faragamco-eng/Multiact/hardware/netlist.md

> ⚠️ **نسخه ۱ (six-step، تک‌شنت) — جایگزین شده با [`hardware/v2`](v2/README.md).**

# نت‌لیست متنی (شماتیک) — BLDC-310

> این فایل شماتیک را به‌صورت متنی و برگه‌به‌برگه توصیف می‌کند تا در KiCad/Altium رسم شود.
> شماره‌پین‌های STM32G431CBT6 (LQFP48) از دیتابیس رسمی ST (`STM32_open_pin_data`) استخراج شده‌اند.
> شماره‌پین‌های IPM عمداً با **نام سیگنال** آمده‌اند. پین‌اوت پکیج SDIP2B-26L را از دیتاشیت همان
> پارت‌نامبری که می‌خرید بردارید (نسخه‌های مختلف SLLIMM/CIPOS پین‌اوت متفاوت دارند).

⚠️ **کل مدار (از جمله MCU) به برق شهر متصل است (Hot ground).** تنها مرز ایزوله، ایزولاتور UART (U9) است.

## قراردادها

| Net | توضیح |
|---|---|
| `AC_L`, `AC_N`, `PE` | ورودی برق شهر |
| `VBUS` | باس DC (حدود 310 V)، بعد از NTC/رله |
| `PGND` | منفی پل دیود و خازن‌های باس (زمین قدرت) |
| `ISH` | امیترهای باز IPM (NU, NV, NW) — بالای شنت |
| `GND` | زمین سیگنال؛ **فقط در یک نقطه** (پد منفی شنت، اتصال Kelvin) به `PGND` وصل می‌شود |
| `+15V`, `+3V3`, `+3V3A` | تغذیه‌ها (همه نسبت به `GND`، یعنی Hot) |
| `ISO_*` | سمت ایزوله ایزولاتور (SELV) |

---

## برگه 1 — ورودی AC، فیلتر EMI، یکسوساز، باس DC

| Ref | Part | Pins → Net | Note |
|---|---|---|---|
| J1 | ترمینال 3 پین 10 A، گام 7.5 mm | 1 `AC_L`, 2 `AC_N`, 3 `PE` | |
| F1 | فیوز 10 A T (Time-lag) 5×20 + هولدر | `AC_L` → `AC_L1` | |
| RV1 | MOV S14K275 | `AC_L1` – `AC_N` | محافظت سرج |
| CX1 | 0.47 µF X2 310 VAC | `AC_L1` – `AC_N` | |
| R1,R2 | 470 k 1206 (سری) | موازی CX1 | تخلیه X-cap (الزام ایمنی) |
| L1 | چوک CM 2×6.8 mH ≥ 8 A | 1-2: `AC_L1`→`AC_LF`, 3-4: `AC_N`→`AC_NF` | |
| CX2 | 0.47 µF X2 | `AC_LF` – `AC_NF` | |
| CY1, CY2 | 2.2 nF Y2 | `AC_LF`–`PE`, `AC_NF`–`PE` | اتصال به بدنه/هیت‌سینک ارت‌شده |
| BR1 | GBU1006 (10 A, 600 V) | ~ `AC_LF`, ~ `AC_NF`, + `DC_RAW`, − `PGND` | روی هیت‌سینک مشترک |
| NTC1 | NTC 5 Ω (مثلاً EPCOS B57364S0509M) | `DC_RAW` – `VBUS` | محدودکننده جریان هجومی؛ برای ~1000 µF در 264 VAC |
| K1 | رله 16 A/250 VAC، کویل 12 V | کنتاکت: `DC_RAW` – `VBUS` (موازی NTC1)؛ کویل: `K1_A`=`+15V` از طریق R3، `K1_B` → Q1 drain | بای‌پس NTC بعد از شارژ باس |
| R3 | 100 Ω 0.5 W | `+15V` – `K1_A` | افت 3 V برای کویل 12 V (30 mA) |
| D1 | 1N4148W | آند `K1_B`، کاتد `K1_A` | دیود هرزگرد کویل |
| Q1 | 2N7002 | G `RELAY_EN`، D `K1_B`، S `GND` | |
| R4 | 100 k | `RELAY_EN` – `GND` | رله خاموش هنگام ریست |
| C1, C2 | 470 µF 450 V 105 °C snap-in (ripple ≥ 3.6 A @100 Hz) | `VBUS` – `PGND` | |
| C3 | 1 µF 630 V فیلم (MKP) | `VBUS` – `PGND` | کنار IPM |
| C4 | 100 nF 630 V فیلم | پین P و N سمت IPM | **کوتاه‌ترین حلقه ممکن** |
| R5, R6 + LED_HV | 100 k 1 W + 100 k 1 W + LED قرمز high-efficiency (سری) | `VBUS` – R5 – R6 – LED – `PGND` | بلیدر + نشانگر «ولتاژ خطرناک» (≈1.6 mA)؛ تا زیر 60 V حدود 6 دقیقه. تا خاموش‌شدن LED برد را لمس نکنید |

## برگه 2 — منبع تغذیه کمکی (غیرایزوله)

| Ref | Part | Pins → Net | Note |
|---|---|---|---|
| RF1 | 10 Ω 1 W flame-proof (fusible) | `VBUS` – `AUX_IN` | |
| CF1, CF2 | 4.7 µF 400 V الکترولیت | `AUX_IN`–`PGND`، `AUX_F`–`PGND` | فیلتر π |
| LF1 | 1 mH 0.3 A | `AUX_IN` – `AUX_F` | |
| U2 | LNK306DN (LinkSwitch-TN، باک) | D `AUX_F`، S `SW`، BP → C5، FB ← تقسیم‌کننده | طبق دیتاشیت/DI برای 15 V، 200 mA |
| C5 | 100 nF | BP – S | |
| D2 | UF1005 (یا ES1J، فوق سریع) | آند `GND`، کاتد `SW` | دیود هرزگرد باک |
| L2 | 1 mH، ≥ 0.4 A | `SW` – `+15V` | |
| R7/R8 | 16.5 k / 2.05 k | `+15V` → FB → `SW` | V_FB = 1.65 V → ≈ 15 V (با DI مرجع PI چک شود) |
| C6 | 100 µF 25 V + 1 µF | `+15V` – `GND` | |
| D3 | SMBJ18A | `+15V` – `GND` | حفاظت اضافه‌ولتاژ |
| R9 | 3.3 k | `+15V` – `GND` | بار حداقل (پایداری LNK در بی‌باری) |
| U3 | باک 3.3 V، مثلاً TPS560430X3F (ورودی 36 V) | VIN `+15V`، SW → L3، FB/OUT `+3V3` | یا LDO با مقاومت سری؛ تلفات LDO مستقیم 0.6 W است |
| L3 | 10 µH 1 A | | |
| C7, C8 | 10 µF + 100 nF | `+3V3` – `GND` | |
| FB1 + C9 | فریت 600 Ω + 1 µF + 100 nF | `+3V3` → `+3V3A` | تغذیه آنالوگ/VREF |

> **نکته مهم:** زمین خروجی منبع کمکی (`GND`) همان زمین Hot است. MCU و IPM به یک زمین مشترک ارجاع دارند و این برای درایو مستقیم (بدون ایزولاتور گیت) ضروری است.

## برگه 3 — طبقه قدرت (IPM)

| Ref | Part | توضیح |
|---|---|---|
| U1 | STGIB15CH60TS-L (SLLIMM 2nd, 600 V / 15 A, SDIP2B-26L) یا هم‌کلاس (IKCM15L60GD، FNB41560) | اینترلاک داخلی، دیود بوت‌استرپ داخلی، Smart shutdown، UVLO |

| پین IPM (نام) | Net | قطعات جانبی |
|---|---|---|
| P | `VBUS` | C4 در فاصله < 10 mm |
| U, V, W | `MOT_U`, `MOT_V`, `MOT_W` → J4 (ترمینال موتور 3 پین + PE) | |
| NU, NV, NW | `ISH` | سه امیتر با ترک پهن به یک نقطه |
| VCC | `+15V` | C10 = 10 µF + C11 = 100 nF نزدیک پین |
| GND (سیگنال) | `GND` | |
| VBOOTU–OUTU | C12 = 4.7 µF X7R 25 V ∥ 100 nF | (همچنین برای V و W: C13, C14) |
| HINU / HINV / HINW | از `PWM_UH`/`PWM_VH`/`PWM_WH` از طریق R 100 Ω | R_pd 10 k به `GND` سمت IPM |
| LINU / LINV / LINW | از `PWM_UL`/`PWM_VL`/`PWM_WL` از طریق R 100 Ω | R_pd 10 k به `GND` (**اگر LIN در دیتاشیت active-low است: pull-up 10 k به 3V3 و `IPM_LIN_ACTIVE_LOW=1` در فریمور**) |
| SD/OD (Fault/Shutdown) | `IPM_FAULT` | R 10 k pull-up به `+3V3`، C 1 nF به `GND` (زمان smart-shutdown طبق دیتاشیت) |
| CIN | `CIN` | R 1 k از `ISH` + C 1 nF به `GND` (τ ≈ 1 µs) |
| T/NTC داخلی (اگر دارد) | DNP یا موازی با NTC هیت‌سینک | |
| OP+, OP−, OPOUT (op-amp داخلی) | OP+ → `GND`، OP− → OPOUT | استفاده نمی‌شود (PGA داخلی STM32 کافی است) |

**شنت:**

| Ref | Part | Pins → Net |
|---|---|---|
| RS1, RS2 | 68 mΩ 2 W 2512 1 % (موازی = 33 mΩ) | `ISH` – `PGND` |
| — | نقطه ستاره | پد منفی شنت = تنها اتصال `GND`↔`PGND` |
| R10 + C15 | 100 Ω + 1 nF C0G | `ISH` (Kelvin) → `ISENSE` → `GND` |
| D4 | BAT54S | `ISENSE` به `+3V3A`/`GND` (کلمپ) |

## برگه 4 — تقسیم‌کننده‌های ولتاژ (VBUS و BEMF)

چهار شاخه **کاملاً یکسان** (نسبت 133.0). هر شاخه:

| Ref | مقدار | اتصال |
|---|---|---|
| Rx_a, Rx_b, Rx_c | 330 k 1 % 1206 (سری، برای ولتاژ کاری و فاصله خزشی) | ورودی HV → `xxx_DIV` |
| Rx_d | 7.5 k 0.1 % 0805 | `xxx_DIV` → `GND` |
| Cx | 220 pF C0G | `xxx_DIV` → `GND` (τ ≈ 1.6 µs) |
| Dx | BAT54S (یک پکیج برای هر دو کانال) | کلمپ به `+3V3A`/`GND` |

| شاخه | ورودی HV | خروجی → پین MCU |
|---|---|---|
| VBUS | `VBUS` | `VBUS_DIV` → PA3 (پین 11) |
| BEMF U | `MOT_U` | `BEMF_U` → PA0 (پین 8) |
| BEMF V | `MOT_V` | `BEMF_V` → PA1 (پین 9) |
| BEMF W | `MOT_W` | `BEMF_W` → PA2 (پین 10) |

**دما و پتانسیومتر:**

| Ref | Part | اتصال |
|---|---|---|
| RT1 | NTC 10 k B3435 (پیچی، روی هیت‌سینک کنار IPM) | `NTC` – `GND` |
| R11 | 10 k 1 % | `+3V3A` – `NTC`؛ C 100 nF به `GND` → PA6 (پین 14) |
| RV2 | پتانسیومتر 10 k **با محور پلاستیکی/عایق** | `+3V3A` / `GND` / سر وسط `POT` + 100 nF → PA5 (پین 13) |

## برگه 5 — میکروکنترلر STM32G431CBT6

| پین | نام | Net | توضیح |
|---|---|---|---|
| 1 | VBAT | `+3V3` | |
| 2 | PC13 | — | آزاد |
| 3, 4 | PC14/PC15 | — | آزاد |
| 5, 6 | PF0/PF1 | — | (اختیاری کریستال 8 MHz، فریمور از HSI استفاده می‌کند) |
| 7 | NRST | `NRST` | 100 nF به GND + پین SWD |
| 8 | PA0 | `BEMF_U` | ADC1_IN1 |
| 9 | PA1 | `BEMF_V` | ADC1_IN2 |
| 10 | PA2 | `BEMF_W` | ADC1_IN3 |
| 11 | PA3 | `VBUS_DIV` | ADC1_IN4 |
| 12 | PA4 | — | آزاد (DAC1_OUT1 برای دیباگ) |
| 13 | PA5 | `POT` | ADC2_IN13 |
| 14 | PA6 | `NTC` | ADC2_IN3 |
| 15 | PA7 | `ISENSE` | OPAMP2_VINP0 و COMP2_INP (هر دو داخلی) |
| 16–18 | PB0–PB2 | — | آزاد |
| 19 | VSSA | `GND` | |
| 20 | VREF+ | `+3V3A` | 1 µF + 100 nF |
| 21 | VDDA | `+3V3A` | 1 µF + 100 nF |
| 22 | PB10 | `RELAY_EN` | GPIO |
| 23 | VSS | `GND` | |
| 24 | VDD | `+3V3` | 100 nF |
| 25 | PB11 | `BTN_START` | GPIO با pull-up داخلی؛ دکمه به GND (کلید با کلاهک عایق) |
| 26 | PB12 | `IPM_FAULT` | TIM1_BKIN (AF6)، از طریق 100 Ω |
| 27 | PB13 | `PWM_UL` | TIM1_CH1N (AF6) |
| 28 | PB14 | `PWM_VL` | TIM1_CH2N (AF6) |
| 29 | PB15 | `PWM_WL` | TIM1_CH3N (**AF4**) |
| 30 | PA8 | `PWM_UH` | TIM1_CH1 (AF6) |
| 31 | PA9 | `PWM_VH` | TIM1_CH2 (AF6) |
| 32 | PA10 | `PWM_WH` | TIM1_CH3 (AF6) |
| 33, 34 | PA11/PA12 | — | آزاد |
| 35 | VSS | `GND` | |
| 36 | VDD | `+3V3` | 100 nF |
| 37 | PA13 | `SWDIO` | |
| 38 | PA14 | `SWCLK` | |
| 39 | PA15 | — | |
| 40 | PB3 | `SWO` | اختیاری |
| 41 | PB4 | `LED_RUN` | 1 k → LED سبز → GND |
| 42 | PB5 | `LED_FAULT` | 1 k → LED قرمز → GND |
| 43 | PB6 | `UART_TX` | USART1_TX (AF7) → U9 |
| 44 | PB7 | `UART_RX` | USART1_RX (AF7) ← U9 |
| 45 | PB8-BOOT0 | `BOOT0` | 10 k به GND |
| 46 | PB9 | — | |
| 47 | VSS | `GND` | |
| 48 | VDD | `+3V3` | 4.7 µF + 100 nF |

هر شش خط گیت: سری 100 Ω نزدیک MCU، pull-down 10 k نزدیک IPM (تا در ریست/بوت IPM خاموش بماند).

## برگه 6 — رابط ایزوله و دیباگ

| Ref | Part | اتصال | توضیح |
|---|---|---|---|
| U9 | ISO7721 (یا ADuM1201) — 2 کانال، 1 رفت/1 برگشت، ایزولاسیون تقویت‌شده | سمت 1: VCC1 `+3V3`، GND1 `GND`، INA ← `UART_TX`، OUTB → `UART_RX`؛ سمت 2: VCC2 `ISO_VCC`، GND2 `ISO_GND`، OUTA → `ISO_TX`، INB ← `ISO_RX` | **فاصله خزشی زیر بدنه ≥ 8 mm** (اسلات در PCB) |
| J2 | هدر 4 پین | `ISO_VCC` (3.3–5 V از مبدل USB-UART)، `ISO_GND`، `ISO_TX`، `ISO_RX` | تنها کانکتور امن برای لمس |
| J3 | هدر SWD 2×5 (1.27) | `+3V3`، `SWDIO`، `SWCLK`، `SWO`، `NRST`، `GND` | **Hot!** فقط با ترانس ایزوله یا دیباگر ایزوله (ISOUSB211 / ST-LINK ایزوله) |

## برگه 7 — ترمز دینامیکی (اختیاری، DNP)

| Ref | Part | اتصال |
|---|---|---|
| Q2 | IGBT 600 V 10 A (مثلاً STGD10NC60KD) | C ← `BRAKE_R`، E → `PGND` |
| R_BR | مقاومت ترمز 100 Ω 100 W (بیرون برد) | `VBUS` – `BRAKE_R` |
| U10 | درایور low-side (مثلاً UCC27517) | ورودی از PB0 (آزاد) |

> فریمور فعلی ترمز ندارد؛ در عوض در کاهش سرعت اگر Vbus > 380 V شود کاهش دیوتی را متوقف می‌کند.
