faragamco-eng/Multiact/hardware/panel/out/drc_report.txt

** Drc report for out/kicad/cooler_panel.kicad_pcb **
** Created on 2026-11-06 15:32:54 **

** Found 145 DRC violations **
[silk_overlap]: Silkscreen overlap
    Rule: board setup constraints silk; Severity: warning
    @(87.0800 mm, 49.0000 mm): Line on F.Silkscreen
    @(103.7300 mm, 49.6400 mm): Reference 'R25'
[silk_overlap]: Silkscreen overlap
    Rule: board setup constraints silk; Severity: warning
    @(87.0800 mm, 49.0000 mm): Line on F.Silkscreen
    @(93.6700 mm, 49.5200 mm): Reference 'R21'
[silk_overlap]: Silkscreen overlap
    Rule: board setup constraints silk; Severity: warning
    @(87.0800 mm, 49.0000 mm): Line on F.Silkscreen
    @(88.4600 mm, 49.6500 mm): Reference 'R26'
[silk_overlap]: Silkscreen overlap
    Rule: board setup constraints silk; Severity: warning
    @(136.8600 mm, 83.2500 mm): Line on F.Silkscreen
    @(136.0000 mm, 84.8700 mm): Reference 'C18'
[silk_overlap]: Silkscreen overlap
    Rule: board setup constraints silk; Severity: warning
    @(136.0000 mm, 84.8700 mm): Reference 'C18'
    @(137.7000 mm, 84.0000 mm): Reference 'U6'
[silk_overlap]: Silkscreen overlap
    Rule: board setup constraints silk; Severity: warning
    @(135.1400 mm, 83.2500 mm): Line on F.Silkscreen
    @(136.0000 mm, 84.8700 mm): Reference 'C18'
[silk_overlap]: Silkscreen overlap
    Rule: board setup constraints silk; Severity: warning
    @(95.0900 mm, 52.0500 mm): Reference 'R22'
    @(93.4327 mm, 51.4725 mm): Line on F.Silkscreen
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
    @(66.4300 mm, 78.8100 mm): Reference 'C7'
[silk_over_copper]: Silkscreen clipped by solder mask
    Local override; Severity: warning
    @(136.0000 mm, 84.8700 mm): Reference 'C18'
[silk_over_copper]: Silkscreen clipped by solder mask
    Local override; Severity: warning
    @(40.3800 mm, 84.4000 mm): Reference 'C1'
[lib_footprint_issues]: The current configuration does not include the library 'Connector_USB'.
    Local override; Severity: warning
    @(70.0000 mm, 102.0000 mm): Footprint J2
[lib_footprint_issues]: The current configuration does not include the library 'Fiducial'.
    Local override; Severity: warning
    @(24.0000 mm, 66.0000 mm): Footprint FID1
[lib_footprint_issues]: The current configuration does not include the library 'Resistor_SMD'.
    Local override; Severity: warning
    @(113.3800 mm, 77.0200 mm): Footprint R40
[lib_footprint_issues]: The current configuration does not include the library 'Package_TO_SOT_SMD'.
    Local override; Severity: warning
    @(30.0000 mm, 84.0000 mm): Footprint Q1
[lib_footprint_issues]: The current configuration does not include the library 'Capacitor_SMD'.
    Local override; Severity: warning
    @(23.7700 mm, 46.7400 mm): Footprint C12
[lib_footprint_issues]: The current configuration does not include the library 'Package_TO_SOT_SMD'.
    Local override; Severity: warning
    @(64.0000 mm, 84.0000 mm): Footprint U3
[lib_footprint_issues]: The current configuration does not include the library 'Resistor_SMD'.
    Local override; Severity: warning
    @(26.2700 mm, 47.0300 mm): Footprint R13
[lib_footprint_issues]: The current configuration does not include the library 'Capacitor_SMD'.
    Local override; Severity: warning
    @(77.6200 mm, 77.1600 mm): Footprint C14
[lib_footprint_issues]: The current configuration does not include the library 'Capacitor_SMD'.
    Local override; Severity: warning
    @(36.7400 mm, 70.2400 mm): Footprint C4
[lib_footprint_issues]: The current configuration does not include the library 'TestPoint'.
    Local override; Severity: warning
    @(44.6400 mm, 64.8300 mm): Footprint TP5
[lib_footprint_issues]: The current configuration does not include the library 'Resistor_SMD'.
    Local override; Severity: warning
    @(56.4200 mm, 90.1700 mm): Footprint R12
[lib_footprint_issues]: The current configuration does not include the library 'Resistor_SMD'.
    Local override; Severity: warning
    @(36.2700 mm, 66.9300 mm): Footprint R8
[lib_footprint_issues]: The current configuration does not include the library 'Resistor_SMD'.
    Local override; Severity: warning
    @(103.7300 mm, 51.0700 mm): Footprint R25
[lib_footprint_issues]: The current configuration does not include the library 'TestPoint'.
    Local override; Severity: warning
    @(49.8700 mm, 93.4300 mm): Footprint TP4
[lib_footprint_issues]: The current configuration does not include the library 'Resistor_SMD'.
    Local override; Severity: warning
    @(84.3600 mm, 45.3400 mm): Footprint R20
[lib_footprint_issues]: The current configuration does not include the library 'Resistor_SMD'.
    Local override; Severity: warning
    @(44.1500 mm, 71.5000 mm): Footprint R7
[lib_footprint_issues]: The current configuration does not include the library 'Sensor_Humidity'.
    Local override; Severity: warning
    @(136.0000 mm, 84.0000 mm): Footprint U6
[lib_footprint_issues]: The current configuration does not include the library 'Resistor_SMD'.
    Local override; Severity: warning
    @(113.1100 mm, 74.3600 mm): Footprint R39
[lib_footprint_issues]: The current configuration does not include the library 'Resistor_SMD'.
    Local override; Severity: warning
    @(43.0600 mm, 76.7900 mm): Footprint R2
[lib_footprint_issues]: The current configuration does not include the library 'Resistor_SMD'.
    Local override; Severity: warning
    @(80.1800 mm, 80.5500 mm): Footprint R35
[lib_footprint_issues]: The current configuration does not include the library 'Resistor_SMD'.
    Local override; Severity: warning
    @(92.0700 mm, 79.7500 mm): Footprint R37
[lib_footprint_issues]: The current configuration does not include the library 'LED_SMD'.
    Local override; Severity: warning
    @(98.0000 mm, 57.0000 mm): Footprint LED2
[lib_footprint_issues]: The current configuration does not include the library 'Resistor_SMD'.
    Local override; Severity: warning
    @(73.8500 mm, 92.1700 mm): Footprint R16
[lib_footprint_issues]: The current configuration does not include the library 'Capacitor_SMD'.
    Local override; Severity: warning
    @(29.8300 mm, 75.6500 mm): Footprint C3
[lib_footprint_issues]: The current configuration does not include the library 'Package_TO_SOT_SMD'.
    Local override; Severity: warning
    @(38.0000 mm, 75.0000 mm): Footprint U1
[lib_footprint_issues]: The current configuration does not include the library 'Diode_SMD'.
    Local override; Severity: warning
    @(42.0000 mm, 91.0000 mm): Footprint BR1
[lib_footprint_issues]: The current configuration does not include the library 'Capacitor_SMD'.
    Local override; Severity: warning
    @(59.7700 mm, 85.5900 mm): Footprint C6
[lib_footprint_issues]: The current configuration does not include the library 'Resistor_SMD'.
    Local override; Severity: warning
    @(70.0300 mm, 89.6000 mm): Footprint R18
[lib_footprint_issues]: The current configuration does not include the library 'Resistor_SMD'.
    Local override; Severity: warning
    @(66.0000 mm, 64.2900 mm): Footprint R30
[lib_footprint_issues]: The current configuration does not include the library 'Package_TO_SOT_SMD'.
    Local override; Severity: warning
    @(70.0000 mm, 94.0000 mm): Footprint U5
[lib_footprint_issues]: The current configuration does not include the library 'Resistor_SMD'.
    Local override; Severity: warning
    @(99.4800 mm, 54.1400 mm): Footprint R24
[lib_footprint_issues]: The current configuration does not include the library 'Resistor_SMD'.
    Local override; Severity: warning
    @(95.0900 mm, 53.4800 mm): Footprint R22
[lib_footprint_issues]: The current configuration does not include the library 'Package_TO_SOT_SMD'.
    Local override; Severity: warning
    @(102.7300 mm, 60.8600 mm): Footprint Q6
[lib_footprint_issues]: The current configuration does not include the library 'Fiducial'.
    Local override; Severity: warning
    @(136.0000 mm, 58.0000 mm): Footprint FID2
[lib_footprint_issues]: The current configuration does not include the library 'Resistor_SMD'.
    Local override; Severity: warning
    @(35.2700 mm, 84.7600 mm): Footprint R11
[lib_footprint_issues]: The current configuration does not include the library 'TestPoint'.
    Local override; Severity: warning
    @(51.6500 mm, 64.9200 mm): Footprint TP8
[lib_footprint_issues]: The current configuration does not include the library 'TerminalBlock_Phoenix'.
    Local override; Severity: warning
    @(32.0000 mm, 100.0000 mm): Footprint J1
[lib_footprint_issues]: The current configuration does not include the library 'Resistor_SMD'.
    Local override; Severity: warning
    @(78.6100 mm, 54.7900 mm): Footprint R28
[lib_footprint_issues]: The current configuration does not include the library 'Diode_SMD'.
    Local override; Severity: warning
    @(43.6000 mm, 98.8400 mm): Footprint D1
[lib_footprint_issues]: The current configuration does not include the library 'Resistor_SMD'.
    Local override; Severity: warning
    @(70.0700 mm, 64.4900 mm): Footprint R31
[lib_footprint_issues]: The current configuration does not include the library 'LED_SMD'.
    Local override; Severity: warning
    @(114.0000 mm, 57.0000 mm): Footprint LED4
[lib_footprint_issues]: The current configuration does not include the library 'Resistor_SMD'.
    Local override; Severity: warning
    @(36.7400 mm, 78.4500 mm): Footprint R4
[lib_footprint_issues]: The current configuration does not include the library 'TestPoint'.
    Local override; Severity: warning
    @(44.4500 mm, 85.5000 mm): Footprint TP1
[lib_footprint_issues]: The current configuration does not include the library 'Button_Switch_THT'.
    Local override; Severity: warning
    @(111.5000 mm, 97.0000 mm): Footprint SW4
[lib_footprint_issues]: The current configuration does not include the library 'Resistor_SMD'.
    Local override; Severity: warning
    @(93.6700 mm, 50.9500 mm): Footprint R21
[lib_footprint_issues]: The current configuration does not include the library 'Button_Switch_THT'.
    Local override; Severity: warning
    @(66.4500 mm, 69.2100 mm): Footprint SW6
[lib_footprint_issues]: The current configuration does not include the library 'Capacitor_SMD'.
    Local override; Severity: warning
    @(80.3400 mm, 77.2100 mm): Footprint C15
[lib_footprint_issues]: The current configuration does not include the library 'LED_SMD'.
    Local override; Severity: warning
    @(90.0000 mm, 57.0000 mm): Footprint LED1
[lib_footprint_issues]: The current configuration does not include the library 'Resistor_SMD'.
    Local override; Severity: warning
    @(40.2900 mm, 82.5600 mm): Footprint R1
[lib_footprint_issues]: The current configuration does not include the library 'Resistor_SMD'.
    Local override; Severity: warning
    @(32.6200 mm, 79.1700 mm): Footprint R5
[lib_footprint_issues]: The current configuration does not include the library 'Diode_SMD'.
    Local override; Severity: warning
    @(61.2800 mm, 77.6100 mm): Footprint D2
[lib_footprint_issues]: The current configuration does not include the library 'Fiducial'.
    Local override; Severity: warning
    @(136.0000 mm, 92.0000 mm): Footprint FID3
[lib_footprint_issues]: The current configuration does not include the library 'Resistor_SMD'.
    Local override; Severity: warning
    @(60.0000 mm, 64.1800 mm): Footprint R14
[lib_footprint_issues]: The current configuration does not include the library 'TestPoint'.
    Local override; Severity: warning
    @(41.0600 mm, 67.9300 mm): Footprint TP6
[lib_footprint_issues]: The current configuration does not include the library 'Resistor_SMD'.
    Local override; Severity: warning
    @(99.2100 mm, 51.2800 mm): Footprint R23
[lib_footprint_issues]: The current configuration does not include the library 'Diode_SMD'.
    Local override; Severity: warning
    @(114.0600 mm, 67.8800 mm): Footprint D4
[lib_footprint_issues]: The current configuration does not include the library 'Capacitor_THT'.
    Local override; Severity: warning
    @(52.6700 mm, 76.3800 mm): Footprint C5
[lib_footprint_issues]: The current configuration does not include the library 'Button_Switch_THT'.
    Local override; Severity: warning
    @(90.5000 mm, 97.0000 mm): Footprint SW2
[lib_footprint_issues]: The current configuration does not include the library 'Fuse'.
    Local override; Severity: warning
    @(48.8500 mm, 100.4700 mm): Footprint F1
[lib_footprint_issues]: The current configuration does not include the library 'Inductor_SMD'.
    Local override; Severity: warning
    @(73.0000 mm, 84.0000 mm): Footprint L1
[lib_footprint_issues]: The current configuration does not include the library 'LED_SMD'.
    Local override; Severity: warning
    @(122.0000 mm, 57.0000 mm): Footprint LED5
[lib_footprint_issues]: The current configuration does not include the library 'MountingHole'.
    Local override; Severity: warning
    @(136.0000 mm, 102.0000 mm): Footprint H4
[lib_footprint_issues]: The current configuration does not include the library 'Button_Switch_THT'.
    Local override; Severity: warning
    @(101.0000 mm, 97.0000 mm): Footprint SW3
[lib_footprint_issues]: The current configuration does not include the library 'Resistor_SMD'.
    Local override; Severity: warning
    @(66.7500 mm, 88.6000 mm): Footprint R17
[lib_footprint_issues]: The current configuration does not include the library 'Package_TO_SOT_SMD'.
    Local override; Severity: warning
    @(52.0000 mm, 84.0000 mm): Footprint U2
[lib_footprint_issues]: The current configuration does not include the library 'Capacitor_SMD'.
    Local override; Severity: warning
    @(92.4000 mm, 76.4800 mm): Footprint C17
[lib_footprint_issues]: The current configuration does not include the library 'Capacitor_SMD'.
    Local override; Severity: warning
    @(42.9500 mm, 79.2700 mm): Footprint C2
[lib_footprint_issues]: The current configuration does not include the library 'Capacitor_SMD'.
    Local override; Severity: warning
    @(88.5500 mm, 78.7400 mm): Footprint C16
[lib_footprint_issues]: The current configuration does not include the library 'Resistor_SMD'.
    Local override; Severity: warning
    @(74.5600 mm, 95.4000 mm): Footprint R15
[lib_footprint_issues]: The current configuration does not include the library 'Capacitor_SMD'.
    Local override; Severity: warning
    @(78.7900 mm, 85.4700 mm): Footprint C8
[lib_footprint_issues]: The current configuration does not include the library 'RF_Module'.
    Local override; Severity: warning
    @(52.0000 mm, 49.0000 mm): Footprint U4
[lib_footprint_issues]: The current configuration does not include the library 'Resistor_SMD'.
    Local override; Severity: warning
    @(40.1700 mm, 71.0700 mm): Footprint R6
[lib_footprint_issues]: The current configuration does not include the library 'TestPoint'.
    Local override; Severity: warning
    @(49.8800 mm, 89.8900 mm): Footprint TP3
[lib_footprint_issues]: The current configuration does not include the library 'LED_SMD'.
    Local override; Severity: warning
    @(106.0000 mm, 57.0000 mm): Footprint LED3
[lib_footprint_issues]: The current configuration does not include the library 'Package_TO_SOT_SMD'.
    Local override; Severity: warning
    @(80.1800 mm, 50.9200 mm): Footprint Q4
[lib_footprint_issues]: The current configuration does not include the library 'Package_TO_SOT_SMD'.
    Local override; Severity: warning
    @(84.0100 mm, 40.8800 mm): Footprint Q3
[lib_footprint_issues]: The current configuration does not include the library 'Resistor_SMD'.
    Local override; Severity: warning
    @(67.4000 mm, 77.7700 mm): Footprint R33
[lib_footprint_issues]: The current configuration does not include the library 'Resistor_SMD'.
    Local override; Severity: warning
    @(25.3200 mm, 84.2600 mm): Footprint R10
[lib_footprint_issues]: The current configuration does not include the library 'Package_TO_SOT_SMD'.
    Local override; Severity: warning
    @(80.1100 mm, 45.9900 mm): Footprint Q2
[lib_footprint_issues]: The current configuration does not include the library 'Button_Switch_THT'.
    Local override; Severity: warning
    @(80.0000 mm, 97.0000 mm): Footprint SW1
[lib_footprint_issues]: The current configuration does not include the library 'Capacitor_SMD'.
    Local override; Severity: warning
    @(66.4300 mm, 80.2400 mm): Footprint C7
[lib_footprint_issues]: The current configuration does not include the library 'MountingHole'.
    Local override; Severity: warning
    @(24.0000 mm, 24.0000 mm): Footprint H1
[lib_footprint_issues]: The current configuration does not include the library 'TestPoint'.
    Local override; Severity: warning
    @(22.5400 mm, 50.7900 mm): Footprint TP9
[lib_footprint_issues]: The current configuration does not include the library 'Resistor_SMD'.
    Local override; Severity: warning
    @(74.4100 mm, 78.7500 mm): Footprint R34
[lib_footprint_issues]: The current configuration does not include the library 'Resistor_SMD'.
    Local override; Severity: warning
    @(42.7100 mm, 74.1800 mm): Footprint R3
[lib_footprint_issues]: The current configuration does not include the library 'Diode_SMD'.
    Local override; Severity: warning
    @(63.3300 mm, 92.9900 mm): Footprint D3
[lib_footprint_issues]: The current configuration does not include the library 'Capacitor_SMD'.
    Local override; Severity: warning
    @(70.6800 mm, 77.7600 mm): Footprint C13
[lib_footprint_issues]: The current configuration does not include the library 'MountingHole'.
    Local override; Severity: warning
    @(24.0000 mm, 102.0000 mm): Footprint H3
[lib_footprint_issues]: The current configuration does not include the library 'Package_TO_SOT_SMD'.
    Local override; Severity: warning
    @(91.5800 mm, 65.7500 mm): Footprint Q7
[lib_footprint_issues]: The current configuration does not include the library 'Button_Switch_THT'.
    Local override; Severity: warning
    @(122.0000 mm, 97.0000 mm): Footprint SW5
[lib_footprint_issues]: The current configuration does not include the library 'Package_TO_SOT_SMD'.
    Local override; Severity: warning
    @(85.3900 mm, 55.4600 mm): Footprint Q5
[lib_footprint_issues]: The current configuration does not include the library 'TestPoint'.
    Local override; Severity: warning
    @(63.4400 mm, 87.9500 mm): Footprint TP2
[lib_footprint_issues]: The current configuration does not include the library 'Resistor_SMD'.
    Local override; Severity: warning
    @(32.5700 mm, 74.7200 mm): Footprint R9
[lib_footprint_issues]: The current configuration does not include the library 'TestPoint'.
    Local override; Severity: warning
    @(55.5700 mm, 64.7900 mm): Footprint TP7
[lib_footprint_issues]: The current configuration does not include the library 'Capacitor_SMD'.
    Local override; Severity: warning
    @(25.2700 mm, 37.4600 mm): Footprint C11
[lib_footprint_issues]: The current configuration does not include the library 'Capacitor_SMD'.
    Local override; Severity: warning
    @(136.0000 mm, 86.3000 mm): Footprint C18
[lib_footprint_issues]: The current configuration does not include the library 'LED_SMD'.
    Local override; Severity: warning
    @(130.0000 mm, 57.0000 mm): Footprint LED6
[lib_footprint_issues]: The current configuration does not include the library 'Resistor_SMD'.
    Local override; Severity: warning
    @(78.4800 mm, 60.7000 mm): Footprint R32
[lib_footprint_issues]: The current configuration does not include the library 'Buzzer_Beeper'.
    Local override; Severity: warning
    @(128.0000 mm, 70.0000 mm): Footprint BZ1
[lib_footprint_issues]: The current configuration does not include the library 'MountingHole'.
    Local override; Severity: warning
    @(136.0000 mm, 24.0000 mm): Footprint H2
[lib_footprint_issues]: The current configuration does not include the library 'Capacitor_SMD'.
    Local override; Severity: warning
    @(25.5900 mm, 41.5300 mm): Footprint C9
[lib_footprint_issues]: The current configuration does not include the library 'Resistor_SMD'.
    Local override; Severity: warning
    @(78.2500 mm, 41.4100 mm): Footprint R29
[lib_footprint_issues]: The current configuration does not include the library 'Capacitor_SMD'.
    Local override; Severity: warning
    @(40.3800 mm, 86.0800 mm): Footprint C1
[lib_footprint_issues]: The current configuration does not include the library 'Resistor_SMD'.
    Local override; Severity: warning
    @(85.3200 mm, 79.2500 mm): Footprint R36
[lib_footprint_issues]: The current configuration does not include the library 'Capacitor_SMD'.
    Local override; Severity: warning
    @(25.8800 mm, 51.3900 mm): Footprint C10
[lib_footprint_issues]: The current configuration does not include the library 'Display_7Segment'.
    Local override; Severity: warning
    @(106.0000 mm, 47.0000 mm): Footprint DS1
[lib_footprint_issues]: The current configuration does not include the library 'Resistor_SMD'.
    Local override; Severity: warning
    @(88.4600 mm, 51.0800 mm): Footprint R26
[lib_footprint_issues]: The current configuration does not include the library 'Resistor_SMD'.
    Local override; Severity: warning
    @(73.6900 mm, 65.1200 mm): Footprint R38
[lib_footprint_issues]: The current configuration does not include the library 'Resistor_SMD'.
    Local override; Severity: warning
    @(84.4200 mm, 51.7200 mm): Footprint R27
[silk_edge_clearance]: Silkscreen clipped by board edge
    Rule: board setup constraints silk; Severity: warning
    @(20.0000 mm, 20.0000 mm): Line on Edge.Cuts
    @(24.0000 mm, 19.8000 mm): Reference 'H1'
[silk_edge_clearance]: Silkscreen clipped by board edge
    Rule: board setup constraints silk; Severity: warning
    @(20.0000 mm, 20.0000 mm): Line on Edge.Cuts
    @(136.0000 mm, 19.8000 mm): Reference 'H2'

** Found 0 unconnected pads **

** Found 0 Footprint errors **

** End of Report **
