faragamco-eng/Multiact/hardware/v2/out/drc_report.txt

** Drc report for out/kicad/bldc_cooler_v2.kicad_pcb **
** Created on 2026-11-06 14:38:11 **

** Found 419 DRC violations **
[silk_overlap]: Silkscreen overlap
    Rule: board setup constraints silk; Severity: warning
    @(159.3200 mm, 81.3000 mm): Reference 'R15'
    @(159.2000 mm, 81.2600 mm): Line on F.Silkscreen
[silk_overlap]: Silkscreen overlap
    Rule: board setup constraints silk; Severity: warning
    @(159.3200 mm, 81.3000 mm): Reference 'R15'
    @(159.2000 mm, 81.2600 mm): Line on F.Silkscreen
[silk_overlap]: Silkscreen overlap
    Rule: board setup constraints silk; Severity: warning
    @(112.0000 mm, 106.0000 mm): PCB Text 'BATTERY OPTION (DNP)' on F.Silkscreen
    @(101.4000 mm, 106.7390 mm): Line on F.Silkscreen
[silk_overlap]: Silkscreen overlap
    Rule: board setup constraints silk; Severity: warning
    @(109.0800 mm, 105.7400 mm): Reference 'J9'
    @(112.0000 mm, 106.0000 mm): PCB Text 'BATTERY OPTION (DNP)' on F.Silkscreen
[silk_overlap]: Silkscreen overlap
    Rule: board setup constraints silk; Severity: warning
    @(112.0000 mm, 106.0000 mm): PCB Text 'BATTERY OPTION (DNP)' on F.Silkscreen
    @(119.5600 mm, 105.5800 mm): Line on F.Silkscreen
[silk_overlap]: Silkscreen overlap
    Rule: board setup constraints silk; Severity: warning
    @(112.0000 mm, 106.0000 mm): PCB Text 'BATTERY OPTION (DNP)' on F.Silkscreen
    @(119.5600 mm, 105.5800 mm): Line on F.Silkscreen
[silk_overlap]: Silkscreen overlap
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
[silk_over_copper]: Silkscreen clipped by solder mask
    Local override; Severity: warning
    @(246.9800 mm, 66.3000 mm): Reference 'R99'
[silk_over_copper]: Silkscreen clipped by solder mask
    Local override; Severity: warning
    @(244.7500 mm, 122.6020 mm): Reference 'TP7'
[lib_footprint_issues]: The current configuration does not include the library 'TerminalBlock_Phoenix'.
    Local override; Severity: warning
    @(27.0000 mm, 40.0000 mm): Footprint J1
[lib_footprint_issues]: The current configuration does not include the library 'Fuse'.
    Local override; Severity: warning
    @(45.0000 mm, 28.0000 mm): Footprint F1
[lib_footprint_issues]: The current configuration does not include the library 'Varistor'.
    Local override; Severity: warning
    @(84.2500 mm, 24.4000 mm): Footprint RV1
[lib_footprint_issues]: The current configuration does not include the library 'Varistor'.
    Local override; Severity: warning
    @(84.2500 mm, 38.4000 mm): Footprint RV2
[lib_footprint_issues]: The current configuration does not include the library 'Varistor'.
    Local override; Severity: warning
    @(39.2500 mm, 38.9000 mm): Footprint RV3
[lib_footprint_issues]: The current configuration does not include the library 'Capacitor_THT'.
    Local override; Severity: warning
    @(72.7500 mm, 53.7500 mm): Footprint CX1
[lib_footprint_issues]: The current configuration does not include the library 'Resistor_SMD'.
    Local override; Severity: warning
    @(26.2800 mm, 56.6200 mm): Footprint R1
[lib_footprint_issues]: The current configuration does not include the library 'Resistor_SMD'.
    Local override; Severity: warning
    @(26.2800 mm, 61.6200 mm): Footprint R2
[lib_footprint_issues]: The current configuration does not include the library 'Capacitor_THT'.
    Local override; Severity: warning
    @(72.7500 mm, 63.7500 mm): Footprint CX2
[lib_footprint_issues]: The current configuration does not include the library 'Capacitor_THT'.
    Local override; Severity: warning
    @(55.5000 mm, 50.2500 mm): Footprint CY1
[lib_footprint_issues]: The current configuration does not include the library 'Capacitor_THT'.
    Local override; Severity: warning
    @(73.0000 mm, 81.7500 mm): Footprint CY2
[lib_footprint_issues]: The current configuration does not include the library 'Relay_THT'.
    Local override; Severity: warning
    @(34.0000 mm, 128.0000 mm): Footprint K1
[lib_footprint_issues]: The current configuration does not include the library 'Relay_THT'.
    Local override; Severity: warning
    @(74.0000 mm, 128.0000 mm): Footprint K2
[lib_footprint_issues]: The current configuration does not include the library 'Capacitor_THT'.
    Local override; Severity: warning
    @(26.0000 mm, 87.2500 mm): Footprint PTC1
[lib_footprint_issues]: The current configuration does not include the library 'Diode_THT'.
    Local override; Severity: warning
    @(25.3500 mm, 32.1000 mm): Footprint D1
[lib_footprint_issues]: The current configuration does not include the library 'Diode_THT'.
    Local override; Severity: warning
    @(36.3500 mm, 52.1000 mm): Footprint D2
[lib_footprint_issues]: The current configuration does not include the library 'Diode_THT'.
    Local override; Severity: warning
    @(39.3500 mm, 86.1000 mm): Footprint D3
[lib_footprint_issues]: The current configuration does not include the library 'Capacitor_THT'.
    Local override; Severity: warning
    @(72.7500 mm, 73.2500 mm): Footprint C1
[lib_footprint_issues]: The current configuration does not include the library 'Diode_THT'.
    Local override; Severity: warning
    @(54.8500 mm, 86.1000 mm): Footprint D29
[lib_footprint_issues]: The current configuration does not include the library 'Resistor_SMD'.
    Local override; Severity: warning
    @(26.2800 mm, 66.6200 mm): Footprint R3
[lib_footprint_issues]: The current configuration does not include the library 'Resistor_SMD'.
    Local override; Severity: warning
    @(26.2800 mm, 71.6200 mm): Footprint R4
[lib_footprint_issues]: The current configuration does not include the library 'Resistor_SMD'.
    Local override; Severity: warning
    @(26.2800 mm, 76.6200 mm): Footprint R5
[lib_footprint_issues]: The current configuration does not include the library 'Resistor_SMD'.
    Local override; Severity: warning
    @(39.9800 mm, 22.7300 mm): Footprint R6
[lib_footprint_issues]: The current configuration does not include the library 'Package_TO_SOT_SMD'.
    Local override; Severity: warning
    @(35.9200 mm, 23.7000 mm): Footprint D4
[lib_footprint_issues]: The current configuration does not include the library 'Capacitor_SMD'.
    Local override; Severity: warning
    @(39.9800 mm, 25.2300 mm): Footprint C2
[lib_footprint_issues]: The current configuration does not include the library 'Resistor_SMD'.
    Local override; Severity: warning
    @(30.9800 mm, 26.7300 mm): Footprint R11
[lib_footprint_issues]: The current configuration does not include the library 'Resistor_SMD'.
    Local override; Severity: warning
    @(87.2800 mm, 80.1200 mm): Footprint R7
[lib_footprint_issues]: The current configuration does not include the library 'Resistor_SMD'.
    Local override; Severity: warning
    @(87.2800 mm, 85.1200 mm): Footprint R8
[lib_footprint_issues]: The current configuration does not include the library 'Resistor_SMD'.
    Local override; Severity: warning
    @(71.2800 mm, 88.1200 mm): Footprint R9
[lib_footprint_issues]: The current configuration does not include the library 'Resistor_SMD'.
    Local override; Severity: warning
    @(34.9800 mm, 26.7300 mm): Footprint R10
[lib_footprint_issues]: The current configuration does not include the library 'Package_TO_SOT_SMD'.
    Local override; Severity: warning
    @(74.9200 mm, 37.2000 mm): Footprint D5
[lib_footprint_issues]: The current configuration does not include the library 'Capacitor_SMD'.
    Local override; Severity: warning
    @(38.9800 mm, 27.7300 mm): Footprint C3
[lib_footprint_issues]: The current configuration does not include the library 'Resistor_SMD'.
    Local override; Severity: warning
    @(39.9800 mm, 30.2300 mm): Footprint R12
[lib_footprint_issues]: The current configuration does not include the library 'Diode_THT'.
    Local override; Severity: warning
    @(40.0000 mm, 193.0000 mm): Footprint BR1
[lib_footprint_issues]: The current configuration does not include the library 'Capacitor_THT'.
    Local override; Severity: warning
    @(98.2500 mm, 80.5000 mm): Footprint C4
[lib_footprint_issues]: The current configuration does not include the library 'Inductor_THT'.
    Local override; Severity: warning
    @(130.0000 mm, 48.0000 mm): Footprint L2
[lib_footprint_issues]: The current configuration does not include the library 'Package_TO_SOT_THT'.
    Local override; Severity: warning
    @(112.0000 mm, 193.0000 mm): Footprint D6
[lib_footprint_issues]: The current configuration does not include the library 'Diode_THT'.
    Local override; Severity: warning
    @(127.3500 mm, 78.8500 mm): Footprint D7
[lib_footprint_issues]: The current configuration does not include the library 'Package_TO_SOT_THT'.
    Local override; Severity: warning
    @(90.0000 mm, 193.0000 mm): Footprint Q1
[lib_footprint_issues]: The current configuration does not include the library 'Resistor_SMD'.
    Local override; Severity: warning
    @(113.9800 mm, 91.7300 mm): Footprint R13
[lib_footprint_issues]: The current configuration does not include the library 'Resistor_SMD'.
    Local override; Severity: warning
    @(117.9800 mm, 91.7300 mm): Footprint R14
[lib_footprint_issues]: The current configuration does not include the library 'Diode_SMD'.
    Local override; Severity: warning
    @(139.8500 mm, 84.1500 mm): Footprint D8
[lib_footprint_issues]: The current configuration does not include the library 'Resistor_SMD'.
    Local override; Severity: warning
    @(159.3200 mm, 83.9200 mm): Footprint R15
[lib_footprint_issues]: The current configuration does not include the library 'Resistor_SMD'.
    Local override; Severity: warning
    @(128.3200 mm, 84.9200 mm): Footprint R16
[lib_footprint_issues]: The current configuration does not include the library 'Package_SO'.
    Local override; Severity: warning
    @(159.2000 mm, 78.7000 mm): Footprint U1
[lib_footprint_issues]: The current configuration does not include the library 'Resistor_SMD'.
    Local override; Severity: warning
    @(148.4800 mm, 92.2300 mm): Footprint R17
[lib_footprint_issues]: The current configuration does not include the library 'Capacitor_THT'.
    Local override; Severity: warning
    @(148.5000 mm, 80.2500 mm): Footprint C5
[lib_footprint_issues]: The current configuration does not include the library 'Capacitor_SMD'.
    Local override; Severity: warning
    @(152.4800 mm, 92.2300 mm): Footprint C6
[lib_footprint_issues]: The current configuration does not include the library 'Resistor_SMD'.
    Local override; Severity: warning
    @(146.2800 mm, 87.6200 mm): Footprint R18
[lib_footprint_issues]: The current configuration does not include the library 'Resistor_SMD'.
    Local override; Severity: warning
    @(98.2800 mm, 88.6200 mm): Footprint R19
[lib_footprint_issues]: The current configuration does not include the library 'Resistor_SMD'.
    Local override; Severity: warning
    @(105.2800 mm, 88.6200 mm): Footprint R20
[lib_footprint_issues]: The current configuration does not include the library 'Resistor_SMD'.
    Local override; Severity: warning
    @(112.2800 mm, 88.6200 mm): Footprint R21
[lib_footprint_issues]: The current configuration does not include the library 'Capacitor_SMD'.
    Local override; Severity: warning
    @(156.4800 mm, 92.2300 mm): Footprint C7
[lib_footprint_issues]: The current configuration does not include the library 'Resistor_SMD'.
    Local override; Severity: warning
    @(119.2800 mm, 88.6200 mm): Footprint R22
[lib_footprint_issues]: The current configuration does not include the library 'Resistor_SMD'.
    Local override; Severity: warning
    @(153.2800 mm, 89.1200 mm): Footprint R23
[lib_footprint_issues]: The current configuration does not include the library 'Resistor_SMD'.
    Local override; Severity: warning
    @(160.2800 mm, 89.1200 mm): Footprint R24
[lib_footprint_issues]: The current configuration does not include the library 'Resistor_SMD'.
    Local override; Severity: warning
    @(136.2800 mm, 89.6200 mm): Footprint R25
[lib_footprint_issues]: The current configuration does not include the library 'Capacitor_SMD'.
    Local override; Severity: warning
    @(160.4800 mm, 92.2300 mm): Footprint C8
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
    Local override; Severity: warning
    @(201.8000 mm, 30.1500 mm): Footprint C19
[lib_footprint_issues]: The current configuration does not include the library 'Capacitor_SMD'.
    Local override; Severity: warning
    @(175.4800 mm, 58.7300 mm): Footprint C20
[lib_footprint_issues]: The current configuration does not include the library 'Inductor_SMD'.
    Local override; Severity: warning
    @(169.5000 mm, 37.2500 mm): Footprint L3
[lib_footprint_issues]: The current configuration does not include the library 'Capacitor_SMD'.
    Local override; Severity: warning
    @(201.8000 mm, 33.1500 mm): Footprint C21
[lib_footprint_issues]: The current configuration does not include the library 'Inductor_SMD'.
    Local override; Severity: warning
    @(202.9800 mm, 58.7300 mm): Footprint FB1
[lib_footprint_issues]: The current configuration does not include the library 'Capacitor_SMD'.
    Local override; Severity: warning
    @(188.9800 mm, 60.7300 mm): Footprint C22
[lib_footprint_issues]: The current configuration does not include the library 'Diode_SMD'.
    Local override; Severity: warning
    @(239.0000 mm, 55.2500 mm): Footprint D19
[lib_footprint_issues]: The current configuration does not include the library 'Capacitor_THT'.
    Local override; Severity: warning
    @(241.5000 mm, 40.2500 mm): Footprint C23
[lib_footprint_issues]: The current configuration does not include the library 'Package_TO_SOT_SMD'.
    Local override; Severity: warning
    @(252.0500 mm, 57.7000 mm): Footprint U4
[lib_footprint_issues]: The current configuration does not include the library 'Capacitor_SMD'.
    Local override; Severity: warning
    @(254.4800 mm, 47.2300 mm): Footprint C24
[lib_footprint_issues]: The current configuration does not include the library 'Diode_SMD'.
    Local override; Severity: warning
    @(231.0000 mm, 55.7500 mm): Footprint D20
[lib_footprint_issues]: The current configuration does not include the library 'Capacitor_THT'.
    Local override; Severity: warning
    @(230.2500 mm, 41.2500 mm): Footprint C25
[lib_footprint_issues]: The current configuration does not include the library 'Package_DIP'.
    Local override; Severity: warning
    @(136.0000 mm, 166.0000 mm): Footprint U5
[lib_footprint_issues]: The current configuration does not include the library 'Package_TO_SOT_THT'.
    Local override; Severity: warning
    @(128.0000 mm, 193.0000 mm): Footprint Q9
[lib_footprint_issues]: The current configuration does not include the library 'Package_TO_SOT_THT'.
    Local override; Severity: warning
    @(145.5000 mm, 193.0000 mm): Footprint Q10
[lib_footprint_issues]: The current configuration does not include the library 'Resistor_SMD'.
    Local override; Severity: warning
    @(154.7800 mm, 173.1200 mm): Footprint R107
[lib_footprint_issues]: The current configuration does not include the library 'Resistor_SMD'.
    Local override; Severity: warning
    @(174.9800 mm, 177.7300 mm): Footprint R108
[lib_footprint_issues]: The current configuration does not include the library 'Resistor_SMD'.
    Local override; Severity: warning
    @(160.7800 mm, 171.6200 mm): Footprint R109
[lib_footprint_issues]: The current configuration does not include the library 'Resistor_SMD'.
    Local override; Severity: warning
    @(142.4800 mm, 162.7300 mm): Footprint R110
[lib_footprint_issues]: The current configuration does not include the library 'Resistor_SMD'.
    Local override; Severity: warning
    @(195.7800 mm, 173.6200 mm): Footprint R119
[lib_footprint_issues]: The current configuration does not include the library 'Diode_THT'.
    Local override; Severity: warning
    @(148.3500 mm, 161.6000 mm): Footprint D26
[lib_footprint_issues]: The current configuration does not include the library 'Capacitor_SMD'.
    Local override; Severity: warning
    @(202.3000 mm, 160.1500 mm): Footprint C28
[lib_footprint_issues]: The current configuration does not include the library 'Capacitor_SMD'.
    Local override; Severity: warning
    @(206.9800 mm, 177.7300 mm): Footprint C29
[lib_footprint_issues]: The current configuration does not include the library 'Capacitor_SMD'.
    Local override; Severity: warning
    @(143.3000 mm, 160.1500 mm): Footprint C63
[lib_footprint_issues]: The current configuration does not include the library 'Capacitor_SMD'.
    Local override; Severity: warning
    @(207.4800 mm, 162.7300 mm): Footprint C64
[lib_footprint_issues]: The current configuration does not include the library 'Package_DIP'.
    Local override; Severity: warning
    @(168.0000 mm, 166.0000 mm): Footprint U12
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
    Local override; Severity: error
    @(254.2500 mm, 37.2500 mm): Pad 1 [+3V3S] of TP8 on F.Cu
    @(253.7050 mm, 47.2300 mm): Pad 1 [+3V3S] of C24 on F.Cu
[unconnected_items]: Missing connection between items
    Local override; Severity: error
    @(244.2050 mm, 54.2300 mm): Pad 1 [+3V3S] of C53 on F.Cu
    @(234.2050 mm, 63.2300 mm): Pad 1 [+3V3S] of C55 on F.Cu
[unconnected_items]: Missing connection between items
    Local override; Severity: error
    @(27.0000 mm, 40.0000 mm): PTH pad 1 [AC_L] of J1
    @(45.0000 mm, 28.0000 mm): PTH pad 1 [AC_L] of F1
[unconnected_items]: Missing connection between items
    Local override; Severity: error
    @(65.0000 mm, 62.0000 mm): PTH pad 2 [AC_LF] of L1
    @(72.7500 mm, 63.7500 mm): PTH pad 1 [AC_LF] of CX2
[unconnected_items]: Missing connection between items
    Local override; Severity: error
    @(55.5000 mm, 50.2500 mm): PTH pad 1 [AC_LF] of CY1
    @(65.0000 mm, 62.0000 mm): PTH pad 2 [AC_LF] of L1
[unconnected_items]: Missing connection between items
    Local override; Severity: error
    @(39.3500 mm, 86.1000 mm): PTH pad 1 [AC_LF] of D3
    @(24.8175 mm, 66.6200 mm): Pad 1 [AC_LF] of R3 on F.Cu
[unconnected_items]: Missing connection between items
    Local override; Severity: error
    @(55.5000 mm, 50.2500 mm): PTH pad 1 [AC_LF] of CY1
    @(35.5100 mm, 32.1000 mm): PTH pad 2 [AC_LF] of D1
[unconnected_items]: Missing connection between items
    Local override; Severity: error
    @(24.8175 mm, 66.6200 mm): Pad 1 [AC_LF] of R3 on F.Cu
    @(55.5000 mm, 50.2500 mm): PTH pad 1 [AC_LF] of CY1
[unconnected_items]: Missing connection between items
    Local override; Severity: error
    @(54.0000 mm, 138.5000 mm): PTH pad 11 [AC_LF] of K1
    @(90.2500 mm, 128.0000 mm): PTH pad 11 [AC_LF] of K2
[unconnected_items]: Missing connection between items
    Local override; Severity: error
    @(54.0000 mm, 138.5000 mm): PTH pad 11 [AC_LF] of K1
    @(39.3500 mm, 86.1000 mm): PTH pad 1 [AC_LF] of D3
[unconnected_items]: Missing connection between items
    Local override; Severity: error
    @(84.2500 mm, 38.4000 mm): PTH pad 1 [AC_LF0] of RV2
    @(84.2500 mm, 24.4000 mm): PTH pad 1 [AC_LF0] of RV1
[unconnected_items]: Missing connection between items
    Local override; Severity: error
    @(24.8175 mm, 56.6200 mm): Pad 1 [AC_LF0] of R1 on F.Cu
    @(40.0000 mm, 62.0000 mm): PTH pad 1 [AC_LF0] of L1
[unconnected_items]: Missing connection between items
    Local override; Severity: error
    @(72.7500 mm, 53.7500 mm): PTH pad 1 [AC_LF0] of CX1
    @(84.2500 mm, 38.4000 mm): PTH pad 1 [AC_LF0] of RV2
[unconnected_items]: Missing connection between items
    Local override; Severity: error
    @(84.2500 mm, 24.4000 mm): PTH pad 1 [AC_LF0] of RV1
    @(55.1600 mm, 28.0000 mm): PTH pad 2 [AC_LF0] of F1
[unconnected_items]: Missing connection between items
    Local override; Severity: error
    @(40.0000 mm, 62.0000 mm): PTH pad 1 [AC_LF0] of L1
    @(72.7500 mm, 53.7500 mm): PTH pad 1 [AC_LF0] of CX1
[unconnected_items]: Missing connection between items
    Local override; Severity: error
    @(39.2500 mm, 38.9000 mm): PTH pad 1 [AC_N] of RV3
    @(27.0000 mm, 45.0800 mm): PTH pad 2 [AC_N] of J1
[unconnected_items]: Missing connection between items
    Local override; Severity: error
    @(27.0000 mm, 45.0800 mm): PTH pad 2 [AC_N] of J1
    @(27.7425 mm, 61.6200 mm): Pad 2 [AC_N] of R2 on F.Cu
[unconnected_items]: Missing connection between items
    Local override; Severity: error
    @(27.7425 mm, 61.6200 mm): Pad 2 [AC_N] of R2 on F.Cu
    @(40.0000 mm, 77.0000 mm): PTH pad 3 [AC_N] of L1
[unconnected_items]: Missing connection between items
    Local override; Severity: error
    @(87.7500 mm, 53.7500 mm): PTH pad 2 [AC_N] of CX1
    @(91.7500 mm, 31.1000 mm): PTH pad 2 [AC_N] of RV1
[unconnected_items]: Missing connection between items
    Local override; Severity: error
    @(87.7500 mm, 53.7500 mm): PTH pad 2 [AC_N] of CX1
    @(39.2500 mm, 38.9000 mm): PTH pad 1 [AC_N] of RV3
[unconnected_items]: Missing connection between items
    Local override; Severity: error
    @(73.0000 mm, 81.7500 mm): PTH pad 1 [AC_NF] of CY2
    @(65.0000 mm, 77.0000 mm): PTH pad 4 [AC_NF] of L1
[unconnected_items]: Missing connection between items
    Local override; Severity: error
    @(263.0000 mm, 106.9200 mm): PTH pad 2 [AC_NF] of J5
    @(263.0000 mm, 96.7600 mm): PTH pad 4 [AC_NF] of J5
[unconnected_items]: Missing connection between items
    Local override; Severity: error
    @(224.7825 mm, 106.4200 mm): Pad 2 [AC_NF] of R86 on F.Cu
    @(235.2825 mm, 106.4200 mm): Pad 2 [AC_NF] of R87 on F.Cu
[unconnected_items]: Missing connection between items
    Local override; Severity: error
    @(85.8175 mm, 80.1200 mm): Pad 1 [AC_NF] of R7 on F.Cu
    @(73.0000 mm, 81.7500 mm): PTH pad 1 [AC_NF] of CY2
[unconnected_items]: Missing connection between items
    Local override; Severity: error
    @(87.7500 mm, 63.7500 mm): PTH pad 2 [AC_NF] of CX2
    @(85.8175 mm, 80.1200 mm): Pad 1 [AC_NF] of R7 on F.Cu
[unconnected_items]: Missing connection between items
    Local override; Severity: error
    @(263.0000 mm, 106.9200 mm): PTH pad 2 [AC_NF] of J5
    @(235.2825 mm, 106.4200 mm): Pad 2 [AC_NF] of R87 on F.Cu
[unconnected_items]: Missing connection between items
    Local override; Severity: error
    @(65.0000 mm, 77.0000 mm): PTH pad 4 [AC_NF] of L1
    @(46.5100 mm, 52.1000 mm): PTH pad 2 [AC_NF] of D2
[unconnected_items]: Missing connection between items
    Local override; Severity: error
    @(50.1600 mm, 193.0000 mm): PTH pad 3 [AC_NF] of BR1
    @(73.0000 mm, 81.7500 mm): PTH pad 1 [AC_NF] of CY2
[unconnected_items]: Missing connection between items
    Local override; Severity: error
    @(85.8175 mm, 80.1200 mm): Pad 1 [AC_NF] of R7 on F.Cu
    @(224.7825 mm, 106.4200 mm): Pad 2 [AC_NF] of R86 on F.Cu
[unconnected_items]: Missing connection between items
    Local override; Severity: error
    @(201.0000 mm, 53.1500 mm): Pad 2 [AUX_HV] of D13 on F.Cu
    @(208.4000 mm, 40.0000 mm): PTH pad 1 [AUX_HV] of T1
[unconnected_items]: Missing connection between items
    Local override; Severity: error
    @(168.7500 mm, 27.2500 mm): PTH pad 1 [AUX_HV] of C14
    @(167.3500 mm, 55.1000 mm): PTH pad 1 [AUX_HV] of D15
[unconnected_items]: Missing connection between items
    Local override; Severity: error
    @(167.3500 mm, 55.1000 mm): PTH pad 1 [AUX_HV] of D15
    @(201.0000 mm, 53.1500 mm): Pad 2 [AUX_HV] of D13 on F.Cu
[unconnected_items]: Missing connection between items
    Local override; Severity: error
    @(167.3500 mm, 55.1000 mm): PTH pad 1 [AUX_HV] of D15
    @(76.9000 mm, 193.0000 mm): PTH pad 3 [AUX_HV] of Q3
[unconnected_items]: Missing connection between items
    Local override; Severity: error
    @(54.8500 mm, 86.1000 mm): PTH pad 1 [AUX_RAW] of D29
    @(72.7500 mm, 73.2500 mm): PTH pad 1 [AUX_RAW] of C1
[unconnected_items]: Missing connection between items
    Local override; Severity: error
    @(25.3500 mm, 32.1000 mm): PTH pad 1 [AUX_RAW] of D1
    @(36.3500 mm, 52.1000 mm): PTH pad 1 [AUX_RAW] of D2
[unconnected_items]: Missing connection between items
    Local override; Severity: error
    @(36.3500 mm, 52.1000 mm): PTH pad 1 [AUX_RAW] of D2
    @(54.8500 mm, 86.1000 mm): PTH pad 1 [AUX_RAW] of D29
[unconnected_items]: Missing connection between items
    Local override; Severity: error
    @(54.8500 mm, 86.1000 mm): PTH pad 1 [AUX_RAW] of D29
    @(71.4500 mm, 193.0000 mm): PTH pad 2 [AUX_RAW] of Q3
[unconnected_items]: Missing connection between items
    Local override; Severity: error
    @(72.7500 mm, 73.2500 mm): PTH pad 1 [AUX_RAW] of C1
    @(182.3175 mm, 55.1200 mm): Pad 1 [AUX_RAW] of R32 on F.Cu
[unconnected_items]: Missing connection between items
    Local override; Severity: error
    @(127.7425 mm, 90.1200 mm): Pad 2 [BLD1] of R29 on F.Cu
    @(141.8175 mm, 92.6200 mm): Pad 1 [BLD1] of R30 on F.Cu
[unconnected_items]: Missing connection between items
    Local override; Severity: error
    @(96.8175 mm, 93.6200 mm): Pad 1 [BLD2] of R31 on F.Cu
    @(144.7425 mm, 92.6200 mm): Pad 2 [BLD2] of R30 on F.Cu
[unconnected_items]: Missing connection between items
    Local override; Severity: error
    @(99.7425 mm, 93.6200 mm): Pad 2 [BLD3] of R31 on F.Cu
    @(110.1175 mm, 93.4500 mm): Pad 2 [BLD3] of LED1 on F.Cu
[unconnected_items]: Missing connection between items
    Local override; Severity: error
    @(241.9000 mm, 133.9875 mm): Pad 45 [BOOT0] of U6 on F.Cu
    @(249.6550 mm, 136.7300 mm): Pad 1 [BOOT0] of R72 on F.Cu
[unconnected_items]: Missing connection between items
    Local override; Severity: error
    @(158.5100 mm, 161.6000 mm): PTH pad 2 [BST_U] of D26
    @(197.2425 mm, 173.6200 mm): Pad 2 [BST_U] of R119 on F.Cu
[unconnected_items]: Missing connection between items
    Local override; Severity: error
    @(149.7425 mm, 174.6200 mm): Pad 2 [BST_V] of R120 on F.Cu
    @(158.5100 mm, 167.6000 mm): PTH pad 2 [BST_V] of D27
[unconnected_items]: Missing connection between items
    Local override; Severity: error
    @(156.2425 mm, 176.6200 mm): Pad 2 [BST_W] of R121 on F.Cu
    @(190.5100 mm, 170.6000 mm): PTH pad 2 [BST_W] of D28
[unconnected_items]: Missing connection between items
    Local override; Severity: error
    @(174.7050 mm, 58.7300 mm): Pad 1 [BUCK_BST] of C20 on F.Cu
    @(202.6875 mm, 22.7500 mm): Pad 6 [BUCK_BST] of U3 on F.Cu
[unconnected_items]: Missing connection between items
    Local override; Severity: error
    @(167.4250 mm, 37.2500 mm): Pad 1 [BUCK_SW] of L3 on F.Cu
    @(176.2550 mm, 58.7300 mm): Pad 2 [BUCK_SW] of C20 on F.Cu
[unconnected_items]: Missing connection between items
    Local override; Severity: error
    @(202.6875 mm, 23.7000 mm): Pad 5 [BUCK_SW] of U3 on F.Cu
    @(167.4250 mm, 37.2500 mm): Pad 1 [BUCK_SW] of L3 on F.Cu
[unconnected_items]: Missing connection between items
    Local override; Severity: error
    @(219.7500 mm, 137.2500 mm): PTH pad 1 [DRAIN_L] of C51
    @(247.2500 mm, 128.0000 mm): PTH pad 14 [DRAIN_L] of K4
[unconnected_items]: Missing connection between items
    Local override; Severity: error
    @(247.2500 mm, 128.0000 mm): PTH pad 14 [DRAIN_L] of K4
    @(263.0000 mm, 101.8400 mm): PTH pad 3 [DRAIN_L] of J5
[unconnected_items]: Missing connection between items
    Local override; Severity: error
    @(229.3575 mm, 106.4200 mm): Pad 1 [DRAIN_SN] of R87 on F.Cu
    @(234.7500 mm, 137.2500 mm): PTH pad 2 [DRAIN_SN] of C51
[unconnected_items]: Missing connection between items
    Local override; Severity: error
    @(174.1550 mm, 177.7300 mm): Pad 1 [GH_U] of R108 on F.Cu
    @(156.2425 mm, 173.1200 mm): Pad 2 [GH_U] of R107 on F.Cu
[unconnected_items]: Missing connection between items
    Local override; Severity: error
    @(156.2425 mm, 173.1200 mm): Pad 2 [GH_U] of R107 on F.Cu
    @(128.0000 mm, 193.0000 mm): PTH pad 1 [GH_U] of Q9
[unconnected_items]: Missing connection between items
    Local override; Severity: error
    @(163.2425 mm, 176.1200 mm): Pad 2 [GH_V] of R111 on F.Cu
    @(163.0000 mm, 193.0000 mm): PTH pad 1 [GH_V] of Q11
[unconnected_items]: Missing connection between items
    Local override; Severity: error
    @(211.6550 mm, 177.7300 mm): Pad 1 [GH_V] of R112 on F.Cu
    @(163.2425 mm, 176.1200 mm): Pad 2 [GH_V] of R111 on F.Cu
[unconnected_items]: Missing connection between items
    Local override; Severity: error
    @(182.7425 mm, 176.1200 mm): Pad 2 [GH_W] of R115 on F.Cu
    @(198.0000 mm, 193.0000 mm): PTH pad 1 [GH_W] of Q13
[unconnected_items]: Missing connection between items
    Local override; Severity: error
    @(198.0000 mm, 193.0000 mm): PTH pad 1 [GH_W] of Q13
    @(222.6550 mm, 177.7300 mm): Pad 1 [GH_W] of R116 on F.Cu
[unconnected_items]: Missing connection between items
    Local override; Severity: error
    @(162.2425 mm, 171.6200 mm): Pad 2 [GL_U] of R109 on F.Cu
    @(141.6550 mm, 162.7300 mm): Pad 1 [GL_U] of R110 on F.Cu
[unconnected_items]: Missing connection between items
    Local override; Severity: error
    @(145.5000 mm, 193.0000 mm): PTH pad 1 [GL_U] of Q10
    @(162.2425 mm, 171.6200 mm): Pad 2 [GL_U] of R109 on F.Cu
[unconnected_items]: Missing connection between items
    Local override; Severity: error
    @(180.5000 mm, 193.0000 mm): PTH pad 1 [GL_V] of Q12
    @(162.1550 mm, 164.2300 mm): Pad 1 [GL_V] of R114 on F.Cu
[unconnected_items]: Missing connection between items
    Local override; Severity: error
    @(162.1550 mm, 164.2300 mm): Pad 1 [GL_V] of R114 on F.Cu
    @(127.7425 mm, 174.6200 mm): Pad 2 [GL_V] of R113 on F.Cu
[unconnected_items]: Missing connection between items
    Local override; Severity: error
    @(215.5000 mm, 193.0000 mm): PTH pad 1 [GL_W] of Q14
    @(188.7425 mm, 174.6200 mm): Pad 2 [GL_W] of R117 on F.Cu
[unconnected_items]: Missing connection between items
    Local override; Severity: error
    @(188.7425 mm, 174.6200 mm): Pad 2 [GL_W] of R117 on F.Cu
    @(130.1550 mm, 171.2300 mm): Pad 1 [GL_W] of R118 on F.Cu
[unconnected_items]: Missing connection between items
    Local override; Severity: error
    @(211.3500 mm, 67.3650 mm): Pad 4 [GND] of U7 on F.Cu
    @(211.3500 mm, 66.0950 mm): Pad 3 [GND] of U7 on F.Cu
[unconnected_items]: Missing connection between items
    Local override; Severity: error
    @(239.6000 mm, 120.6900 mm): PTH pad 5 [GND] of J4
    @(239.6000 mm, 119.4200 mm): PTH pad 3 [GND] of J4
[unconnected_items]: Missing connection between items
    Local override; Severity: error
    @(211.3500 mm, 68.6350 mm): Pad 5 [GND] of U7 on F.Cu
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
[unconnected_items]: Missing connection between items
    Local override; Severity: error
    @(235.2500 mm, 41.2500 mm): PTH pad 2 [GND_S] of C25
    @(239.9875 mm, 48.6750 mm): Pad 5 [GND_S] of U8 on F.Cu
[unconnected_items]: Missing connection between items
    Local override; Severity: error
    @(254.2500 mm, 40.7500 mm): Pad 1 [GND_S] of TP9 on F.Cu
    @(245.0000 mm, 40.2500 mm): PTH pad 2 [GND_S] of C23
[unconnected_items]: Missing connection between items
    Local override; Severity: error
    @(255.2550 mm, 47.2300 mm): Pad 2 [GND_S] of C24 on F.Cu
    @(263.0000 mm, 53.8400 mm): PTH pad 3 [GND_S] of J8
[unconnected_items]: Missing connection between items
    Local override; Severity: error
    @(154.8050 mm, 179.2300 mm): Pad 2 [HIN_U] of R40 on F.Cu
    @(157.1550 mm, 179.2300 mm): Pad 1 [HIN_U] of R41 on F.Cu
[unconnected_items]: Missing connection between items
    Local override; Severity: error
    @(136.0000 mm, 166.0000 mm): PTH pad 1 [HIN_U] of U5
    @(154.8050 mm, 179.2300 mm): Pad 2 [HIN_U] of R40 on F.Cu
[unconnected_items]: Missing connection between items
    Local override; Severity: error
    @(184.3050 mm, 179.7300 mm): Pad 2 [HIN_V] of R44 on F.Cu
    @(186.6550 mm, 179.7300 mm): Pad 1 [HIN_V] of R45 on F.Cu
[unconnected_items]: Missing connection between items
    Local override; Severity: error
    @(168.0000 mm, 166.0000 mm): PTH pad 1 [HIN_V] of U12
    @(184.3050 mm, 179.7300 mm): Pad 2 [HIN_V] of R44 on F.Cu
[unconnected_items]: Missing connection between items
    Local override; Severity: error
    @(210.8050 mm, 180.7300 mm): Pad 2 [HIN_W] of R48 on F.Cu
    @(213.1550 mm, 180.7300 mm): Pad 1 [HIN_W] of R49 on F.Cu
[unconnected_items]: Missing connection between items
    Local override; Severity: error
    @(203.0000 mm, 166.0000 mm): PTH pad 1 [HIN_W] of U13
    @(210.8050 mm, 180.7300 mm): Pad 2 [HIN_W] of R48 on F.Cu
[unconnected_items]: Missing connection between items
    Local override; Severity: error
    @(143.6200 mm, 168.5400 mm): PTH pad 7 [HO_U] of U5
    @(153.3175 mm, 173.1200 mm): Pad 1 [HO_U] of R107 on F.Cu
[unconnected_items]: Missing connection between items
    Local override; Severity: error
    @(160.3175 mm, 176.1200 mm): Pad 1 [HO_V] of R111 on F.Cu
    @(175.6200 mm, 168.5400 mm): PTH pad 7 [HO_V] of U12
[unconnected_items]: Missing connection between items
    Local override; Severity: error
    @(179.8175 mm, 176.1200 mm): Pad 1 [HO_W] of R115 on F.Cu
    @(210.6200 mm, 168.5400 mm): PTH pad 7 [HO_W] of U13
[unconnected_items]: Missing connection between items
    Local override; Severity: error
    @(226.8050 mm, 180.7300 mm): Pad 2 [HS_TSW] of R52 on F.Cu
    @(229.2050 mm, 180.7300 mm): Pad 1 [HS_TSW] of C69 on F.Cu
[unconnected_items]: Missing connection between items
    Local override; Severity: error
    @(125.8000 mm, 165.3000 mm): PTH pad 1 [HS_TSW] of J10
    @(165.1550 mm, 181.2300 mm): Pad 1 [HS_TSW] of R53 on F.Cu
[unconnected_items]: Missing connection between items
    Local override; Severity: error
    @(165.1550 mm, 181.2300 mm): Pad 1 [HS_TSW] of R53 on F.Cu
    @(226.8050 mm, 180.7300 mm): Pad 2 [HS_TSW] of R52 on F.Cu
[unconnected_items]: Missing connection between items
    Local override; Severity: error
    @(190.6550 mm, 181.2300 mm): Pad 1 [ISENSE_U] of R60 on F.Cu
    @(194.7050 mm, 181.2300 mm): Pad 1 [ISENSE_U] of C37 on F.Cu
[unconnected_items]: Missing connection between items
    Local override; Severity: error
    @(170.8050 mm, 181.2300 mm): Pad 2 [ISENSE_U] of R57 on F.Cu
    @(190.6550 mm, 181.2300 mm): Pad 1 [ISENSE_U] of R60 on F.Cu
[unconnected_items]: Missing connection between items
    Local override; Severity: error
    @(238.9875 mm, 139.4000 mm): Pad 9 [ISENSE_U] of U6 on F.Cu
    @(250.2500 mm, 121.2500 mm): Pad 1 [ISENSE_U] of TP6 on F.Cu
[unconnected_items]: Missing connection between items
    Local override; Severity: error
    @(194.7050 mm, 181.2300 mm): Pad 1 [ISENSE_U] of C37 on F.Cu
    @(238.9875 mm, 139.4000 mm): Pad 9 [ISENSE_U] of U6 on F.Cu
[unconnected_items]: Missing connection between items
    Local override; Severity: error
    @(153.1550 mm, 181.7300 mm): Pad 1 [ISENSE_V] of R61 on F.Cu
    @(157.2050 mm, 181.7300 mm): Pad 1 [ISENSE_V] of C38 on F.Cu
[unconnected_items]: Missing connection between items
    Local override; Severity: error
    @(157.2050 mm, 181.7300 mm): Pad 1 [ISENSE_V] of C38 on F.Cu
    @(200.3050 mm, 181.2300 mm): Pad 2 [ISENSE_V] of R58 on F.Cu
[unconnected_items]: Missing connection between items
    Local override; Severity: error
    @(200.3050 mm, 181.2300 mm): Pad 2 [ISENSE_V] of R58 on F.Cu
    @(241.4000 mm, 142.3125 mm): Pad 15 [ISENSE_V] of U6 on F.Cu
[unconnected_items]: Missing connection between items
    Local override; Severity: error
    @(177.1550 mm, 181.7300 mm): Pad 1 [ISENSE_W] of R62 on F.Cu
    @(181.2050 mm, 182.2300 mm): Pad 1 [ISENSE_W] of C39 on F.Cu
[unconnected_items]: Missing connection between items
    Local override; Severity: error
    @(162.8050 mm, 181.7300 mm): Pad 2 [ISENSE_W] of R59 on F.Cu
    @(177.1550 mm, 181.7300 mm): Pad 1 [ISENSE_W] of R62 on F.Cu
[unconnected_items]: Missing connection between items
    Local override; Severity: error
    @(181.2050 mm, 182.2300 mm): Pad 1 [ISENSE_W] of C39 on F.Cu
    @(241.9000 mm, 142.3125 mm): Pad 16 [ISENSE_W] of U6 on F.Cu
[unconnected_items]: Missing connection between items
    Local override; Severity: error
    @(247.2425 mm, 121.1200 mm): Pad 2 [K1_A1] of R74 on F.Cu
    @(238.2000 mm, 108.6500 mm): Pad 1 [K1_A1] of D21 on F.Cu
[unconnected_items]: Missing connection between items
    Local override; Severity: error
    @(238.2000 mm, 108.6500 mm): Pad 1 [K1_A1] of D21 on F.Cu
    @(34.0000 mm, 128.0000 mm): PTH pad A1 [K1_A1] of K1
[unconnected_items]: Missing connection between items
    Local override; Severity: error
    @(241.5000 mm, 108.6500 mm): Pad 2 [K1_DRV] of D21 on F.Cu
    @(240.3575 mm, 105.2000 mm): Pad 3 [K1_DRV] of Q4 on F.Cu
[unconnected_items]: Missing connection between items
    Local override; Severity: error
    @(240.3575 mm, 105.2000 mm): Pad 3 [K1_DRV] of Q4 on F.Cu
    @(34.0000 mm, 146.0000 mm): PTH pad A2 [K1_DRV] of K1
[unconnected_items]: Missing connection between items
    Local override; Severity: error
    @(218.6550 mm, 142.7300 mm): Pad 1 [K1_G] of R76 on F.Cu
    @(251.3050 mm, 141.7300 mm): Pad 2 [K1_G] of R75 on F.Cu
[unconnected_items]: Missing connection between items
    Local override; Severity: error
    @(251.3050 mm, 141.7300 mm): Pad 2 [K1_G] of R75 on F.Cu
    @(238.4825 mm, 104.2500 mm): Pad 1 [K1_G] of Q4 on F.Cu
[unconnected_items]: Missing connection between items
    Local override; Severity: error
    @(243.9000 mm, 133.9875 mm): Pad 41 [K1_ON] of U6 on F.Cu
    @(249.6550 mm, 141.7300 mm): Pad 1 [K1_ON] of R75 on F.Cu
[unconnected_items]: Missing connection between items
    Local override; Severity: error
    @(224.3050 mm, 142.7300 mm): Pad 2 [K2_A1] of R77 on F.Cu
    @(243.7000 mm, 108.6500 mm): Pad 1 [K2_A1] of D22 on F.Cu
[unconnected_items]: Missing connection between items
    Local override; Severity: error
    @(74.0000 mm, 128.0000 mm): PTH pad A1 [K2_A1] of K2
    @(224.3050 mm, 142.7300 mm): Pad 2 [K2_A1] of R77 on F.Cu
[unconnected_items]: Missing connection between items
    Local override; Severity: error
    @(247.0000 mm, 108.6500 mm): Pad 2 [K2_DRV] of D22 on F.Cu
    @(244.8575 mm, 105.2000 mm): Pad 3 [K2_DRV] of Q5 on F.Cu
[unconnected_items]: Missing connection between items
    Local override; Severity: error
    @(244.8575 mm, 105.2000 mm): Pad 3 [K2_DRV] of Q5 on F.Cu
    @(70.2500 mm, 128.0000 mm): PTH pad A2 [K2_DRV] of K2
[unconnected_items]: Missing connection between items
    Local override; Severity: error
    @(228.3050 mm, 142.7300 mm): Pad 2 [K2_G] of R78 on F.Cu
    @(230.6550 mm, 142.7300 mm): Pad 1 [K2_G] of R79 on F.Cu
[unconnected_items]: Missing connection between items
    Local override; Severity: error
    @(230.6550 mm, 142.7300 mm): Pad 1 [K2_G] of R79 on F.Cu
    @(242.9825 mm, 104.2500 mm): Pad 1 [K2_G] of Q5 on F.Cu
[unconnected_items]: Missing connection between items
    Local override; Severity: error
    @(226.6550 mm, 142.7300 mm): Pad 1 [K2_ON] of R78 on F.Cu
    @(243.4000 mm, 133.9875 mm): Pad 42 [K2_ON] of U6 on F.Cu
[unconnected_items]: Missing connection between items
    Local override; Severity: error
    @(244.2000 mm, 118.1500 mm): Pad 1 [K3_A1] of D23 on F.Cu
    @(226.0000 mm, 112.0000 mm): PTH pad A1 [K3_A1] of K3
[unconnected_items]: Missing connection between items
    Local override; Severity: error
    @(236.3050 mm, 142.7300 mm): Pad 2 [K3_A1] of R80 on F.Cu
    @(244.2000 mm, 118.1500 mm): Pad 1 [K3_A1] of D23 on F.Cu
[unconnected_items]: Missing connection between items
    Local override; Severity: error
    @(247.5000 mm, 118.1500 mm): Pad 2 [K3_DRV] of D23 on F.Cu
    @(249.3575 mm, 105.2000 mm): Pad 3 [K3_DRV] of Q6 on F.Cu
[unconnected_items]: Missing connection between items
    Local override; Severity: error
    @(222.2500 mm, 112.0000 mm): PTH pad A2 [K3_DRV] of K3
    @(247.5000 mm, 118.1500 mm): Pad 2 [K3_DRV] of D23 on F.Cu
[unconnected_items]: Missing connection between items
    Local override; Severity: error
    @(238.6550 mm, 144.7300 mm): Pad 1 [K3_G] of R82 on F.Cu
    @(251.3050 mm, 144.2300 mm): Pad 2 [K3_G] of R81 on F.Cu
[unconnected_items]: Missing connection between items
    Local override; Severity: error
    @(251.3050 mm, 144.2300 mm): Pad 2 [K3_G] of R81 on F.Cu
    @(247.4825 mm, 104.2500 mm): Pad 1 [K3_G] of Q6 on F.Cu
[unconnected_items]: Missing connection between items
    Local override; Severity: error
    @(244.9000 mm, 142.3125 mm): Pad 22 [K3_ON] of U6 on F.Cu
    @(249.6550 mm, 144.2300 mm): Pad 1 [K3_ON] of R81 on F.Cu
[unconnected_items]: Missing connection between items
    Local override; Severity: error
    @(226.0000 mm, 128.0000 mm): PTH pad A1 [K4_A1] of K4
    @(244.3050 mm, 144.7300 mm): Pad 2 [K4_A1] of R83 on F.Cu
[unconnected_items]: Missing connection between items
    Local override; Severity: error
    @(249.7000 mm, 118.1500 mm): Pad 1 [K4_A1] of D24 on F.Cu
    @(226.0000 mm, 128.0000 mm): PTH pad A1 [K4_A1] of K4
[unconnected_items]: Missing connection between items
    Local override; Severity: error
    @(253.0000 mm, 118.1500 mm): Pad 2 [K4_DRV] of D24 on F.Cu
    @(252.8575 mm, 109.2000 mm): Pad 3 [K4_DRV] of Q7 on F.Cu
[unconnected_items]: Missing connection between items
    Local override; Severity: error
    @(222.2500 mm, 128.0000 mm): PTH pad A2 [K4_DRV] of K4
    @(253.0000 mm, 118.1500 mm): Pad 2 [K4_DRV] of D24 on F.Cu
[unconnected_items]: Missing connection between items
    Local override; Severity: error
    @(220.3050 mm, 145.2300 mm): Pad 2 [K4_G] of R84 on F.Cu
    @(222.6550 mm, 145.2300 mm): Pad 1 [K4_G] of R85 on F.Cu
[unconnected_items]: Missing connection between items
    Local override; Severity: error
    @(222.6550 mm, 145.2300 mm): Pad 1 [K4_G] of R85 on F.Cu
    @(250.9825 mm, 108.2500 mm): Pad 1 [K4_G] of Q7 on F.Cu
[unconnected_items]: Missing connection between items
    Local override; Severity: error
    @(218.6550 mm, 145.2300 mm): Pad 1 [K4_ON] of R84 on F.Cu
    @(247.3125 mm, 140.9000 mm): Pad 25 [K4_ON] of U6 on F.Cu
[unconnected_items]: Missing connection between items
    Local override; Severity: error
    @(251.3050 mm, 139.2300 mm): Pad 2 [LED2_A] of R73 on F.Cu
    @(252.6175 mm, 115.4500 mm): Pad 2 [LED2_A] of LED2 on F.Cu
[unconnected_items]: Missing connection between items
    Local override; Severity: error
    @(228.1175 mm, 62.4500 mm): Pad 2 [LED3_A] of LED3 on F.Cu
    @(231.8050 mm, 64.7300 mm): Pad 2 [LED3_A] of R88 on F.Cu
[unconnected_items]: Missing connection between items
    Local override; Severity: error
    @(230.1550 mm, 64.7300 mm): Pad 1 [LED_S] of R88 on F.Cu
    @(239.9875 mm, 49.9750 mm): Pad 7 [LED_S] of U8 on F.Cu
[unconnected_items]: Missing connection between items
    Local override; Severity: error
    @(247.3125 mm, 136.4000 mm): Pad 34 [LED_STAT] of U6 on F.Cu
    @(249.6550 mm, 139.2300 mm): Pad 1 [LED_STAT] of R73 on F.Cu
[unconnected_items]: Missing connection between items
    Local override; Severity: error
    @(162.8050 mm, 179.2300 mm): Pad 2 [LIN_U] of R42 on F.Cu
    @(178.6550 mm, 179.2300 mm): Pad 1 [LIN_U] of R43 on F.Cu
[unconnected_items]: Missing connection between items
    Local override; Severity: error
    @(136.0000 mm, 168.5400 mm): PTH pad 2 [LIN_U] of U5
    @(162.8050 mm, 179.2300 mm): Pad 2 [LIN_U] of R42 on F.Cu
[unconnected_items]: Missing connection between items
    Local override; Severity: error
    @(168.0000 mm, 168.5400 mm): PTH pad 2 [LIN_V] of U12
    @(174.8050 mm, 180.7300 mm): Pad 2 [LIN_V] of R46 on F.Cu
[unconnected_items]: Missing connection between items
    Local override; Severity: error
    @(174.8050 mm, 180.7300 mm): Pad 2 [LIN_V] of R46 on F.Cu
    @(205.1550 mm, 180.7300 mm): Pad 1 [LIN_V] of R47 on F.Cu
[unconnected_items]: Missing connection between items
    Local override; Severity: error
    @(218.8050 mm, 180.7300 mm): Pad 2 [LIN_W] of R50 on F.Cu
    @(221.1550 mm, 180.7300 mm): Pad 1 [LIN_W] of R51 on F.Cu
[unconnected_items]: Missing connection between items
    Local override; Severity: error
    @(203.0000 mm, 168.5400 mm): PTH pad 2 [LIN_W] of U13
    @(218.8050 mm, 180.7300 mm): Pad 2 [LIN_W] of R50 on F.Cu
[unconnected_items]: Missing connection between items
    Local override; Severity: error
    @(136.0000 mm, 173.6200 mm): PTH pad 4 [LO_U] of U5
    @(159.3175 mm, 171.6200 mm): Pad 1 [LO_U] of R109 on F.Cu
[unconnected_items]: Missing connection between items
    Local override; Severity: error
    @(124.8175 mm, 174.6200 mm): Pad 1 [LO_V] of R113 on F.Cu
    @(168.0000 mm, 173.6200 mm): PTH pad 4 [LO_V] of U12
[unconnected_items]: Missing connection between items
    Local override; Severity: error
    @(185.8175 mm, 174.6200 mm): Pad 1 [LO_W] of R117 on F.Cu
    @(203.0000 mm, 173.6200 mm): PTH pad 4 [LO_W] of U13
[unconnected_items]: Missing connection between items
    Local override; Severity: error
    @(242.2500 mm, 128.0000 mm): PTH pad 11 [L_LOAD] of K4
    @(242.2500 mm, 112.0000 mm): PTH pad 11 [L_LOAD] of K3
[unconnected_items]: Missing connection between items
    Local override; Severity: error
    @(242.2500 mm, 112.0000 mm): PTH pad 11 [L_LOAD] of K3
    @(234.1600 mm, 96.0000 mm): PTH pad 2 [L_LOAD] of F2
[unconnected_items]: Missing connection between items
    Local override; Severity: error
    @(45.0800 mm, 193.0000 mm): PTH pad 2 [L_SW] of BR1
    @(57.5000 mm, 146.0000 mm): PTH pad 14 [L_SW] of K1
[unconnected_items]: Missing connection between items
    Local override; Severity: error
    @(57.5000 mm, 146.0000 mm): PTH pad 14 [L_SW] of K1
    @(33.5000 mm, 87.2500 mm): PTH pad 2 [L_SW] of PTC1
[unconnected_items]: Missing connection between items
    Local override; Severity: error
    @(57.5000 mm, 146.0000 mm): PTH pad 14 [L_SW] of K1
    @(224.0000 mm, 96.0000 mm): PTH pad 1 [L_SW] of F2
[unconnected_items]: Missing connection between items
    Local override; Severity: error
    @(166.8050 mm, 181.2300 mm): Pad 2 [MCU_BKIN] of R53 on F.Cu
    @(247.3125 mm, 140.4000 mm): Pad 26 [MCU_BKIN] of U6 on F.Cu
[unconnected_items]: Missing connection between items
    Local override; Severity: error
    @(238.9875 mm, 138.4000 mm): Pad 7 [NRST] of U6 on F.Cu
    @(249.7050 mm, 134.2300 mm): Pad 1 [NRST] of C49 on F.Cu
[unconnected_items]: Missing connection between items
    Local override; Severity: error
    @(249.7050 mm, 134.2300 mm): Pad 1 [NRST] of C49 on F.Cu
    @(240.8700 mm, 123.2300 mm): PTH pad 10 [NRST] of J4
[unconnected_items]: Missing connection between items
    Local override; Severity: error
    @(250.3000 mm, 45.4200 mm): PTH pad 4 [NRST_S] of J6
    @(239.9875 mm, 49.3250 mm): Pad 6 [NRST_S] of U8 on F.Cu
[unconnected_items]: Missing connection between items
    Local override; Severity: error
    @(239.9875 mm, 49.3250 mm): Pad 6 [NRST_S] of U8 on F.Cu
    @(250.2050 mm, 64.2300 mm): Pad 1 [NRST_S] of C56 on F.Cu
[unconnected_items]: Missing connection between items
    Local override; Severity: error
    @(208.3050 mm, 183.2300 mm): Pad 2 [NTC_HS] of R71 on F.Cu
    @(210.7050 mm, 183.2300 mm): Pad 1 [NTC_HS] of C42 on F.Cu
[unconnected_items]: Missing connection between items
    Local override; Severity: error
    @(210.7050 mm, 183.2300 mm): Pad 1 [NTC_HS] of C42 on F.Cu
    @(240.9000 mm, 142.3125 mm): Pad 14 [NTC_HS] of U6 on F.Cu
[unconnected_items]: Missing connection between items
    Local override; Severity: error
    @(130.3000 mm, 165.3000 mm): PTH pad 1 [NTC_HS] of J3
    @(208.3050 mm, 183.2300 mm): Pad 2 [NTC_HS] of R71 on F.Cu
[unconnected_items]: Missing connection between items
    Local override; Severity: error
    @(138.9000 mm, 193.0000 mm): PTH pad 3 [OUTU] of Q9
    @(150.9500 mm, 193.0000 mm): PTH pad 2 [OUTU] of Q10
[unconnected_items]: Missing connection between items
    Local override; Severity: error
    @(203.7750 mm, 160.1500 mm): Pad 2 [OUTU] of C28 on F.Cu
    @(207.7550 mm, 177.7300 mm): Pad 2 [OUTU] of C29 on F.Cu
[unconnected_items]: Missing connection between items
    Local override; Severity: error
    @(143.6200 mm, 171.0800 mm): PTH pad 6 [OUTU] of U5
    @(138.9000 mm, 193.0000 mm): PTH pad 3 [OUTU] of Q9
[unconnected_items]: Missing connection between items
    Local override; Severity: error
    @(175.8050 mm, 177.7300 mm): Pad 2 [OUTU] of R108 on F.Cu
    @(150.9500 mm, 193.0000 mm): PTH pad 2 [OUTU] of Q10
[unconnected_items]: Missing connection between items
    Local override; Severity: error
    @(207.7550 mm, 177.7300 mm): Pad 2 [OUTU] of C29 on F.Cu
    @(238.0000 mm, 180.0000 mm): PTH pad 1 [OUTU] of J2
[unconnected_items]: Missing connection between items
    Local override; Severity: error
    @(207.7550 mm, 177.7300 mm): Pad 2 [OUTU] of C29 on F.Cu
    @(175.8050 mm, 177.7300 mm): Pad 2 [OUTU] of R108 on F.Cu
[unconnected_items]: Missing connection between items
    Local override; Severity: error
    @(218.7550 mm, 177.7300 mm): Pad 2 [OUTV] of C31 on F.Cu
    @(213.3050 mm, 177.7300 mm): Pad 2 [OUTV] of R112 on F.Cu
[unconnected_items]: Missing connection between items
    Local override; Severity: error
    @(175.6200 mm, 171.0800 mm): PTH pad 6 [OUTV] of U12
    @(174.7750 mm, 161.1500 mm): Pad 2 [OUTV] of C30 on F.Cu
[unconnected_items]: Missing connection between items
    Local override; Severity: error
    @(173.9000 mm, 193.0000 mm): PTH pad 3 [OUTV] of Q11
    @(185.9500 mm, 193.0000 mm): PTH pad 2 [OUTV] of Q12
[unconnected_items]: Missing connection between items
    Local override; Severity: error
    @(173.9000 mm, 193.0000 mm): PTH pad 3 [OUTV] of Q11
    @(175.6200 mm, 171.0800 mm): PTH pad 6 [OUTV] of U12
[unconnected_items]: Missing connection between items
    Local override; Severity: error
    @(243.0800 mm, 180.0000 mm): PTH pad 2 [OUTV] of J2
    @(218.7550 mm, 177.7300 mm): Pad 2 [OUTV] of C31 on F.Cu
[unconnected_items]: Missing connection between items
    Local override; Severity: error
    @(185.9500 mm, 193.0000 mm): PTH pad 2 [OUTV] of Q12
    @(213.3050 mm, 177.7300 mm): Pad 2 [OUTV] of R112 on F.Cu
[unconnected_items]: Missing connection between items
    Local override; Severity: error
    @(229.7550 mm, 177.7300 mm): Pad 2 [OUTW] of C33 on F.Cu
    @(224.3050 mm, 177.7300 mm): Pad 2 [OUTW] of R116 on F.Cu
[unconnected_items]: Missing connection between items
    Local override; Severity: error
    @(208.9000 mm, 193.0000 mm): PTH pad 3 [OUTW] of Q13
    @(220.9500 mm, 193.0000 mm): PTH pad 2 [OUTW] of Q14
[unconnected_items]: Missing connection between items
    Local override; Severity: error
    @(210.6200 mm, 171.0800 mm): PTH pad 6 [OUTW] of U13
    @(198.2750 mm, 170.1500 mm): Pad 2 [OUTW] of C32 on F.Cu
[unconnected_items]: Missing connection between items
    Local override; Severity: error
    @(224.3050 mm, 177.7300 mm): Pad 2 [OUTW] of R116 on F.Cu
    @(210.6200 mm, 171.0800 mm): PTH pad 6 [OUTW] of U13
[unconnected_items]: Missing connection between items
    Local override; Severity: error
    @(224.3050 mm, 177.7300 mm): Pad 2 [OUTW] of R116 on F.Cu
    @(220.9500 mm, 193.0000 mm): PTH pad 2 [OUTW] of Q14
[unconnected_items]: Missing connection between items
    Local override; Severity: error
    @(229.7550 mm, 177.7300 mm): Pad 2 [OUTW] of C33 on F.Cu
    @(248.1600 mm, 180.0000 mm): PTH pad 3 [OUTW] of J2
[unconnected_items]: Missing connection between items
    Local override; Severity: error
    @(177.5100 mm, 55.1000 mm): PTH pad 2 [P6K_A] of D15
    @(182.8500 mm, 49.6000 mm): PTH pad 1 [P6K_A] of D14
[unconnected_items]: Missing connection between items
    Local override; Severity: error
    @(240.8175 mm, 62.1200 mm): Pad 1 [PANEL_N] of R95 on F.Cu
    @(250.1550 mm, 66.7300 mm): Pad 1 [PANEL_N] of R96 on F.Cu
[unconnected_items]: Missing connection between items
    Local override; Severity: error
    @(250.1550 mm, 66.7300 mm): Pad 1 [PANEL_N] of R96 on F.Cu
    @(253.3000 mm, 52.7500 mm): Pad 2 [PANEL_N] of D25 on F.Cu
[unconnected_items]: Missing connection between items
    Local override; Severity: error
    @(263.0000 mm, 34.9200 mm): PTH pad 2 [PANEL_N] of J7
    @(253.3000 mm, 52.7500 mm): Pad 2 [PANEL_N] of D25 on F.Cu
[unconnected_items]: Missing connection between items
    Local override; Severity: error
    @(248.5875 mm, 57.9500 mm): Pad 2 [PANEL_P] of F3 on F.Cu
    @(249.0000 mm, 52.7500 mm): Pad 1 [PANEL_P] of D25 on F.Cu
[unconnected_items]: Missing connection between items
    Local override; Severity: error
    @(263.0000 mm, 40.0000 mm): PTH pad 1 [PANEL_P] of J7
    @(254.2500 mm, 44.2500 mm): Pad 1 [PANEL_P] of TP10 on F.Cu
[unconnected_items]: Missing connection between items
    Local override; Severity: error
    @(249.0000 mm, 52.7500 mm): Pad 1 [PANEL_P] of D25 on F.Cu
    @(254.2500 mm, 44.2500 mm): Pad 1 [PANEL_P] of TP10 on F.Cu
[unconnected_items]: Missing connection between items
    Local override; Severity: error
    @(238.1550 mm, 67.2300 mm): Pad 1 [PANEL_P] of R97 on F.Cu
    @(248.5875 mm, 57.9500 mm): Pad 2 [PANEL_P] of F3 on F.Cu
[unconnected_items]: Missing connection between items
    Local override; Severity: error
    @(239.8050 mm, 64.7300 mm): Pad 2 [PB_ADJ] of R90 on F.Cu
    @(242.1550 mm, 64.7300 mm): Pad 1 [PB_ADJ] of R91 on F.Cu
[unconnected_items]: Missing connection between items
    Local override; Severity: error
    @(239.8050 mm, 64.7300 mm): Pad 2 [PB_ADJ] of R90 on F.Cu
    @(223.6550 mm, 65.2300 mm): Pad 1 [PB_ADJ] of R92 on F.Cu
[unconnected_items]: Missing connection between items
    Local override; Severity: error
    @(242.1550 mm, 64.7300 mm): Pad 1 [PB_ADJ] of R91 on F.Cu
    @(248.0000 mm, 26.0000 mm): PTH pad 1 [PB_ADJ] of U10
[unconnected_items]: Missing connection between items
    Local override; Severity: error
    @(253.0800 mm, 26.0000 mm): PTH pad 3 [PB_CC] of U10
    @(232.0000 mm, 26.0000 mm): PTH pad 1 [PB_CC] of U9
[unconnected_items]: Missing connection between items
    Local override; Severity: error
    @(253.7425 mm, 61.6200 mm): Pad 2 [PB_CC] of R89 on F.Cu
    @(253.0800 mm, 26.0000 mm): PTH pad 3 [PB_CC] of U10
[unconnected_items]: Missing connection between items
    Local override; Severity: error
    @(234.5400 mm, 26.0000 mm): PTH pad 2 [PB_CCO] of U9
    @(250.8175 mm, 61.6200 mm): Pad 1 [PB_CCO] of R89 on F.Cu
[unconnected_items]: Missing connection between items
    Local override; Severity: error
    @(251.8050 mm, 66.7300 mm): Pad 2 [PB_ISNS] of R96 on F.Cu
    @(245.7125 mm, 51.2750 mm): Pad 12 [PB_ISNS] of U8 on F.Cu
[unconnected_items]: Missing connection between items
    Local override; Severity: error
    @(245.7125 mm, 51.2750 mm): Pad 12 [PB_ISNS] of U8 on F.Cu
    @(227.7050 mm, 67.2300 mm): Pad 1 [PB_ISNS] of C59 on F.Cu
[unconnected_items]: Missing connection between items
    Local override; Severity: error
    @(238.1550 mm, 64.7300 mm): Pad 1 [PB_REG] of R90 on F.Cu
    @(244.3125 mm, 57.9500 mm): Pad 1 [PB_REG] of F3 on F.Cu
[unconnected_items]: Missing connection between items
    Local override; Severity: error
    @(220.8250 mm, 60.1500 mm): Pad 1 [PB_REG] of C58 on F.Cu
    @(238.1550 mm, 64.7300 mm): Pad 1 [PB_REG] of R90 on F.Cu
[unconnected_items]: Missing connection between items
    Local override; Severity: error
    @(244.3125 mm, 57.9500 mm): Pad 1 [PB_REG] of F3 on F.Cu
    @(250.5400 mm, 26.0000 mm): PTH pad 2 [PB_REG] of U10
[unconnected_items]: Missing connection between items
    Local override; Severity: error
    @(245.7125 mm, 51.9250 mm): Pad 11 [PB_TX] of U8 on F.Cu
    @(246.1550 mm, 65.2300 mm): Pad 1 [PB_TX] of R93 on F.Cu
[unconnected_items]: Missing connection between items
    Local override; Severity: error
    @(225.3050 mm, 65.2300 mm): Pad 2 [PB_TXD] of R92 on F.Cu
    @(238.3575 mm, 59.7000 mm): Pad 3 [PB_TXD] of Q8 on F.Cu
[unconnected_items]: Missing connection between items
    Local override; Severity: error
    @(236.4825 mm, 58.7500 mm): Pad 1 [PB_TXG] of Q8 on F.Cu
    @(234.1550 mm, 65.7300 mm): Pad 1 [PB_TXG] of R94 on F.Cu
[unconnected_items]: Missing connection between items
    Local override; Severity: error
    @(247.8050 mm, 65.2300 mm): Pad 2 [PB_TXG] of R93 on F.Cu
    @(236.4825 mm, 58.7500 mm): Pad 1 [PB_TXG] of Q8 on F.Cu
[unconnected_items]: Missing connection between items
    Local override; Severity: error
    @(239.8050 mm, 67.2300 mm): Pad 2 [PB_VSNS] of R97 on F.Cu
    @(242.1550 mm, 67.2300 mm): Pad 1 [PB_VSNS] of R98 on F.Cu
[unconnected_items]: Missing connection between items
    Local override; Severity: error
    @(242.1550 mm, 67.2300 mm): Pad 1 [PB_VSNS] of R98 on F.Cu
    @(245.7125 mm, 50.6250 mm): Pad 13 [PB_VSNS] of U8 on F.Cu
[unconnected_items]: Missing connection between items
    Local override; Severity: error
    @(70.2400 mm, 40.7500 mm): PTH pad 3 [PE] of GDT1
    @(63.0000 mm, 50.2500 mm): PTH pad 2 [PE] of CY1
[unconnected_items]: Missing connection between items
    Local override; Severity: error
    @(27.0000 mm, 50.1600 mm): PTH pad 3 [PE] of J1
    @(63.0000 mm, 50.2500 mm): PTH pad 2 [PE] of CY1
[unconnected_items]: Missing connection between items
    Local override; Severity: error
    @(63.0000 mm, 50.2500 mm): PTH pad 2 [PE] of CY1
    @(80.5000 mm, 81.7500 mm): PTH pad 2 [PE] of CY2
[unconnected_items]: Missing connection between items
    Local override; Severity: error
    @(80.5000 mm, 81.7500 mm): PTH pad 2 [PE] of CY2
    @(253.2400 mm, 180.0000 mm): PTH pad 4 [PE] of J2
[unconnected_items]: Missing connection between items
    Local override; Severity: error
    @(165.3050 mm, 92.2300 mm): Pad 2 [PFC_CS] of R26 on F.Cu
    @(156.7250 mm, 80.6050 mm): Pad 4 [PFC_CS] of U1 on F.Cu
[unconnected_items]: Missing connection between items
    Local override; Severity: error
    @(156.7250 mm, 80.6050 mm): Pad 4 [PFC_CS] of U1 on F.Cu
    @(130.7050 mm, 92.7300 mm): Pad 1 [PFC_CS] of C9 on F.Cu
[unconnected_items]: Missing connection between items
    Local override; Severity: error
    @(161.6750 mm, 78.0650 mm): Pad 7 [PFC_DRV] of U1 on F.Cu
    @(113.1550 mm, 91.7300 mm): Pad 1 [PFC_DRV] of R13 on F.Cu
[unconnected_items]: Missing connection between items
    Local override; Severity: error
    @(252.2500 mm, 104.7500 mm): Pad 1 [PFC_DRV] of TP5 on F.Cu
    @(161.6750 mm, 78.0650 mm): Pad 7 [PFC_DRV] of U1 on F.Cu
[unconnected_items]: Missing connection between items
    Local override; Severity: error
    @(155.7050 mm, 92.2300 mm): Pad 1 [PFC_FB] of C7 on F.Cu
    @(156.7250 mm, 76.7950 mm): Pad 1 [PFC_FB] of U1 on F.Cu
[unconnected_items]: Missing connection between items
    Local override; Severity: error
    @(135.8575 mm, 84.7000 mm): Pad 3 [PFC_FB] of Q2 on F.Cu
    @(155.7050 mm, 92.2300 mm): Pad 1 [PFC_FB] of C7 on F.Cu
[unconnected_items]: Missing connection between items
    Local override; Severity: error
    @(135.8575 mm, 84.7000 mm): Pad 3 [PFC_FB] of Q2 on F.Cu
    @(113.7425 mm, 88.6200 mm): Pad 2 [PFC_FB] of R21 on F.Cu
[unconnected_items]: Missing connection between items
    Local override; Severity: error
    @(96.8175 mm, 88.6200 mm): Pad 1 [PFC_FBD1] of R19 on F.Cu
    @(147.7425 mm, 87.6200 mm): Pad 2 [PFC_FBD1] of R18 on F.Cu
[unconnected_items]: Missing connection between items
    Local override; Severity: error
    @(99.7425 mm, 88.6200 mm): Pad 2 [PFC_FBD2] of R19 on F.Cu
    @(103.8175 mm, 88.6200 mm): Pad 1 [PFC_FBD2] of R20 on F.Cu
[unconnected_items]: Missing connection between items
    Local override; Severity: error
    @(106.7425 mm, 88.6200 mm): Pad 2 [PFC_FBD3] of R20 on F.Cu
    @(110.8175 mm, 88.6200 mm): Pad 1 [PFC_FBD3] of R21 on F.Cu
[unconnected_items]: Missing connection between items
    Local override; Severity: error
    @(114.8050 mm, 91.7300 mm): Pad 2 [PFC_G] of R13 on F.Cu
    @(117.1550 mm, 91.7300 mm): Pad 1 [PFC_G] of R14 on F.Cu
[unconnected_items]: Missing connection between items
    Local override; Severity: error
    @(117.1550 mm, 91.7300 mm): Pad 1 [PFC_G] of R14 on F.Cu
    @(138.2000 mm, 84.1500 mm): Pad 1 [PFC_G] of D8 on F.Cu
[unconnected_items]: Missing connection between items
    Local override; Severity: error
    @(114.8050 mm, 91.7300 mm): Pad 2 [PFC_G] of R13 on F.Cu
    @(90.0000 mm, 193.0000 mm): PTH pad 1 [PFC_G] of Q1
[unconnected_items]: Missing connection between items
    Local override; Severity: error
    @(159.7050 mm, 92.2300 mm): Pad 1 [PFC_IN] of C8 on F.Cu
    @(156.7250 mm, 79.3350 mm): Pad 3 [PFC_IN] of U1 on F.Cu
[unconnected_items]: Missing connection between items
    Local override; Severity: error
    @(156.7250 mm, 79.3350 mm): Pad 3 [PFC_IN] of U1 on F.Cu
    @(137.7425 mm, 89.6200 mm): Pad 2 [PFC_IN] of R25 on F.Cu
[unconnected_items]: Missing connection between items
    Local override; Severity: error
    @(120.7425 mm, 88.6200 mm): Pad 2 [PFC_IND1] of R22 on F.Cu
    @(151.8175 mm, 89.1200 mm): Pad 1 [PFC_IND1] of R23 on F.Cu
[unconnected_items]: Missing connection between items
    Local override; Severity: error
    @(154.7425 mm, 89.1200 mm): Pad 2 [PFC_IND2] of R23 on F.Cu
    @(158.8175 mm, 89.1200 mm): Pad 1 [PFC_IND2] of R24 on F.Cu
[unconnected_items]: Missing connection between items
    Local override; Severity: error
    @(134.8175 mm, 89.6200 mm): Pad 1 [PFC_IND3] of R25 on F.Cu
    @(161.7425 mm, 89.1200 mm): Pad 2 [PFC_IND3] of R24 on F.Cu
[unconnected_items]: Missing connection between items
    Local override; Severity: error
    @(133.9825 mm, 83.7500 mm): Pad 1 [PFC_OFF] of Q2 on F.Cu
    @(125.1550 mm, 93.2300 mm): Pad 1 [PFC_OFF] of R28 on F.Cu
[unconnected_items]: Missing connection between items
    Local override; Severity: error
    @(247.3125 mm, 136.9000 mm): Pad 33 [PFC_OFF] of U6 on F.Cu
    @(133.9825 mm, 83.7500 mm): Pad 1 [PFC_OFF] of Q2 on F.Cu
[unconnected_items]: Missing connection between items
    Local override; Severity: error
    @(120.7500 mm, 80.5000 mm): PTH pad 2 [PFC_RTN] of C4
    @(125.3575 mm, 84.9200 mm): Pad 1 [PFC_RTN] of R16 on F.Cu
[unconnected_items]: Missing connection between items
    Local override; Severity: error
    @(163.6550 mm, 92.2300 mm): Pad 1 [PFC_RTN] of R26 on F.Cu
    @(156.3575 mm, 83.9200 mm): Pad 1 [PFC_RTN] of R15 on F.Cu
[unconnected_items]: Missing connection between items
    Local override; Severity: error
    @(125.3575 mm, 84.9200 mm): Pad 1 [PFC_RTN] of R16 on F.Cu
    @(156.3575 mm, 83.9200 mm): Pad 1 [PFC_RTN] of R15 on F.Cu
[unconnected_items]: Missing connection between items
    Local override; Severity: error
    @(125.3575 mm, 84.9200 mm): Pad 1 [PFC_RTN] of R16 on F.Cu
    @(55.2400 mm, 193.0000 mm): PTH pad 4 [PFC_RTN] of BR1
[unconnected_items]: Missing connection between items
    Local override; Severity: error
    @(149.3050 mm, 92.2300 mm): Pad 2 [PFC_VCC] of R17 on F.Cu
    @(151.7050 mm, 92.2300 mm): Pad 1 [PFC_VCC] of C6 on F.Cu
[unconnected_items]: Missing connection between items
    Local override; Severity: error
    @(148.5000 mm, 80.2500 mm): PTH pad 1 [PFC_VCC] of C5
    @(149.3050 mm, 92.2300 mm): Pad 2 [PFC_VCC] of R17 on F.Cu
[unconnected_items]: Missing connection between items
    Local override; Severity: error
    @(161.6750 mm, 76.7950 mm): Pad 8 [PFC_VCC] of U1 on F.Cu
    @(148.5000 mm, 80.2500 mm): PTH pad 1 [PFC_VCC] of C5
[unconnected_items]: Missing connection between items
    Local override; Severity: error
    @(102.7500 mm, 91.9800 mm): Pad 1 [PFC_VCTRL] of C11 on F.Cu
    @(156.7250 mm, 78.0650 mm): Pad 2 [PFC_VCTRL] of U1 on F.Cu
[unconnected_items]: Missing connection between items
    Local override; Severity: error
    @(121.2050 mm, 93.2300 mm): Pad 1 [PFC_VM] of C10 on F.Cu
    @(134.6550 mm, 92.7300 mm): Pad 1 [PFC_VM] of R27 on F.Cu
[unconnected_items]: Missing connection between items
    Local override; Severity: error
    @(134.6550 mm, 92.7300 mm): Pad 1 [PFC_VM] of R27 on F.Cu
    @(161.6750 mm, 80.6050 mm): Pad 5 [PFC_VM] of U1 on F.Cu
[unconnected_items]: Missing connection between items
    Local override; Severity: error
    @(208.2550 mm, 162.7300 mm): Pad 2 [PGND] of C64 on F.Cu
    @(210.2500 mm, 162.2500 mm): Pad 1 [PGND] of NT1 on F.Cu
[unconnected_items]: Missing connection between items
    Local override; Severity: error
    @(210.2500 mm, 162.2500 mm): Pad 1 [PGND] of NT1 on F.Cu
    @(209.7750 mm, 160.1500 mm): Pad 2 [PGND] of C65 on F.Cu
[unconnected_items]: Missing connection between items
    Local override; Severity: error
    @(131.2825 mm, 84.9200 mm): Pad 2 [PGND] of R16 on F.Cu
    @(133.9825 mm, 85.6500 mm): Pad 2 [PGND] of Q2 on F.Cu
[unconnected_items]: Missing connection between items
    Local override; Severity: error
    @(108.2425 mm, 93.4500 mm): Pad 1 [PGND] of LED1 on F.Cu
    @(104.6500 mm, 91.9800 mm): Pad 2 [PGND] of C11 on F.Cu
[unconnected_items]: Missing connection between items
    Local override; Severity: error
    @(161.2550 mm, 92.2300 mm): Pad 2 [PGND] of C8 on F.Cu
    @(157.2550 mm, 92.2300 mm): Pad 2 [PGND] of C7 on F.Cu
[unconnected_items]: Missing connection between items
    Local override; Severity: error
    @(153.2550 mm, 92.2300 mm): Pad 2 [PGND] of C6 on F.Cu
    @(157.2550 mm, 92.2300 mm): Pad 2 [PGND] of C7 on F.Cu
[unconnected_items]: Missing connection between items
    Local override; Severity: error
    @(168.2550 mm, 58.7300 mm): Pad 2 [PGND] of C18 on F.Cu
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
    @(185.2425 mm, 60.1200 mm): Pad 2 [PRE_G] of R35 on F.Cu
[unconnected_items]: Missing connection between items
    Local override; Severity: error
    @(185.2425 mm, 60.1200 mm): Pad 2 [PRE_G] of R35 on F.Cu
    @(66.0000 mm, 193.0000 mm): PTH pad 1 [PRE_G] of Q3
[unconnected_items]: Missing connection between items
    Local override; Severity: error
    @(26.0000 mm, 87.2500 mm): PTH pad 1 [PRE_L] of PTC1
    @(95.2500 mm, 128.0000 mm): PTH pad 14 [PRE_L] of K2
[unconnected_items]: Missing connection between items
    Local override; Severity: error
    @(263.0000 mm, 112.0000 mm): PTH pad 1 [PUMP_L] of J5
    @(247.2500 mm, 112.0000 mm): PTH pad 14 [PUMP_L] of K3
[unconnected_items]: Missing connection between items
    Local override; Severity: error
    @(247.2500 mm, 112.0000 mm): PTH pad 14 [PUMP_L] of K3
    @(219.7500 mm, 121.2500 mm): PTH pad 1 [PUMP_L] of C50
[unconnected_items]: Missing connection between items
    Local override; Severity: error
    @(218.8575 mm, 106.4200 mm): Pad 1 [PUMP_SN] of R86 on F.Cu
    @(234.7500 mm, 121.2500 mm): PTH pad 2 [PUMP_SN] of C50
[unconnected_items]: Missing connection between items
    Local override; Severity: error
    @(153.1550 mm, 179.2300 mm): Pad 1 [PWM_UH] of R40 on F.Cu
    @(247.3125 mm, 138.4000 mm): Pad 30 [PWM_UH] of U6 on F.Cu
[unconnected_items]: Missing connection between items
    Local override; Severity: error
    @(161.1550 mm, 179.2300 mm): Pad 1 [PWM_UL] of R42 on F.Cu
    @(247.3125 mm, 139.9000 mm): Pad 27 [PWM_UL] of U6 on F.Cu
[unconnected_items]: Missing connection between items
    Local override; Severity: error
    @(182.6550 mm, 179.7300 mm): Pad 1 [PWM_VH] of R44 on F.Cu
    @(247.3125 mm, 137.9000 mm): Pad 31 [PWM_VH] of U6 on F.Cu
[unconnected_items]: Missing connection between items
    Local override; Severity: error
    @(173.1550 mm, 180.7300 mm): Pad 1 [PWM_VL] of R46 on F.Cu
    @(247.3125 mm, 139.4000 mm): Pad 28 [PWM_VL] of U6 on F.Cu
[unconnected_items]: Missing connection between items
    Local override; Severity: error
    @(209.1550 mm, 180.7300 mm): Pad 1 [PWM_WH] of R48 on F.Cu
    @(247.3125 mm, 137.4000 mm): Pad 32 [PWM_WH] of U6 on F.Cu
[unconnected_items]: Missing connection between items
    Local override; Severity: error
    @(217.1550 mm, 180.7300 mm): Pad 1 [PWM_WL] of R50 on F.Cu
    @(247.3125 mm, 138.9000 mm): Pad 29 [PWM_WL] of U6 on F.Cu
[unconnected_items]: Missing connection between items
    Local override; Severity: error
    @(98.2500 mm, 80.5000 mm): PTH pad 1 [RECT_P] of C4
    @(117.8175 mm, 88.6200 mm): Pad 1 [RECT_P] of R22 on F.Cu
[unconnected_items]: Missing connection between items
    Local override; Severity: error
    @(142.5900 mm, 78.8500 mm): PTH pad 2 [RECT_P] of D7
    @(117.8175 mm, 88.6200 mm): Pad 1 [RECT_P] of R22 on F.Cu
[unconnected_items]: Missing connection between items
    Local override; Severity: error
    @(142.5900 mm, 78.8500 mm): PTH pad 2 [RECT_P] of D7
    @(130.0000 mm, 48.0000 mm): PTH pad 1 [RECT_P] of L2
[unconnected_items]: Missing connection between items
    Local override; Severity: error
    @(98.2500 mm, 80.5000 mm): PTH pad 1 [RECT_P] of C4
    @(40.0000 mm, 193.0000 mm): PTH pad 1 [RECT_P] of BR1
[unconnected_items]: Missing connection between items
    Local override; Severity: error
    @(246.1550 mm, 67.7300 mm): Pad 1 [RS485_A] of R99 on F.Cu
    @(263.0000 mm, 64.0000 mm): PTH pad 1 [RS485_A] of J8
[unconnected_items]: Missing connection between items
    Local override; Severity: error
    @(233.6750 mm, 50.8350 mm): Pad 6 [RS485_A] of U11 on F.Cu
    @(246.1550 mm, 67.7300 mm): Pad 1 [RS485_A] of R99 on F.Cu
[unconnected_items]: Missing connection between items
    Local override; Severity: error
    @(247.8000 mm, 62.2500 mm): Pad 2 [RS485_B] of JP1 on F.Cu
    @(263.0000 mm, 58.9200 mm): PTH pad 2 [RS485_B] of J8
[unconnected_items]: Missing connection between items
    Local override; Severity: error
    @(233.6750 mm, 49.5650 mm): Pad 7 [RS485_B] of U11 on F.Cu
    @(247.8000 mm, 62.2500 mm): Pad 2 [RS485_B] of JP1 on F.Cu
[unconnected_items]: Missing connection between items
    Local override; Severity: error
    @(228.7250 mm, 49.5650 mm): Pad 2 [RS485_DE] of U11 on F.Cu
    @(228.7250 mm, 50.8350 mm): Pad 3 [RS485_DE] of U11 on F.Cu
[unconnected_items]: Missing connection between items
    Local override; Severity: error
    @(228.7250 mm, 50.8350 mm): Pad 3 [RS485_DE] of U11 on F.Cu
    @(239.9875 mm, 50.6250 mm): Pad 8 [RS485_DE] of U8 on F.Cu
[unconnected_items]: Missing connection between items
    Local override; Severity: error
    @(228.7250 mm, 52.1050 mm): Pad 4 [RS485_DI] of U11 on F.Cu
    @(239.9875 mm, 51.2750 mm): Pad 9 [RS485_DI] of U8 on F.Cu
[unconnected_items]: Missing connection between items
    Local override; Severity: error
    @(228.7250 mm, 48.2950 mm): Pad 1 [RS485_RO] of U11 on F.Cu
    @(239.9875 mm, 51.9250 mm): Pad 10 [RS485_RO] of U8 on F.Cu
[unconnected_items]: Missing connection between items
    Local override; Severity: error
    @(246.5000 mm, 62.2500 mm): Pad 1 [RS485_T] of JP1 on F.Cu
    @(247.8050 mm, 67.7300 mm): Pad 2 [RS485_T] of R99 on F.Cu
[unconnected_items]: Missing connection between items
    Local override; Severity: error
    @(156.4000 mm, 193.0000 mm): PTH pad 3 [SH_U] of Q10
    @(169.1550 mm, 181.2300 mm): Pad 1 [SH_U] of R57 on F.Cu
[unconnected_items]: Missing connection between items
    Local override; Severity: error
    @(143.3050 mm, 162.7300 mm): Pad 2 [SH_U] of R110 on F.Cu
    @(124.8575 mm, 160.9200 mm): Pad 1 [SH_U] of R54 on F.Cu
[unconnected_items]: Missing connection between items
    Local override; Severity: error
    @(169.1550 mm, 181.2300 mm): Pad 1 [SH_U] of R57 on F.Cu
    @(143.3050 mm, 162.7300 mm): Pad 2 [SH_U] of R110 on F.Cu
[unconnected_items]: Missing connection between items
    Local override; Severity: error
    @(191.4000 mm, 193.0000 mm): PTH pad 3 [SH_V] of Q12
    @(198.6550 mm, 181.2300 mm): Pad 1 [SH_V] of R58 on F.Cu
[unconnected_items]: Missing connection between items
    Local override; Severity: error
    @(163.8050 mm, 164.2300 mm): Pad 2 [SH_V] of R114 on F.Cu
    @(133.3575 mm, 160.9200 mm): Pad 1 [SH_V] of R55 on F.Cu
[unconnected_items]: Missing connection between items
    Local override; Severity: error
    @(198.6550 mm, 181.2300 mm): Pad 1 [SH_V] of R58 on F.Cu
    @(163.8050 mm, 164.2300 mm): Pad 2 [SH_V] of R114 on F.Cu
[unconnected_items]: Missing connection between items
    Local override; Severity: error
    @(161.1550 mm, 181.7300 mm): Pad 1 [SH_W] of R59 on F.Cu
    @(162.3575 mm, 160.9200 mm): Pad 1 [SH_W] of R56 on F.Cu
[unconnected_items]: Missing connection between items
    Local override; Severity: error
    @(131.8050 mm, 171.2300 mm): Pad 2 [SH_W] of R118 on F.Cu
    @(161.1550 mm, 181.7300 mm): Pad 1 [SH_W] of R59 on F.Cu
[unconnected_items]: Missing connection between items
    Local override; Severity: error
    @(161.1550 mm, 181.7300 mm): Pad 1 [SH_W] of R59 on F.Cu
    @(226.4000 mm, 193.0000 mm): PTH pad 3 [SH_W] of Q14
[unconnected_items]: Missing connection between items
    Local override; Severity: error
    @(55.0000 mm, 40.7500 mm): PTH pad 1 [SURGE_PE] of GDT1
    @(46.7500 mm, 45.6000 mm): PTH pad 2 [SURGE_PE] of RV3
[unconnected_items]: Missing connection between items
    Local override; Severity: error
    @(91.7500 mm, 45.1000 mm): PTH pad 2 [SURGE_PE] of RV2
    @(55.0000 mm, 40.7500 mm): PTH pad 1 [SURGE_PE] of GDT1
[unconnected_items]: Missing connection between items
    Local override; Severity: error
    @(240.8700 mm, 119.4200 mm): PTH pad 4 [SWCLK] of J4
    @(245.4000 mm, 133.9875 mm): Pad 38 [SWCLK] of U6 on F.Cu
[unconnected_items]: Missing connection between items
    Local override; Severity: error
    @(245.7125 mm, 46.7250 mm): Pad 19 [SWCLK_S] of U8 on F.Cu
    @(250.3000 mm, 42.8800 mm): PTH pad 3 [SWCLK_S] of J6
[unconnected_items]: Missing connection between items
    Local override; Severity: error
    @(240.8700 mm, 118.1500 mm): PTH pad 2 [SWDIO] of J4
    @(245.9000 mm, 133.9875 mm): Pad 37 [SWDIO] of U6 on F.Cu
[unconnected_items]: Missing connection between items
    Local override; Severity: error
    @(245.7125 mm, 47.3750 mm): Pad 18 [SWDIO_S] of U8 on F.Cu
    @(250.3000 mm, 40.3400 mm): PTH pad 2 [SWDIO_S] of J6
[unconnected_items]: Missing connection between items
    Local override; Severity: error
    @(240.8700 mm, 120.6900 mm): PTH pad 6 [SWO] of J4
    @(244.4000 mm, 133.9875 mm): Pad 40 [SWO] of U6 on F.Cu
[unconnected_items]: Missing connection between items
    Local override; Severity: error
    @(95.4500 mm, 193.0000 mm): PTH pad 2 [SW_PFC] of Q1
    @(117.0800 mm, 193.0000 mm): PTH pad 2 [SW_PFC] of D6
[unconnected_items]: Missing connection between items
    Local override; Severity: error
    @(117.0800 mm, 193.0000 mm): PTH pad 2 [SW_PFC] of D6
    @(130.0000 mm, 69.8000 mm): PTH pad 2 [SW_PFC] of L2
[unconnected_items]: Missing connection between items
    Local override; Severity: error
    @(219.2500 mm, 89.2500 mm): Pad 1 [TP_DAC] of TP1 on F.Cu
    @(238.9875 mm, 140.9000 mm): Pad 12 [TP_DAC] of U6 on F.Cu
[unconnected_items]: Missing connection between items
    Local override; Severity: error
    @(201.5000 mm, 48.2500 mm): Pad 2 [T_H15] of D16 on F.Cu
    @(208.4000 mm, 51.4300 mm): PTH pad 4 [T_H15] of T1
[unconnected_items]: Missing connection between items
    Local override; Severity: error
    @(223.6400 mm, 47.6200 mm): PTH pad 8 [T_S31] of T1
    @(233.0000 mm, 55.7500 mm): Pad 2 [T_S31] of D20 on F.Cu
[unconnected_items]: Missing connection between items
    Local override; Severity: error
    @(223.6400 mm, 51.4300 mm): PTH pad 7 [T_S5] of T1
    @(241.0000 mm, 55.2500 mm): Pad 2 [T_S5] of D19 on F.Cu
[unconnected_items]: Missing connection between items
    Local override; Severity: error
    @(211.3500 mm, 69.9050 mm): Pad 6 [UART_H_RX] of U7 on F.Cu
    @(242.4000 mm, 133.9875 mm): Pad 44 [UART_H_RX] of U6 on F.Cu
[unconnected_items]: Missing connection between items
    Local override; Severity: error
    @(242.9000 mm, 133.9875 mm): Pad 43 [UART_H_TX] of U6 on F.Cu
    @(244.7500 mm, 124.2500 mm): Pad 1 [UART_H_TX] of TP7 on F.Cu
[unconnected_items]: Missing connection between items
    Local override; Severity: error
    @(244.7500 mm, 124.2500 mm): Pad 1 [UART_H_TX] of TP7 on F.Cu
    @(211.3500 mm, 64.8250 mm): Pad 2 [UART_H_TX] of U7 on F.Cu
[unconnected_items]: Missing connection between items
    Local override; Severity: error
    @(220.6500 mm, 64.8250 mm): Pad 15 [UART_S_RX] of U7 on F.Cu
    @(239.9875 mm, 46.0750 mm): Pad 1 [UART_S_RX] of U8 on F.Cu
[unconnected_items]: Missing connection between items
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
[unconnected_items]: Missing connection between items
    Local override; Severity: error
    @(160.0000 mm, 140.0000 mm): PTH pad 1 [VBUS] of C13
    @(180.7500 mm, 163.2500 mm): PTH pad 1 [VBUS] of C40

** Found 0 Footprint errors **

** End of Report **
