faragamco-eng/Multiact/hardware/v2/out/calc_v2.md

# v2 design numbers (generated by calc_v2.py)

### PFC boost (NCP1653, 67 kHz CCM)

| quantity | value | note |
|---|---|---|
| input current rms at 180 VAC, 1.3 kW | 7.6 A | fuse 10 A T, relay 10 A, bridge 10 A |
| peak inductor current (line peak) | 10.8 A | + ripple/2 |
| duty at line peak (180 VAC) | 0.35 |  |
| inductance for 25 % ripple | 491 uH | -> 470 uH, Isat >= 13 A |
| stored energy 1/2 L I^2 | 34 mJ | toroid ~ 46 mm OD |
| PFC shunt 25 mOhm loss | 1.44 W | 2 x 50 mOhm 3 W 2512 in parallel |
| MOSFET rms current | 5.1 A | 95 mOhm @ 100 C (x1.8): 4.4 W conduction |
| bus capacitance | 940 uF / 450 V | 2 x 470 uF 450 V 105 C snap-in in parallel (new) |
| bus 100 Hz ripple at 1.2 kW | 10.4 V p-p |  |
| hold-up 390 -> 300 V at 600 W | 49 ms | rides through 2 mains cycles |
| capacitor ripple current (PFC 100 Hz + inverter) | ~3 A rms total | 2 x >= 2.5 A rating -> margin |
| pre-charge energy in the PTC | 65 J | PTC must be rated >= 80 J |
| bleeder 3 x 100k | 0.51 W | 390 V -> 60 V in 9 min |

### Auxiliary flyback (VIPer26LN, 60 kHz, EF20)

| quantity | value | note |
|---|---|---|
| loads | 6.2 W | 15 V 150 mA (3 x IRS2186, relays, buck 3.3 V) + SELV 5 V 60 mA + SELV 31 V 120 mA |
| design power | 8 W |  |
| input range (after 1500 V pre-regulator) | 200 ... 395 V | 440 VAC neutral loss -> clamped |
| primary inductance | 5.3 mH | DCM, Dmax 0.4 at 200 V |
| peak primary current | 0.25 A | VIPer26 limit ~0.7 A |
| turns P / 15 V hot / 31 V SELV / 5.5 V SELV | 154 / 27 / 55 / 10 | Bmax 0.28 T, Ae 31 mm^2, AL ~225 nH |
| drain stress at 395 V in | 685 V max | with P6KE200 clamp -> < 800 V rating |
| insulation | reinforced | triple-insulated wire on SELV windings, 6.4 mm creepage on bobbin |
| pre-regulator Q3 loss at 440 VAC | 5.5 W | approx (average); on main heatsink |

### Inverter switch losses per device set (1.2 kW, 3.6 A rms, 16 kHz, 390 V, Tj 100 C)

| quantity | value | note |
|---|---|---|
| IRF840 (500 V, 0.85 ohm, trr 460 ns) | 145.1 W | cond 62.8 + sw 3.6 + recovery 78.6 W; NOT suitable: 500 V = 1.28 x margin, recovery losses |
| STW24N60DM2 (600 V, 0.19 ohm, fast diode) | 23.0 W | cond 14.0 + sw 2.4 + recovery 6.6 W; chosen |
| STGW20H60DF IGBT + co-pack diode | 16.1 W | cond 7.8 + sw 3.6 + recovery 4.7 W; alternative (Vce 1.6 V) |

### Phase current sensing (3 x 25 mOhm, offset 0.3 V, OPAMP PGA x4)

| quantity | value | note |
|---|---|---|
| ADC volts per amp | 0.091 V/A |  |
| zero-current ADC level | 1.20 V (1489 counts) |  |
| range | -13.2 ... 23.1 A | negative side covers freewheeling |
| resolution | 8.9 mA/count | simulator used 8 mA |
| shunt loss at 3.6 A rms phase | 0.16 W | low-side conducts ~half the time |

### Panel bus (SELV)

| quantity | value | note |
|---|---|---|
| mark / space voltage | 23.6 V / 15.9 V | LM317: 240 R, 4.3 k, 8.2 k switched |
| short-circuit current | 152 mA | LM317 as current source; PTC 0.1 A hold |
| return sense | 4700 mV/A | 80 mA -> 376 mV, 20 mA signal -> 94 mV (116 counts) |

### Relay coils (12 V coils from +15 V)

| quantity | value | note |
|---|---|---|
| Finder 40.11 12 V (~0.5 W, ~290 ohm) | 68 ohm series | verify coil resistance of the ordered part |
| Finder 34.51 12 V (~0.17 W, ~850 ohm) | 220 ohm series | verify |
