faragamco-eng/Multiact/hardware/v2/out/check_report.txt

parts 289, nets 199
ERRORS 0
WARNINGS 3
  W T1: project-local symbol Custom:FLYBACK_EF20 (lib/)
  W T1: footprint pads without net: ['10', '9']
  W U4: footprint pads without net: ['4']
