faragamco-eng/Multiact/docs/09_panel_and_app.md

# ۹ — پنل، اپ موبایل، سرور سازنده و پروتکل‌های ارتباطی

کد: `firmware/panel/core/` (مستقل از سخت‌افزار، تست‌شده) · `firmware/panel/esp32/` (اسکلت ESP-IDF، **کامپایل‌نشده**)
تست: `make -C firmware/panel test` ⇐ هسته پنل در برابر **همان کد Modbus و به‌روزرسانی درایو** اجرا می‌شود.

## ۹.۱ صفحه پنل: تاچ یا نمایشگر و کلید؟

هسته نرم‌افزار پنل به نوع صفحه وابسته نیست: یک «مدل نمایش» (`ui_view_t`) می‌دهد و کلید/لمس می‌گیرد.
پس تصمیم را می‌شود بعداً گرفت یا هر دو مدل را ساخت.

| معیار | نمایشگر ۷-سگمنت ۲ رقمی + ۶ LED + ۵ کلید | تاچ رنگی 3.5 اینچ (LVGL) |
|---|---|---|
| پردازنده | ESP32-S3-WROOM-1 (همان پردازنده نسخه تاچ) | ESP32-S3 + PSRAM |
| قیمت قطعات تقریبی | کم | حدود ۳ تا ۴ برابر |
| رطوبت و گرد و غبار آشپزخانه/راهرو | مقاوم (کلید ممبرین آب‌بند) | لمس با دست خیس خطا می‌دهد؛ شیشه باید آب‌بند شود |
| مصرف از باس پنل | پایین | نور پس‌زمینه ~0.3 W؛ باید کم‌نور/خاموش شود |
| کار با گوشی | کامل (همه تنظیمات پیشرفته در اپ) | کامل + روی خود پنل |
| پیچیدگی نرم‌افزار | کم | زیاد (LVGL، فونت فارسی، راست‌به‌چپ) |

**پیشنهاد من:** نسخه پایه با **نمایشگر ۴ رقمی + کلید** شروع شود (سخت‌افزار آن طراحی شد: [`hardware/panel/`](../hardware/panel/)).
هر دو نسخه ESP32-S3 دارند، پس فریمور و ابزار ساخت یکی است. برنامه هفتگی، گزارش، گارانتی و تنظیمات
پیشرفته در **اپ موبایل** است، پس پنل لازم نیست همه‌چیز را نشان دهد. نسخه تاچ (ESP32-S3) بعداً با همان
هسته اضافه می‌شود.

### کلیدها و نمایش (نسخه پایه)

| کلید | کوتاه | طولانی (3 s) |
|---|---|---|
| POWER | روشن/خاموش | حالت جفت‌شدن بلوتوث (اتصال گوشی) |
| ▲ / ▼ | دور 1 تا 10 | — |
| MODE | خنک‌کننده ⇐ فقط فن ⇐ فقط پمپ | تأیید و پاک کردن آلارم قفل‌شده |
| TIMER | تایمر خاموشی +1 ساعت (تا 8 ساعت، بعد لغو) | — |

| نمایش | معنی |
|---|---|
| `1`..`10` | دور |
| `P2` | پیش‌خیس کردن پوشال، 2 دقیقه مانده (فن هنوز خاموش) |
| `d4` | خشک کردن پوشال بعد از خاموشی، 4 دقیقه مانده |
| `PU` | فقط پمپ |
| `E4` چشمک‌زن | آلارم (جدول سند ۰۸) |
| `--` چشمک‌زن | ارتباط با درایو قطع است |
| `UP` | در حال به‌روزرسانی فریمور درایو |

LEDها: روشن، پمپ، فن، تایمر، آلارم، وای‌فای.

## ۹.۲ منطق کولر در پنل (تست‌شده)

* **پیش‌خیس:** در حالت خنک‌کننده، اول پمپ 2 دقیقه (قابل تنظیم) و بعد فن. اگر پوشال در 20 دقیقه گذشته
  خیس شده، فن بلافاصله روشن می‌شود.
* **خشک کردن:** خاموشی از حالت خنک‌کننده ⇒ پمپ فوراً قطع، فن با دور 3 به مدت 5 دقیقه، سپس خاموش
  (جلوگیری از بو و کپک پوشال).
* **تایمر خاموشی** و **برنامه هفتگی** (۸ ردیف: روزهای هفته، ساعت روشن/خاموش، حالت، دور).
* **همگام‌سازی:** پنل بعد از روشن شدن، اول وضعیت درایو را می‌خواند و همان را ادامه می‌دهد (اگر درایو بعد
  از برگشت برق خودش روشن شده باشد، پنل آن را خاموش نمی‌کند).
* **خواندن دوره‌ای:** وضعیت هر 1 s (13 رجیستر)، شمارنده‌ها هر 10 s، دفترچه رویداد فقط وقتی تغییر کرده.
  فرمان فقط وقتی با رجیسترهای درایو فرق دارد نوشته می‌شود.

## ۹.۳ لایه‌های ارتباط

```
 گوشی ──BLE (راه‌اندازی وای‌فای، کنترل نزدیک)──┐
 گوشی ──Wi-Fi محلی: WebSocket ws://<پنل>/ws ───┤  JSON یکسان
 گوشی ──اینترنت── سرور MQTT/TLS ───────────────┤
                                               پنل (ESP32)
 پنل ──HTTPS── سرور سازنده: فریمور، گارانتی، گزارش
 پنل ──باس دوسیمه (Modbus RTU، 2400 bps)── PHY ──ISO7762── درایو
```

| مسیر | کاربرد | امنیت |
|---|---|---|
| BLE | اولین راه‌اندازی (نام و رمز وای‌فای)، کنترل وقتی روتر نیست | ESP-IDF provisioning با Security 1 (کلید از **کد ۶ رقمی روی برچسب پنل**) |
| WebSocket محلی | کنترل سریع در خانه بدون اینترنت؛ کشف با mDNS (`_cooler._tcp`) | هر پیام `"token"` دارد؛ توکن 128 بیتی هنگام جفت شدن BLE به گوشی داده می‌شود |
| MQTT روی TLS | کنترل از راه دور، اعلان آلارم | TLS با گواهی سرور؛ برای تولید انبوه **گواهی کلاینت جداگانه برای هر دستگاه** پیشنهاد می‌شود |
| HTTPS به سرور سازنده | فریمور، گارانتی | TLS؛ تصاویر فریمور با Ed25519 امضا شده‌اند |

موضوع‌های MQTT: `cooler/<serial>/cmd` (اپ ⇐ پنل)، `/reply`، `/state` (هر 10 s)، `/event`.

## ۹.۴ پیام‌های JSON (همه مسیرها)

| فرمان | مثال | پاسخ |
|---|---|---|
| وضعیت | `{"cmd":"get"}` | `{"type":"state","online":1,"power":1,"mode":"cool","seq":"run","speed":7,"rpm":315,"power_w":420,"vin":228.4,...}` |
| کنترل | `{"cmd":"set","power":1,"mode":"cool","speed":7}` | `{"ok":1}` (بازه‌ها بررسی می‌شوند) |
| تایمر | `{"cmd":"timer","min":90}` | `{"ok":1}` |
| برنامه هفتگی | `{"cmd":"schedule","i":0,"en":1,"days":127,"on":450,"off":840,"mode":"cool","speed":6}` | `{"ok":1}` (دقیقه از نیمه‌شب؛ بیت 0 = شنبه) |
| آلارم | `{"cmd":"clear_alarm"}` | `{"ok":1}` |
| شناسایی موتور | `{"cmd":"identify"}` | فقط در حالت خاموش |
| دفترچه رویداد | `{"cmd":"log"}` | `{"type":"log","events":[{"code":4,"detail":128,"run_min":600,"vin":228,...}]}` |
| گارانتی | `{"cmd":"warranty","note":"..."}` | گزارش کامل (۹.۶) و ارسال به سرور |
| به‌روزرسانی پنل | `{"cmd":"ota_panel","url":"https://..."}` | — |
| به‌روزرسانی درایو | `{"cmd":"ota_drive","url":"https://..."}` | پیشرفت در `update_pct` |

رویدادها (بدون درخواست): `alarm`، `alarm_cleared`، `drive_offline`، `drive_online`، `timer_off`،
`schedule_on/off`، `log_updated`، `pairing`.

## ۹.۵ به‌روزرسانی نرم‌افزار

* **پنل:** دو پارتیشن OTA با بازگشت خودکار (اگر نسخه جدید بالا نیاید، نسخه قبلی برمی‌گردد).
* **درایو:** پنل تصویر و امضا را دانلود می‌کند ⇐ امضای Ed25519 را با کلید عمومی سازنده بررسی می‌کند ⇐ فن را
  متوقف می‌کند ⇐ تصویر را از باس دوسیمه می‌فرستد (سند ۰۸، بخش ۸.۶) ⇐ نسخه جدید را تأیید می‌کند.
  تست: 30 KB در **2.7 دقیقه**، با ریست درایو و کپی بوت‌لودر.
* **PHY:** با SWD در کارخانه (پل ساده است و به‌ندرت تغییر می‌کند).

پیشنهاد API سرور: `GET /api/v1/firmware/{product}/{hw_rev}/latest` ⇐ `{"version":"2.1","url":...,"sig_url":...,"size":...}`.

## ۹.۶ درخواست گارانتی و گزارش

پنل (یا اپ) این گزارش را می‌سازد و با `POST /api/v1/warranty` به سرور سازنده می‌فرستد. همه‌چیز از خود
درایو خوانده می‌شود، پس کاربر لازم نیست چیزی وارد کند جز توضیح:

```json
{"type":"warranty","drive_serial":4242,"panel_serial":"P-000123","hw_rev":"2.0","drive_fw":"2.0",
 "panel_fw":"1.0.0","run_h":812,"energy_kwh":402.6,"starts":1530,"outages":44,"alarms_seen":16,
 "motor":{"id":0,"r_mohm":1620,"l_10uh":1505,"psi":1570},"note":"فن بعد از ۱۰ دقیقه می‌ایستد",
 "log":[{"code":4,"detail":128,"run_min":600,"vin":228,"vbus":390,"i":3.10,"t":32}, ...]}
```

با این اطلاعات سرویس‌کار قبل از رفتن به محل می‌داند ساعت کار، دفعات قطع برق، آلارم‌ها با ولتاژ و جریان
لحظه وقوع، و مشخصات موتور چیست. گزارش وضعیت هر 10 s روی MQTT است؛ سرور می‌تواند انرژی روزانه و
ساعت کار را برای نمودار در اپ جمع کند.

## ۹.۷ سخت‌افزار پنل (طراحی‌شده)

شماتیک، **برد مسیرکشی‌شده (0 خطای DRC) با فایل‌های Gerber آماده ساخت** و محاسبات: [`hardware/panel/README.md`](../hardware/panel/README.md). خلاصه:
ورودی بی‌تفاوت به پلاریته، **جریان ورودی ثابت 52 mA** (LM317) که خازن 1000 µF را شارژ می‌کند تا پیک‌های
وای‌فای جریان باس را تغییر ندهند، گیرنده با مقایسه‌گر روی ولتاژ باس (آستانه 18.4 V)، فرستنده با سینک
جریان 20 mA، ESP32-S3-WROOM-1، نمایشگر ۴ رقمی و ۶ LED در ۵ فاز مالتی‌پلکس، ۵ کلید، بازر، USB-C برای
برنامه‌ریزی، جای سنسور SHT40.

متن نمایشگر ۴ رقمی (`firmware/panel/core/seg7.c`، تست‌شده):

| نمایش | معنی |
|---|---|
| `CO 7` / `FA10` / `PU` | خنک‌کننده دور 7 / فقط فن دور 10 / فقط پمپ |
| `Pr 2` / `dr 4` | پیش‌خیس 2 دقیقه / خشک کردن 4 دقیقه |
| `E- 4` | آلارم E4 (چشمک‌زن) |
| `----` | ارتباط با درایو قطع |
| `UP45` | به‌روزرسانی درایو، 45 % |
| نقطه رقم دوم | تایمر خاموشی فعال |

## ۹.۸ وضعیت تست‌ها

| بخش | نتیجه |
|---|---|
| هسته پنل (`make -C firmware/panel test`) | **40/40**: نمایشگر ۴ رقمی، همگام‌سازی، پیش‌خیس، خشک کردن، کلیدها، تایمر، حالت‌ها، آلارم، قطع ارتباط، JSON، برنامه هفتگی، دفترچه، گارانتی، به‌روزرسانی درایو |
| فریمور درایو v2 | **573/573** |
| PHY | **11/11** (240 تراکنش در شرایط سخت) |
| ESP32 | **کامپایل نشده**؛ ابزار ESP-IDF در این محیط نبود. آدرس‌های سرور، کلید عمومی، کد جفت‌شدن و پین‌ها placeholder هستند |
