faragamco-eng/Multiact/docs/05_panel_bus_modbus.md

# ۵ — پروتکل باس پنل (Modbus RTU) و نقشه رجیسترها

کد مرجع: `firmware/comm/modbus_slave.[ch]` (slave مستقل از سخت‌افزار) و `firmware/comm/cooler_regs.[ch]`
(نقشه رجیستر + کنترل بازه + تایم‌اوت ارتباط). تست: `make -C firmware test-comm`.
همین هدر `cooler_regs.h` در فریمور پنل (ESP32، با `esp-modbus` به‌عنوان master) استفاده می‌شود.

## ۵.۱ تنظیمات ارتباط

| پارامتر | مقدار |
|---|---|
| لایه فیزیکی | باس دوسیمه ایزوله (بخش ۴.۹): درایو ⇒ پنل با ولتاژ 24/16 V، پنل ⇒ درایو با جریان +20 mA |
| سرعت | 2400 bps، 8N1 (روی کانکتور تست کارخانه 9600 یا 19200) |
| آدرس درایو | 1 (آدرس 0 = broadcast، فقط نوشتن، بدون پاسخ) |
| پایان فریم | سکوت ≥ 3.5 کاراکتر (≈ 16 ms در 2400 bps) |
| توابع | 0x03، 0x04، 0x06، 0x10 |
| چرخه پیشنهادی پنل | هر 500 ms: خواندن IR 2 تا 12؛ نوشتن فقط هنگام تغییر |
| تایم‌اوت | اگر درایو در `HR_COMM_TIMEOUT_S` (پیش‌فرض 60 s) فریم معتبر نگیرد ⇒ فن و پمپ خاموش، آلارم E8 |

## ۵.۲ رجیسترهای Holding (خواندن/نوشتن)

| آدرس | نام | بازه | پیش‌فرض | توضیح |
|---|---|---|---|---|
| 0 | RUN | 0/1 | 0 | روشن/خاموش فن |
| 1 | SPEED_PERMILLE | 0–1000 | 500 | سرعت بر حسب 0.1 % از حداکثر. پنل ۱۰ پله را به 100…1000 نگاشت می‌کند |
| 2 | PUMP | 0/1 | 0 | رله پمپ آب |
| 3 | AUX | 0/1 | 0 | خروجی کمکی (سوئینگ، شیر تخلیه) |
| 4 | ACCEL_S | 1–120 | 20 | زمان رسیدن از 0 به 100 % |
| 5 | IDENTIFY | نوشتن 1 | — | اجرای شناسایی موتور (فقط در حالت توقف) |
| 6 | CLEAR_ALARM | نوشتن 1 | — | پاک کردن آلارم قفل‌شده |
| 7 | COMM_TIMEOUT_S | 10–600 | 60 | زمان قطع ارتباط پنل |
| 8 | POLE_PAIRS | 0–30 | 0 | 0 = از کتابخانه موتور |
| 9 | MAX_RPM | 0–3000 | 0 | 0 = خودکار |
| 10 | I_LIMIT_DA | 10–120 | 60 | حد جریان فاز (0.1 A) |
| 11 | RESTORE_ON_PWR | 0/1 | 1 | ادامه حالت قبلی بعد از برگشت برق |
| 12 | BATT_SPEED_MAX | 0–1000 | 800 | سقف دور در حالت باتری (پروتکل v2) |
| 13 | BATT_PUMP | 0/1 | 1 | پمپ روی باتری |
| 14 | BATT_RESERVE | 5–80 % | 15 | حد ذخیره باتری |
| 15 | BATT_CHARGE_W | 0–600 | 250 | توان شارژ از برق شهر |

نوشتن مقدار خارج از بازه ⇒ exception 03 و رجیستر تغییر نمی‌کند.

## ۵.۳ رجیسترهای Input (فقط خواندنی)

| آدرس | نام | واحد |
|---|---|---|
| 0 | PROTO_VER | — |
| 1 | FW_VER | major<<8 \| minor |
| 2 | STATE | 0 Standby، 1 Identify، 2 Starting، 3 Running، 4 Stopping، 5 Retry-wait، 6 Alarm |
| 3 | ALARM | کد فعال (0 = هیچ، 1 تا 9 = E1 تا E9، جدول ۴.۶) |
| 4 | ALARM_LATCHED | بیت n = آلارم En از آخرین پاک‌سازی |
| 5 | SPEED_RPM | rpm مکانیکی (0 اگر تعداد قطب نامعلوم) |
| 6 | FREQ_DHZ | 0.1 Hz الکتریکی |
| 7 | VIN_DV | 0.1 V |
| 8 | VBUS_V | V |
| 9 | PIN_W | W (توان ورودی از شبکه) |
| 10 | IMOT_CA | 0.01 A rms |
| 11 | T_DRIVE_C | °C + 40 |
| 12 | T_MOTOR_C | °C + 40 (تخمین از R و I²t) |
| 13–14 | ENERGY_WH | 32 بیت، Wh |
| 15 | RUN_HOURS | ساعت |
| 16 | MOTOR_ID | اندیس کتابخانه، 0xFFFF = ناشناخته |
| 17 | R_MOHM | mΩ |
| 18 | L_UH_DIV10 | 10 µH |
| 19 | FLUX_UVS | 0.1 mV·s |
| 20 | PUMP_STATE | 0/1 |
| 21 | COMM_ERRORS | شمارنده خطای CRC |
| 22 | POWER_SOURCE | 0 برق شهر، 1 باتری، 2 خورشید (v2) |
| 23 | BATT_SOC | % |
| 24 | BATT_DV | 0.1 V |
| 25 | BATT_W | W + 32768 (بیشتر از 32768 = دشارژ) |
| 26 | BATT_MIN_LEFT | دقیقه، با بار فعلی |
| 27 | SOLAR_W | W |
| 28 | MODULE_STATUS | بیت 0 وجود، 1 آماده‌به‌کار، 2 شارژ، 3 خطا |

## ۵.۴ نمونه فریم‌ها

```
پنل: روشن کردن فن در 75 % و پمپ (تابع 0x10، از آدرس 0، سه رجیستر)
  01 10 00 00 00 03 06 00 01 02 EE 00 01 [CRC lo] [CRC hi]
درایو:
  01 10 00 00 00 03 [CRC lo] [CRC hi]

پنل: خواندن وضعیت (IR 2 تا 12، 11 رجیستر)
  01 04 00 02 00 0B [CRC lo] [CRC hi]
```

## ۵.۵ اتصال بنچ تست

نرم‌افزار بنچ تست کولر شما یا هر Modbus master (Modbus Poll، Python `pymodbus`) با یک مبدل USB-RS485 یا
USB-UART ایزوله به کانکتور تست کارخانه وصل می‌شود. می‌تواند `PIN_W`، `SPEED_RPM`، `IMOT_CA` و آلارم‌ها را در
هر پله سرعت ثبت کند و منحنی توان-دبی-دور را خودکار بسازد.

## ۵.۶ پروتکل v3 (برد v2)

`COOLER_PROTO_VER = 3`. رجیسترهای v2 بدون تغییر هستند؛ اضافه‌ها (جزئیات در `comm/cooler_regs.h` و سند ۰۸):

| آدرس | نام | توضیح |
|---|---|---|
| IR 29 | ALARM_DETAIL | زیرکد آلارم (`AD_*`)؛ بیت 0x80 = قفل‌شده |
| IR 30 | VCAP_LOW_V | ولتاژ خازن پایینی (فقط باس سری؛ در برد v2.0 = 0) |
| IR 31 | MAINS_DHZ | فرکانس برق، 0.1 Hz |
| IR 32، 33 | STARTS، OUTAGES | تعداد استارت و قطع برق |
| IR 34، 35 | SERIAL | شماره سریال 32 بیتی |
| IR 36 | HW_REV | 0x0200 |
| IR 37، 38 | LOG_COUNT، LOG_SEQ | دفترچه رویداد |
| IR 39 | POWER_STATE | انتظار برق / پیش‌شارژ / باس / PFC / اضافه‌ولتاژ / قطع برق |
| IR 0x0100 + 8k | LOG[k] | کد، جزئیات، دقیقه کار (32 بیت)، Vin، Vbus، جریان، دما |
| HR 0x0200–0x023F | FWU | پنجره به‌روزرسانی فریمور |
| IR 0x0200–0x0203 | FWU status | حالت، بایت دریافت‌شده، خطا |

**توجه:** پنل حالا IR 0 تا 12 را هر ثانیه می‌خواند (13 رجیستر) تا نسخه فریمور را هم بعد از به‌روزرسانی ببیند.
