faragamco-eng/Multiact/docs/08_firmware_v2.md

# ۸ — فریمور نسخه ۲: برد درایو (STM32G431) و PHY باس پنل (STM32C011)

کد: `firmware/v2/` · تست: `make -C firmware/v2 test` · ساخت ARM: `make -C firmware/v2` (نیاز به `make -C firmware cmsis` یک بار)

## ۸.۱ ساختار

| لایه | فایل | وظیفه | تست روی PC |
|---|---|---|---|
| کنترل موتور | `firmware/foc/foc.c` | FOC بدون سنسور، شناسایی خودکار، استارت در حال چرخش، حفاظت‌ها (سند ۰۶) | `make -C firmware test-foc` |
| برنامه درایو | `v2/app/drive.c` | ترتیب روشن شدن، رله‌ها، PFC، آلارم‌ها، کاهش توان، شمارنده‌ها، شناسایی، ذخیره | ۵۷۳ بررسی |
| برق شهر | `v2/app/mains.c` | rms و فرکانس هر سیکل، اضافه‌ولتاژ سریع، قطع برق | ✓ |
| حافظه | `v2/app/params.c` | ذخیره پارامترها در دو صفحه فلش، مقاوم در برابر قطع برق حین نوشتن | ✓ |
| کتابخانه موتور | `v2/app/motorlib.c` | تطبیق اثر انگشت (R، L، ψ) با موتورهای شناخته‌شده | ✓ |
| به‌روزرسانی | `v2/app/fwu.c` + `v2/boot/` | دریافت فریمور از Modbus، بوت‌لودر دوبانکی | ✓ |
| سخت‌افزار | `v2/bsp/bsp_v2.c` | ثبات‌های STM32G431 (بدون HAL) | کامپایل ARM |
| PHY پنل | `v2/phy/` | UART نرم‌افزاری روی مدولاسیون جریان/ولتاژ باس، پل فریم | ۲۴۰ تراکنش |

حجم: برنامه درایو **29.8 KB** از 54 KB، بوت‌لودر **1.5 KB** از 16 KB، PHY **6.4 KB** از 32 KB.

## ۸.۲ نقشه فلش STM32G431CB (128 KB)

| آدرس | اندازه | محتوا |
|---|---|---|
| 0x08000000 | 16 KB | بوت‌لودر |
| 0x08004000 | 54 KB | برنامه (در آفست 0x200: بلوک اطلاعات تصویر: magic، شناسه سخت‌افزار، نسخه، اندازه، CRC-32) |
| 0x08011800 | 54 KB | ناحیه دریافت فریمور جدید |
| 0x0801F000 | 4 KB | پارامترها (دو صفحه، رکوردهای 352 بایتی، 5 رکورد در صفحه) |

> **فلش تک‌بانک است** (CPU هنگام نوشتن متوقف می‌شود)، پس پارامترها **فقط وقتی موتور ایستاده** نوشته
> می‌شوند (توقف، قطع برق، تغییر تنظیمات بعد از توقف). شمارنده‌ها هنگام کار در RAM جمع می‌شوند.

## ۸.۳ روشن شدن و مسیر قدرت

| حالت (`IR_POWER_STATE`) | رله‌ها | شرط خروج |
|---|---|---|
| 0 انتظار برق | همه باز | ولتاژ 160 تا 265 V به مدت 2 s |
| 1 پیش‌شارژ | K2 (+PTC) | ولتاژ باس > 85 % پیک و ثابت ⇒ K1 بسته، K2 بعد از 100 ms باز. بیش از 5 s ⇒ E9 (PTC/خازن)، 60 s صبر |
| 2 باس یکسوشده | K1 | موتور درخواست شد ⇒ PFC روشن. **PFC در حالت آماده‌به‌کار خاموش است** (مصرف کم) |
| 3 باس PFC | K1 + PFC | 30 s بعد از توقف موتور ⇒ PFC خاموش. اگر 1.5 s بعد از روشن شدن باس < 360 V ⇒ E9 |
| 4 اضافه‌ولتاژ | همه باز | E1؛ برگشت وقتی Vin < 265 V به مدت 5 s |
| 5 قطع برق | همه باز | شمارش و ذخیره؛ برگشت خودکار و ادامه کار اگر `RESTORE_ON_PWR` |

**اضافه‌ولتاژ (قطع نول، 440 VAC):** پیک لحظه‌ای بالای 410 V در 3 نمونه پشت سر هم (0.2 ms) ⇒ رله‌ها در همان
تیک 1 ms رها می‌شوند. در شبیه‌سازی: **رله K1 سه میلی‌ثانیه بعد از شروع 440 V فرمان قطع گرفت** (زمان باز شدن
مکانیکی رله حدود 5 تا 10 ms دیگر است).

**تغذیه کمکی بعد از قطع برق:** دیود D29 (UF4007) از باس DC به ورودی پیش‌رگولاتور اضافه شد. خازن‌های
940 µF باس، کنترلر را بعد از قطع برق **چند ثانیه** روشن نگه می‌دارند (ذخیره وضعیت، خاموش کردن
مرتب) و در حالت ماژول باتری (آپشن) کنترلر از باس تغذیه می‌شود.

## ۸.۴ آلارم‌ها (پروتکل v3)

| کد | تشخیص | واکنش | جزئیات (`IR_ALARM_DETAIL`) |
|---|---|---|---|
| E1 | Vin > 280 V یا پیک > 410 V | رله‌ها باز؛ خودکار برمی‌گردد | — |
| E2 | Vin < 130 V | توقف؛ بین 150 و 130 V کاهش توان | — |
| E3 | جریان زیاد نرم‌افزاری یا مقایسه‌گر (COMP→BKIN2) | **3 تلاش با فاصله 10 s**، سپس قفل | 1 نرم‌افزار، 2 مقایسه‌گر |
| E4 | قفل شدن روتور | **تلاش بعد از 10، 30، 60 s**، سپس قفل | — |
| E5 | دمای سیم‌پیچ (مدل I²t، τ = 15 min) | کاهش دور از 130 °C، توقف 150 °C، برگشت 110 °C | — |
| E6 | NTC هیت‌سینک یا ترموسوئیچ 90 °C | کاهش دور از 85 °C، توقف 100 °C، برگشت 80 °C | 3 ترموسوئیچ |
| E7 | قطع فاز / خرابی استارت / شناسایی | قطع فاز و شناسایی: قفل فوری؛ استارت: مثل E4 | 9، 10، 11 |
| E8 | پنل بیشتر از `COMM_TIMEOUT_S` ساکت | فن و پمپ خاموش؛ با برگشت ارتباط خودکار پاک می‌شود | — |
| E9 | اضافه/کم‌ولتاژ باس، پیش‌شارژ، PFC (و عدم تعادل خازن‌ها اگر باس سری باشد) | 3 تلاش؛ عدم تعادل: **قفل و رله‌ها باز** تا تأیید کاربر | 4، 5، 6، 7، 8 |
| E10، E11 | باتری (آپشن) | — | — |

بیت 0x80 در جزئیات یعنی تلاش‌ها تمام شده و آلارم قفل است (پاک کردن: `HR_CLEAR_ALARM` یا کلید پنل).
هر آلارم با ولتاژ ورودی، ولتاژ باس، جریان و دما در **دفترچه رویداد ۱۶تایی** ثبت و ذخیره می‌شود
(`IR 0x0100 + 8k`).

**خازن‌های باس:** برد v2.0 دو خازن نو 470 µF/450 V موازی دارد، پس بررسی تعادل خاموش است (`cap_tol = 0`).
برای نسخه‌ای با سه خازن سری، `cap_tol = 0.12` و سنجش نقطه میانی روی PA5 آن را فعال می‌کند (تست‌شده):
انحراف بیشتر از 12 % از VBUS/3 به مدت 2 s ⇒ E9 جزئیات 7.

## ۸.۵ شناسایی و کتابخانه موتور

بعد از شناسایی (R، Ld، Lq، ψ، اینرسی)، `motorlib.c` نزدیک‌ترین موتور را با فاصله لگاریتمی (وزن ψ بیشتر،
چون R با دما تغییر می‌کند) پیدا می‌کند. اگر پیدا شد: تعداد جفت قطب ⇒ نمایش rpm، جریان نامی ⇒ حد جریان،
دور نامی ⇒ سرعت 100 %. اگر نه: پروفایل محافظه‌کارانه (BEMF در 100 % برابر 75 % ولتاژ قابل دسترس، تلفات مسی
≤ 60 W). **مقادیر کتابخانه فعلاً از موتورهای شبیه‌ساز است** و باید با اعداد واقعی که درایو روی میز
گزارش می‌کند (`IR_R_MOHM`، `IR_L_UH_DIV10`، `IR_FLUX_UVS`) جایگزین شوند.

## ۸.۶ به‌روزرسانی فریمور درایو از طریق پنل

```
پنل: HR 0x201..0x204 = اندازه و CRC-32 کل تصویر
     HR 0x200 = 1 (BEGIN)          ⇐ درایو اگر موتور می‌چرخد رد می‌کند
     IR 0x200 را بخوان تا 2 (RECEIVING)   (پاک کردن ناحیه، صفحه به صفحه)
     تکرار: FC16 به HR 0x20E: {offset_lo, offset_hi, 48 رجیستر = 96 بایت}
     HR 0x200 = 2 (COMMIT)         ⇐ درایو CRC و بلوک اطلاعات را بررسی، سپس ریست
بوت‌لودر: تصویر جدید معتبر و متفاوت ⇒ کپی ⇒ اجرا
پنل: IR 1 (FW_VER) را بخوان تا نسخه جدید دیده شود
```

* تکرار یک بسته با همان offset بی‌خطر است (بسته تکراری نادیده گرفته می‌شود).
* قطع برق در هر مرحله: یا برنامه قدیم سالم است، یا بوت‌لودر در ریست بعدی کپی را تکرار می‌کند (تست شده).
* هر دو خراب ⇒ بوت‌لودر خروجی‌ها را خاموش نگه می‌دارد و LED سریع چشمک می‌زند (برنامه‌ریزی با SWD).
* **اصالت:** امضای Ed25519 سازنده در **پنل** بررسی می‌شود (قبل از ارسال)؛ درایو فقط صحت (CRC) و شناسه
  سخت‌افزار را کنترل می‌کند. اضافه کردن بررسی امضا به بوت‌لودر درایو هم ممکن است (حدود 8 KB کد).
* زمان: تصویر 30 KB در 2400 bps حدود **2.7 دقیقه** (تست پنل).
* ساخت تصویر: `make -C firmware/v2 pack` ⇒ `build/drive_v2_update.bin` (اندازه و CRC پر می‌شود).

## ۸.۷ PHY باس پنل (STM32C011)

* **دریافت از پنل:** جریان برگشتی هر 52 µs (8 برابر نرخ بیت) نمونه‌برداری می‌شود. جریان پایه پنل (که با
  نور صفحه و وای‌فای تغییر می‌کند) دائماً دنبال می‌شود و آستانه = پایه + 10 mA. اگر «space» بیشتر از 12 بیت
  طول بکشد (در UART غیرممکن است) یعنی جریان پایه پله خورده ⇒ پایه دوباره گرفته می‌شود.
* **ارسال به پنل:** Q8 ولتاژ باس را بین 24 و 16 V سوئیچ می‌کند؛ دریافت حین ارسال و تا 2 کاراکتر بعد
  غیرفعال است (شارژ خازن ورودی پنل جریان کاذب می‌سازد).
* **پل:** فقط فریم با CRC درست به درایو (115200 bps از ISO7762) می‌رود؛ پاسخ درایو به پنل برمی‌گردد.
  آدرس 247 را خود PHY جواب می‌دهد (نسخه، ولتاژ باس، جریان پایه، شمارنده خطا).
* **نتیجه تست:** با نویز 3 mA rms، خطای کلاک پنل ±2.5 %، نوسان ±8 mA جریان پایه و پله 40→70 mA:
  **240 از 240 تراکنش درست**.

## ۸.۸ موارد تأییدنشده (حین راه‌اندازی برد)

* کدگذاری‌های علامت‌خورده با `VERIFY` در `bsp_v2.c` و `phy_main.c` (کانال‌های داخلی OPAMP به ADC، منبع
  تریگر TRGO2، شماره AF در STM32C0) از حافظه و RM0440/RM0490 نوشته شده‌اند؛ روی برد واقعی چک شوند.
* آستانه مقایسه‌گر اتصال کوتاه (VREFINT ⇒ حدود 40 A در شنت) با جریان پیک MOSFET سازگار است ولی
  باید با تست اتصال کوتاه کنترل‌شده (منبع محدود) تأیید شود.
* زمان مرده 1 µs برای STW24N60DM2 با گیت 10 Ω محافظه‌کارانه است؛ با اسیلوسکوپ کاهش داده شود.
