faragamco-eng/Multiact/docs/img/sch_v2_aux_supply.png

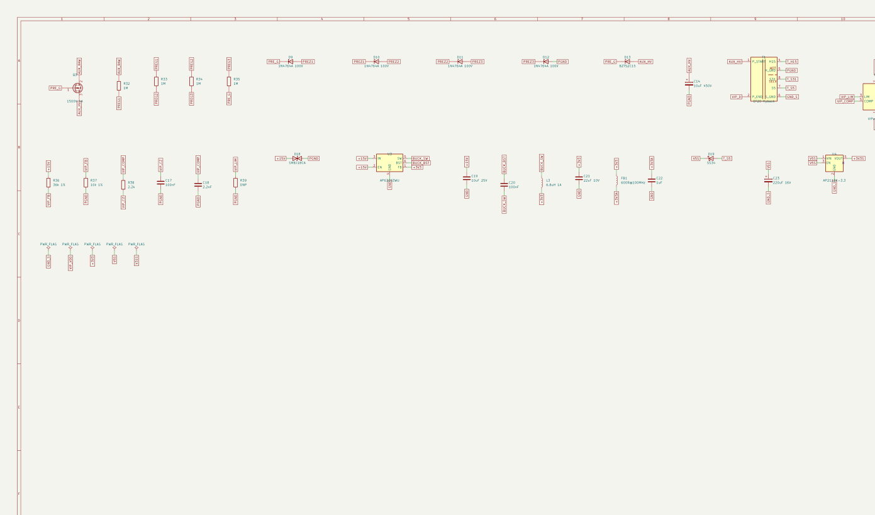
docs/img/sch_v2_aux_supply.png
