faragamco-eng/Multiact/hardware/panel/out/bom.csv

Qty | References | Value | MPN / description | Footprint | Populate
1 | J1 | BUS 2-WIRE |  | TerminalBlock_Phoenix:TerminalBlock_Phoenix_MKDS-1,5-2-5.08_1x02_P5.08mm_Horizontal | yes
1 | F1 | 0.1A hold | Bourns MF-MSMF010 | Fuse:Fuse_1812_4532Metric | yes
1 | D1 | SMBJ33CA | SMBJ33CA (bidirectional) | Diode_SMD:D_SMB | yes
1 | BR1 | ABS10 | Diotec ABS10 (1000 V 0.8 A) | Diode_SMD:Diode_Bridge_Diotec_ABS | yes
1 | C1 | 100nF 50V |  | Capacitor_SMD:C_0805_2012Metric | yes
1 | R1 | 68k 1% |  | Resistor_SMD:R_0603_1608Metric | yes
2 | R2 R5 | 10k 1% |  | Resistor_SMD:R_0603_1608Metric | yes
1 | C2 | 1nF |  | Capacitor_SMD:C_0603_1608Metric | yes
1 | R3 | 470k |  | Resistor_SMD:R_0603_1608Metric | yes
1 | R4 | 4.02k 1% |  | Resistor_SMD:R_0603_1608Metric | yes
5 | C3 C4 C7 C11 C18 | 100nF |  | Capacitor_SMD:C_0603_1608Metric | yes
1 | U1 | LMV331 | TI LMV331IDBVR (open drain) | Package_TO_SOT_SMD:SOT-23-5 | yes
9 | R6 R9 R13 R14 R33 R34 R35 R36 R37 | 10k |  | Resistor_SMD:R_0603_1608Metric | yes
2 | R7 R8 | 1k |  | Resistor_SMD:R_0603_1608Metric | yes
1 | Q1 | BCX56 | BCX56-16 (SOT-89, 1 W) | Package_TO_SOT_SMD:SOT-89-3 | yes
1 | R10 | 120R 1% |  | Resistor_SMD:R_0603_1608Metric | yes
1 | R11 | 470R 1W |  | Resistor_SMD:R_2512_6332Metric | yes
1 | U2 | LM317 CC | LM317DCY | Package_TO_SOT_SMD:SOT-223-3_TabPin2 | yes
1 | R12 | 24R 1% |  | Resistor_SMD:R_1206_3216Metric | yes
1 | D2 | 10V 3W | 1SMB5925BT3 (10 V 3 W) | Diode_SMD:D_SMB | yes
1 | C5 | 1000uF 16V | low-ESR 105 C | Capacitor_THT:CP_Radial_D10.0mm_P5.00mm | yes
1 | C6 | 10uF 25V |  | Capacitor_SMD:C_1206_3216Metric | yes
1 | U3 | AP63203WU | Diodes AP63203WU (fixed 3.3 V) | Package_TO_SOT_SMD:TSOT-23-6 | yes
1 | L1 | 6.8uH 1A | Bourns SRN6045TA-6R8M | Inductor_SMD:L_Bourns_SRN6045TA | yes
2 | C8 C9 | 22uF 10V |  | Capacitor_SMD:C_1206_3216Metric | yes
1 | D3 | SS14 | SS14 | Diode_SMD:D_SMA | yes
1 | U4 | ESP32-S3-WROOM-1-N8 | Espressif ESP32-S3-WROOM-1-N8 (NOT an R8 variant: IO35-37 are used) | RF_Module:ESP32-S3-WROOM-1 | yes
1 | C10 | 10uF |  | Capacitor_SMD:C_0805_2012Metric | yes
1 | C12 | 1uF |  | Capacitor_SMD:C_0603_1608Metric | yes
1 | SW6 | BOOT |  | Button_Switch_THT:SW_PUSH_6mm | yes
1 | J2 | USB-C | GCT USB4105-GF-A | Connector_USB:USB_C_Receptacle_GCT_USB4105-xx-A_16P_TopMnt_Horizontal | yes
2 | R15 R16 | 5.1k |  | Resistor_SMD:R_0603_1608Metric | yes
1 | U5 | USBLC6-2SC6 | ST USBLC6-2SC6 | Package_TO_SOT_SMD:SOT-23-6 | yes
2 | R17 R18 | 22R |  | Resistor_SMD:R_0603_1608Metric | yes
8 | R20 R21 R22 R23 R24 R25 R26 R27 | 150R |  | Resistor_SMD:R_0603_1608Metric | yes
1 | DS1 | CC56-12SURKWA | Kingbright CC56-12SURKWA (0.56 in, super-bright red, common cathode) | Display_7Segment:CA56-12EWA | yes
6 | Q2 Q3 Q4 Q5 Q6 Q7 | 2N7002 | 2N7002 | Package_TO_SOT_SMD:SOT-23 | yes
6 | R28 R29 R30 R31 R32 R38 | 100k |  | Resistor_SMD:R_0603_1608Metric | yes
1 | LED1 | POWER | green | LED_SMD:LED_0805_2012Metric | yes
1 | LED2 | PUMP | green | LED_SMD:LED_0805_2012Metric | yes
1 | LED3 | FAN | green | LED_SMD:LED_0805_2012Metric | yes
1 | LED4 | TIMER | green | LED_SMD:LED_0805_2012Metric | yes
1 | LED5 | ALARM | red | LED_SMD:LED_0805_2012Metric | yes
1 | LED6 | WIFI | blue | LED_SMD:LED_0805_2012Metric | yes
1 | SW1 | POWER |  | Button_Switch_THT:SW_PUSH_6mm | yes
5 | C13 C14 C15 C16 C17 | 10nF |  | Capacitor_SMD:C_0603_1608Metric | yes
1 | SW2 | UP |  | Button_Switch_THT:SW_PUSH_6mm | yes
1 | SW3 | DOWN |  | Button_Switch_THT:SW_PUSH_6mm | yes
1 | SW4 | MODE |  | Button_Switch_THT:SW_PUSH_6mm | yes
1 | SW5 | TIMER |  | Button_Switch_THT:SW_PUSH_6mm | yes
1 | BZ1 | 3V magnetic | magnetic buzzer 3 V, 2.7 kHz (e.g. CUI CMT-1203) | Buzzer_Beeper:Buzzer_12x9.5RM7.6 | yes
1 | D4 | 1N4148W | 1N4148W | Diode_SMD:D_SOD-123 | yes
1 | U6 | SHT40 | Sensirion SHT40-AD1B | Sensor_Humidity:Sensirion_DFN-4_1.5x1.5mm_P0.8mm_SHT4x_NoCentralPad | OPTION/DNP
2 | R39 R40 | 4.7k |  | Resistor_SMD:R_0603_1608Metric | yes
4 | H1 H2 H3 H4 | M3 |  | MountingHole:MountingHole_3.2mm_M3 | yes
3 | FID1 FID2 FID3 | FID |  | Fiducial:Fiducial_1mm_Mask2mm | yes
1 | TP1 | BUSR |  | TestPoint:TestPoint_Pad_D1.5mm | yes
1 | TP2 | VSTORE |  | TestPoint:TestPoint_Pad_D1.5mm | yes
1 | TP3 | +3V3 |  | TestPoint:TestPoint_Pad_D1.5mm | yes
1 | TP4 | GND |  | TestPoint:TestPoint_Pad_D1.5mm | yes
1 | TP5 | BUS_TX |  | TestPoint:TestPoint_Pad_D1.5mm | yes
1 | TP6 | BUS_RX |  | TestPoint:TestPoint_Pad_D1.5mm | yes
1 | TP7 | U0_TX |  | TestPoint:TestPoint_Pad_D1.5mm | yes
1 | TP8 | U0_RX |  | TestPoint:TestPoint_Pad_D1.5mm | yes
1 | TP9 | EN |  | TestPoint:TestPoint_Pad_D1.5mm | yes
