faragamco-eng/Multiact/hardware/v2/out/bom.csv

Qty | References | Value | MPN / description | Footprint | Populate
1 | J1 | AC IN L/N/PE | Phoenix MKDS 1,5/3-5,08 | TerminalBlock_Phoenix:TerminalBlock_Phoenix_MKDS-1,5-3-5.08_1x03_P5.08mm_Horizontal | yes
1 | F1 | 10A T 250VAC | 5x20 ceramic 10 A time-lag | Fuse:Fuseholder_Cylinder-5x20mm_Bulgin_FX0457_Horizontal_Closed | yes
1 | RV1 | S14K385 | EPCOS S14K385 | Varistor:RV_Disc_D15.5mm_W11mm_P7.5mm | yes
2 | RV2 RV3 | S14K385 |  | Varistor:RV_Disc_D15.5mm_W11mm_P7.5mm | yes
1 | GDT1 | GDT 600V | axial 2-electrode GDT 600 V (e.g. Bourns 2026-60 / EPCOS EC600X) | Custom:GDT_Axial_P15.24mm | yes
1 | CX1 | 470nF X2 | X2 310VAC | Capacitor_THT:C_Rect_L18.0mm_W7.0mm_P15.00mm_FKS3_FKP3 | yes
2 | R1 R2 | 470k |  | Resistor_SMD:R_1206_3216Metric | yes
1 | L1 | 2x4.7mH 10A | toroidal CM choke 2 x 4.7 mH, >= 10 A (e.g. Schaffner RN series); verify pin map | Custom:CMC_Toroid_4P_25x15mm | yes
1 | CX2 | 470nF X2 |  | Capacitor_THT:C_Rect_L18.0mm_W7.0mm_P15.00mm_FKS3_FKP3 | yes
2 | CY1 CY2 | 2.2nF Y2 | Y2 300VAC | Capacitor_THT:C_Disc_D11.0mm_W5.0mm_P7.50mm | yes
1 | K1 | Finder 40.11.9.012 | Finder 40.11.9.012.0000 (10 A, 12 V coil) | Relay_THT:Relay_SPDT_Finder_40.11 | yes
3 | K2 K3 K4 | Finder 34.51.7.012 | Finder 34.51.7.012.0010 | Relay_THT:Relay_SPDT_Finder_34.51_Vertical | yes
1 | PTC1 | PTC 120R inrush | inrush PTC rated >= 80 J at 265 VAC (940 uF @ 373 V = 65 J), e.g. TDK/EPCOS J1xx series - verify | Capacitor_THT:C_Disc_D11.0mm_W5.0mm_P7.50mm | yes
3 | D1 D2 D3 | 1N4007 | 1N4007 | Diode_THT:D_DO-41_SOD81_P10.16mm_Horizontal | yes
4 | C1 C35 C40 C36 | 100nF 630V |  | Capacitor_THT:C_Rect_L18.0mm_W6.0mm_P15.00mm_FKS3_FKP3 | yes
1 | D29 | UF4007 | UF4007 (1000 V) | Diode_THT:D_DO-41_SOD81_P10.16mm_Horizontal | yes
14 | R3 R4 R5 R7 R8 R9 R22 R23 R24 R25 R32 R33 R34 R35 | 1M |  | Resistor_SMD:R_1206_3216Metric | yes
5 | R6 R10 R60 R61 R62 | 10k 0.1% |  | Resistor_SMD:R_0603_1608Metric | yes
2 | D4 D5 | BAT54S | BAT54S | Package_TO_SOT_SMD:SOT-23 | yes
5 | C2 C3 C7 C8 C41 | 1nF |  | Capacitor_SMD:C_0603_1608Metric | yes
7 | R11 R12 R53 R70 R73 R88 R96 | 1k |  | Resistor_SMD:R_0603_1608Metric | yes
1 | BR1 | GBU1010 | GBU1010 (10 A 1000 V) on heatsink | Diode_THT:Diode_Bridge_Vishay_GBU | yes
2 | C4 C34 | 1uF 630V |  | Capacitor_THT:C_Rect_L26.5mm_W8.5mm_P22.50mm_MKS4 | yes
1 | L2 | 470uH 13A | toroid ~46 mm OD (e.g. Kool Mu 0077083A7 or High Flux 58083), 470 uH at 11 A, Isat >= 13 A | Inductor_THT:L_Toroid_Vertical_L46.0mm_W19.1mm_P21.80mm_Bourns_5700 | yes
1 | D6 | SiC 650V 8A | Wolfspeed C3D08065A / Infineon IDH08G65C6 | Package_TO_SOT_THT:TO-220-2_Vertical | yes
1 | D7 | P600M | P600M / 1N5408 inrush bypass | Diode_THT:D_DO-201AD_P15.24mm_Horizontal | yes
1 | Q1 | 650V 95mOhm SJ | Infineon IPW65R095C7 / ST STW40N60M6 (heatsink, insulated) | Package_TO_SOT_THT:TO-247-3_Vertical | yes
2 | R13 R17 | 10R |  | Resistor_SMD:R_0603_1608Metric | yes
15 | R14 R108 R110 R112 R114 R116 R118 R41 R43 R45 R47 R49 R51 R52 R72 | 10k |  | Resistor_SMD:R_0603_1608Metric | yes
1 | D8 | BZT52C18 | BZT52C18 | Diode_SMD:D_SOD-123 | yes
2 | R15 R16 | 50m 3W |  | Resistor_SMD:R_2512_6332Metric | yes
1 | U1 | NCP1653 | onsemi NCP1653ADR2G (67 kHz) | Package_SO:SOIC-8_3.9x4.9mm_P1.27mm | yes
1 | C5 | 22uF 25V |  | Capacitor_THT:CP_Radial_D8.0mm_P3.50mm | yes
20 | C6 C17 C20 C29 C64 C31 C66 C33 C68 C27 C42 C43 C44 C45 C48 C49 C52 C53 C54 C56 | 100nF |  | Capacitor_SMD:C_0603_1608Metric | yes
4 | R18 R19 R20 R21 | 470k 1% |  | Resistor_SMD:R_1206_3216Metric | yes
1 | R26 | 4.7k |  | Resistor_SMD:R_0603_1608Metric | yes
1 | C9 | 100pF |  | Capacitor_SMD:C_0603_1608Metric | yes
1 | R27 | 22k |  | Resistor_SMD:R_0603_1608Metric | yes
1 | C10 | 220pF |  | Capacitor_SMD:C_0603_1608Metric | yes
1 | C11 | 1uF |  | Capacitor_SMD:C_0805_2012Metric | yes
6 | Q2 Q4 Q5 Q6 Q7 Q8 | 2N7002 | 2N7002 | Package_TO_SOT_SMD:SOT-23 | yes
6 | R28 R76 R79 R82 R85 R94 | 100k |  | Resistor_SMD:R_0603_1608Metric | yes
2 | C12 C13 | 470uF 450V | 470 uF 450 V 105 C >= 5000 h snap-in D35 (e.g. Nichicon LGN/LGU, TDK B43544, Rubycon USR) | Capacitor_THT:CP_Radial_D35.0mm_P10.00mm_SnapIn | yes
3 | R29 R30 R31 | 100k |  | Resistor_SMD:R_1206_3216Metric | yes
1 | LED1 | red HV | high-efficiency red, 'HIGH VOLTAGE' | LED_SMD:LED_0805_2012Metric | yes
1 | Q3 | 1500V 4A | ST STW4N150 (on main heatsink, insulated) | Package_TO_SOT_THT:TO-247-3_Vertical | yes
4 | D9 D10 D11 D12 | 1N4764A 100V | 1N4764A | Diode_THT:D_DO-41_SOD81_P10.16mm_Horizontal | yes
1 | D13 | BZT52C15 | BZT52C15 | Diode_SMD:D_SOD-123 | yes
1 | C14 | 10uF 450V |  | Capacitor_THT:CP_Radial_D10.0mm_P5.00mm | yes
1 | T1 | EF20 flyback | custom, see calc/transformer spec | Transformer_THT:Transformer_Myrra_EF20_7408x | yes
1 | U2 | VIPer26LN | ST VIPer26LN (60 kHz) | Package_DIP:DIP-8-N6_W7.62mm | yes
1 | D14 | UF4007 | UF4007 | Diode_THT:D_DO-41_SOD81_P10.16mm_Horizontal | yes
1 | D15 | P6KE200CA | P6KE200CA (bidirectional, 200 V clamp) | Diode_THT:D_DO-41_SOD81_P10.16mm_Horizontal | yes
2 | D16 D20 | ES1D | ES1D | Diode_SMD:D_SMA | yes
1 | C15 | 220uF 35V |  | Capacitor_THT:CP_Radial_D8.0mm_P3.50mm | yes
5 | D17 D21 D22 D23 D24 | 1N4148W | 1N4148W | Diode_SMD:D_SOD-123 | yes
1 | C16 | 10uF 35V |  | Capacitor_THT:CP_Radial_D8.0mm_P3.50mm | yes
1 | R36 | 36k 1% |  | Resistor_SMD:R_0603_1608Metric | yes
3 | R37 R71 R98 | 10k 1% |  | Resistor_SMD:R_0603_1608Metric | yes
1 | R38 | 2.2k |  | Resistor_SMD:R_0603_1608Metric | yes
1 | C18 | 2.2nF |  | Capacitor_SMD:C_0603_1608Metric | yes
1 | R39 | DNP |  | Resistor_SMD:R_0603_1608Metric | yes
1 | D18 | SMBJ18CA | SMBJ18CA | Diode_SMD:D_SMB | yes
1 | U3 | AP63203WU | Diodes AP63203WU (fixed 3.3 V) | Package_TO_SOT_SMD:TSOT-23-6 | yes
5 | C19 C63 C65 C67 C26 | 10uF 25V |  | Capacitor_SMD:C_1206_3216Metric | yes
1 | L3 | 6.8uH 1A | Bourns SRN6045TA-6R8M | Inductor_SMD:L_Bourns_SRN6045TA | yes
1 | C21 | 22uF 10V |  | Capacitor_SMD:C_1206_3216Metric | yes
1 | FB1 | 600R@100MHz | ferrite bead | Inductor_SMD:L_0603_1608Metric | yes
4 | C22 C24 C47 C55 | 1uF |  | Capacitor_SMD:C_0603_1608Metric | yes
1 | D19 | SS34 | SS34 | Diode_SMD:D_SMA | yes
1 | C23 | 220uF 16V |  | Capacitor_THT:CP_Radial_D8.0mm_P3.50mm | yes
1 | U4 | AP2112K-3.3 | Diodes AP2112K-3.3TRG1 | Package_TO_SOT_SMD:SOT-23-5 | yes
1 | C25 | 470uF 50V |  | Capacitor_THT:CP_Radial_D10.0mm_P5.00mm | yes
3 | U5 U12 U13 | IRS2186PBF | Infineon IRS2186PBF (DIP-8 in socket) | Package_DIP:DIP-8_W7.62mm_Socket | yes
6 | Q9 Q10 Q11 Q12 Q13 Q14 | 600V 18A | ST STW24N60DM2 (fast body diode) / alt. STGW20H60DF IGBT | Package_TO_SOT_THT:TO-247-3_Vertical | yes
9 | R107 R109 R119 R111 R113 R120 R115 R117 R121 | 10R |  | Resistor_SMD:R_1206_3216Metric | yes
3 | D26 D27 D28 | UF4007 | UF4007 (1000 V, 75 ns) | Diode_THT:D_DO-41_SOD81_P10.16mm_Horizontal | yes
3 | C28 C30 C32 | 4.7uF 25V X7R |  | Capacitor_SMD:C_1206_3216Metric | yes
11 | R40 R42 R44 R46 R48 R50 R75 R78 R81 R84 R93 | 100R |  | Resistor_SMD:R_0603_1608Metric | yes
2 | C69 C59 | 10nF |  | Capacitor_SMD:C_0603_1608Metric | yes
1 | J10 | TSW 90C NC | KSD301 90 C normally closed, on heatsink | Connector_PinHeader_2.54mm:PinHeader_1x02_P2.54mm_Vertical | yes
3 | R54 R55 R56 | 25m 2W |  | Resistor_SMD:R_2512_6332Metric | yes
3 | R57 R58 R59 | 1k 0.1% |  | Resistor_SMD:R_0603_1608Metric | yes
3 | C37 C38 C39 | 470pF C0G |  | Capacitor_SMD:C_0603_1608Metric | yes
1 | NT1 | STAR |  | NetTie:NetTie-2_SMD_Pad0.5mm | yes
1 | J2 | MOTOR U/V/W/PE |  | TerminalBlock_Phoenix:TerminalBlock_Phoenix_MKDS-1,5-4-5.08_1x04_P5.08mm_Horizontal | yes
3 | R66 R67 R68 | 330k 1% |  | Resistor_SMD:R_1206_3216Metric | yes
1 | R69 | 6.65k 0.1% |  | Resistor_SMD:R_0603_1608Metric | yes
1 | J3 | NTC 10k B3435 | screw-lug NTC 10k B3435 on heatsink | Connector_PinHeader_2.54mm:PinHeader_1x02_P2.54mm_Vertical | yes
1 | U6 | STM32G431CBT6 | ST STM32G431CBT6 | Package_QFP:LQFP-48_7x7mm_P0.5mm | yes
1 | C46 | 4.7uF |  | Capacitor_SMD:C_0805_2012Metric | yes
1 | LED2 | green |  | LED_SMD:LED_0805_2012Metric | yes
1 | TP1 | DAC |  | TestPoint:TestPoint_Pad_D1.5mm | yes
1 | J4 | SWD (HOT!) |  | Connector_PinHeader_1.27mm:PinHeader_2x05_P1.27mm_Vertical | yes
1 | R74 | 68R 0.5W |  | Resistor_SMD:R_1206_3216Metric | yes
3 | R77 R80 R83 | 220R |  | Resistor_SMD:R_0603_1608Metric | yes
1 | F2 | 2A T | 5x20 2 A time-lag | Fuse:Fuseholder_Cylinder-5x20mm_Bulgin_FX0457_Horizontal_Closed | yes
1 | J5 | PUMP L/N DRAIN L/N |  | TerminalBlock_Phoenix:TerminalBlock_Phoenix_MKDS-1,5-4-5.08_1x04_P5.08mm_Horizontal | yes
2 | C50 C51 | 47nF X2 |  | Capacitor_THT:C_Rect_L18.0mm_W6.0mm_P15.00mm_FKS3_FKP3 | OPTION/DNP
2 | R86 R87 | 100R 1W |  | Resistor_SMD:R_2512_6332Metric | yes
1 | U7 | ISO7762DW | TI ISO7762DWR (reinforced 5 kVrms, SOIC-16 wide) | Package_SO:SOIC-16W_7.5x10.3mm_P1.27mm | yes
1 | U8 | STM32C011F6P6 | ST STM32C011F6P6 | Package_SO:TSSOP-20_4.4x6.5mm_P0.65mm | yes
1 | LED3 | yellow |  | LED_SMD:LED_0805_2012Metric | yes
1 | J6 | SWD SELV |  | Connector_PinHeader_2.54mm:PinHeader_1x05_P2.54mm_Vertical | yes
1 | U9 | LM317 CC | LM317T (small heatsink) | Package_TO_SOT_THT:TO-220-3_Vertical | yes
1 | R89 | 8.2R 0.5W |  | Resistor_SMD:R_1206_3216Metric | yes
1 | U10 | LM317 REG | LM317T | Package_TO_SOT_THT:TO-220-3_Vertical | yes
1 | R90 | 240R 1% |  | Resistor_SMD:R_0603_1608Metric | yes
1 | R91 | 4.3k 1% |  | Resistor_SMD:R_0603_1608Metric | yes
1 | R92 | 8.2k 1% |  | Resistor_SMD:R_0603_1608Metric | yes
1 | C57 | 1uF 50V |  | Capacitor_SMD:C_1206_3216Metric | yes
1 | C58 | 10uF 35V |  | Capacitor_SMD:C_1206_3216Metric | yes
1 | F3 | 0.1A hold | Bourns MF-MSMF010 | Fuse:Fuse_1812_4532Metric | yes
1 | D25 | SMBJ33CA | SMBJ33CA | Diode_SMD:D_SMB | yes
1 | R95 | 4.7R 1% |  | Resistor_SMD:R_1206_3216Metric | yes
1 | R97 | 100k 1% |  | Resistor_SMD:R_0603_1608Metric | yes
1 | J7 | PANEL 2-WIRE |  | TerminalBlock_Phoenix:TerminalBlock_Phoenix_MKDS-1,5-2-5.08_1x02_P5.08mm_Horizontal | yes
1 | U11 | SP3485EN | MaxLinear SP3485EN (3.3 V half duplex) | Package_SO:SOIC-8_3.9x4.9mm_P1.27mm | OPTION/DNP
1 | C60 | 100nF |  | Capacitor_SMD:C_0603_1608Metric | OPTION/DNP
1 | R99 | 120R |  | Resistor_SMD:R_0603_1608Metric | OPTION/DNP
1 | JP1 | TERM |  | Jumper:SolderJumper-2_P1.3mm_Open_Pad1.0x1.5mm | OPTION/DNP
1 | J8 | BATT MODULE RS-485 |  | TerminalBlock_Phoenix:TerminalBlock_Phoenix_MKDS-1,5-3-5.08_1x03_P5.08mm_Horizontal | OPTION/DNP
1 | F4 | 5A 500VDC | 5x20 ceramic, DC rated >= 500 V (e.g. Littelfuse 505 series) | Fuse:Fuseholder_Cylinder-5x20mm_Bulgin_FX0457_Horizontal_Closed | OPTION/DNP
1 | J9 | BATT MODULE DC BUS |  | TerminalBlock_Phoenix:TerminalBlock_Phoenix_MKDS-1,5-3-5.08_1x03_P5.08mm_Horizontal | OPTION/DNP
4 | H1 H2 H3 H4 | M3 |  | MountingHole:MountingHole_3.2mm_M3 | yes
3 | FID1 FID2 FID3 | FID |  | Fiducial:Fiducial_1mm_Mask2mm | yes
1 | TP2 | +15V |  | TestPoint:TestPoint_Pad_D1.5mm | yes
1 | TP3 | +3V3 |  | TestPoint:TestPoint_Pad_D1.5mm | yes
1 | TP4 | GND |  | TestPoint:TestPoint_Pad_D1.5mm | yes
1 | TP5 | PFC_DRV |  | TestPoint:TestPoint_Pad_D1.5mm | yes
1 | TP6 | ISENSE_U |  | TestPoint:TestPoint_Pad_D1.5mm | yes
1 | TP7 | UART_H_TX |  | TestPoint:TestPoint_Pad_D1.5mm | yes
1 | TP8 | +3V3S |  | TestPoint:TestPoint_Pad_D1.5mm | yes
1 | TP9 | GND_S |  | TestPoint:TestPoint_Pad_D1.5mm | yes
1 | TP10 | PANEL_P |  | TestPoint:TestPoint_Pad_D1.5mm | yes
