faragamco-eng/Multiact/docs/03_bringup_and_safety.md

# ۳ — راه‌اندازی مرحله‌ای (Bring-up) و ایمنی

## ⚠️ هشدار ایمنی — قبل از هر کاری

* **تمام برد، از جمله MCU، دکمه، پتانسیومتر و کانکتور SWD، به برق شهر متصل است.** تنها نقطه امن برای لمس
  کانکتور J2 (سمت ایزوله ISO7721) است.
* هرگز اسیلوسکوپ زمین‌دار را مستقیم به برد وصل نکنید (کلیپ زمین پراب = اتصال کوتاه فاز به ارت). از
  **پراب دیفرانسیل HV** یا ترانس ایزوله برای کل برد استفاده کنید — نه برای اسیلوسکوپ.
* دیباگر SWD فقط از طریق ایزولاتور USB (مثلاً ISOUSB211) یا با ترانس ایزوله.
* خازن‌های باس 66 J ذخیره دارند و بلیدر تا ~6 دقیقه برای تخلیه زیر 60 V لازم دارد؛ تا خاموش‌شدن LED_HV دست نزنید
  و قبل از کار با ولت‌متر چک کنید.
* مراحل اولیه را با **منبع DC محدود-جریان** (Variac + ترانس ایزوله یا منبع 0–400 V با محدودیت 0.5 A) انجام دهید.

## مرحله ۱ — برد بدون ولتاژ بالا (منبع 15 V خارجی)

1. IPM و پل را **مونتاژ نکنید** (یا P را باز بگذارید). +15 V را از منبع آزمایشگاهی به `+15V` بدهید.
2. ولتاژ 3.3 V و جریان کل (< 60 mA) را چک کنید.
3. فریمور را با SWD بریزید (`make cmsis && make && make flash`). در ترمینال UART (J2، 115200) پیام
   `BLDC-310 sensorless six-step` و سپس تله‌متری باید بیاید (فریمور تا Vbus ≥ 230 V منتظر می‌ماند و رله را نمی‌بندد).
4. **اسیلوسکوپ روی شش خروجی PWM** (پین‌های IPM، هنوز بدون IPM یا با IPM بدون باس):
   * برای تست بدون باس، در `main.c` موقتاً `precharge_bus()` را دور بزنید و در `app_config.h` مقادیر `VBUS_START_MIN_V` و `VBUS_UV_V` را 0 کنید (و `vbus_v` را در `ss_init` مثلاً 310 مقداردهی کنید تا محاسبه دیوتی تقسیم بر صفر نشود). چون جریانی وجود ندارد، کنترل‌گر جریان استارت دیوتی را تا `START_DUTY_MAX` بالا می‌برد — برای دیدن پالس‌ها کافی است. **این تغییرات را بعداً برگردانید.**
   * `run` بفرستید ⇒ ترتیب: PRECHARGE (هر سه low-side روشن 10 ms) ⇒ ALIGN ⇒ RAMP.
   * بررسی کنید: هرگز HIN و LIN یک فاز هم‌زمان فعال نیستند؛ dead-time ≈ 1 µs؛ فاز شناور هر دو خاموش.
   * پلاریته را با دیتاشیت IPM مطابقت دهید (`IPM_HIN_ACTIVE_LOW`/`IPM_LIN_ACTIVE_LOW`).
5. **مسیر Break:** پین FO (PB12) را با 1 k به GND بکشید ⇒ همه خروجی‌ها فوراً غیرفعال، وضعیت `FAULT`، `f=00000040`.
6. **ADC:** با منبع ولتاژ کوچک (≤ 3 V) روی خروجی تقسیم‌کننده‌ها و شنت، مقادیر را با `?` بخوانید.
7. **COMP2/cycle-by-cycle:** ولتاژ 0.4 V به `ISENSE` بدهید ⇒ پالس‌های PWM باید زودتر قطع شوند.

## مرحله ۲ — طبقه قدرت با ولتاژ پایین (منبع DC 30–60 V محدود به 1 A)

1. IPM و موتور را وصل کنید. باس را از منبع DC آزمایشگاهی (نه برق شهر) به `VBUS`/`PGND` بدهید.
2. موقتاً در `app_config.h`: `VBUS_START_MIN_V 25`، `VBUS_UV_V 20`. (برای IPM، VCC همچنان 15 V است.)
3. `run` و `spd 600`. در تله‌متری: `st=ALIGN → RAMP → RUN`، `zc` بالا رود و `fc` (کموتاسیون اجباری) نزدیک صفر.
4. با پراب دیفرانسیل ولتاژ یک فاز و جریان (پراب جریان) را ببینید: شکل باید شبیه `docs/img/sim_waveforms.png` باشد.
5. ترمینال‌های موتور را جابه‌جا نکنید؛ برای عکس‌کردن جهت از `dir 1` استفاده کنید.

## مرحله ۳ — ولتاژ کامل با Variac

1. پارامترهای مرحله ۲ را برگردانید. Variac را از 0 بالا ببرید؛ در ~165 VAC (≈ 230 V باس) رله باید ببندد
   (`bus ready`).
2. بدون بار، سپس با بار، سرعت را مرحله‌ای بالا ببرید. دمای IPM را با `T=` و دماسنج IR پایش کنید.
3. تست‌های حفاظتی: قفل‌کردن محور (باید Stall یا محدودیت جریان بدهد، نه انفجار)، قطع ناگهانی برق در دور بالا،
   کاهش سریع سرعت (پایش `vb=`؛ نباید از 405 V عبور کند — در غیر این صورت `SPEED_SLEW_RPM_S` را کم کنید یا ترمز اضافه کنید).

## چک‌لیست چیدمان PCB

- [ ] حلقه C4–P–IPM–N–شنت کمتر از 2 cm²
- [ ] زمین ستاره در پد منفی شنت؛ ترک Kelvin جدا برای `ISENSE` و `CIN`
- [ ] خزش ≥ 8 mm و اسلات زیر ISO7721؛ هیچ مسی از سمت Hot زیر سمت ایزوله نرود
- [ ] فاصله ≥ 3 mm بین نت‌های `VBUS`، `MOT_x`، `PGND`؛ ≥ 2.5 mm بین HV و منطق
- [ ] تقسیم‌کننده‌های HV در یک خط مستقیم؛ سه مقاومت سری؛ conformal coating
- [ ] خازن‌های بوت‌استرپ و دکاپلینگ VCC چسبیده به پین‌های IPM
- [ ] هیت‌سینک به PE؛ NTC روی هیت‌سینک کنار IPM
- [ ] Y-cap ها به همان نقطه PE هیت‌سینک
- [ ] مقاومت‌های pull روی شش ورودی IPM به سمت سطح غیرفعال

## عیب‌یابی سریع

| علامت | علت محتمل | اقدام |
|---|---|---|
| `start refused` | Vbus < 230 V یا خطای ثبت‌شده | `clr`، چک Vbus |
| در RAMP می‌ماند و تلاش مجدد | BEMF ضعیف/Ke اشتباه، جریان رمپ نامناسب | بخش ۲.۷؛ `RAMP_I_A`، `RAMP_ACC_HZ_S` |
| `f=00000010` (Stall) در سرعت بالا | دیماگ طولانی (L بزرگ، بار سنگین) | `COMM_ADV_DEG_PER_A` ↑، `I_LIMIT_RUN_A` ↓ |
| `f=00000040` (HW trip) | جریان > 15 A یا FO از UVLO/دمای IPM | جریان استارت، Vcc=15 V، بوت‌استرپ |
| `f=00000002` (OV) در کاهش سرعت | انرژی بازگشتی | `SPEED_SLEW_RPM_S` ↓ یا مقاومت ترمز |
| `fc` مدام بالا می‌رود | تقسیم‌کننده‌ها ناهم‌نسبت، نویز | نسبت 133 در هر چهار شاخه، خازن C0G |
