faragamco-eng/Multiact/hardware/calc/results.md

# Calculation results (generated by bldc_calc.py)

### 1. Power flow and DC bus

| quantity | value | note |
|---|---|---|
| motor input power | 852 W | shaft 750 W / eta 0.88 |
| drive input power | 879 W |  |
| Vbus nominal / min / max (no load) | 325 / 276 / 373 V | 230 VAC -15 %/+15 % |
| AC input current (worst, 195 VAC) | 7.5 A rms | PF 0.6 without PFC -> fuse 10 A T, CM choke >= 8 A |
| DC-link average current | 2.62 A |  |

### 2. Bulk capacitor

| quantity | value | note |
|---|---|---|
| C bulk | 940 uF | 2 x 470 uF / 450 V, 105 C, snap-in |
| 100 Hz ripple (p-p) at rated power | 28 V | valley ~297 V |
| capacitor ripple current (100 Hz part) | 7.0 A rms | 3.5 A per cap -> each cap rated >= 3.6 A @100 Hz/105 C (or 3 x 330 uF) |
| stored energy at 264 VAC | 66 J | inrush NTC must be rated for this C at 264 VAC |
| inrush peak with 5 ohm NTC (cold) | 75 A | bridge IFSM (GBU1006: 220 A) OK; relay bypasses NTC after charge |
| bleeder 2 x 100 k (series) time to < 60 V | 344 s | 0.70 W total |

### 3. Phase current (six-step, 120 deg conduction)

| quantity | value | note |
|---|---|---|
| duty at rated speed | 0.59 | BEMF + IR drop |
| flat-top phase current | 4.44 A | I = P / (Vbus * d) |
| phase current rms | 3.62 A | I * sqrt(2/3) |
| bus BEMF line peak at rated speed | 180 V |  |

### 4. IPM losses and heatsink

| quantity | value | note |
|---|---|---|
| conduction loss (whole module) | 9.3 W | PWM-leg IGBT d, its low diode 1-d, low-leg IGBT 100 % |
| switching + recovery loss | 3.6 W | one leg switches at a time |
| total IPM loss | 12.9 W |  |
| bridge rectifier loss | 5.0 W | mount on the same heatsink |
| hottest IGBT loss | 4.5 W | low-leg IGBT conducts the full 120 deg |
| max case temperature for Tj = 125 C | 111 C |  |
| required heatsink Rth(s-a) | <= 3.2 K/W | choose <= 2.0 K/W for stall/overload margin |

### 5. Bootstrap supply (high side)

| quantity | value | note |
|---|---|---|
| min refresh window per period | 2.50 us | D_MAX = 0.96 |
| charge drawn per period | 69 nC |  |
| equilibrium droop through R_boot | 1.39 V | R_boot = 50 ohm |
| Vbs at max duty | 12.9 V | OK |
| C_boot (<= 0.5 V droop per period, x10 margin) | >= 1.4 uF | use 4.7 uF X7R 25 V + 100 nF; low-ON legs are refreshed by pre-charge |

### 6. Current sensing / protection

| quantity | value | note |
|---|---|---|
| shunt | 33 mOhm | 2 x 68 mOhm 2512 1 % in parallel |
| shunt loss at rated (rms bus ~ phase rms) | 0.43 W |  |
| IPM CIN hard trip current | 15.2 A | Vref(CIN) 0.5 V [DS] |
| COMP2 cycle-by-cycle limit | 10.0 A | DAC3 = 410 counts |
| ADC full scale (PGA x4) | 25.0 A | 6.1 mA / count |

### 7. Voltage / BEMF dividers

| quantity | value | note |
|---|---|---|
| divider ratio | 133.0 | 3 x 330 k (1206, 200 V each) + 7.5 k |
| ADC volts at 400 V | 3.01 V |  |
| bus volts per ADC count | 107 mV |  |
| voltage across each 330 k at 400 V | 133 V | 1206 working voltage 200 V; keep creepage |
| divider dissipation at 400 V | 160 mW |  |
| BEMF filter tau | 1.64 us | Rth 7.44 k, C 220 pF |
| BEMF at 300 rpm (min closed loop), phase | 9.0 V | 84 counts |

### 8. Auxiliary 15 V supply

| quantity | value | note |
|---|---|---|
| IPM VCC + gate drive | 8 mA |  |
| MCU 3.3 V via buck (40 mA @3.3 V, eta 0.8) | 11 mA |  |
| relay coil (12 V, 30 mA) | 30 mA |  |
| LEDs | 6 mA |  |
| isolator (field side) | 3 mA |  |
| total | 58 mA | LNK306DN buck (360 mA max) -> margin x5 |
| input power of aux supply | 1.2 W | eta ~75 % |
