faragamco-eng/Multiact/hardware/panel/out/cooler_panel_schematic.pdf

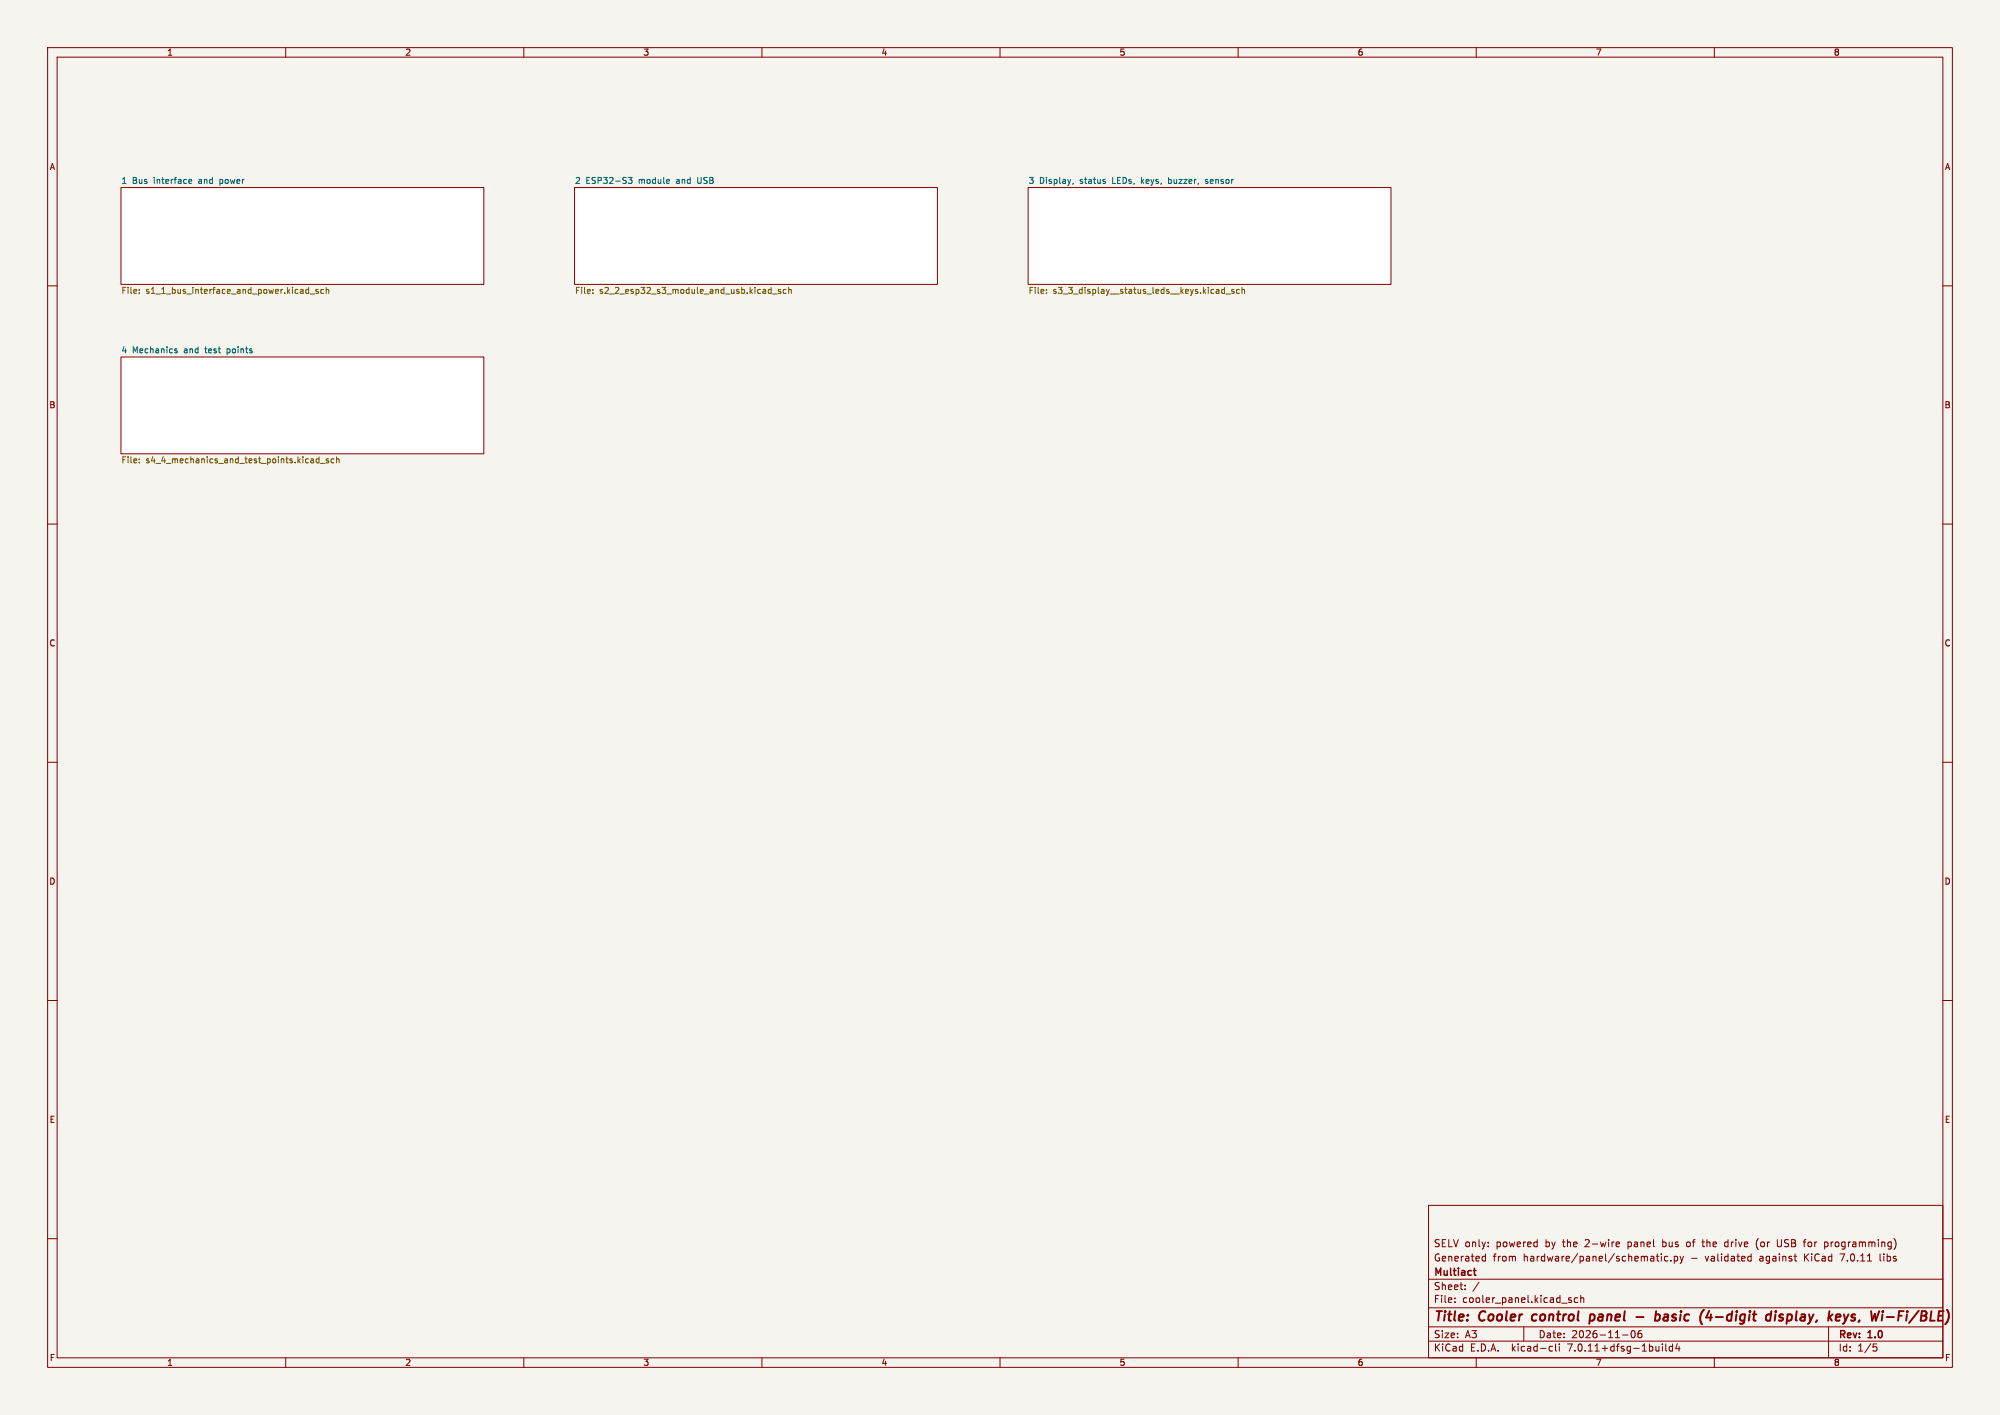
[picture p9: page 1]

3 Display, status LEDs, keys, buzzer, sensor File: s3_3_display__status_leds__keys.kicad_sch

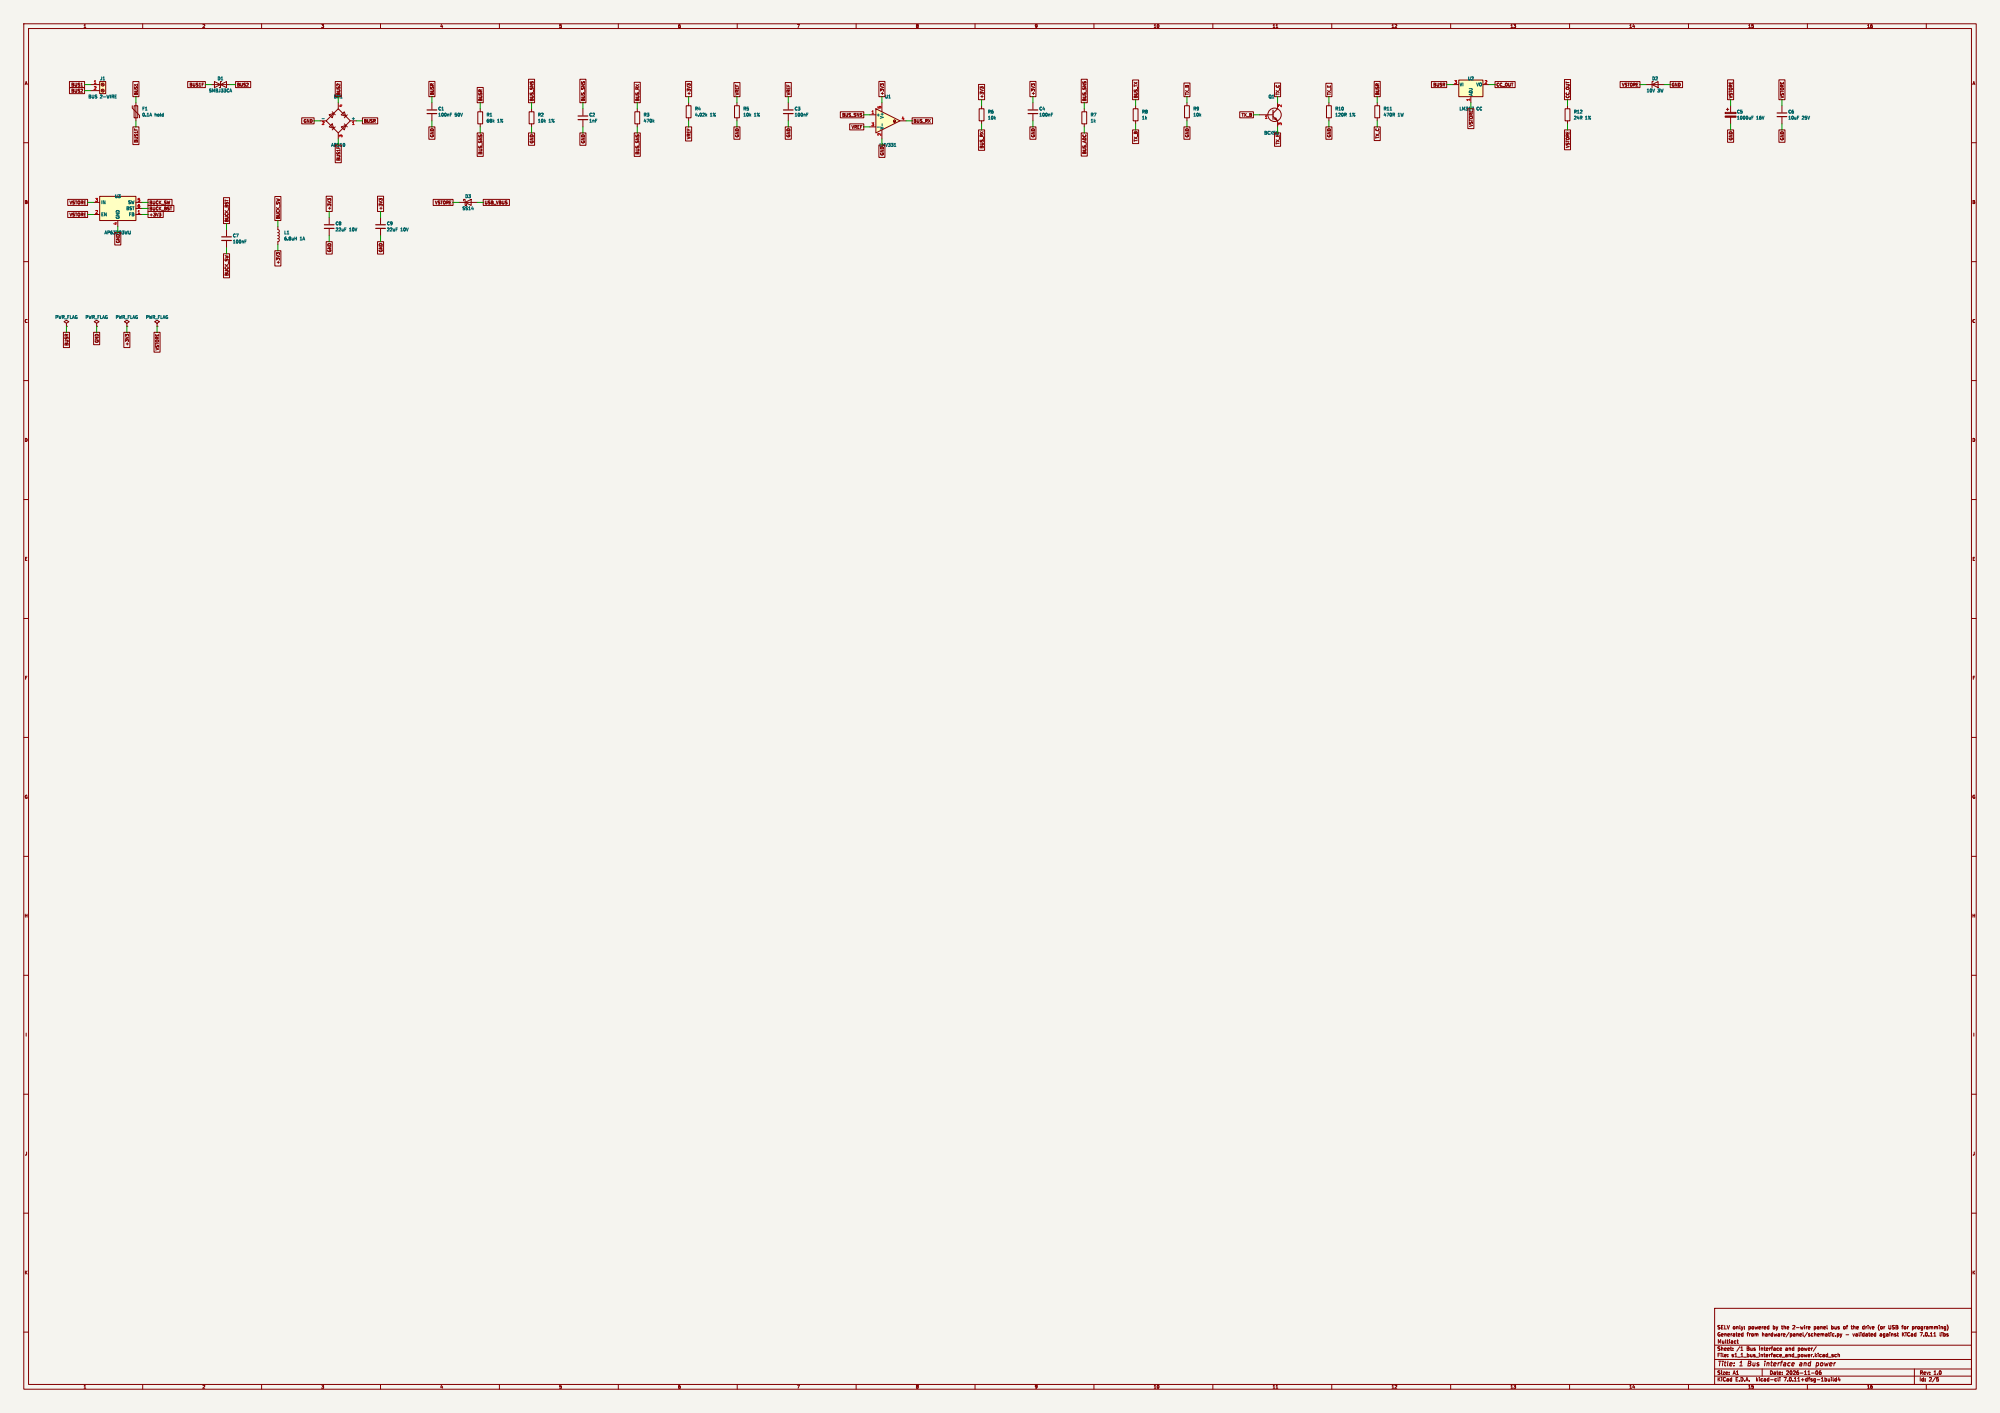
[picture p10: page 2]

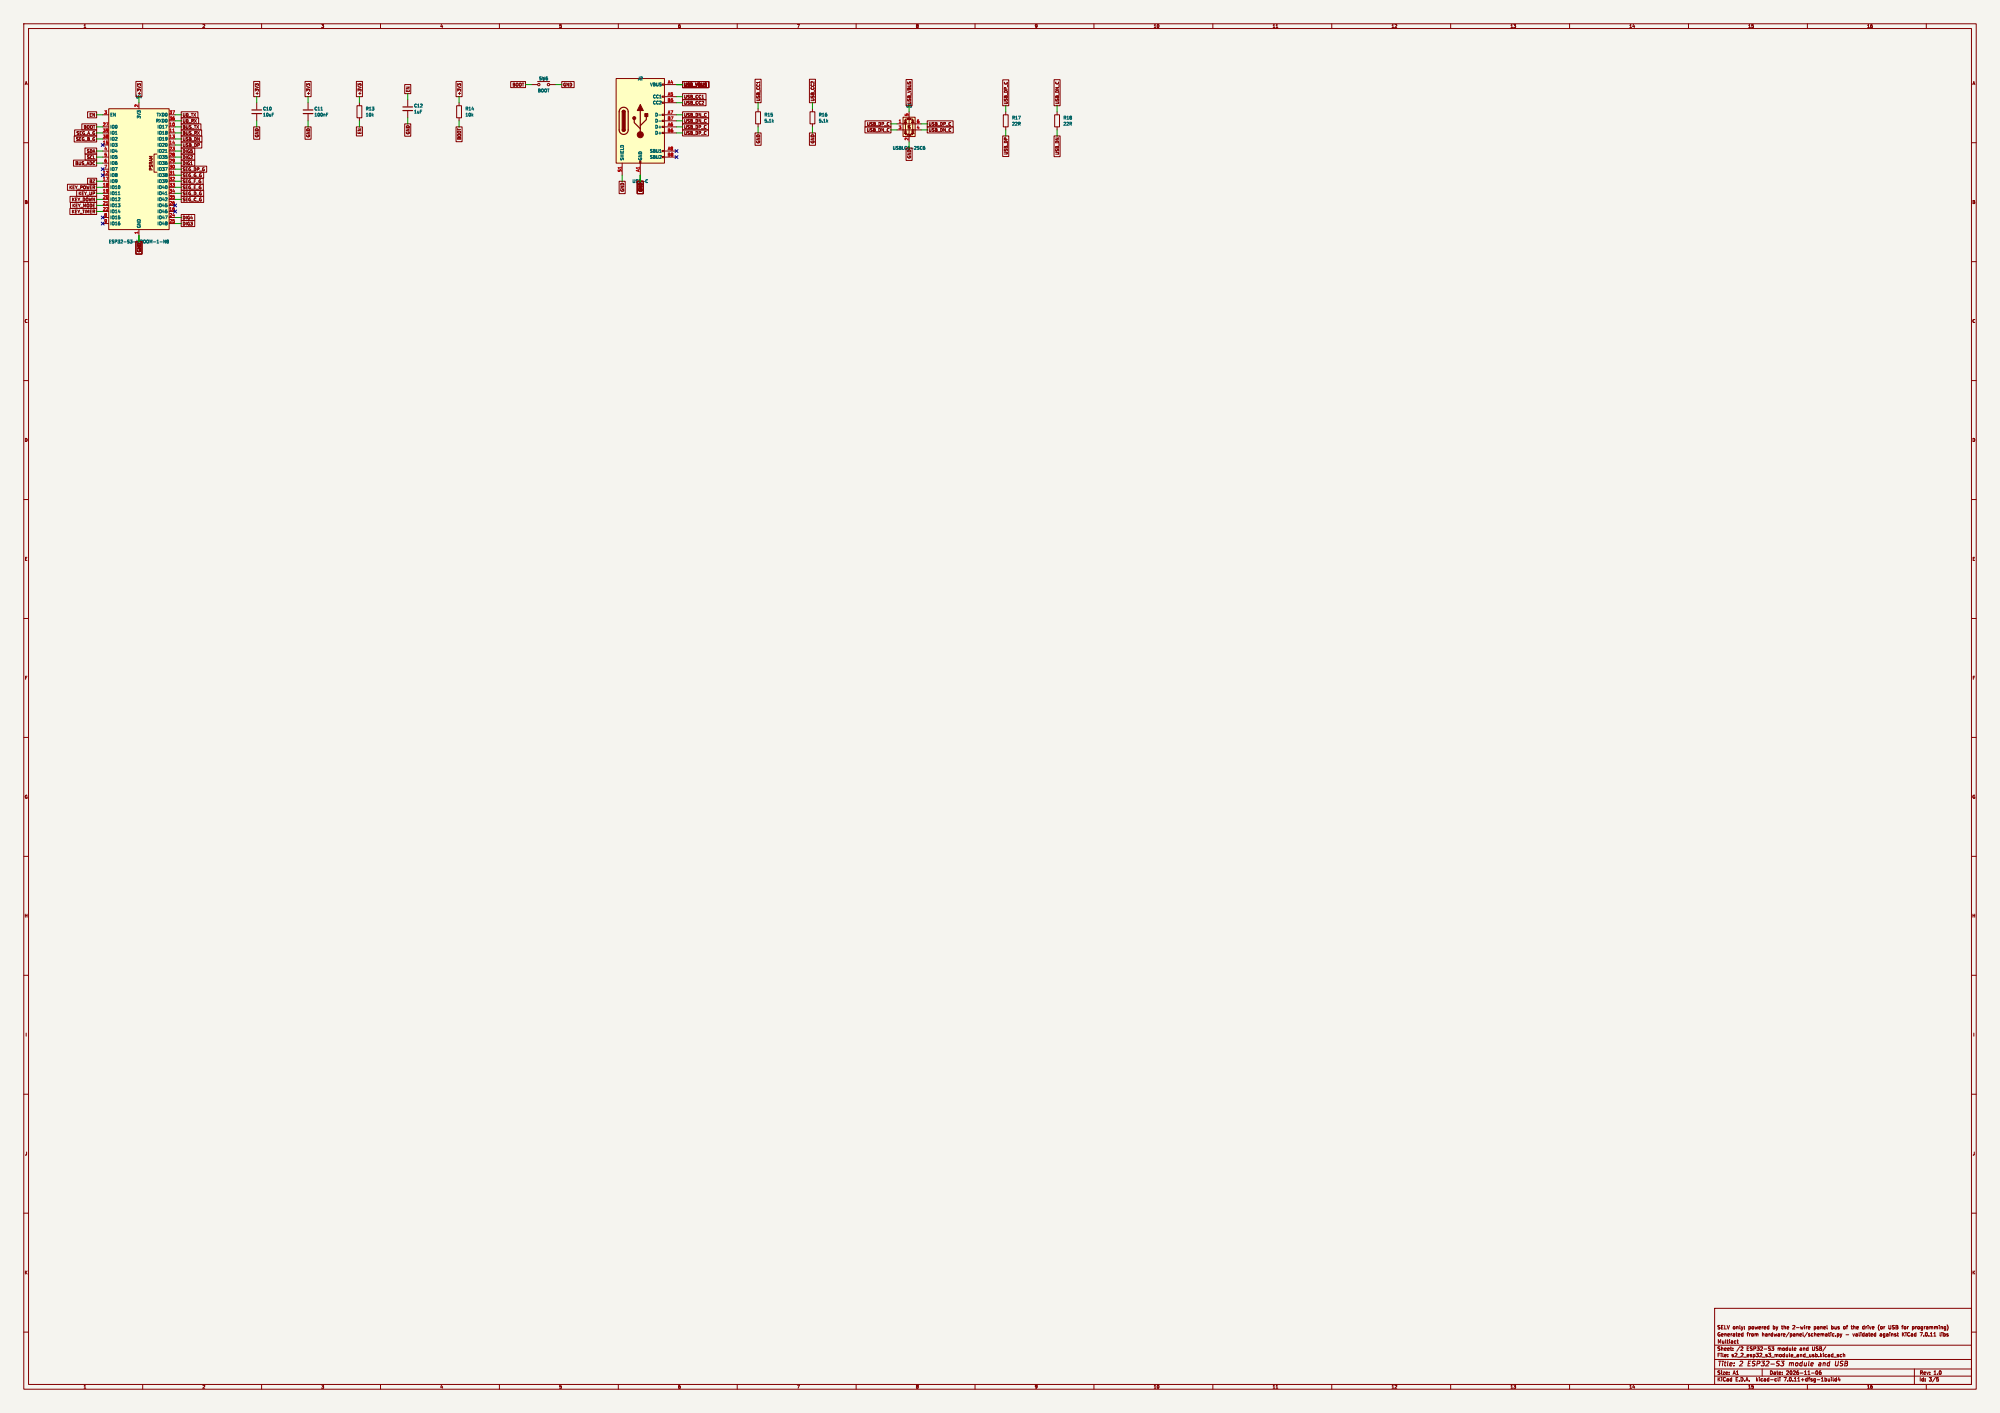
[picture p11: page 3]

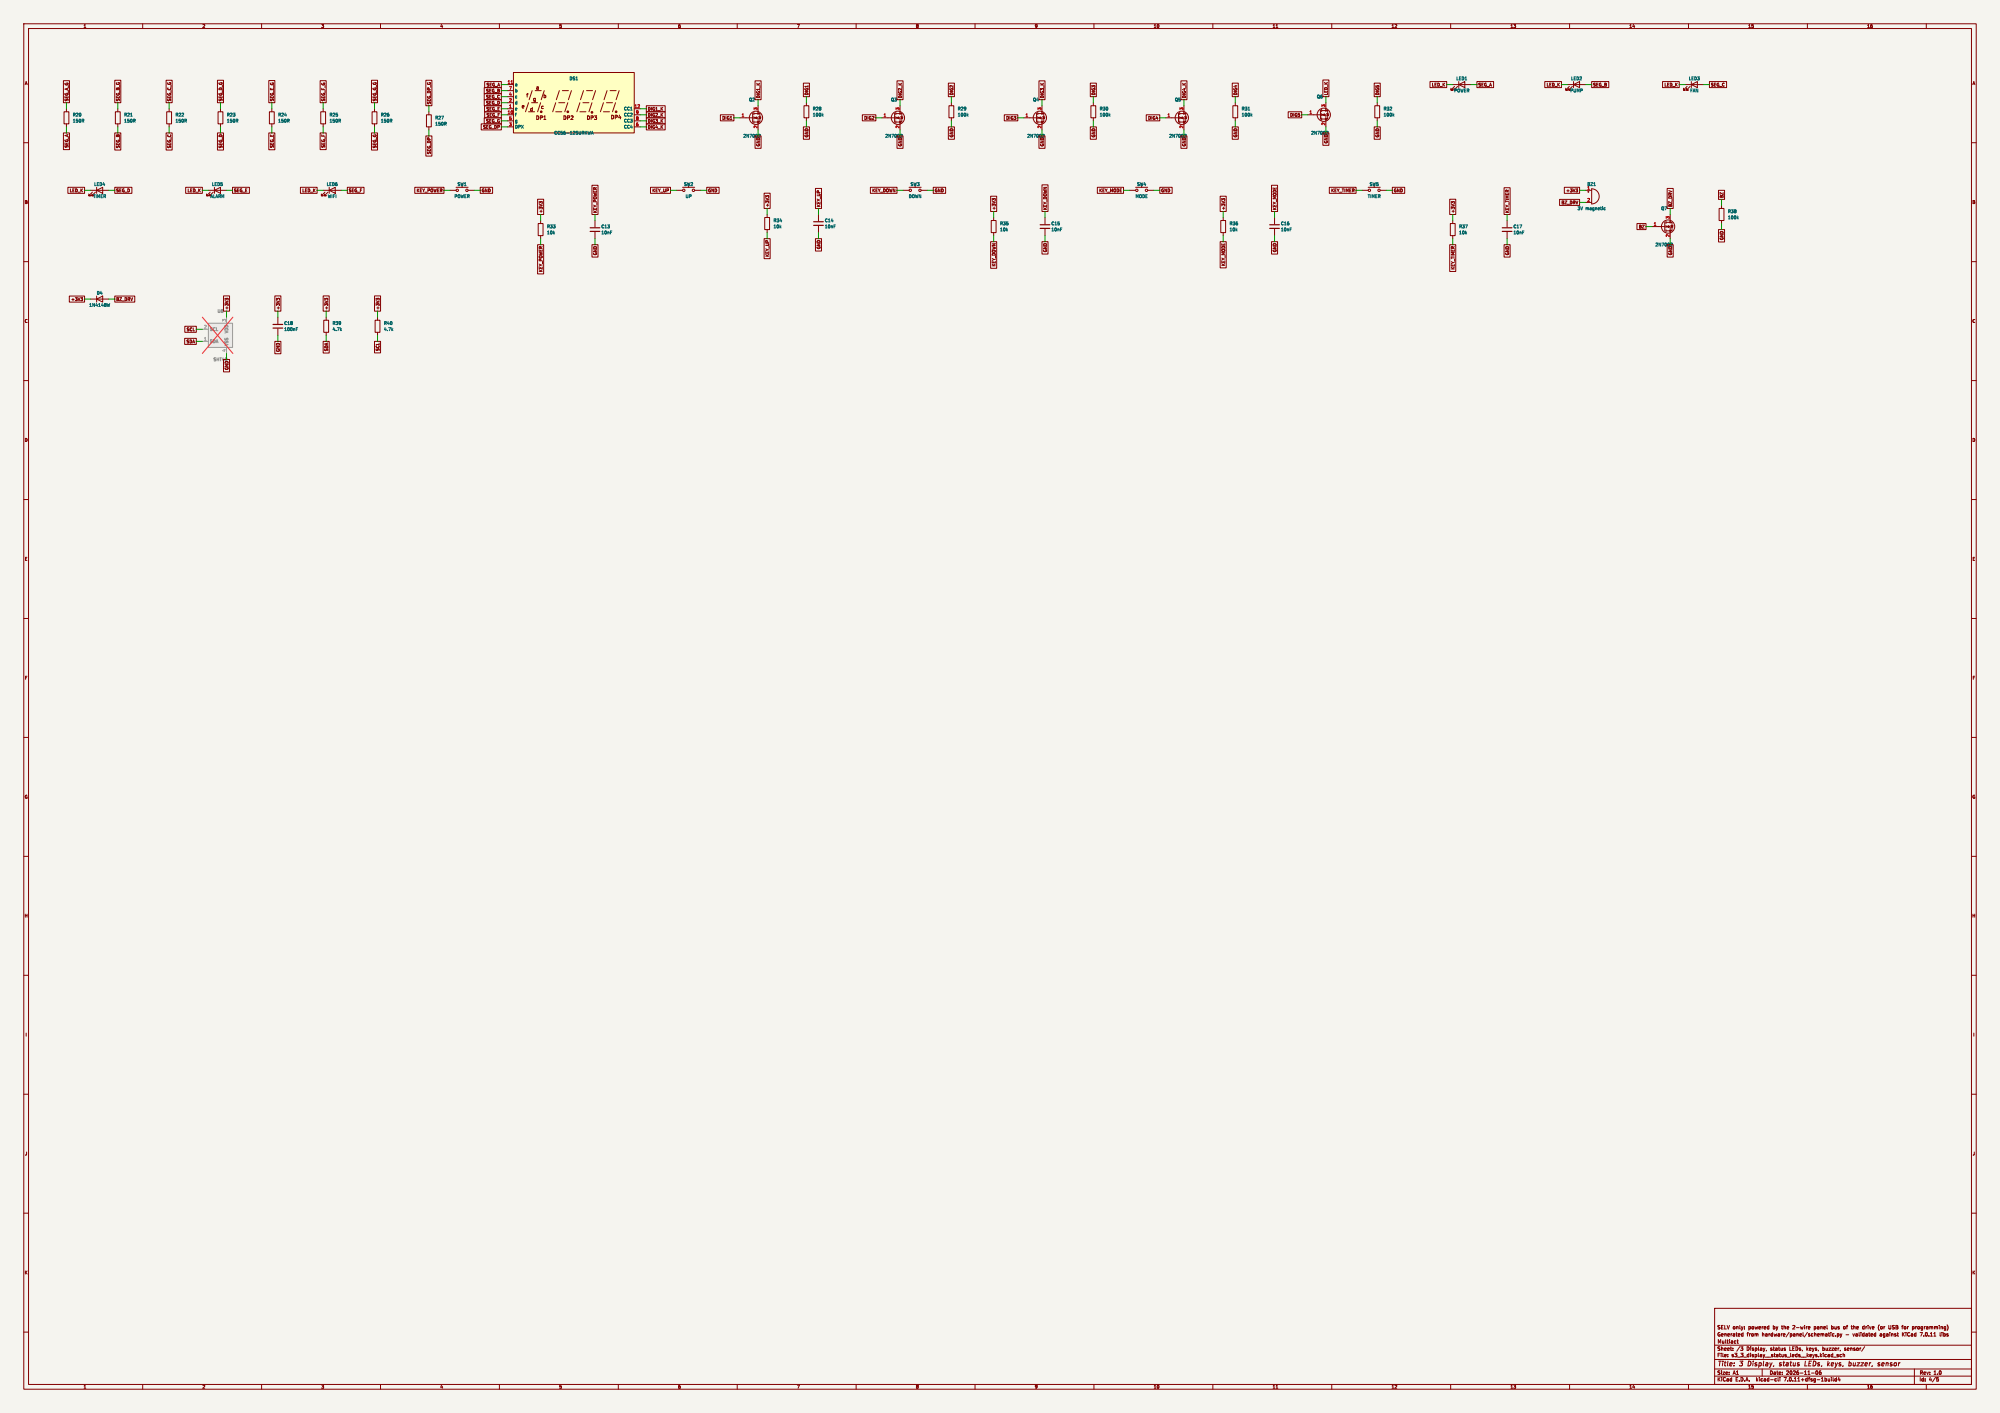
[picture p12: page 4]

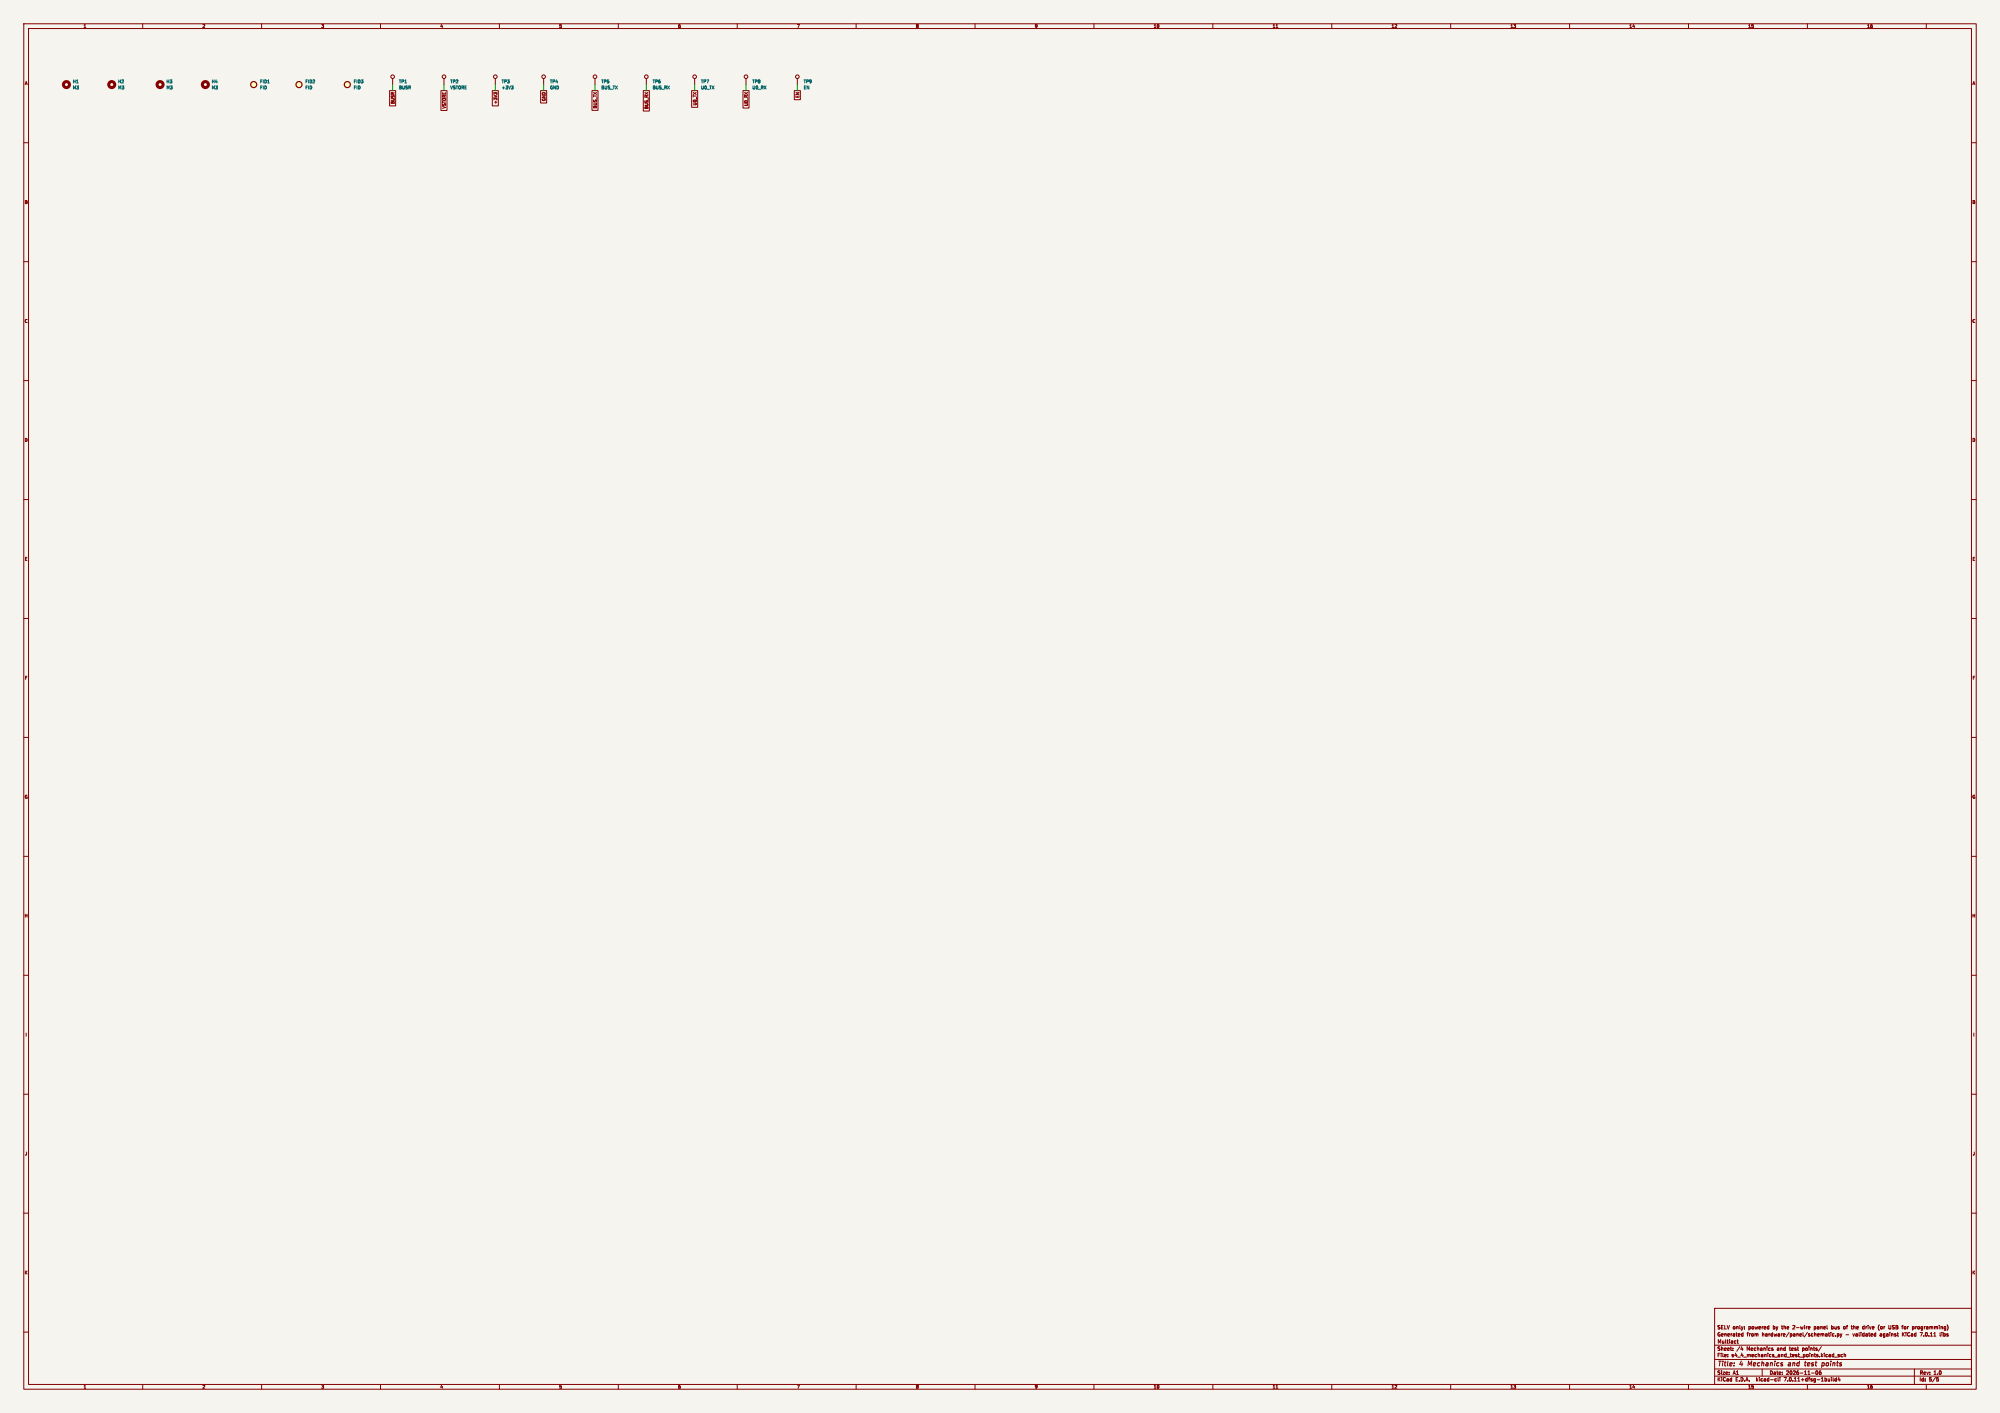
[picture p13: page 5]

Id: 5/5 Title: 4 Mechanics and test points
