faragamco-eng/Multiact/hardware/v2/out/bldc_cooler_v2_schematic.pdf

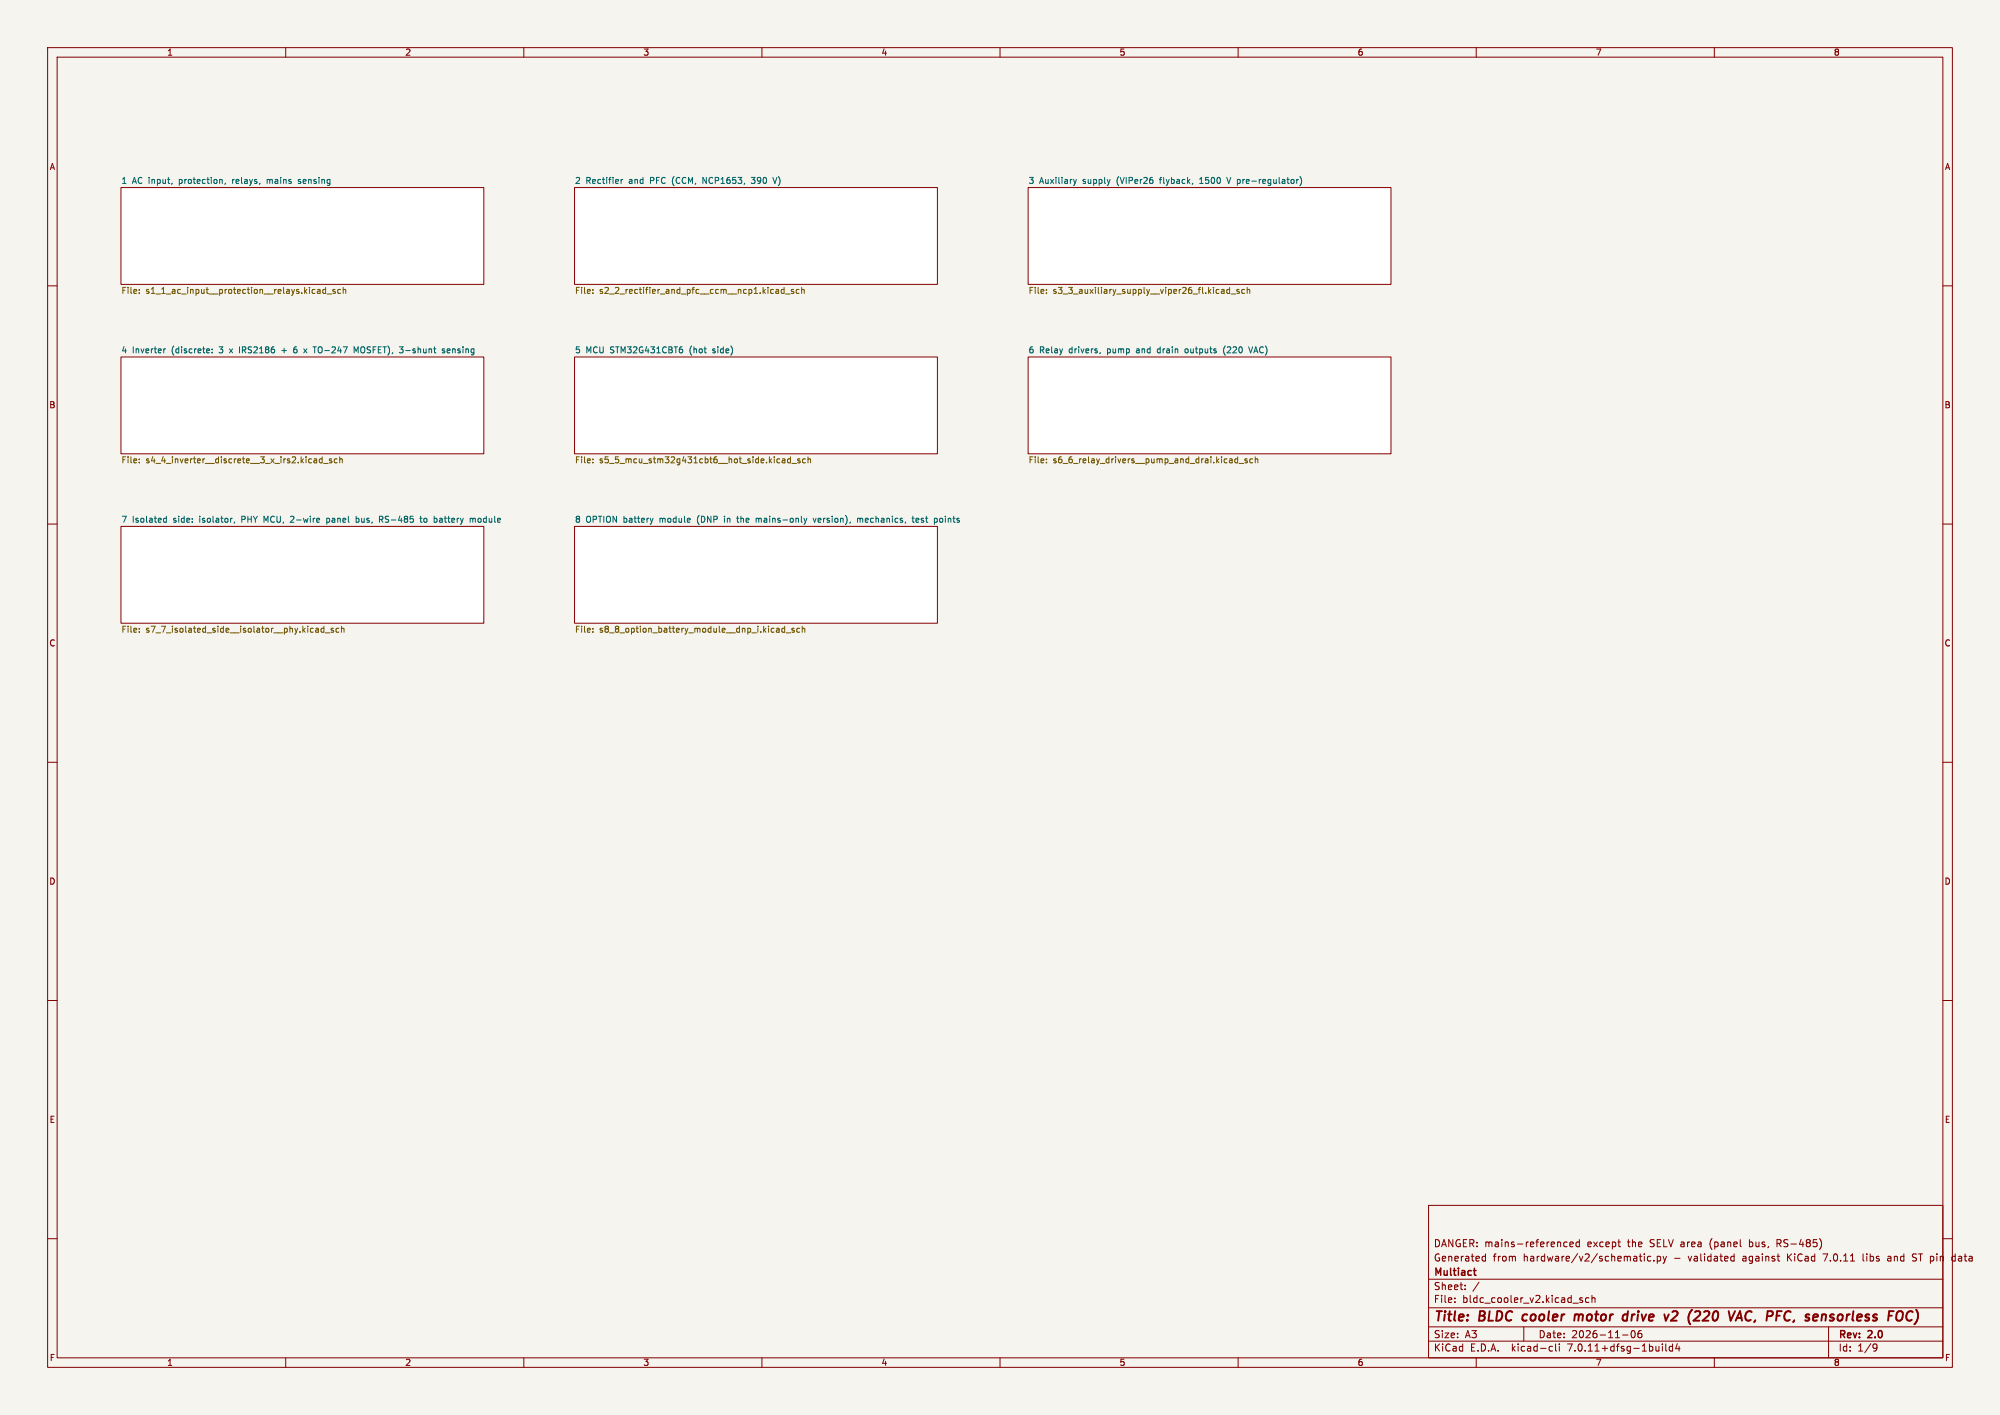
[picture p14: page 1]

5 MCU STM32G431CBT6 (hot side) File: s5_5_mcu_stm32g431cbt6__hot_side.kicad_sch

6 Relay drivers, pump and drain outputs (220 VAC) File: s6_6_relay_drivers__pump_and_drai.kicad_sch

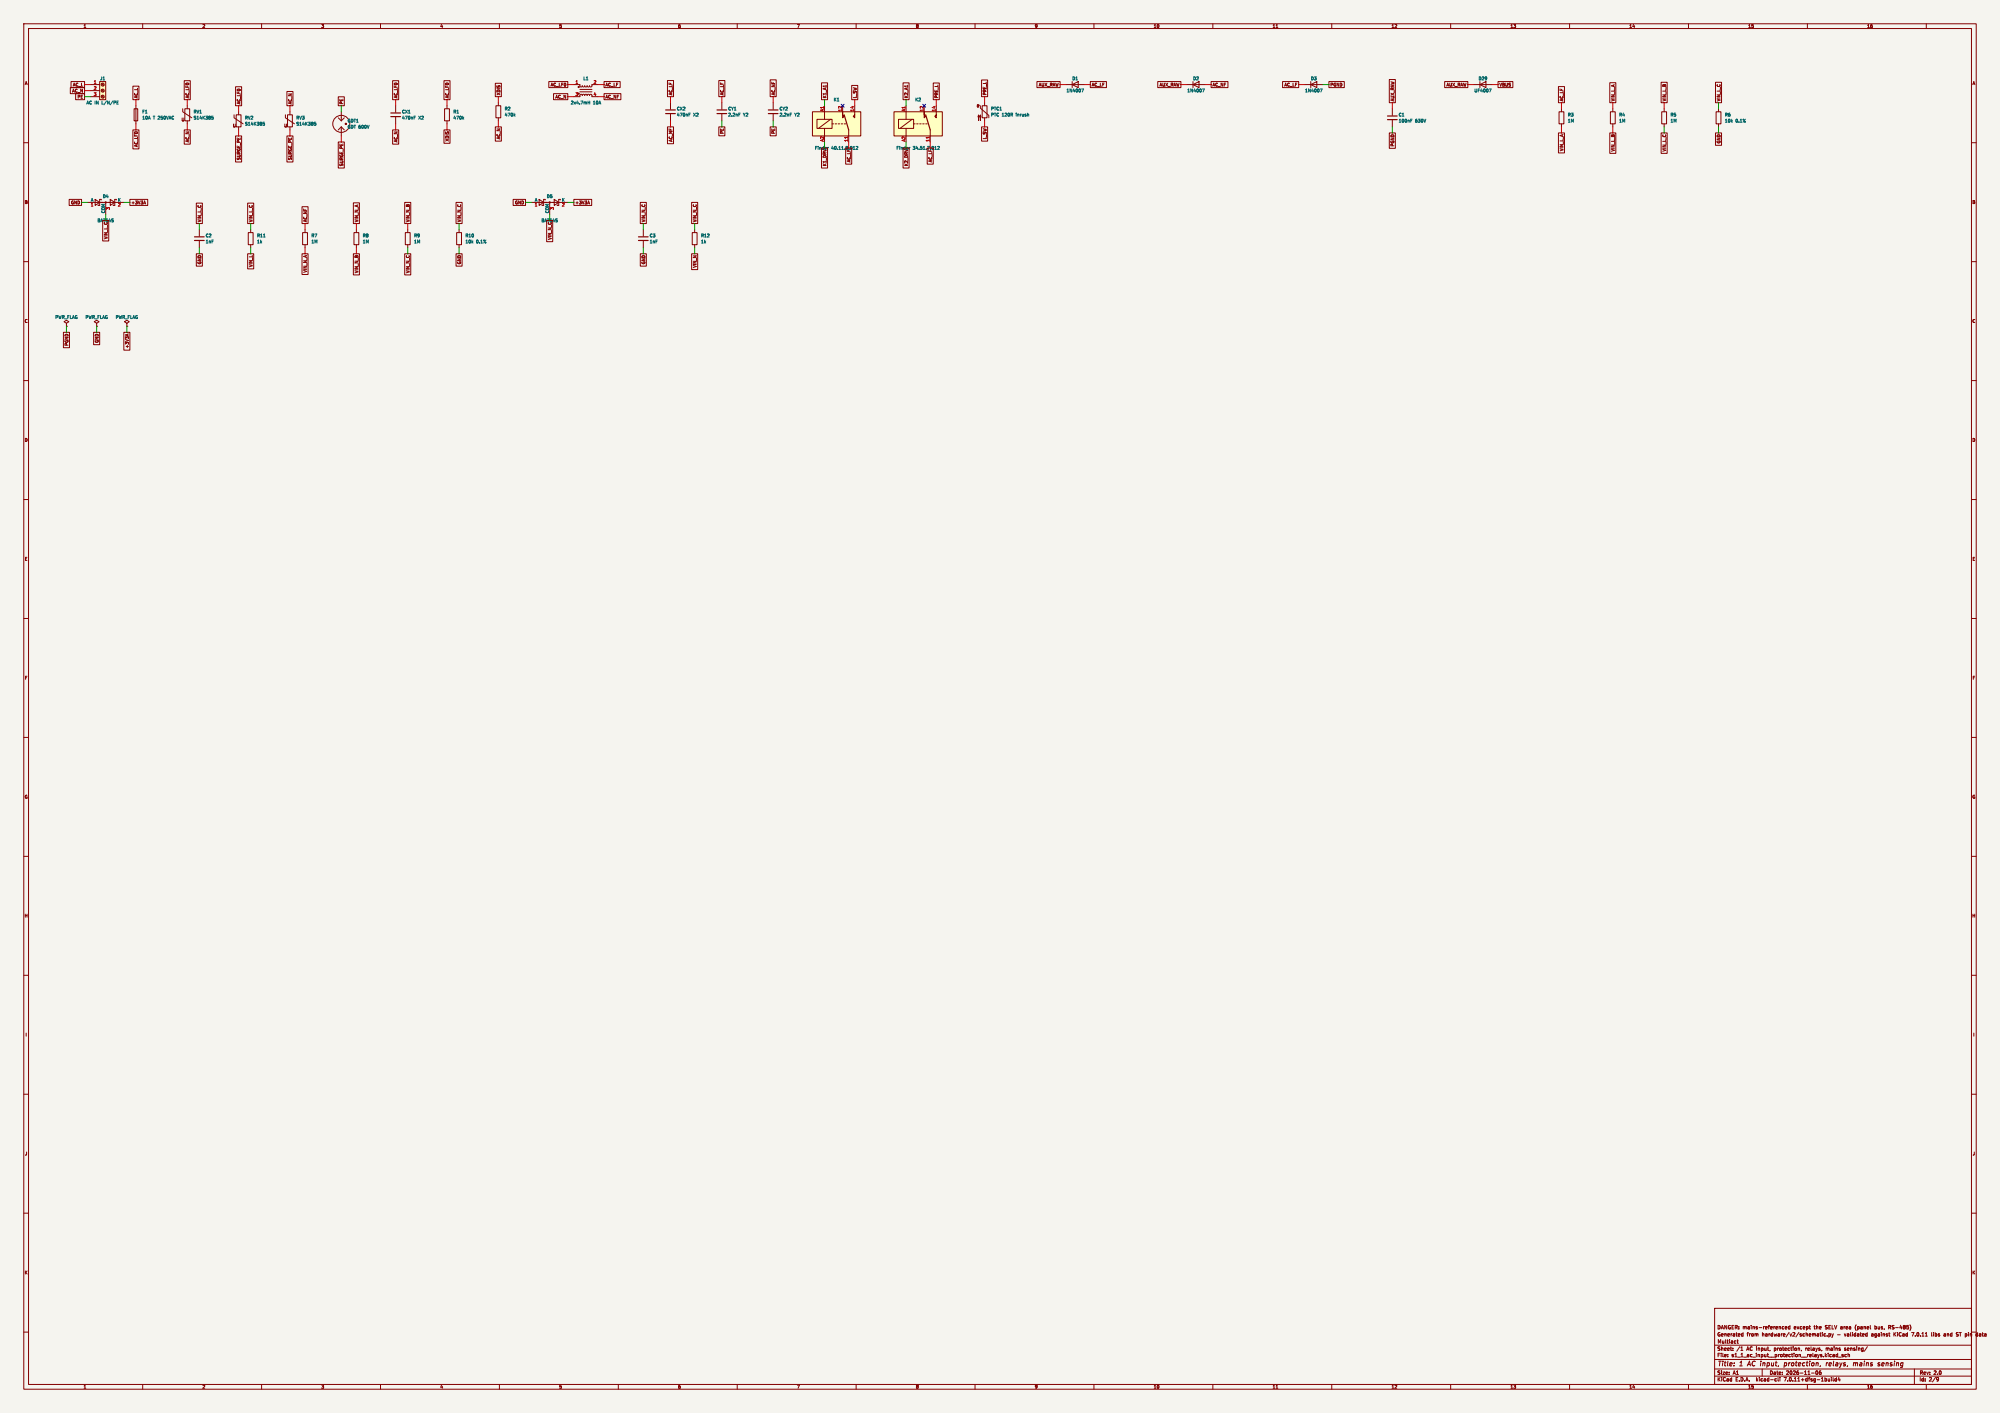
[picture p15: page 2]

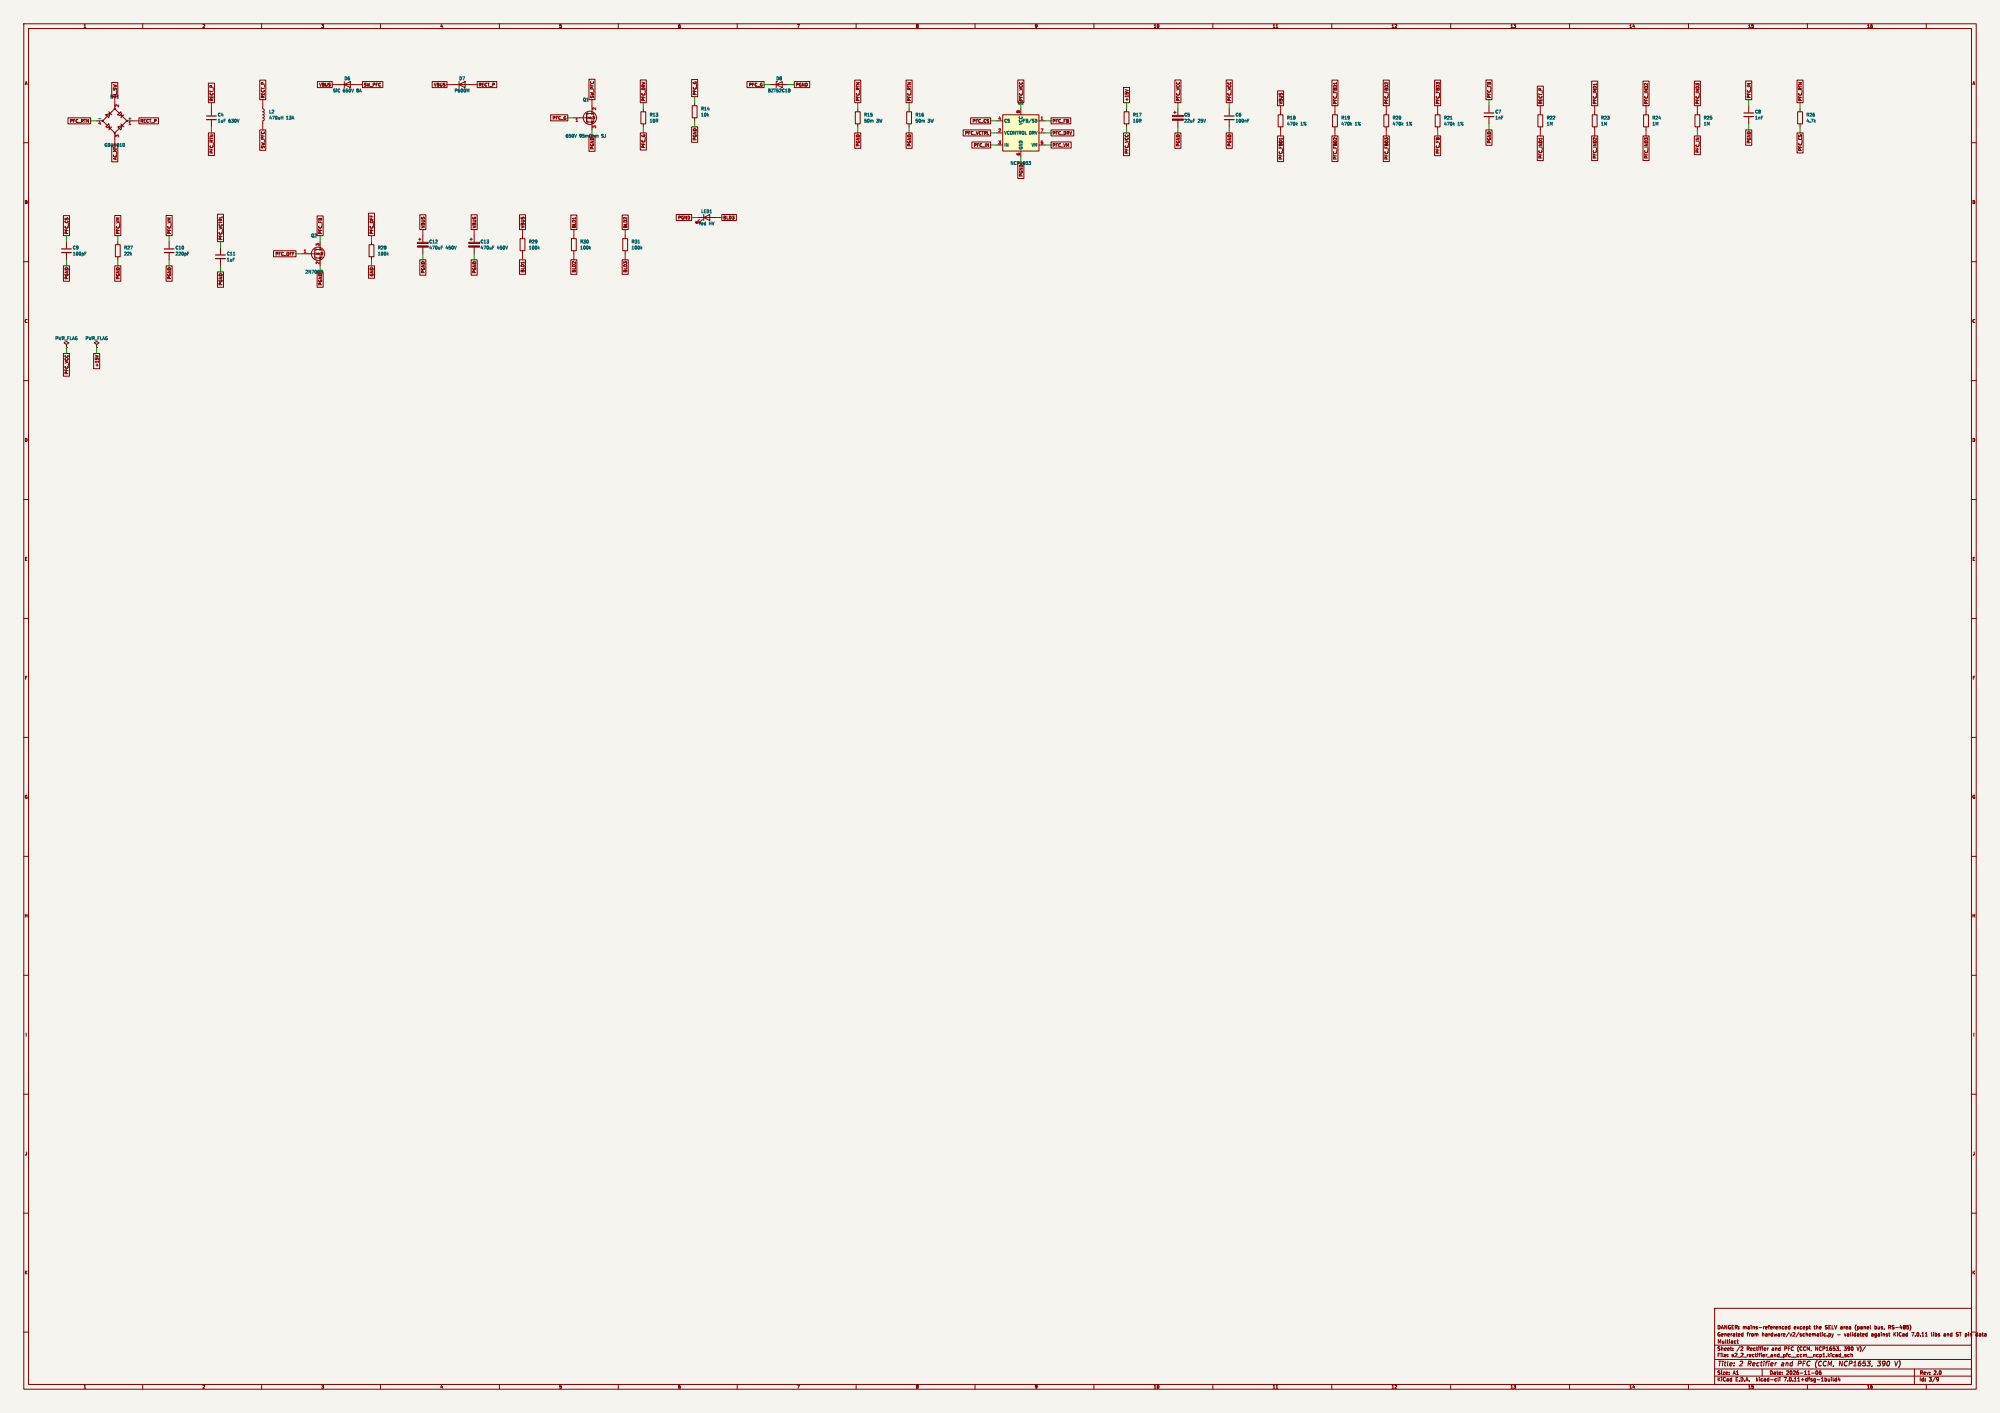
[picture p16: page 3]

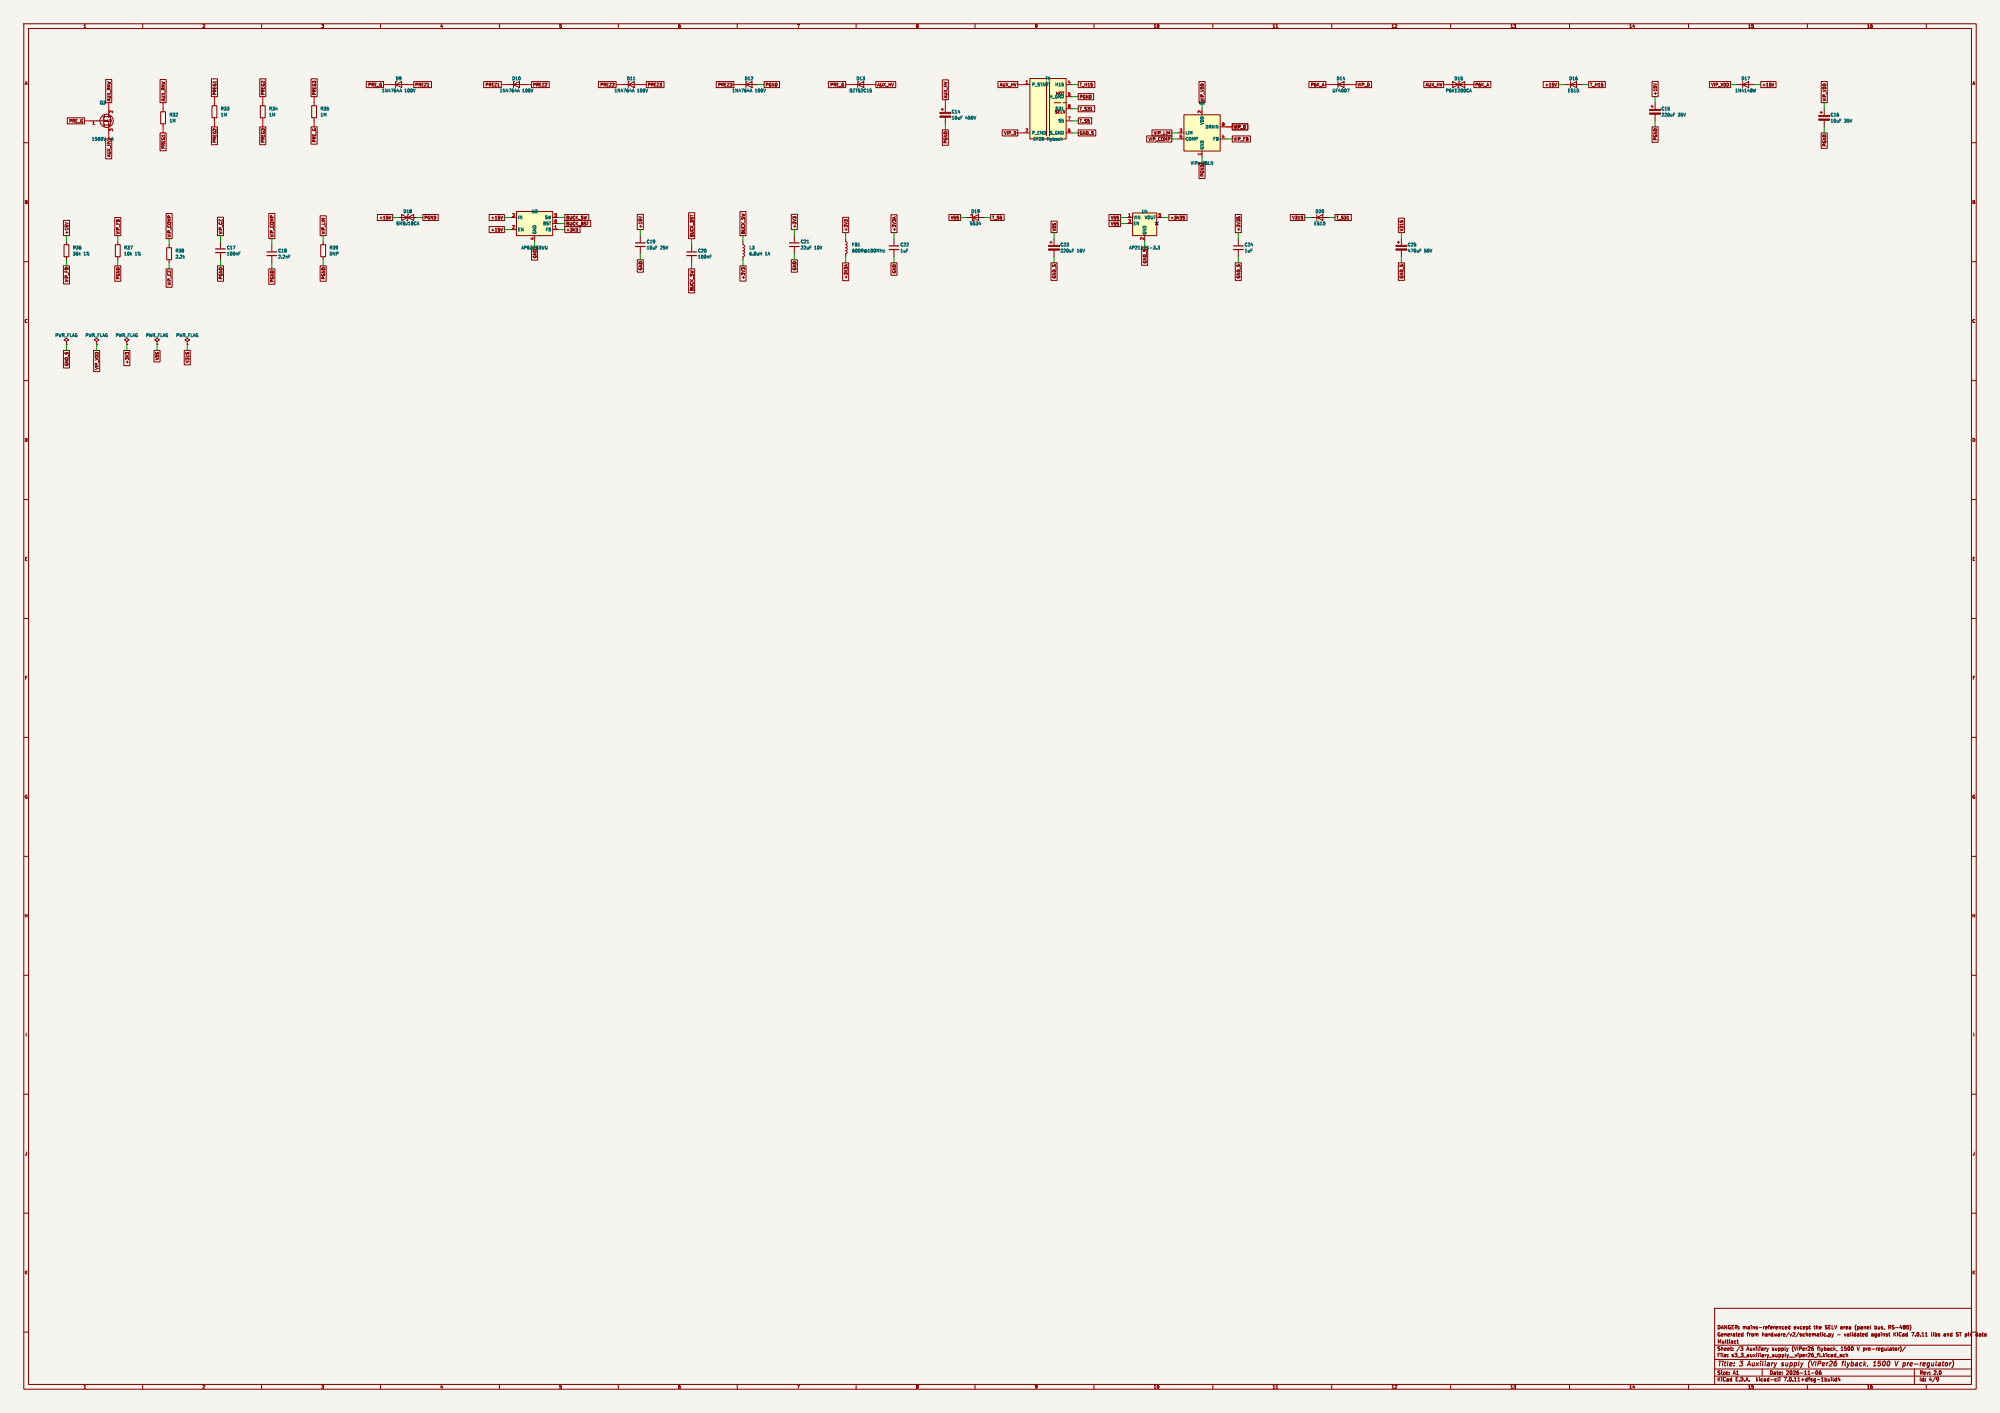
[picture p17: page 4]

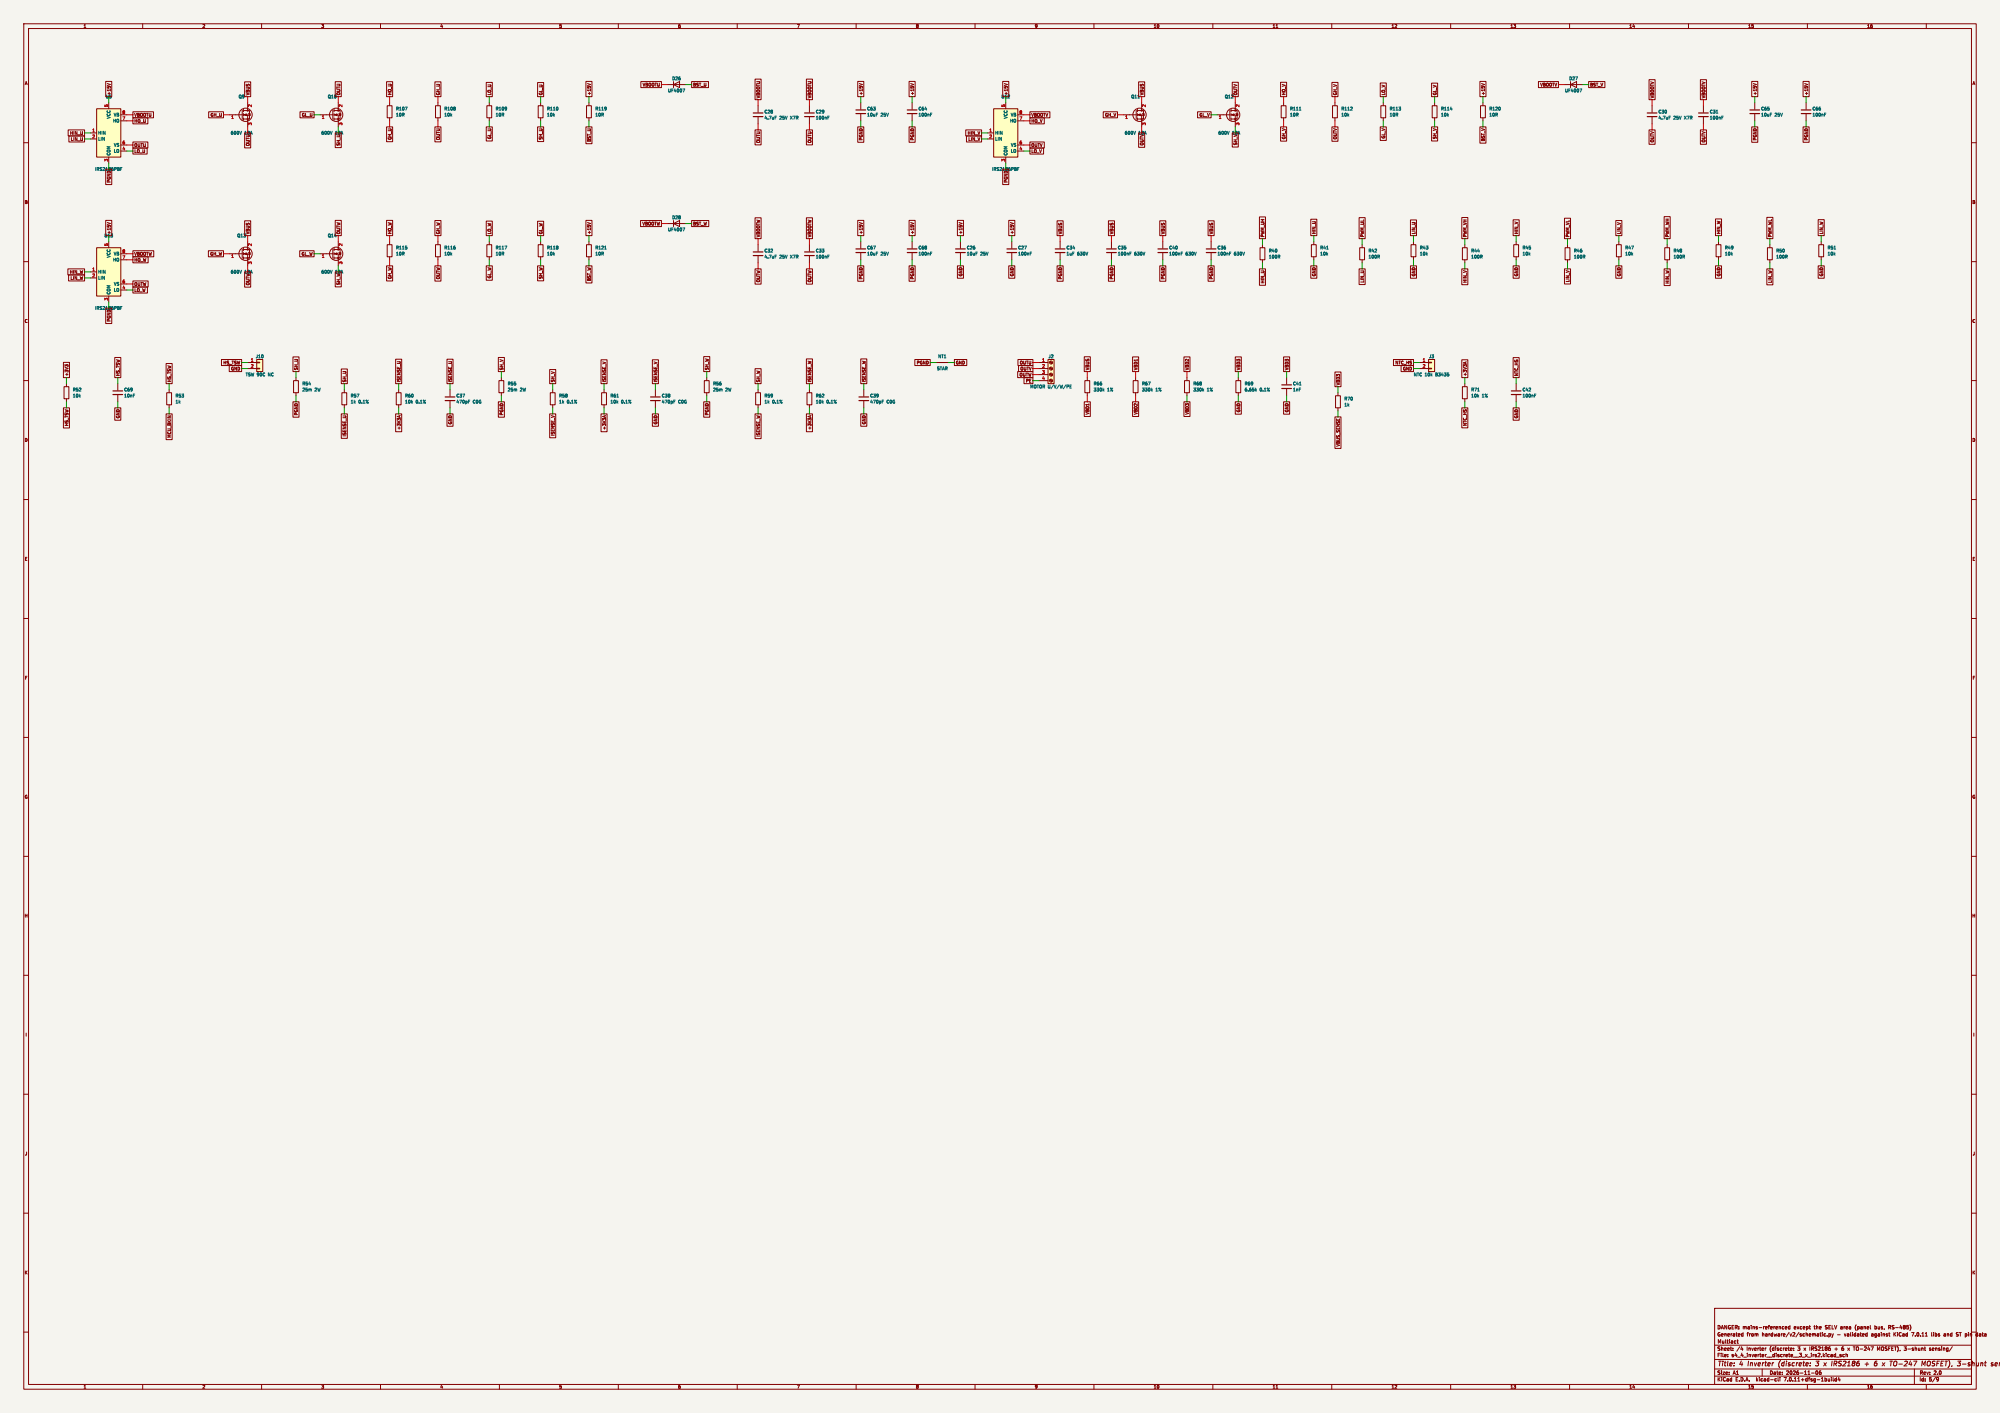
[picture p18: page 5]

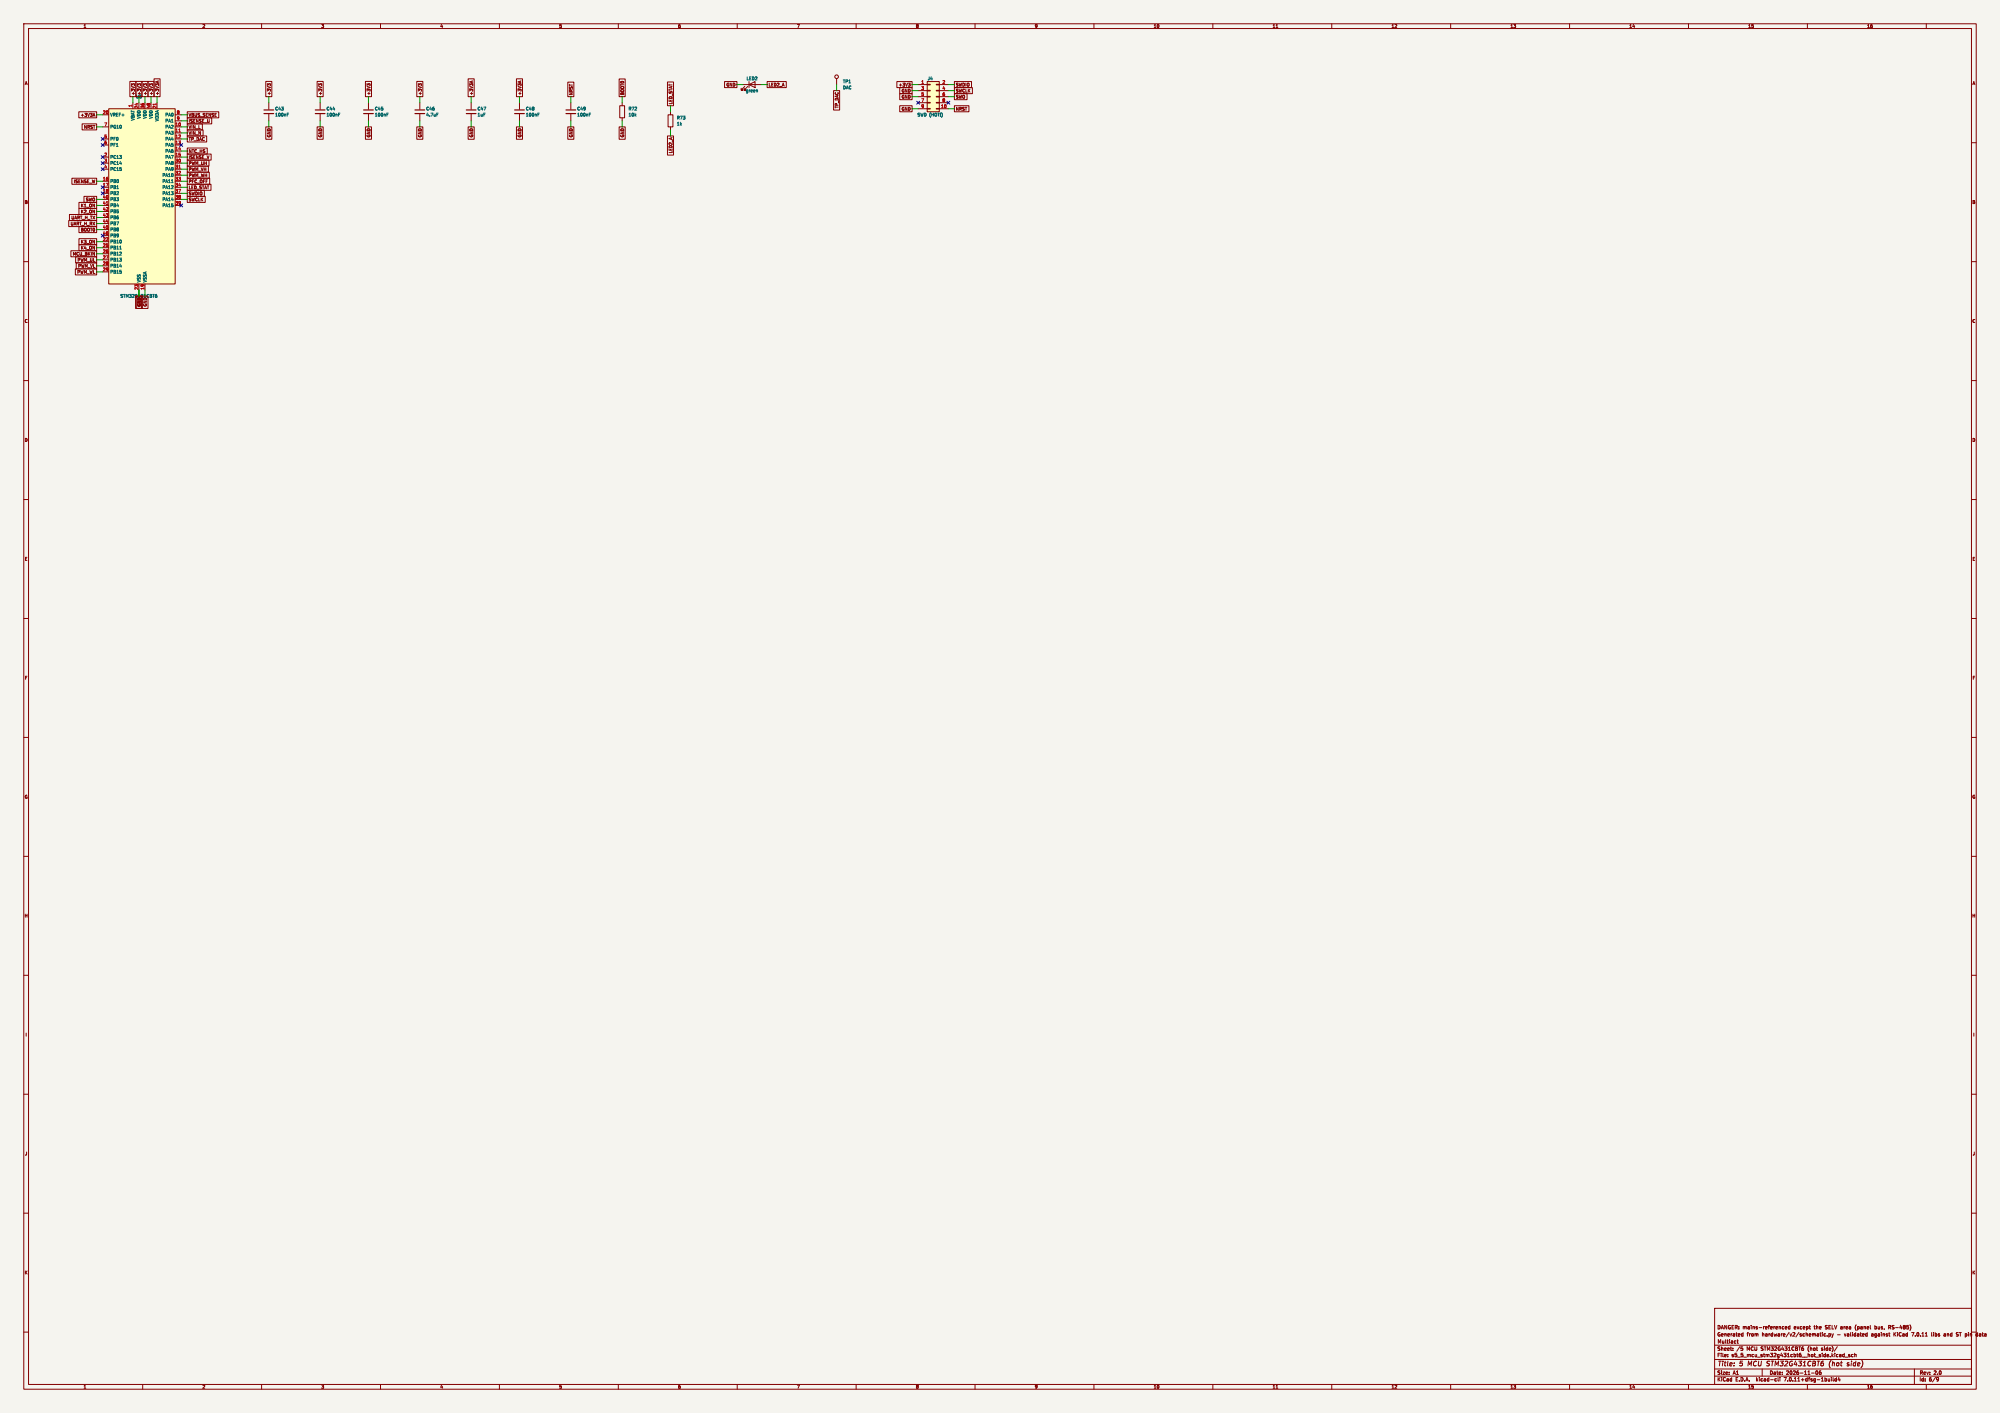
[picture p19: page 6]

1 PA2 10 PA3 11 PA4 12 PA5 13 PA6 14 PA7 15 PB0 16 PB1 17 PB2 18 VSSA 19 PC13 2 VREF+ 20 VDDA 21 PB10 22 VSS 23 VDD 24 PB11 25 PB12 26 PB13 27 PB14 28 PB15 29 PC14 3 PA8 30 PA9 31 PA10 32 PA11 33 PA12 34 VDD 36 PA13 37 PA14 38 PA15 39 PC15 4 PB3 40 PB4 41 PB5 42 PB6 43 PB7 44 PB8 45 PB9 46 VDD 48 PF0 5 PF1 6 PG10 7 PA0 8 PA1 9 U6 STM32G431CBT6

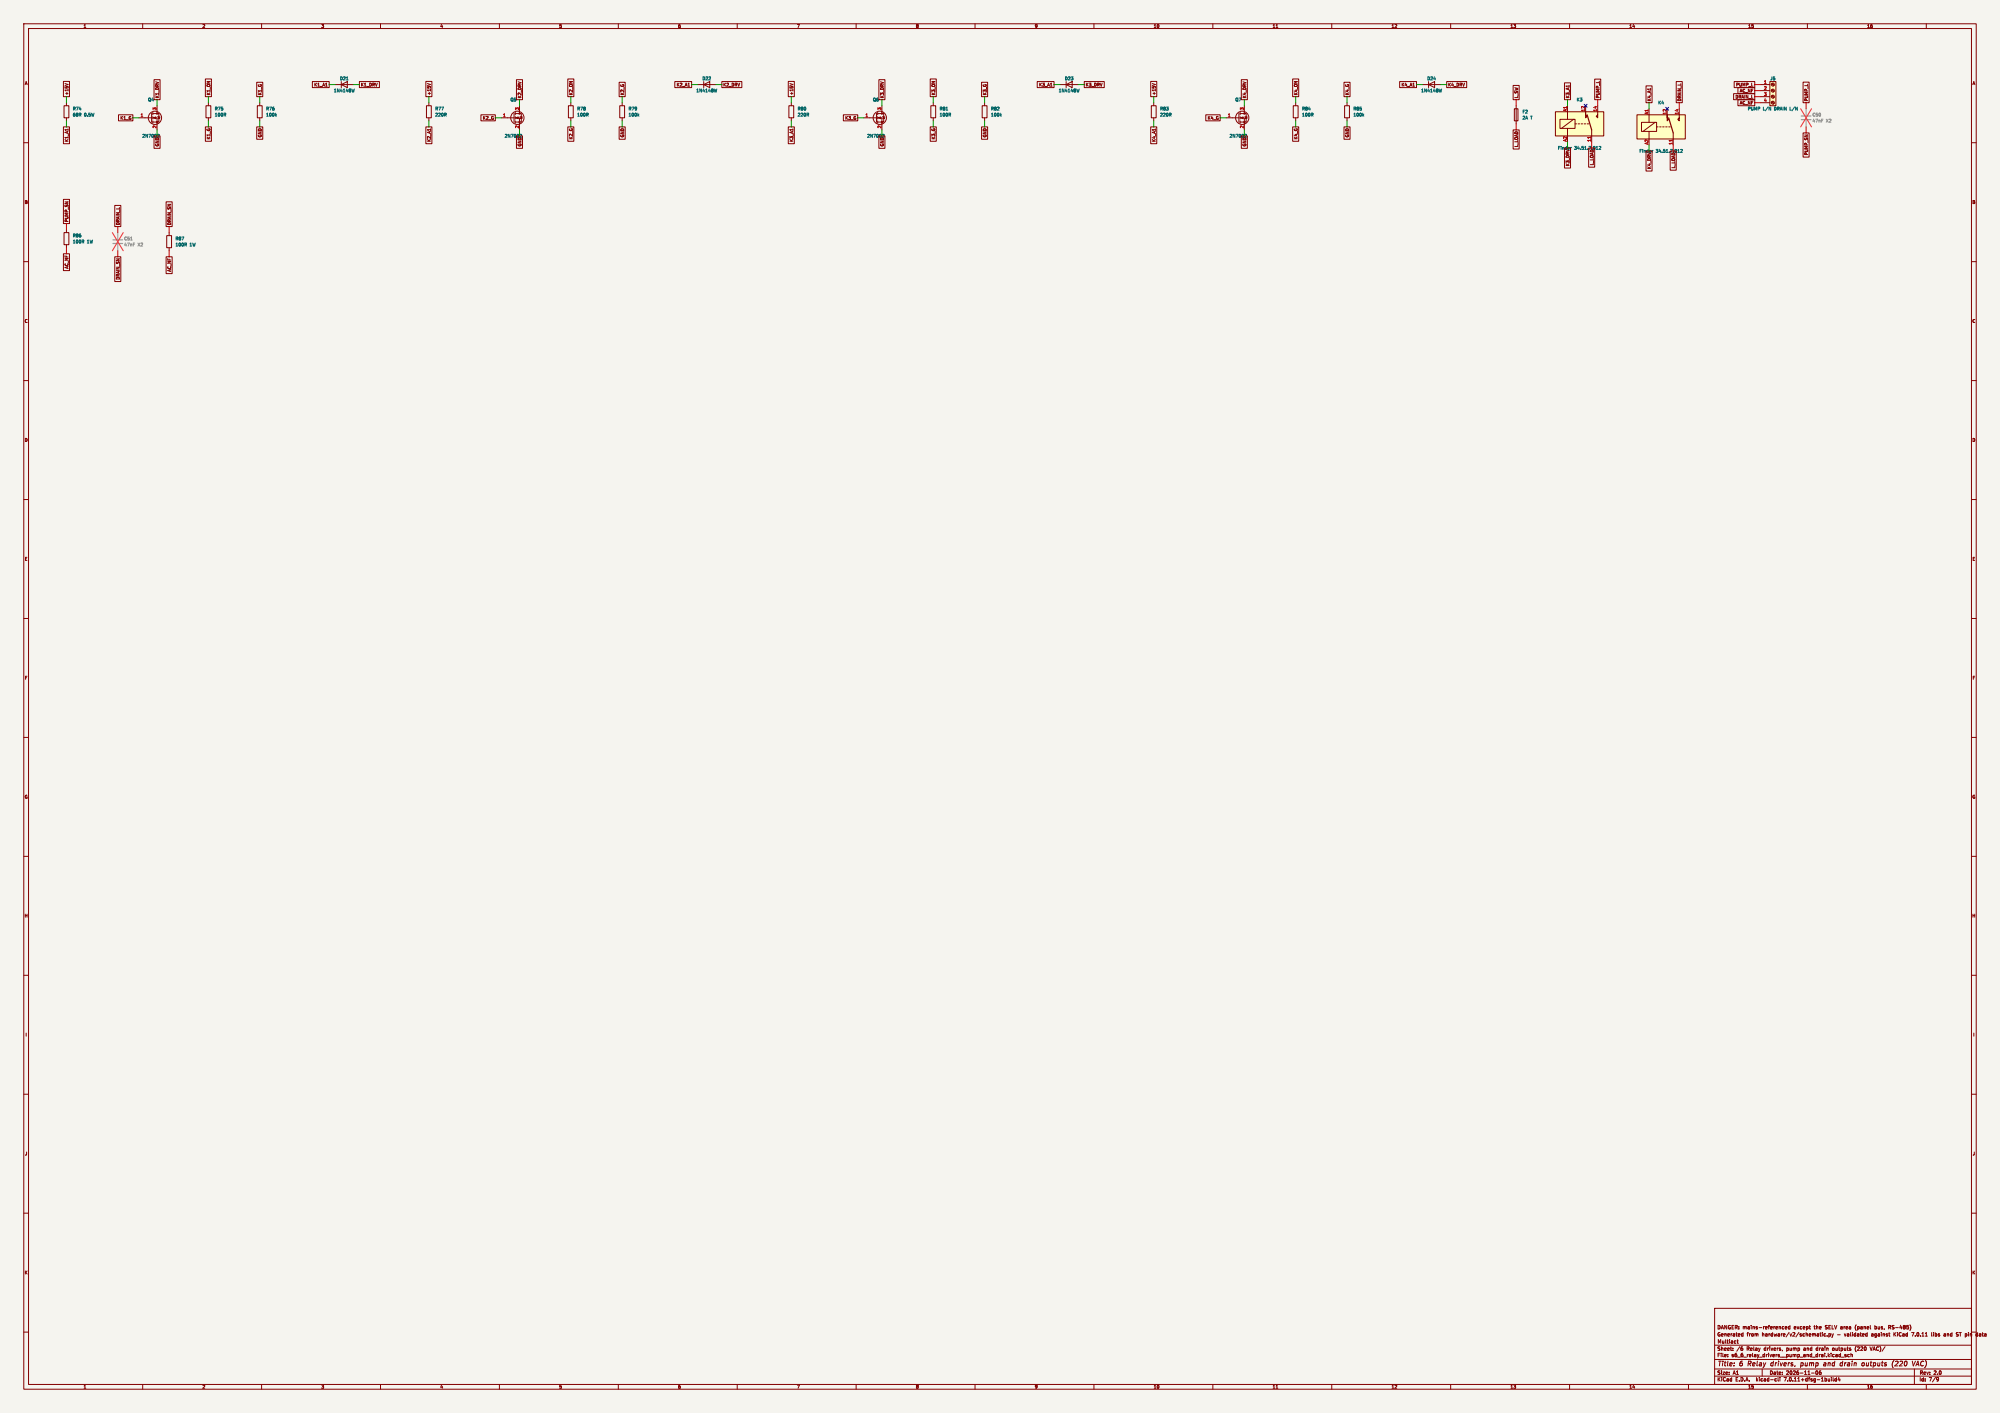
[picture p20: page 7]

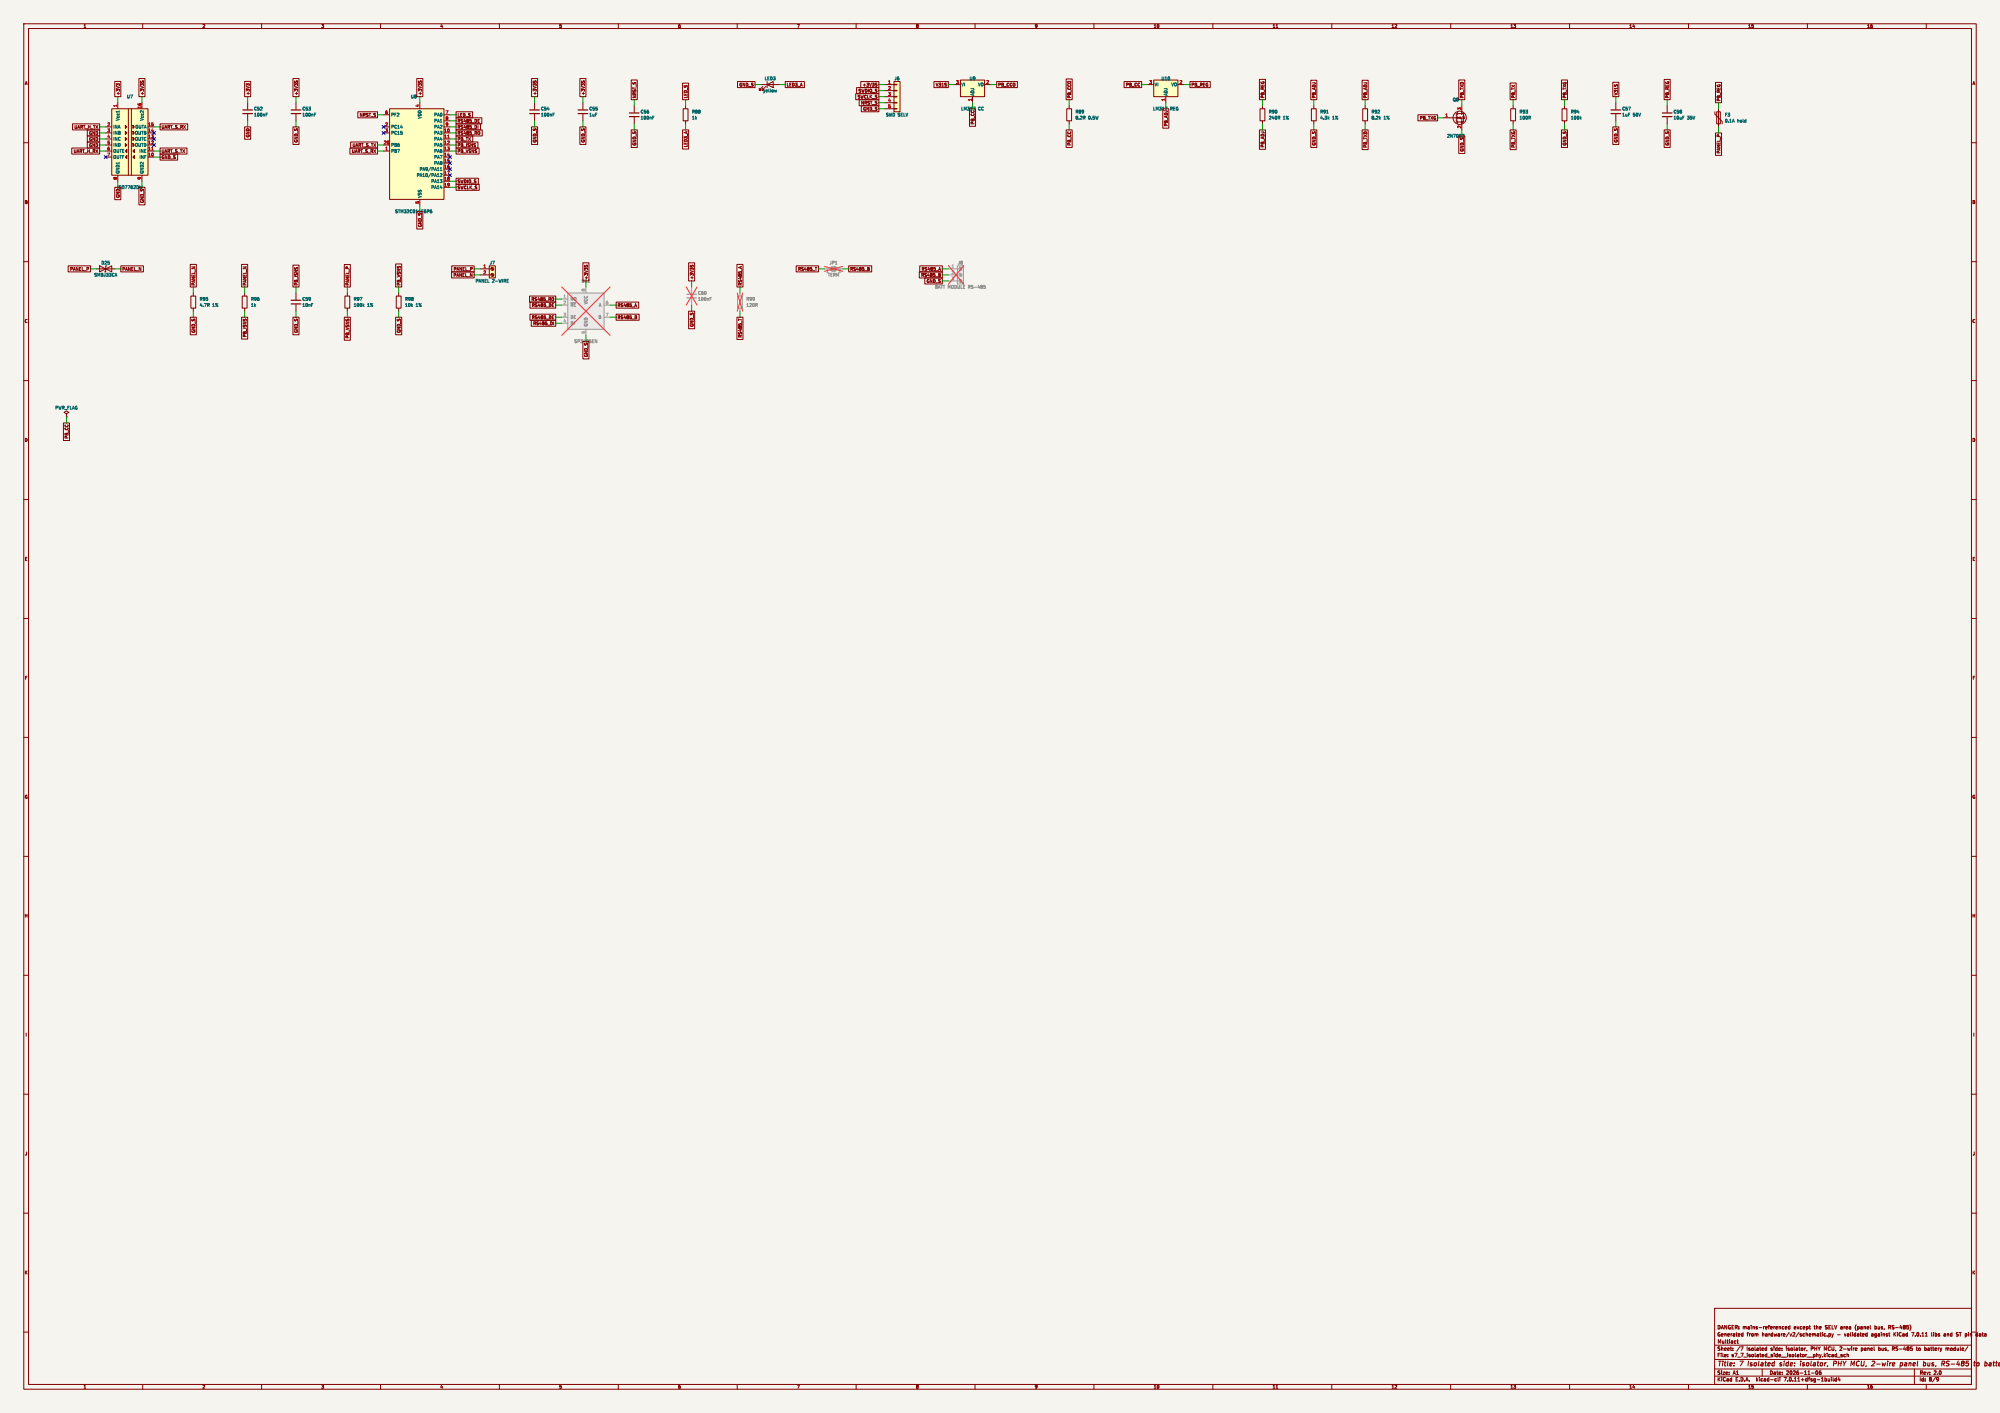
[picture p21: page 8]

INE 11 OUTD 12 OUTC 13 OUTB 14 OUTA 15 Vcc2 16
LED_S RS485_DI GND_S

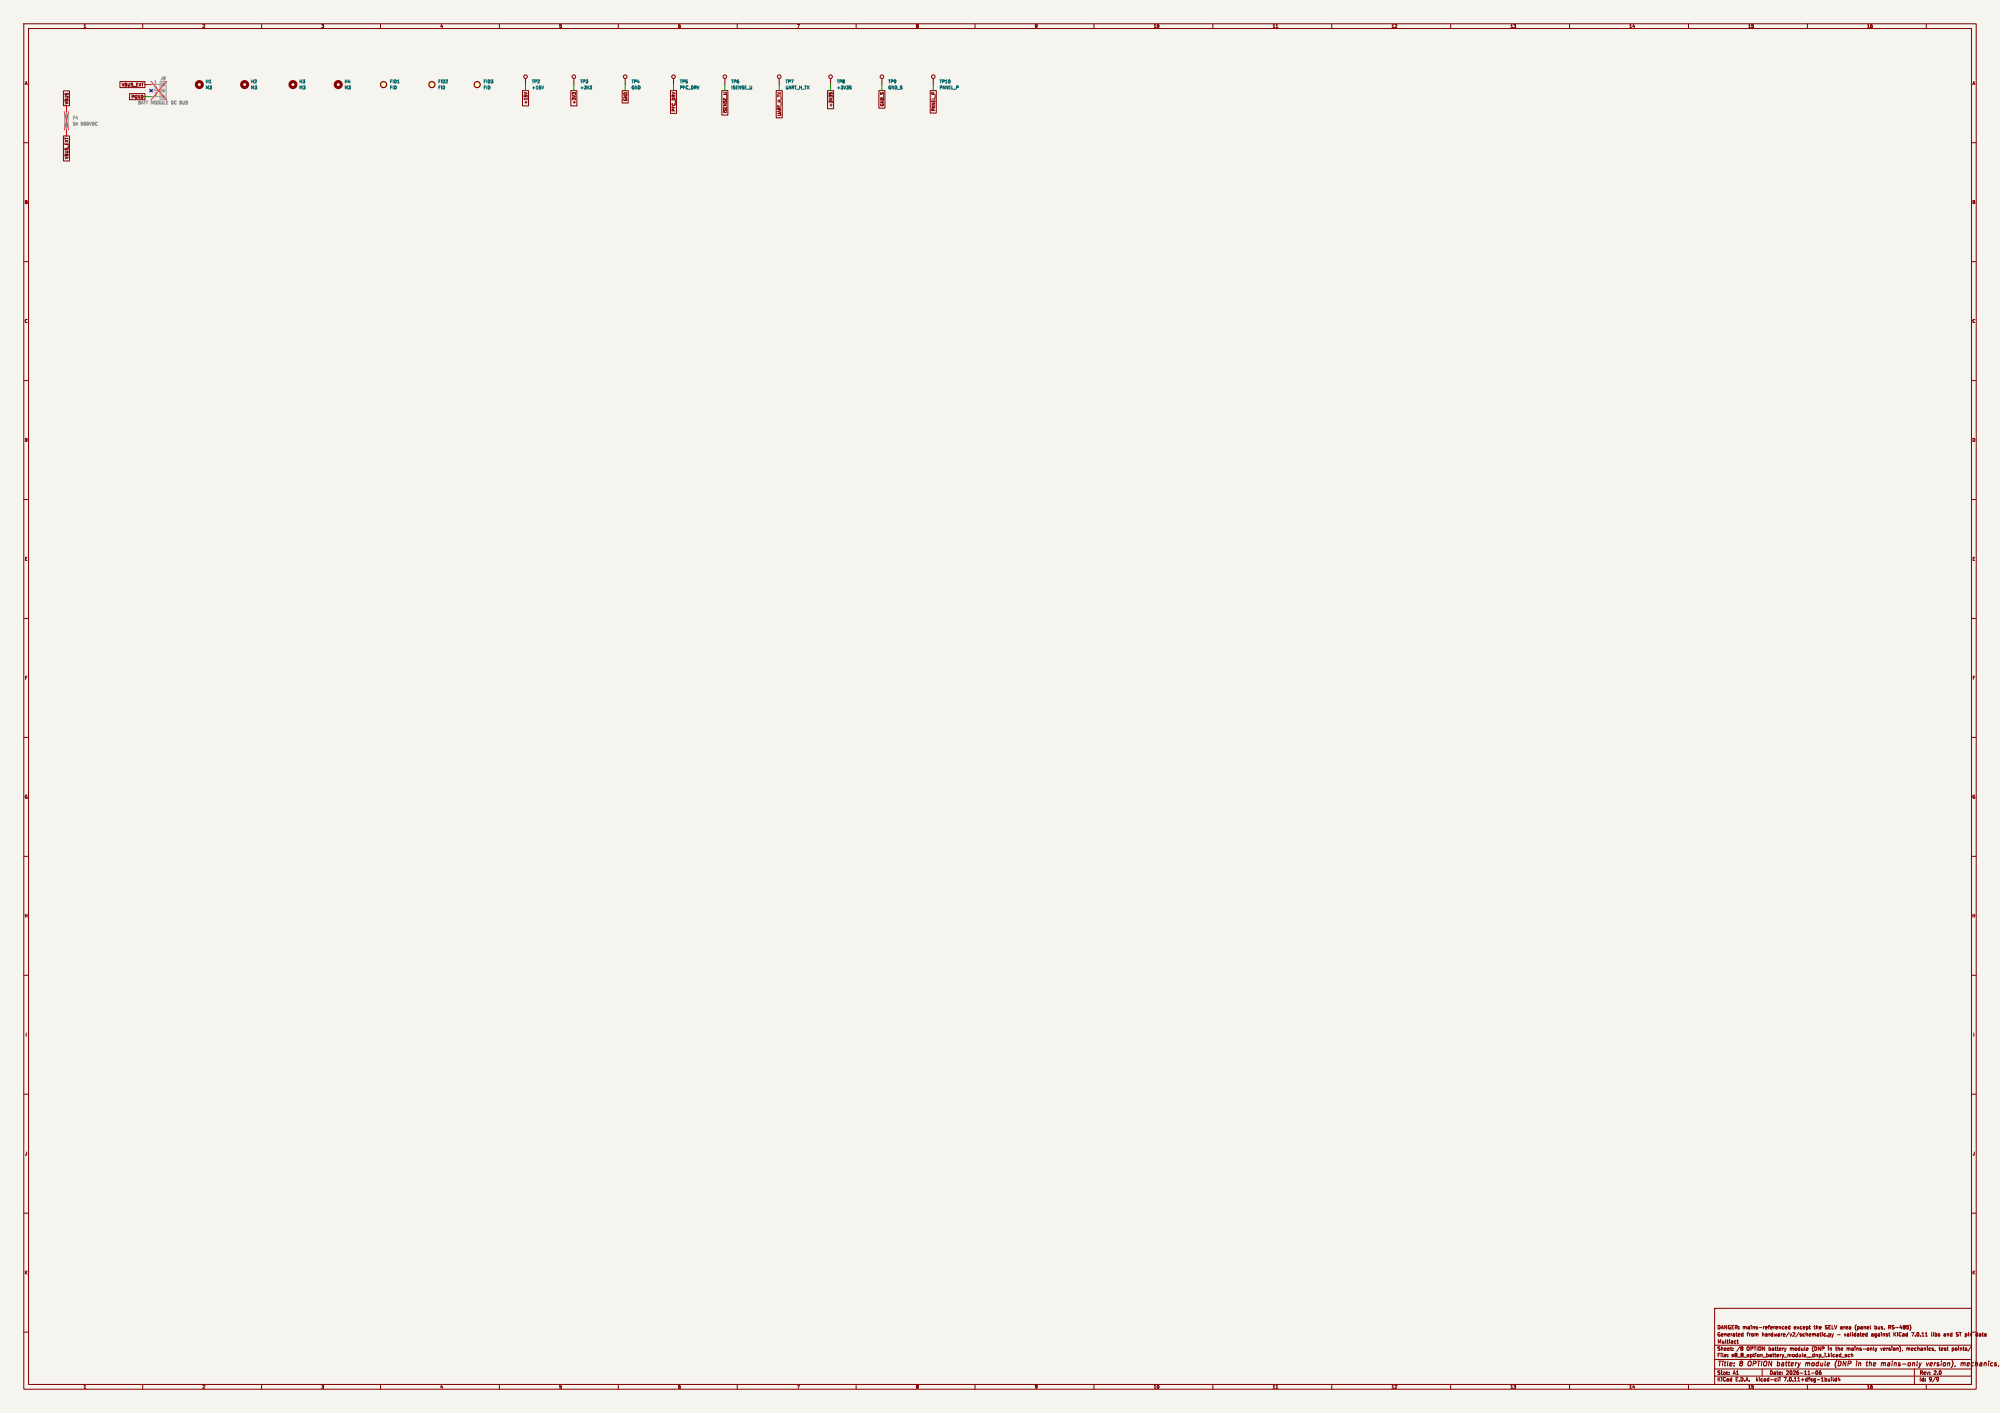
[picture p22: page 9]

J9 BATT MODULE DC BUS
