faragamco-eng/Multiact/hardware/panel/out/cooler_panel_placement.pdf

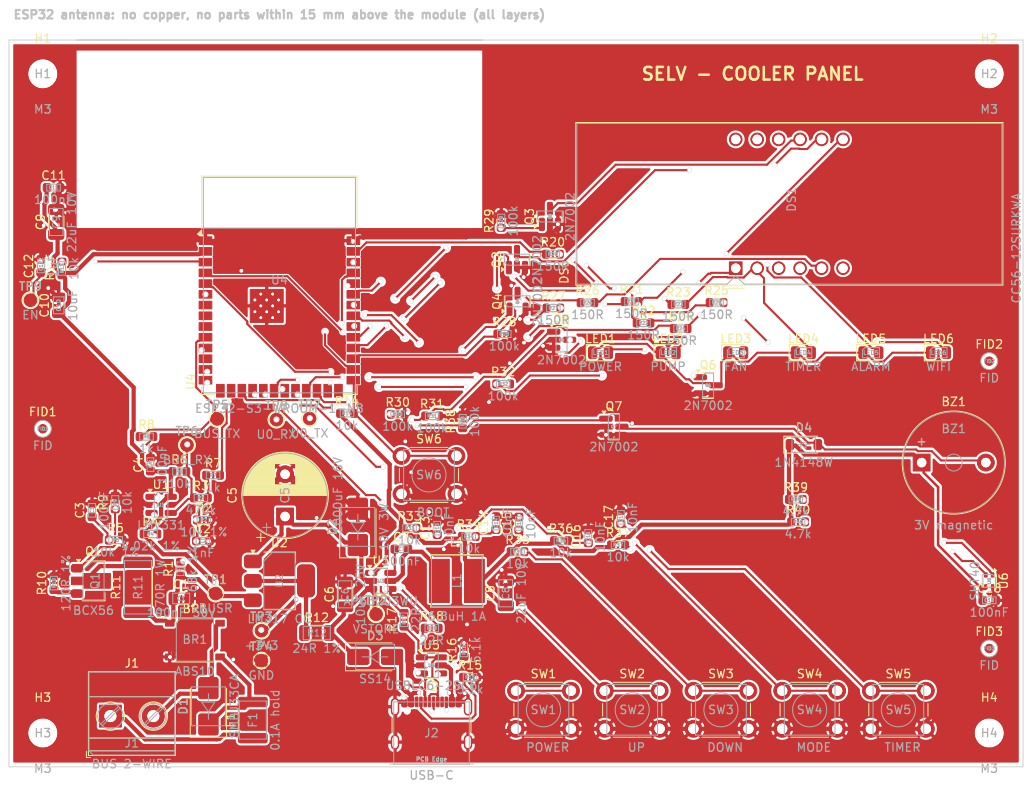
[picture p23: page 1]
