faragamco-eng/Multiact/hardware/panel/out/cooler_panel_routed_bottom.pdf

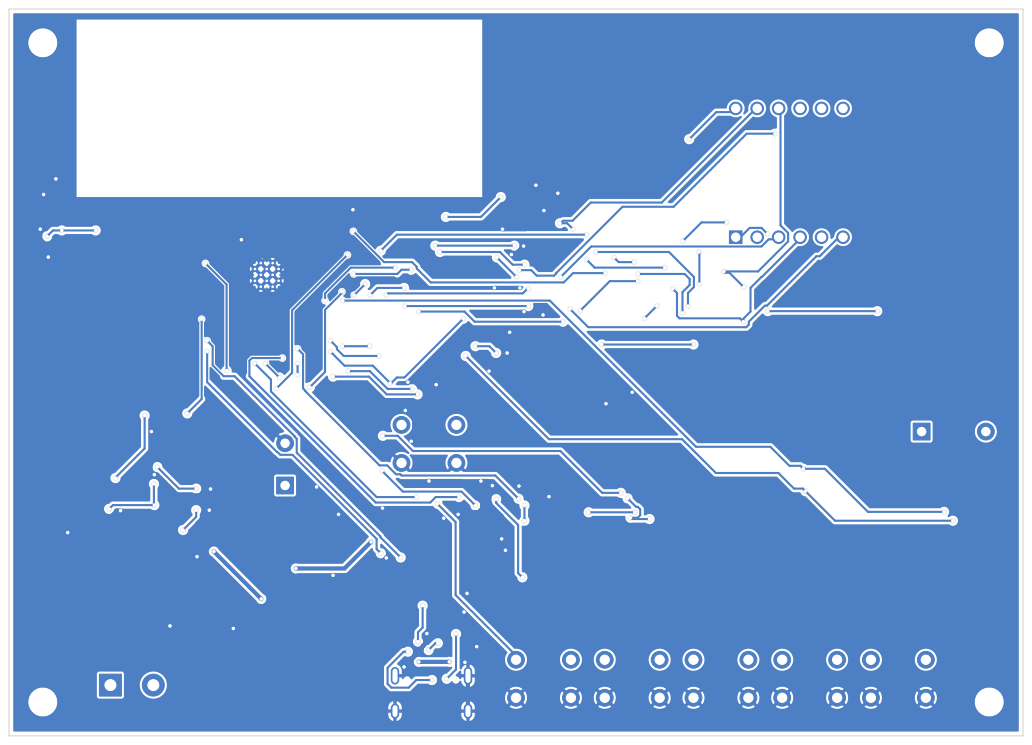
[picture p24: page 1]
