faragamco-eng/Multiact/hardware/panel/out/cooler_panel_routed_top.pdf

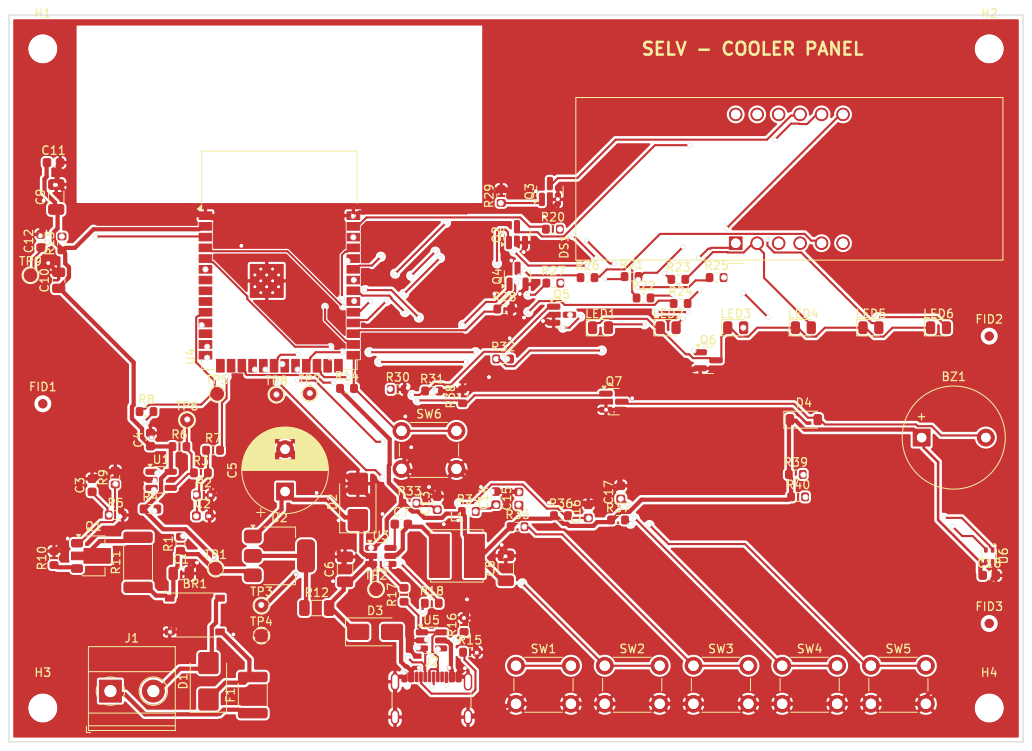
[picture p25: page 1]
