faragamco-eng/Multiact/hardware/v2/out/bldc_cooler_v2_placement.pdf

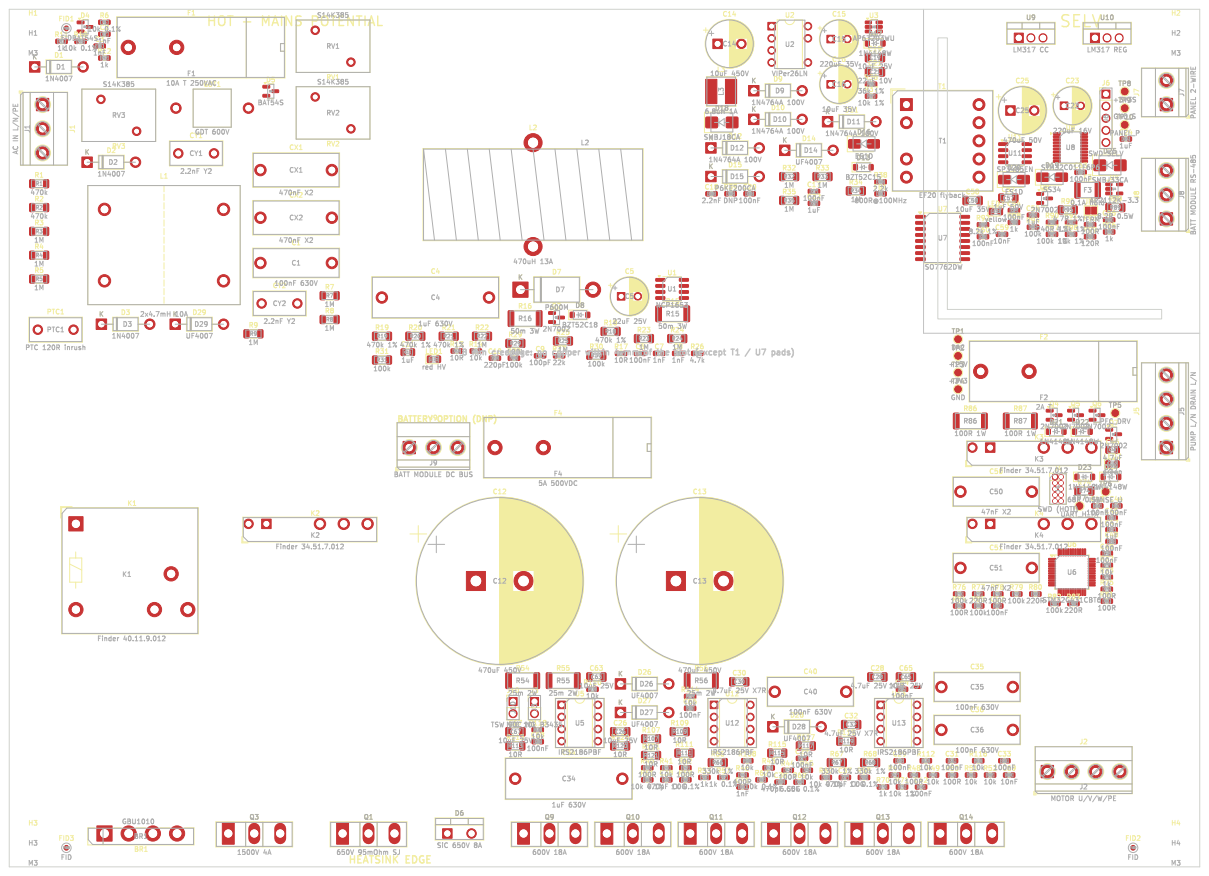
[picture p26: page 1]
