faragamco-eng/Multiact/hardware/panel/out/kicad/cooler_panel.kicad_pcb

## KiCad design hardware/panel/out/kicad/cooler_panel.kicad_pcb (2026-11-06)

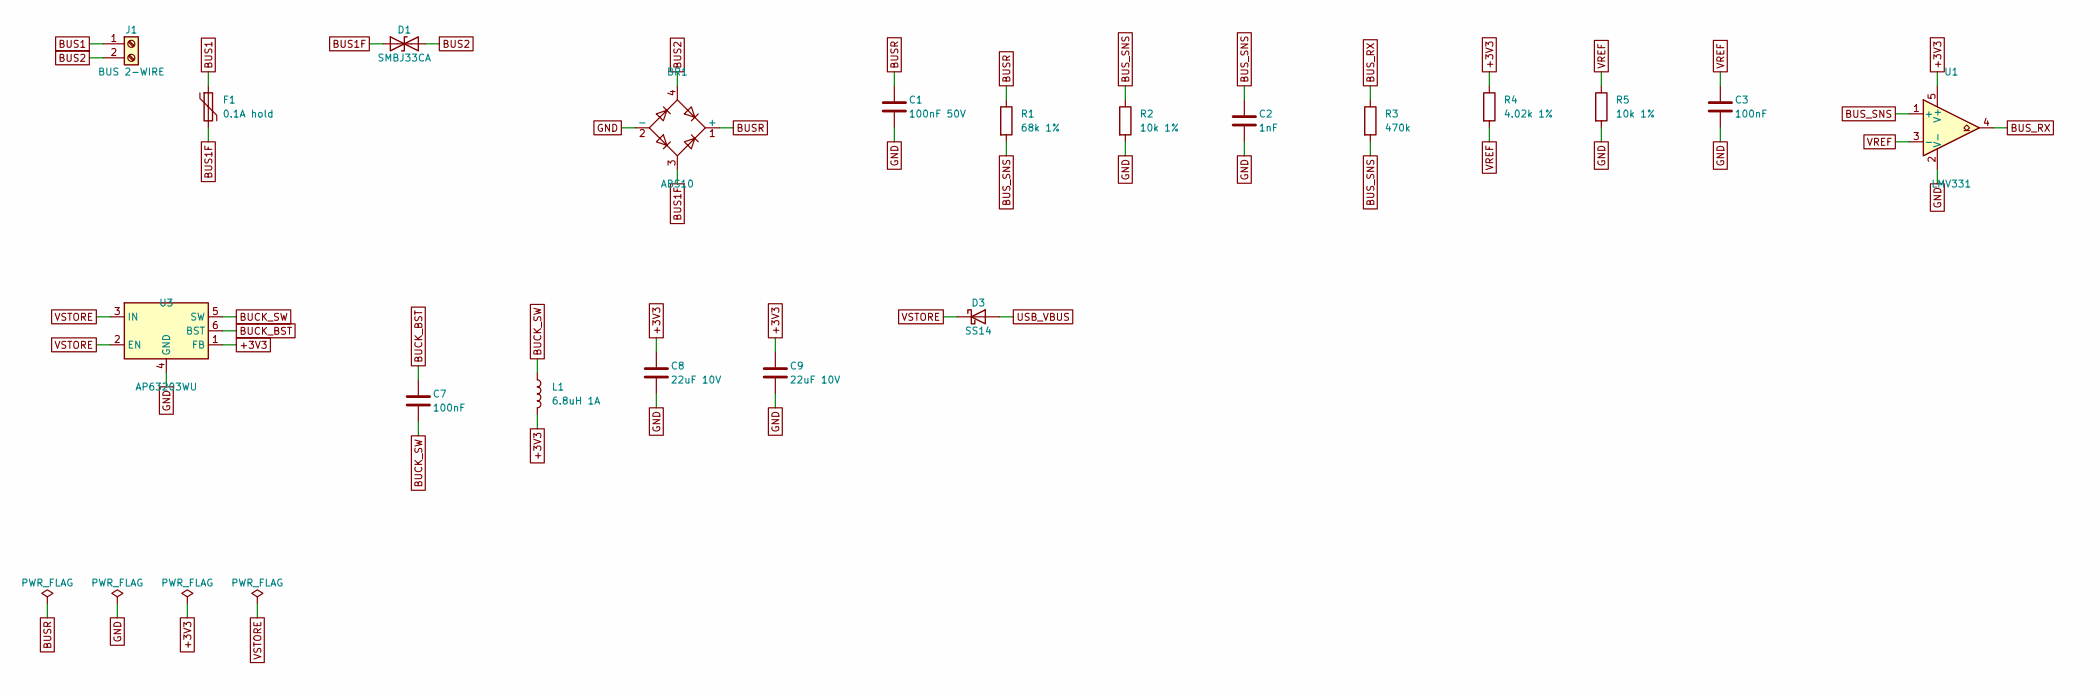
[picture p27: schematic s1_1_bus_interface_and_power.kicad_sch, 1 Bus interface and power, part in row 1, column 1]

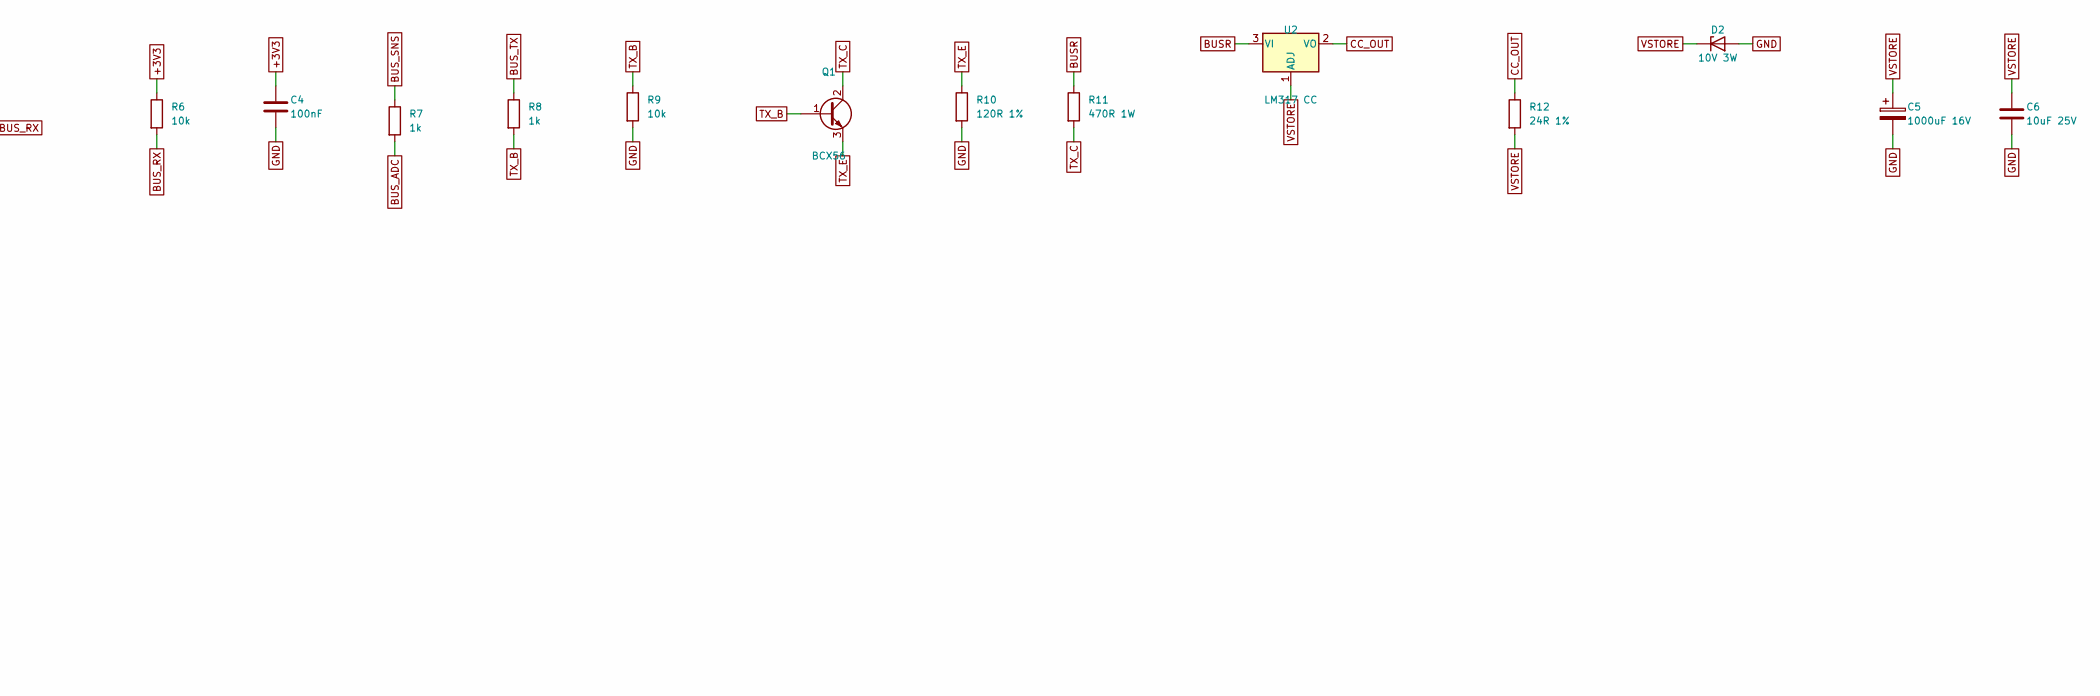
[picture p28: schematic s1_1_bus_interface_and_power.kicad_sch, 1 Bus interface and power, part in row 1, column 2]

Parts:
BR1: ABS10; Diode_Bridge_Diotec_ABS; MPN Diotec ABS10 (1000 V 0.8 A)
C1: 100nF 50V; C_0805_2012Metric
C2: 1nF; C_0603_1608Metric
C3, C4, C7: 100nF; C_0603_1608Metric
C5: 1000uF 16V; CP_Radial_D10.0mm_P5.00mm; MPN low-ESR 105 C
C6: 10uF 25V; C_1206_3216Metric
C8, C9: 22uF 10V; C_1206_3216Metric
D1: SMBJ33CA; D_SMB; MPN SMBJ33CA (bidirectional)
D2: 10V 3W; D_SMB; MPN 1SMB5925BT3 (10 V 3 W)
D3: SS14; D_SMA; MPN SS14
F1: 0.1A hold; Fuse_1812_4532Metric; MPN Bourns MF-MSMF010
J1: BUS 2-WIRE; TerminalBlock_Phoenix_MKDS-1,5-2-5.08_1x02_P5.08mm_Horizont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
L1: 6.8uH 1A; L_Bourns_SRN6045TA; MPN Bourns SRN6045TA-6R8M
Q1: BCX56; SOT-89-3; MPN BCX56-16 (SOT-89, 1 W)
R1: 68k 1%; R_0603_1608Metric
R2, R5: 10k 1%; R_0603_1608Metric
R3: 470k; R_0603_1608Metric
R4: 4.02k 1%; R_0603_1608Metric
R6, R9: 10k; R_0603_1608Metric
R7, R8: 1k; R_0603_1608Metric
R10: 120R 1%; R_0603_1608Metric
R11: 470R 1W; R_2512_6332Metric
R12: 24R 1%; R_1206_3216Metric
U1: LMV331; SOT-23-5; MPN TI LMV331IDBVR (open drain)
U2: LM317 CC; SOT-223-3_TabPin2; MPN LM317DCY
U3: AP63203WU; TSOT-23-6; MPN Diodes AP63203WU (fixed 3.3 V)

Connections:
+3V3: C4.1, C8.1, C9.1, L1.2, R4.1, R6.1, U1.5 (V+), U3.1 (FB); also elsewhere on the board
BUCK_BST: C7.1, U3.6 (BST)
BUCK_SW: C7.2, L1.1, U3.5 (SW)
BUS1: F1.1, J1.1
BUS1F: BR1.3, D1.1 (A1), F1.2
BUS2: BR1.4, D1.2 (A2), J1.2
BUSR: BR1.1 (+), C1.1, R1.1, R11.1, U2.3 (VI); also elsewhere on the board
BUS_ADC: R7.2; also elsewhere on the board
BUS_RX: R3.1, R6.2, U1.4; also elsewhere on the board
BUS_SNS: C2.1, R1.2, R2.1, R3.2, R7.1, U1.1 (+)
BUS_TX: R8.1; also elsewhere on the board
CC_OUT: R12.1, U2.2 (VO)
GND: BR1.2 (-), C1.2, C2.2, C3.2, C4.2, C5.2, C6.2, C8.2, C9.2, D2.2 (A), R2.2, R5.2, R9.2, R10.2, U1.2 (V-), U3.4 (GND); also elsewhere on the board
TX_B: Q1.1 (B), R8.2, R9.1
TX_C: Q1.2 (C), R11.2
TX_E: Q1.3 (E), R10.1
USB_VBUS: D3.2 (A); also elsewhere on the board
VREF: C3.1, R4.2, R5.1, U1.3 (-)
VSTORE: C5.1, C6.1, D2.1 (K), D3.1 (K), R12.2, U2.1 (ADJ), U3.2 (EN), U3.3 (IN); also elsewhere on the board

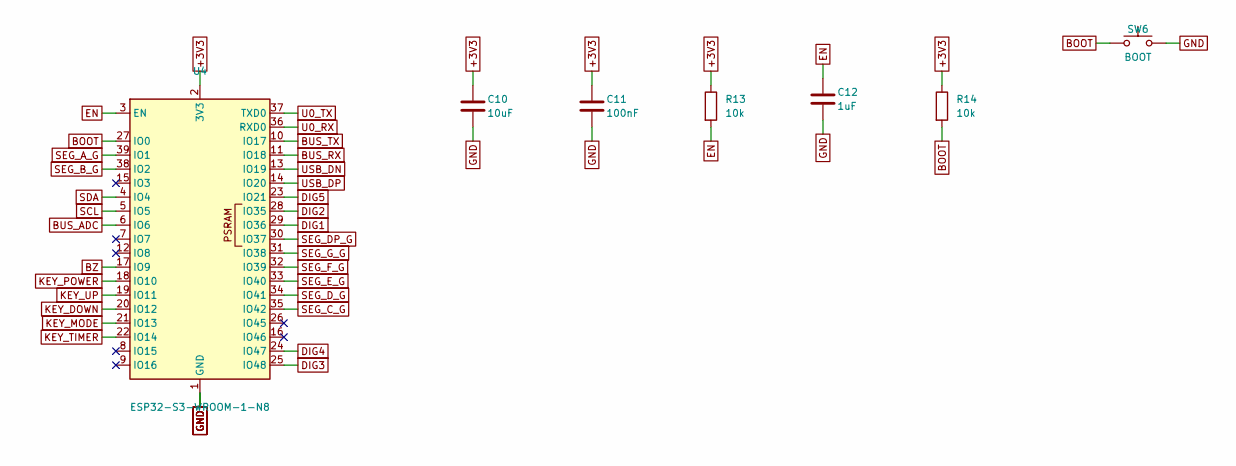
[picture p29: schematic s2_2_esp32_s3_module_and_usb.kicad_sch, 2 ESP32-S3 module and USB, part in row 1, column 1]

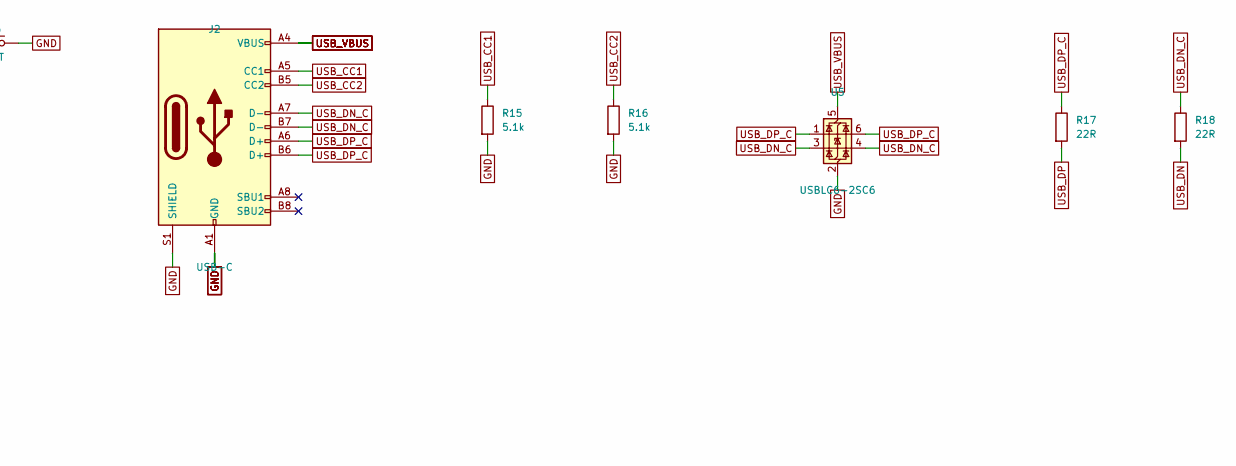
[picture p30: schematic s2_2_esp32_s3_module_and_usb.kicad_sch, 2 ESP32-S3 module and USB, part in row 1, column 2]

Parts:
C10: 10uF; C_0805_2012Metric
C11: 100nF; C_0603_1608Metric
C12: 1uF; C_0603_1608Metric
J2: USB-C; USB_C_Receptacle_GCT_USB4105-xx-A_16P_TopMnt_Horizontal; MPN GCT USB4105-GF-A
R13, R14: 10k; R_0603_1608Metric
R15, R16: 5.1k; R_0603_1608Metric
R17, R18: 22R; R_0603_1608Metric
SW6: BOOT; SW_PUSH_6mm
U4: ESP32-S3-WROOM-1-N8; ESP32-S3-WROOM-1; MPN Espressif ESP32-S3-WROOM-1-N8 (NOT an R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
U5: USBLC6-2SC6; SOT-23-6; MPN ST USBLC6-2SC6

Connections:
+3V3: C10.1, C11.1, R13.1, R14.1, U4.2 (3V3); also elsewhere on the board
BOOT: R14.2, SW6.1, U4.27 (IO0)
BUS_ADC: U4.6 (IO6); also elsewhere on the board
BUS_RX: U4.11 (IO18); also elsewhere on the board
BUS_TX: U4.10 (IO17); also elsewhere on the board
BZ: U4.17 (IO9); also elsewhere on the board
DIG1: U4.29 (IO36); also elsewhere on the board
DIG2: U4.28 (IO35); also elsewhere on the board
DIG3: U4.25 (IO48); also elsewhere on the board
DIG4: U4.24 (IO47); also elsewhere on the board
DIG5: U4.23 (IO21); also elsewhere on the board
EN: C12.1, R13.2, U4.3 (EN); also elsewhere on the board
GND: C10.2, C11.2, C12.2, J2.A1 (GND), J2.A12 (GND), J2.B1 (GND), J2.B12 (GND), J2.S1 (SHIELD), R15.2, R16.2, SW6.2, U4.1 (GND), U4.40 (GND), U4.41 (GND), U5.2 (GND); also elsewhere on the board
KEY_DOWN: U4.20 (IO12); also elsewhere on the board
KEY_MODE: U4.21 (IO13); also elsewhere on the board
KEY_POWER: U4.18 (IO10); also elsewhere on the board
KEY_TIMER: U4.22 (IO14); also elsewhere on the board
KEY_UP: U4.19 (IO11); also elsewhere on the board
SCL: U4.5 (IO5); also elsewhere on the board
SDA: U4.4 (IO4); also elsewhere on the board
SEG_A_G: U4.39 (IO1); also elsewhere on the board
SEG_B_G: U4.38 (IO2); also elsewhere on the board
SEG_C_G: U4.35 (IO42); also elsewhere on the board
SEG_DP_G: U4.30 (IO37); also elsewhere on the board
SEG_D_G: U4.34 (IO41); also elsewhere on the board
SEG_E_G: U4.33 (IO40); also elsewhere on the board
SEG_F_G: U4.32 (IO39); also elsewhere on the board
SEG_G_G: U4.31 (IO38); also elsewhere on the board
U0_RX: U4.36 (RXD0); also elsewhere on the board
U0_TX: U4.37 (TXD0); also elsewhere on the board
USB_CC1: J2.A5 (CC1), R15.1
USB_CC2: J2.B5 (CC2), R16.1
USB_DN: R18.2, U4.13 (IO19)
USB_DN_C: J2.A7 (D-), J2.B7 (D-), R18.1, U5.3 (I/O2), U5.4 (I/O2)
USB_DP: R17.2, U4.14 (IO20)
USB_DP_C: J2.A6 (D+), J2.B6 (D+), R17.1, U5.1 (I/O1), U5.6 (I/O1)
USB_VBUS: J2.A4 (VBUS), J2.A9 (VBUS), J2.B4 (VBUS), J2.B9 (VBUS), U5.5 (VBUS); also elsewhere on the board

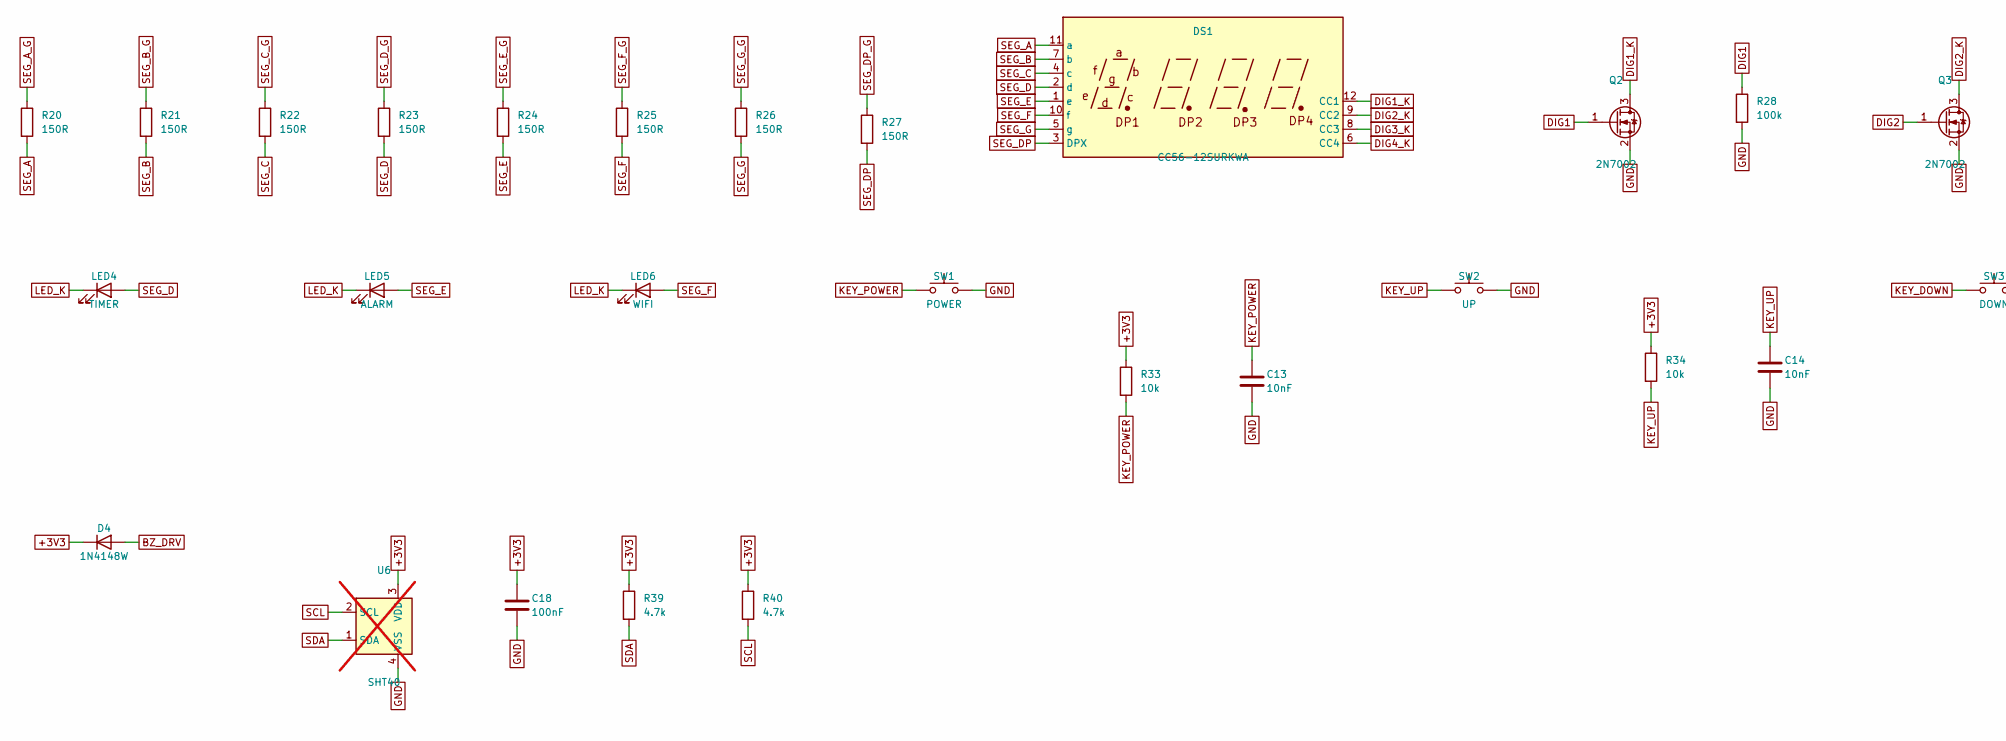
[picture p31: schematic s3_3_display__status_leds__keys.kicad_sch, 3 Display, status LEDs, keys, buzzer, sensor, part in row 1, column 1]

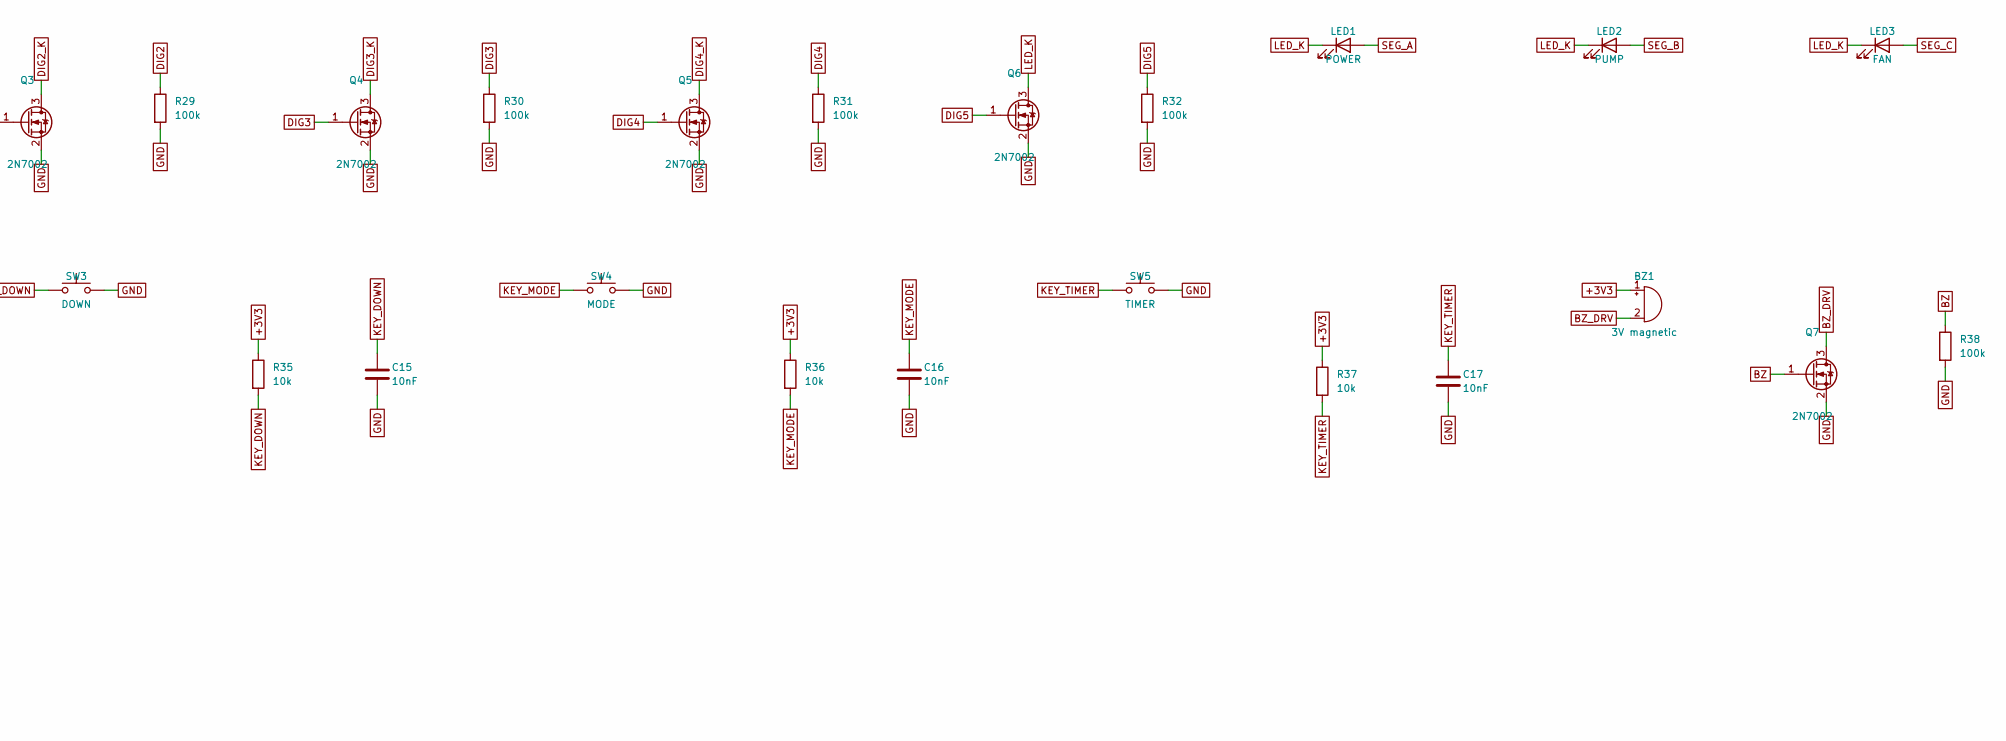
[picture p32: schematic s3_3_display__status_leds__keys.kicad_sch, 3 Display, status LEDs, keys, buzzer, sensor, part in row 1, column 2]

Parts:
BZ1: 3V magnetic; Buzzer_12x9.5RM7.6; MPN magnetic buzzer 3 V, 2.7 kHz (e.g. CUI 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
C13, C14, C15, C16, C17: 10nF; C_0603_1608Metric
C18: 100nF; C_0603_1608Metric
D4: 1N4148W; D_SOD-123; MPN 1N4148W
DS1: CC56-12SURKWA; CA56-12EWA; MPN Kingbright CC56-12SURKWA (0.56 in, supe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
LED1: POWER; LED_0805_2012Metric; MPN green
LED2: PUMP; LED_0805_2012Metric; MPN green
LED3: FAN; LED_0805_2012Metric; MPN green
LED4: TIMER; LED_0805_2012Metric; MPN green
LED5: ALARM; LED_0805_2012Metric; MPN red
LED6: WIFI; LED_0805_2012Metric; MPN blue
Q2, Q3, Q4, Q5, Q6, Q7: 2N7002; SOT-23; MPN 2N7002
R20, R21, R22, R23, R24, R25, R26, R27: 150R; R_0603_1608Metric
R28, R29, R30, R31, R32, R38: 100k; R_0603_1608Metric
R33, R34, R35, R36, R37: 10k; R_0603_1608Metric
R39, R40: 4.7k; R_0603_1608Metric
SW1: POWER; SW_PUSH_6mm
SW2: UP; SW_PUSH_6mm
SW3: DOWN; SW_PUSH_6mm
SW4: MODE; SW_PUSH_6mm
SW5: TIMER; SW_PUSH_6mm
U6: SHT40; Sensirion_DFN-4_1.5x1.5mm_P0.8mm_SHT4x_NoCentralPad; MPN Sensirion SHT40-AD1B; not fitted

Connections:
+3V3: BZ1.1 (+), C18.1, D4.1 (K), R33.1, R34.1, R35.1, R36.1, R37.1, R39.1, R40.1, U6.3 (VDD); also elsewhere on the board
BZ: Q7.1 (G), R38.1; also elsewhere on the board
BZ_DRV: BZ1.2 (-), D4.2 (A), Q7.3 (D)
DIG1: Q2.1 (G), R28.1; also elsewhere on the board
DIG1_K: DS1.12 (CC1), Q2.3 (D)
DIG2: Q3.1 (G), R29.1; also elsewhere on the board
DIG2_K: DS1.9 (CC2), Q3.3 (D)
DIG3: Q4.1 (G), R30.1; also elsewhere on the board
DIG3_K: DS1.8 (CC3), Q4.3 (D)
DIG4: Q5.1 (G), R31.1; also elsewhere on the board
DIG4_K: DS1.6 (CC4), Q5.3 (D)
DIG5: Q6.1 (G), R32.1; also elsewhere on the board
GND: C13.2, C14.2, C15.2, C16.2, C17.2, C18.2, Q2.2 (S), Q3.2 (S), Q4.2 (S), Q5.2 (S), Q6.2 (S), Q7.2 (S), R28.2, R29.2, R30.2, R31.2, R32.2, R38.2, SW1.2, SW2.2, SW3.2, SW4.2, SW5.2, U6.4 (VSS); also elsewhere on the board
KEY_DOWN: C15.1, R35.2, SW3.1; also elsewhere on the board
KEY_MODE: C16.1, R36.2, SW4.1; also elsewhere on the board
KEY_POWER: C13.1, R33.2, SW1.1; also elsewhere on the board
KEY_TIMER: C17.1, R37.2, SW5.1; also elsewhere on the board
KEY_UP: C14.1, R34.2, SW2.1; also elsewhere on the board
LED_K: LED1.1 (K), LED2.1 (K), LED3.1 (K), LED4.1 (K), LED5.1 (K), LED6.1 (K), Q6.3 (D)
SCL: R40.2, U6.2 (SCL); also elsewhere on the board
SDA: R39.2, U6.1 (SDA); also elsewhere on the board
SEG_A: DS1.11 (a), LED1.2 (A), R20.2
SEG_A_G: R20.1; also elsewhere on the board
SEG_B: DS1.7 (b), LED2.2 (A), R21.2
SEG_B_G: R21.1; also elsewhere on the board
SEG_C: DS1.4 (c), LED3.2 (A), R22.2
SEG_C_G: R22.1; also elsewhere on the board
SEG_D: DS1.2 (d), LED4.2 (A), R23.2
SEG_DP: DS1.3 (DPX), R27.2
SEG_DP_G: R27.1; also elsewhere on the board
SEG_D_G: R23.1; also elsewhere on the board
SEG_E: DS1.1 (e), LED5.2 (A), R24.2
SEG_E_G: R24.1; also elsewhere on the board
SEG_F: DS1.10 (f), LED6.2 (A), R25.2
SEG_F_G: R25.1; also elsewhere on the board
SEG_G: DS1.5 (g), R26.2
SEG_G_G: R26.1; also elsewhere on the board

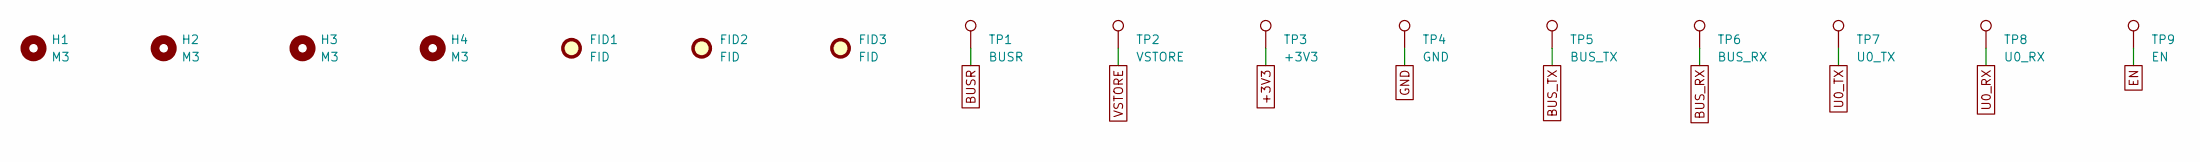
[picture p33: schematic s4_4_mechanics_and_test_points.kicad_sch, 4 Mechanics and test points]

Parts:
FID1, FID2, FID3: FID; Fiducial_1mm_Mask2mm
H1, H2, H3, H4: M3; MountingHole_3.2mm_M3
TP1: BUSR; TestPoint_Pad_D1.5mm
TP2: VSTORE; TestPoint_Pad_D1.5mm
TP3: +3V3; TestPoint_Pad_D1.5mm
TP4: GND; TestPoint_Pad_D1.5mm
TP5: BUS_TX; TestPoint_Pad_D1.5mm
TP6: BUS_RX; TestPoint_Pad_D1.5mm
TP7: U0_TX; TestPoint_Pad_D1.5mm
TP8: U0_RX; TestPoint_Pad_D1.5mm
TP9: EN; TestPoint_Pad_D1.5mm

Connections:
+3V3: TP3.1; also elsewhere on the board
BUSR: TP1.1; also elsewhere on the board
BUS_RX: TP6.1; also elsewhere on the board
BUS_TX: TP5.1; also elsewhere on the board
EN: TP9.1; also elsewhere on the board
GND: TP4.1; also elsewhere on the board
U0_RX: TP8.1; also elsewhere on the board
U0_TX: TP7.1; also elsewhere on the board
VSTORE: TP2.1; also elsewhere on the board

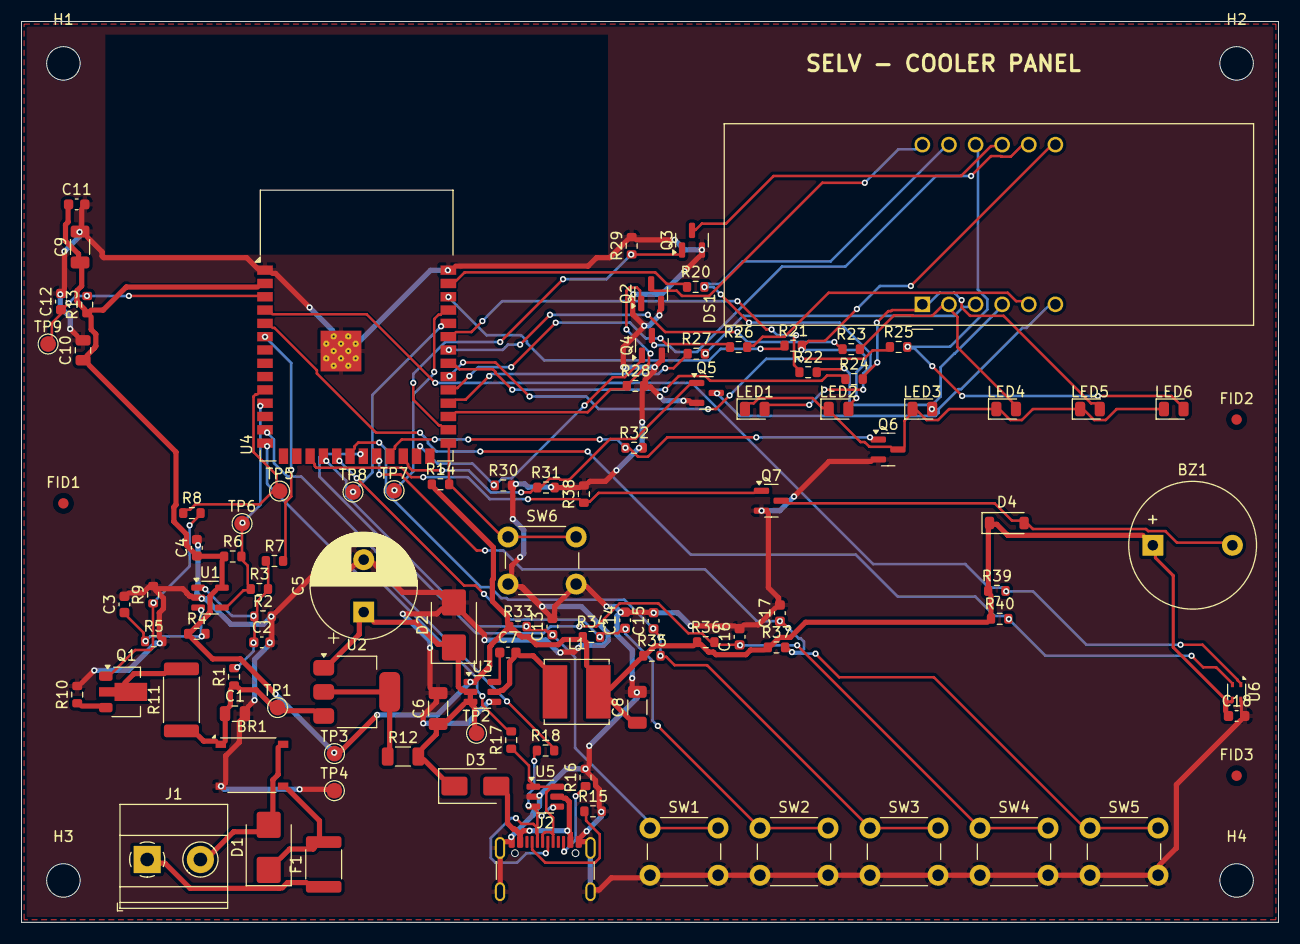
[picture p34: board cooler_panel.kicad_pcb from above]

Board: 2 copper layers, 120.0 x 86.0 mm, 109 parts (0 on the bottom side), 64 nets.
