faragamco-eng/Multiact/hardware/v2/out/kicad/bldc_cooler_v2.kicad_pcb

## KiCad design hardware/v2/out/kicad/bldc_cooler_v2.kicad_pcb (2026-11-06)

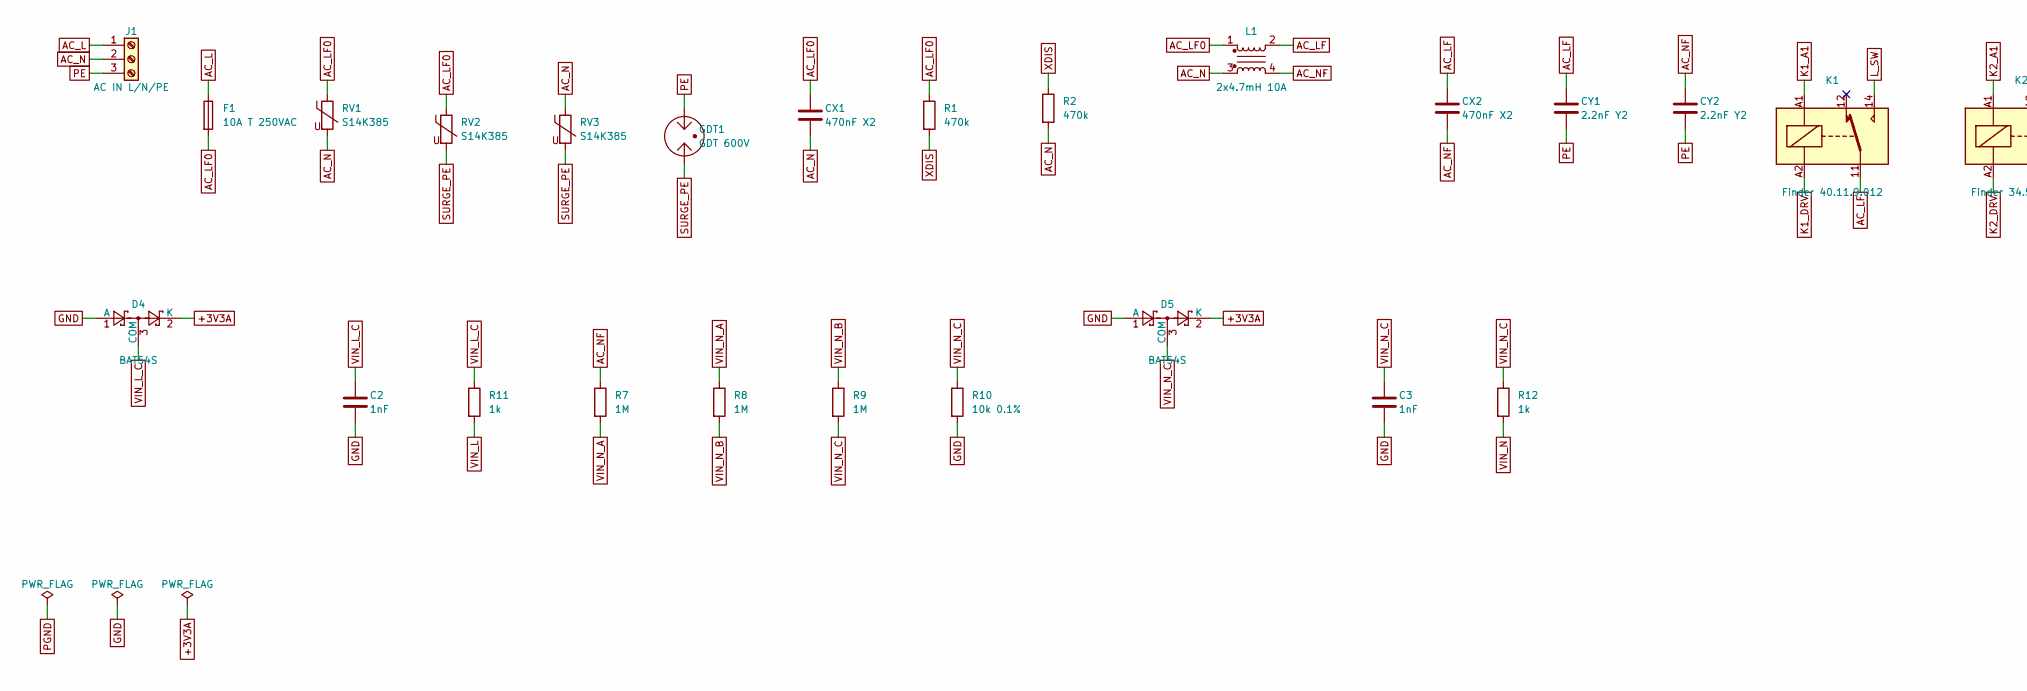
[picture p35: schematic s1_1_ac_input__protection__relays.kicad_sch, 1 AC input, protection, relays, mains sensing, part in row 1, column 1]

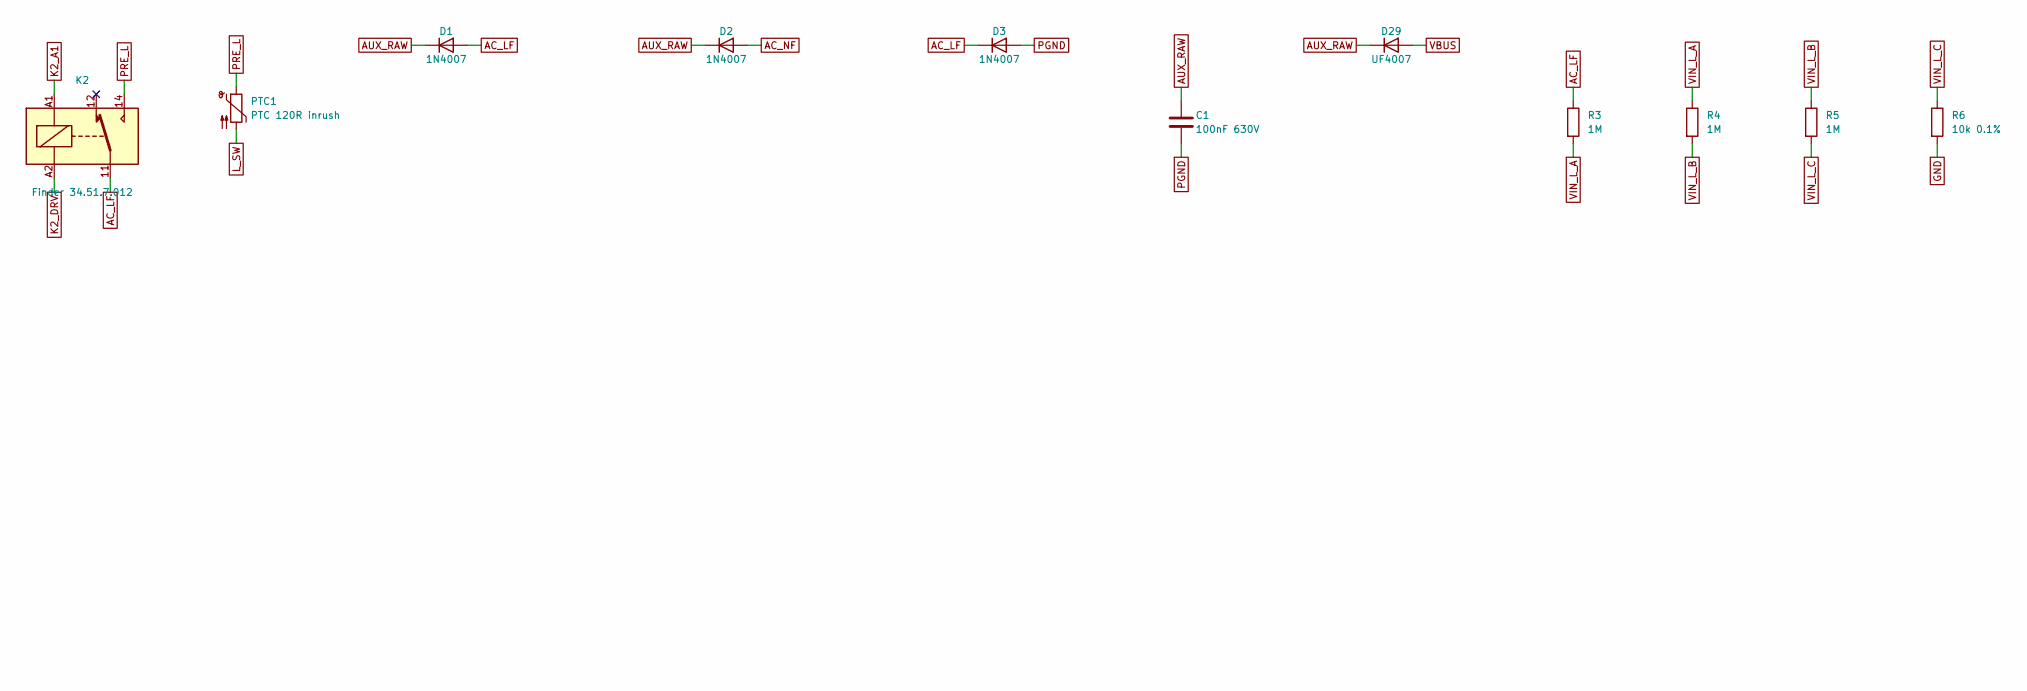
[picture p36: schematic s1_1_ac_input__protection__relays.kicad_sch, 1 AC input, protection, relays, mains sensing, part in row 1, column 2]

Parts:
C1: 100nF 630V; C_Rect_L18.0mm_W6.0mm_P15.00mm_FKS3_FKP3
C2, C3: 1nF; C_0603_1608Metric
CX1: 470nF X2; C_Rect_L18.0mm_W7.0mm_P15.00mm_FKS3_FKP3; MPN X2 310VAC
CX2: 470nF X2; C_Rect_L18.0mm_W7.0mm_P15.00mm_FKS3_FKP3
CY1, CY2: 2.2nF Y2; C_Disc_D11.0mm_W5.0mm_P7.50mm; MPN Y2 300VAC
D1, D2, D3: 1N4007; D_DO-41_SOD81_P10.16mm_Horizontal; MPN 1N4007
D4, D5: BAT54S; SOT-23; MPN BAT54S
D29: UF4007; D_DO-41_SOD81_P10.16mm_Horizontal; MPN UF4007 (1000 V)
F1: 10A T 250VAC; Fuseholder_Cylinder-5x20mm_Bulgin_FX0457_Horizontal_Closed; MPN 5x20 ceramic 10 A time-lag
GDT1: GDT 600V; GDT_Axial_P15.24mm; MPN axial 2-electrode GDT 600 V (e.g. Bourn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
J1: AC IN L/N/PE; TerminalBlock_Phoenix_MKDS-1,5-3-5.08_1x03_P5.08mm_Horizont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; MPN Phoenix MKDS 1,5/3-5,08
K1: Finder 40.11.9.012; Relay_SPDT_Finder_40.11; MPN Finder 40.11.9.012.0000 (10 A, 12 V coi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
K2: Finder 34.51.7.012; Relay_SPDT_Finder_34.51_Vertical; MPN Finder 34.51.7.012.0010
L1: 2x4.7mH 10A; CMC_Toroid_4P_25x15mm; MPN toroidal CM choke 2 x 4.7 mH, >= 10 A (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
PTC1: PTC 120R inrush; C_Disc_D11.0mm_W5.0mm_P7.50mm; MPN inrush PTC rated >= 80 J at 265 VAC (94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
R1, R2: 470k; R_1206_3216Metric
R3, R4, R5, R7, R8, R9: 1M; R_1206_3216Metric
R6, R10: 10k 0.1%; R_0603_1608Metric
R11, R12: 1k; R_0603_1608Metric
RV1: S14K385; RV_Disc_D15.5mm_W11mm_P7.5mm; MPN EPCOS S14K385
RV2, RV3: S14K385; RV_Disc_D15.5mm_W11mm_P7.5mm

Connections:
+3V3A: D4.2 (K), D5.2 (K); also elsewhere on the board
AC_L: F1.1, J1.1
AC_LF: CX2.1, CY1.1, D1.2 (A), D3.1 (K), K1.11, K2.11, L1.2, R3.1
AC_LF0: CX1.1, F1.2, L1.1, R1.1, RV1.1, RV2.1
AC_N: CX1.2, J1.2, L1.3, R2.2, RV1.2, RV3.1
AC_NF: CX2.2, CY2.1, D2.2 (A), L1.4, R7.1; also elsewhere on the board
AUX_RAW: C1.1, D1.1 (K), D2.1 (K), D29.1 (K); also elsewhere on the board
GND: C2.2, C3.2, D4.1 (A), D5.1 (A), R6.2, R10.2; also elsewhere on the board
K1_A1: K1.A1; also elsewhere on the board
K1_DRV: K1.A2; also elsewhere on the board
K2_A1: K2.A1; also elsewhere on the board
K2_DRV: K2.A2; also elsewhere on the board
L_SW: K1.14, PTC1.2; also elsewhere on the board
PE: CY1.2, CY2.2, GDT1.3, J1.3; also elsewhere on the board
PGND: C1.2, D3.2 (A); also elsewhere on the board
PRE_L: K2.14, PTC1.1
SURGE_PE: GDT1.1, RV2.2, RV3.2
VBUS: D29.2 (A); also elsewhere on the board
VIN_L: R11.2; also elsewhere on the board
VIN_L_A: R3.2, R4.1
VIN_L_B: R4.2, R5.1
VIN_L_C: C2.1, D4.3 (COM), R5.2, R6.1, R11.1
VIN_N: R12.2; also elsewhere on the board
VIN_N_A: R7.2, R8.1
VIN_N_B: R8.2, R9.1
VIN_N_C: C3.1, D5.3 (COM), R9.2, R10.1, R12.1
XDIS: R1.2, R2.1
