faragamco-eng/Multiact/hardware/v2/out/kicad/bldc_cooler_v2.kicad_pcb

## KiCad design hardware/v2/out/kicad/bldc_cooler_v2.kicad_pcb (continued)

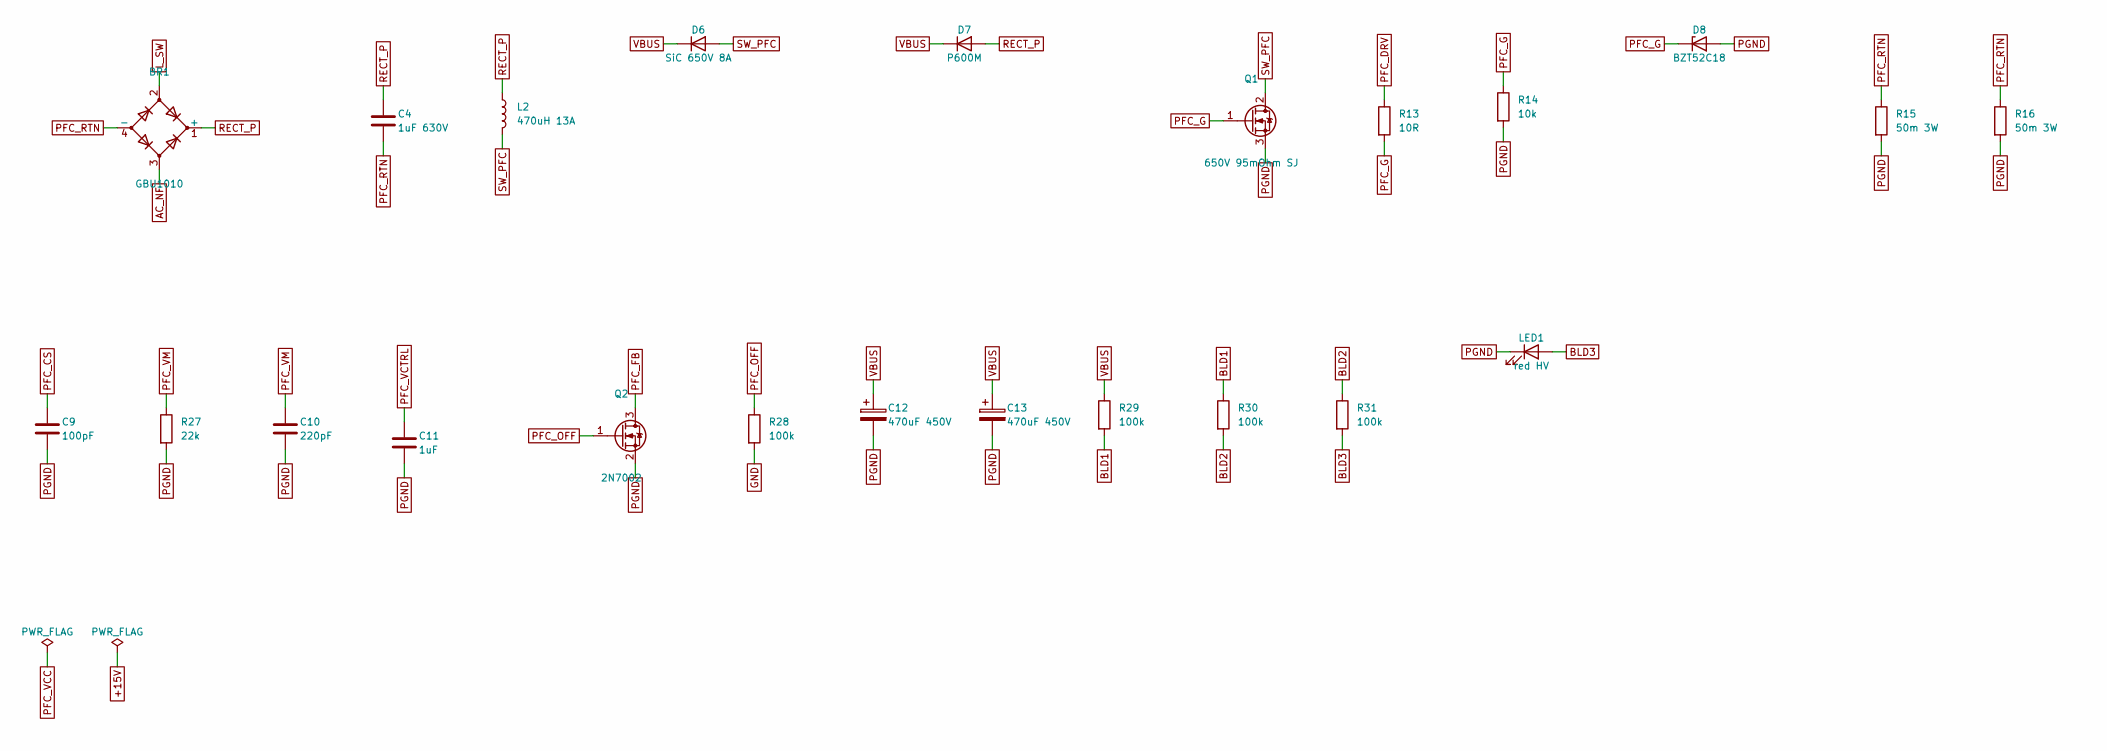
[picture p37: schematic s2_2_rectifier_and_pfc__ccm__ncp1.kicad_sch, 2 Rectifier and PFC (CCM, NCP1653, 390 V), part in row 1, column 1]

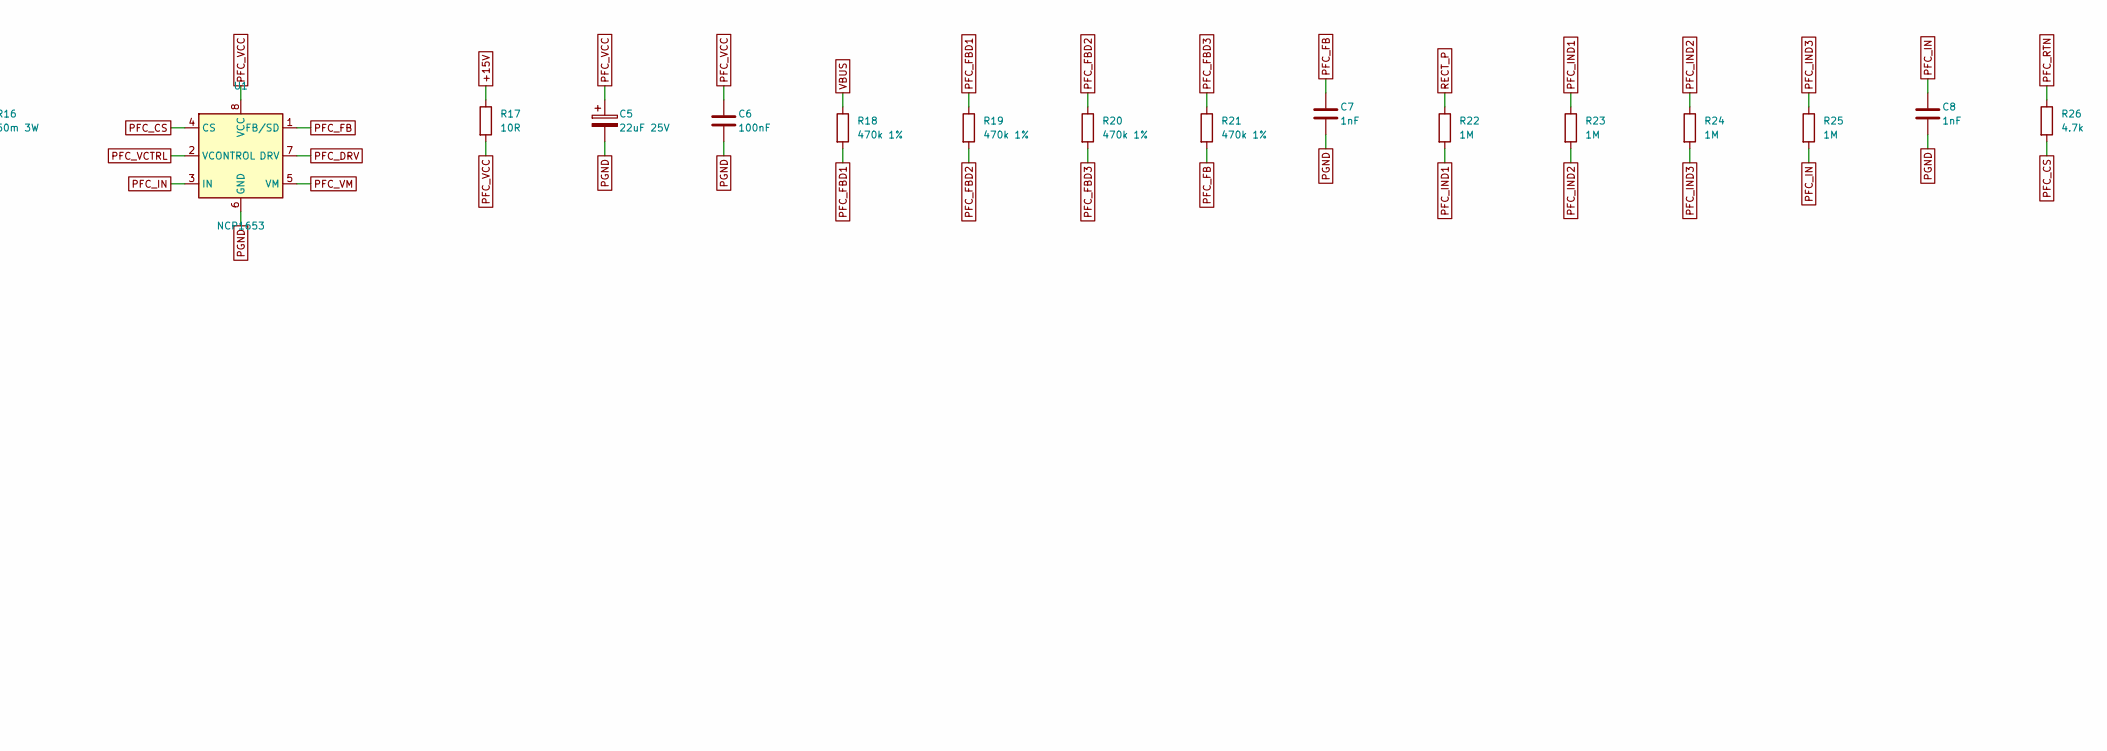
[picture p38: schematic s2_2_rectifier_and_pfc__ccm__ncp1.kicad_sch, 2 Rectifier and PFC (CCM, NCP1653, 390 V), part in row 1, column 2]

Parts:
BR1: GBU1010; Diode_Bridge_Vishay_GBU; MPN GBU1010 (10 A 1000 V) on heatsink
C4: 1uF 630V; C_Rect_L26.5mm_W8.5mm_P22.50mm_MKS4
C5: 22uF 25V; CP_Radial_D8.0mm_P3.50mm
C6: 100nF; C_0603_1608Metric
C7, C8: 1nF; C_0603_1608Metric
C9: 100pF; C_0603_1608Metric
C10: 220pF; C_0603_1608Metric
C11: 1uF; C_0805_2012Metric
C12, C13: 470uF 450V; CP_Radial_D35.0mm_P10.00mm_SnapIn; MPN 470 uF 450 V 105 C >= 5000 h snap-in D3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
D6: SiC 650V 8A; TO-220-2_Vertical; MPN Wolfspeed C3D08065A / Infineon IDH08G65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
D7: P600M; D_DO-201AD_P15.24mm_Horizontal; MPN P600M / 1N5408 inrush bypass
D8: BZT52C18; D_SOD-123; MPN BZT52C18
L2: 470uH 13A; L_Toroid_Vertical_L46.0mm_W19.1mm_P21.80mm_Bourns_5700; MPN toroid ~46 mm OD (e.g. Kool Mu 0077083A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
LED1: red HV; LED_0805_2012Metric; MPN high-efficiency red, 'HIGH VOLTAGE'
Q1: 650V 95mOhm SJ; TO-247-3_Vertical; MPN Infineon IPW65R095C7 / ST STW40N60M6 (h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
Q2: 2N7002; SOT-23; MPN 2N7002
R13, R17: 10R; R_0603_1608Metric
R14: 10k; R_0603_1608Metric
R15, R16: 50m 3W; R_2512_6332Metric
R18, R19, R20, R21: 470k 1%; R_1206_3216Metric
R22, R23, R24, R25: 1M; R_1206_3216Metric
R26: 4.7k; R_0603_1608Metric
R27: 22k; R_0603_1608Metric
R28: 100k; R_0603_1608Metric
R29, R30, R31: 100k; R_1206_3216Metric
U1: NCP1653; SOIC-8_3.9x4.9mm_P1.27mm; MPN onsemi NCP1653ADR2G (67 kHz)

Connections:
+15V: R17.1; also elsewhere on the board
AC_NF: BR1.3; also elsewhere on the board
BLD1: R29.2, R30.1
BLD2: R30.2, R31.1
BLD3: LED1.2 (A), R31.2
GND: R28.2; also elsewhere on the board
L_SW: BR1.2; also elsewhere on the board
PFC_CS: C9.1, R26.2, U1.4 (CS)
PFC_DRV: R13.1, U1.7 (DRV); also elsewhere on the board
PFC_FB: C7.1, Q2.3 (D), R21.2, U1.1 (FB/SD)
PFC_FBD1: R18.2, R19.1
PFC_FBD2: R19.2, R20.1
PFC_FBD3: R20.2, R21.1
PFC_G: D8.1 (K), Q1.1 (G), R13.2, R14.1
PFC_IN: C8.1, R25.2, U1.3 (IN)
PFC_IND1: R22.2, R23.1
PFC_IND2: R23.2, R24.1
PFC_IND3: R24.2, R25.1
PFC_OFF: Q2.1 (G), R28.1; also elsewhere on the board
PFC_RTN: BR1.4 (-), C4.2, R15.1, R16.1, R26.1
PFC_VCC: C5.1, C6.1, R17.2, U1.8 (VCC)
PFC_VCTRL: C11.1, U1.2 (VCONTROL)
PFC_VM: C10.1, R27.1, U1.5 (VM)
PGND: C5.2, C6.2, C7.2, C8.2, C9.2, C10.2, C11.2, C12.2, C13.2, D8.2 (A), LED1.1 (K), Q1.3 (S), Q2.2 (S), R14.2, R15.2, R16.2, R27.2, U1.6 (GND); also elsewhere on the board
RECT_P: BR1.1 (+), C4.1, D7.2 (A), L2.1, R22.1
SW_PFC: D6.2 (A), L2.2, Q1.2 (D)
VBUS: C12.1, C13.1, D6.1 (K), D7.1 (K), R18.1, R29.1; also elsewhere on the board

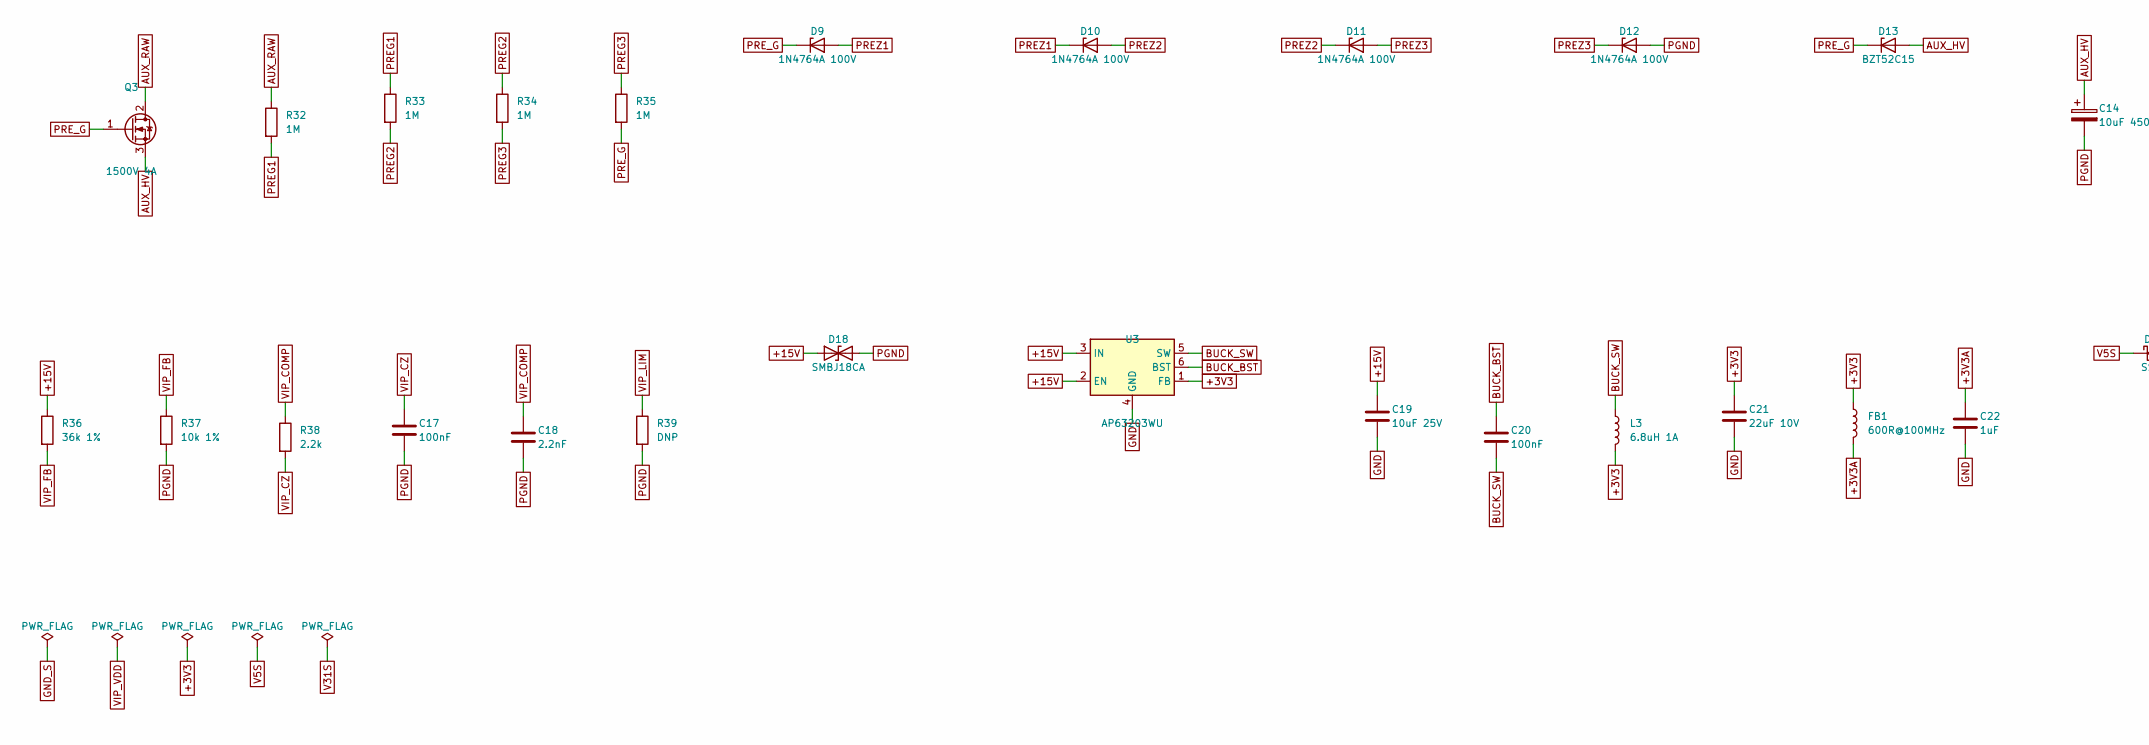
[picture p39: schematic s3_3_auxiliary_supply__viper26_fl.kicad_sch, 3 Auxiliary supply (VIPer26 flyback, 1500 V pre-regulator), part in row 1, column 1]

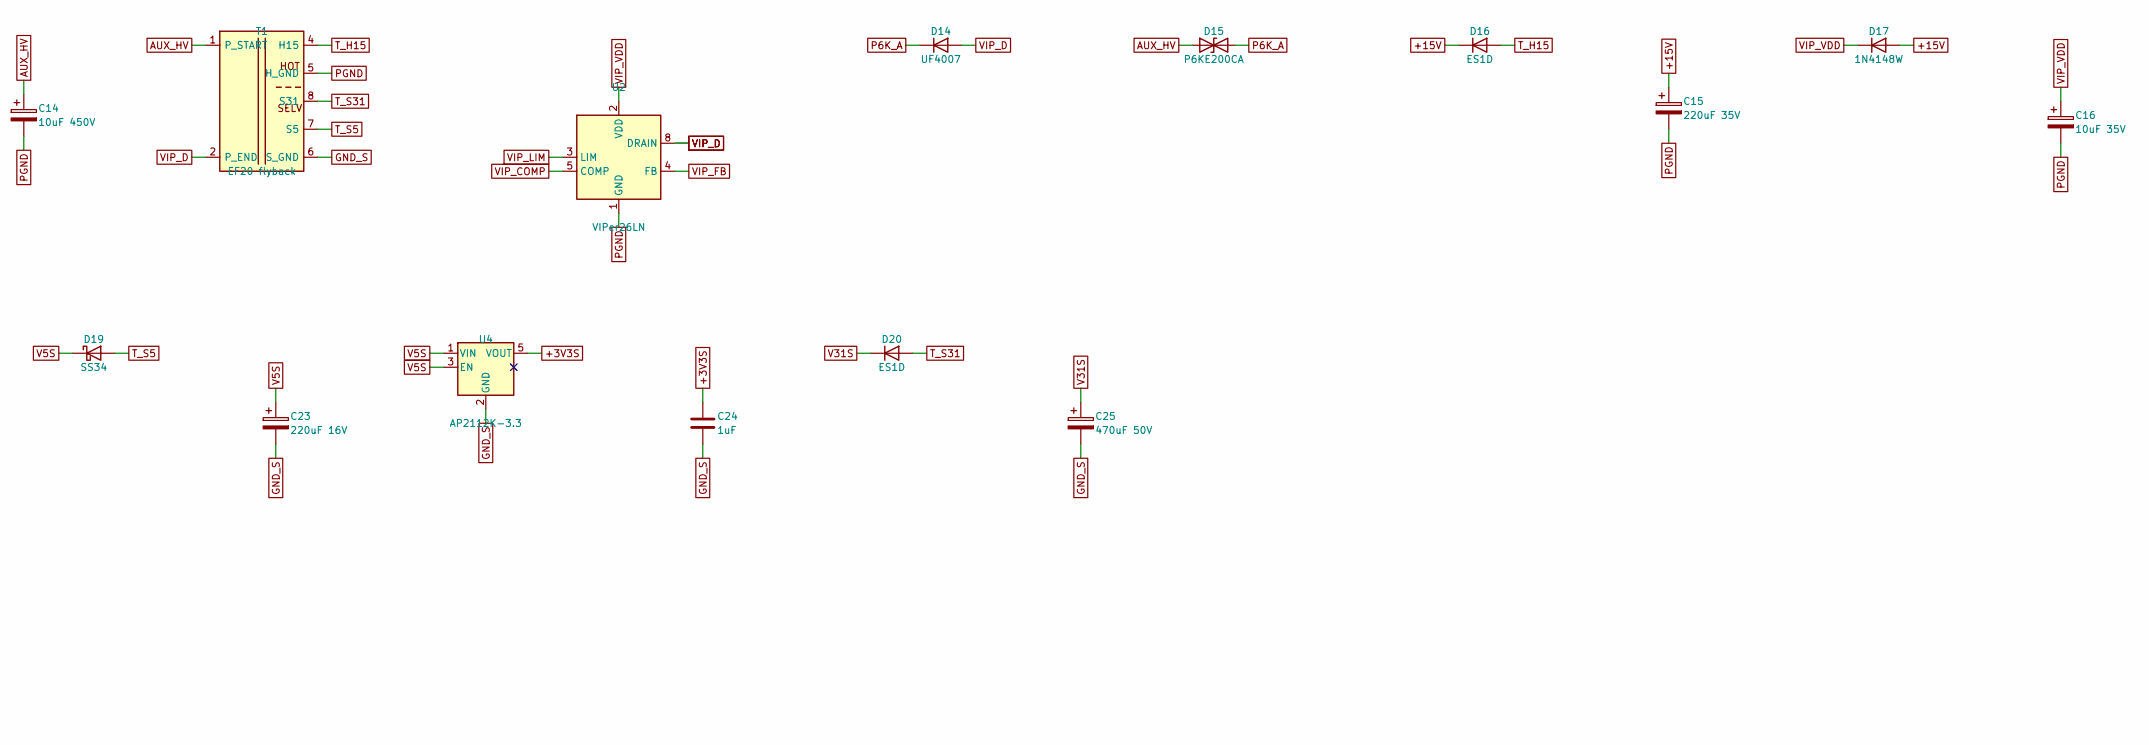
[picture p40: schematic s3_3_auxiliary_supply__viper26_fl.kicad_sch, 3 Auxiliary supply (VIPer26 flyback, 1500 V pre-regulator), part in row 1, column 2]

Parts:
C14: 10uF 450V; CP_Radial_D10.0mm_P5.00mm
C15: 220uF 35V; CP_Radial_D8.0mm_P3.50mm
C16: 10uF 35V; CP_Radial_D8.0mm_P3.50mm
C17, C20: 100nF; C_0603_1608Metric
C18: 2.2nF; C_0603_1608Metric
C19: 10uF 25V; C_1206_3216Metric
C21: 22uF 10V; C_1206_3216Metric
C22, C24: 1uF; C_0603_1608Metric
C23: 220uF 16V; CP_Radial_D8.0mm_P3.50mm
C25: 470uF 50V; CP_Radial_D10.0mm_P5.00mm
D9, D10, D11, D12: 1N4764A 100V; D_DO-41_SOD81_P10.16mm_Horizontal; MPN 1N4764A
D13: BZT52C15; D_SOD-123; MPN BZT52C15
D14: UF4007; D_DO-41_SOD81_P10.16mm_Horizontal; MPN UF4007
D15: P6KE200CA; D_DO-41_SOD81_P10.16mm_Horizontal; MPN P6KE200CA (bidirectional, 200 V clamp)
D16, D20: ES1D; D_SMA; MPN ES1D
D17: 1N4148W; D_SOD-123; MPN 1N4148W
D18: SMBJ18CA; D_SMB; MPN SMBJ18CA
D19: SS34; D_SMA; MPN SS34
FB1: 600R@100MHz; L_0603_1608Metric; MPN ferrite bead
L3: 6.8uH 1A; L_Bourns_SRN6045TA; MPN Bourns SRN6045TA-6R8M
Q3: 1500V 4A; TO-247-3_Vertical; MPN ST STW4N150 (on main heatsink, insulate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
R32, R33, R34, R35: 1M; R_1206_3216Metric
R36: 36k 1%; R_0603_1608Metric
R37: 10k 1%; R_0603_1608Metric
R38: 2.2k; R_0603_1608Metric
R39: DNP; R_0603_1608Metric
T1: EF20 flyback; Transformer_Myrra_EF20_7408x; MPN custom, see calc/transformer spec
U2: VIPer26LN; DIP-8-N6_W7.62mm; MPN ST VIPer26LN (60 kHz)
U3: AP63203WU; TSOT-23-6; MPN Diodes AP63203WU (fixed 3.3 V)
U4: AP2112K-3.3; SOT-23-5; MPN Diodes AP2112K-3.3TRG1

Connections:
+3V3: C21.1, FB1.1, L3.2, U3.1 (FB); also elsewhere on the board
+3V3A: C22.1, FB1.2; also elsewhere on the board
+3V3S: C24.1, U4.5 (VOUT); also elsewhere on the board
+15V: C15.1, C19.1, D16.1 (K), D17.2 (A), D18.1 (A1), R36.1, U3.2 (EN), U3.3 (IN); also elsewhere on the board
AUX_HV: C14.1, D13.2 (A), D15.1 (A1), Q3.3 (S), T1.1 (P_START)
AUX_RAW: Q3.2 (D), R32.1; also elsewhere on the board
BUCK_BST: C20.1, U3.6 (BST)
BUCK_SW: C20.2, L3.1, U3.5 (SW)
GND: C19.2, C21.2, C22.2, U3.4 (GND); also elsewhere on the board
GND_S: C23.2, C24.2, C25.2, T1.6 (S_GND), U4.2 (GND); also elsewhere on the board
P6K_A: D14.1 (K), D15.2 (A2)
PGND: C14.2, C15.2, C16.2, C17.2, C18.2, D12.2 (A), D18.2 (A2), R37.2, R39.2, T1.5 (H_GND), U2.1 (GND); also elsewhere on the board
PREG1: R32.2, R33.1
PREG2: R33.2, R34.1
PREG3: R34.2, R35.1
PREZ1: D9.2 (A), D10.1 (K)
PREZ2: D10.2 (A), D11.1 (K)
PREZ3: D11.2 (A), D12.1 (K)
PRE_G: D9.1 (K), D13.1 (K), Q3.1 (G), R35.2
T_H15: D16.2 (A), T1.4 (H15)
T_S5: D19.2 (A), T1.7 (S5)
T_S31: D20.2 (A), T1.8 (S31)
V5S: C23.1, D19.1 (K), U4.1 (VIN), U4.3 (EN)
V31S: C25.1, D20.1 (K); also elsewhere on the board
VIP_COMP: C18.1, R38.1, U2.5 (COMP)
VIP_CZ: C17.1, R38.2
VIP_D: D14.2 (A), T1.2 (P_END), U2.7 (DRAIN), U2.8 (DRAIN)
VIP_FB: R36.2, R37.1, U2.4 (FB)
VIP_LIM: R39.1, U2.3 (LIM)
VIP_VDD: C16.1, D17.1 (K), U2.2 (VDD)

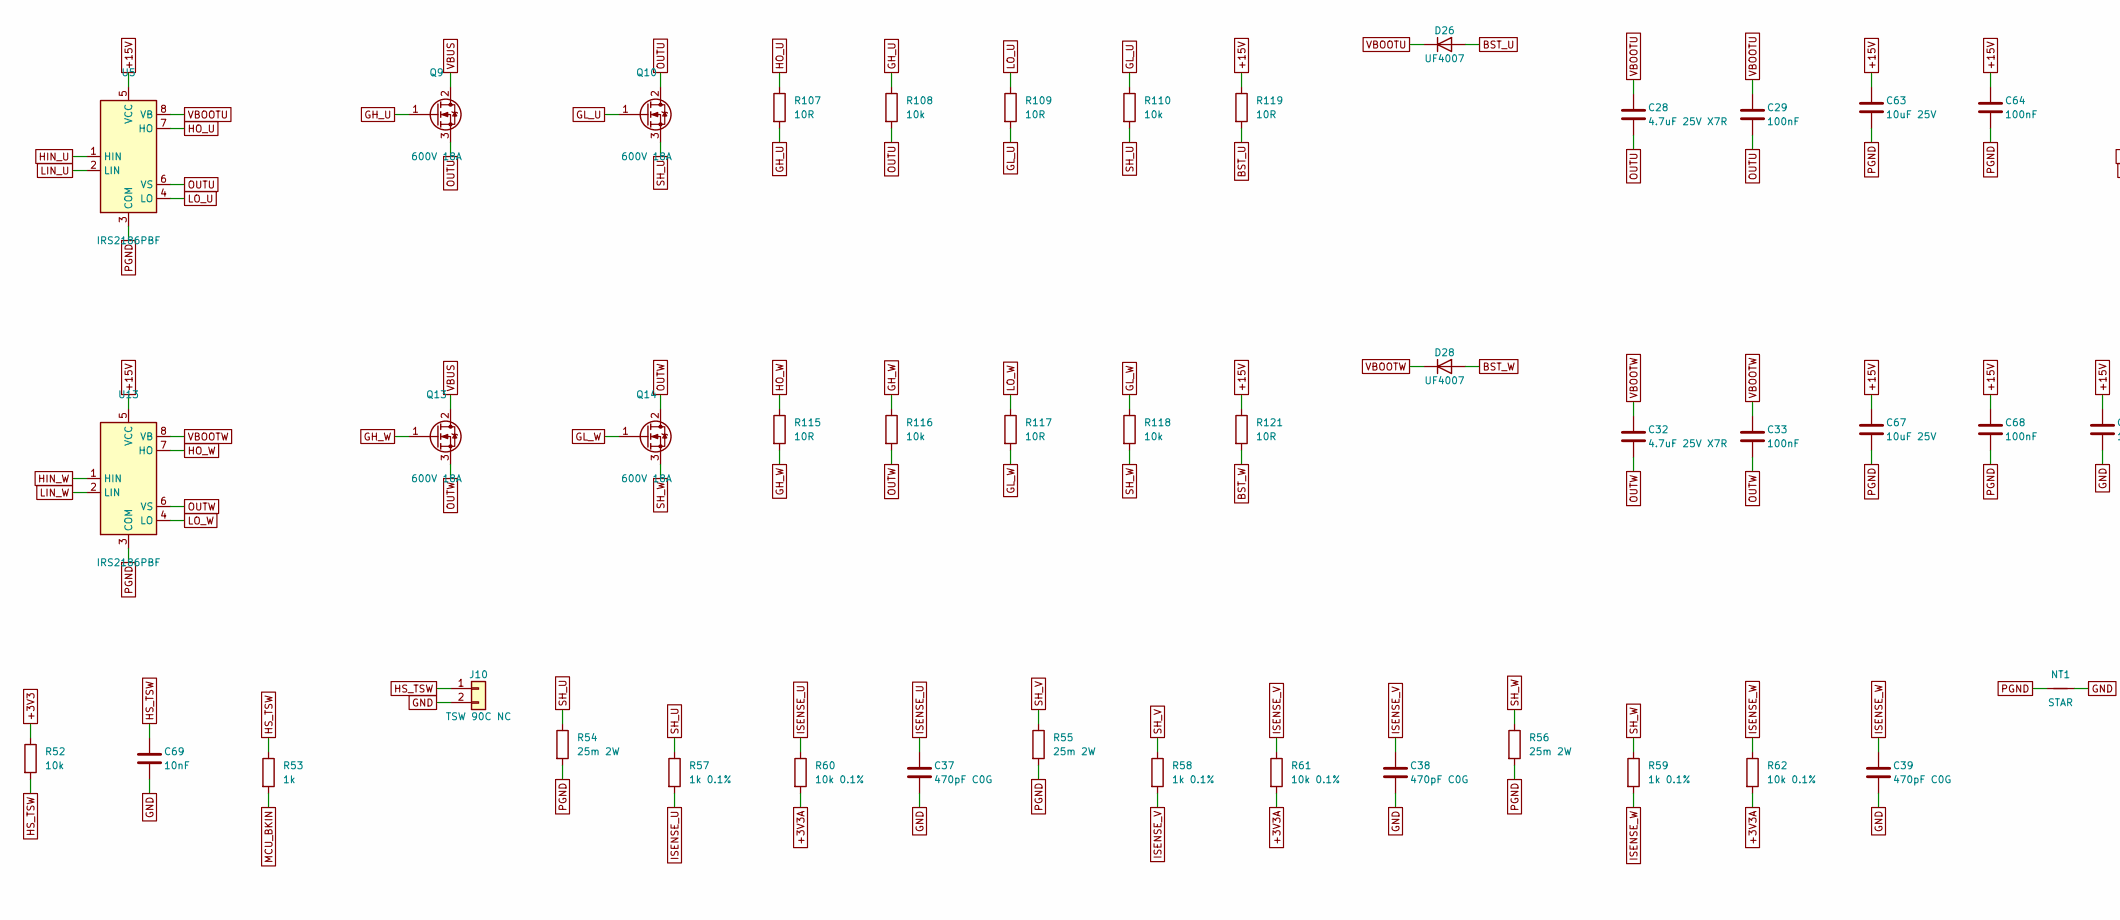
[picture p41: schematic s4_4_inverter__discrete__3_x_irs2.kicad_sch, 4 Inverter (discrete: 3 x IRS2186 + 6 x TO-247 MOSFET), 3-s…, part in row 1, column 1]

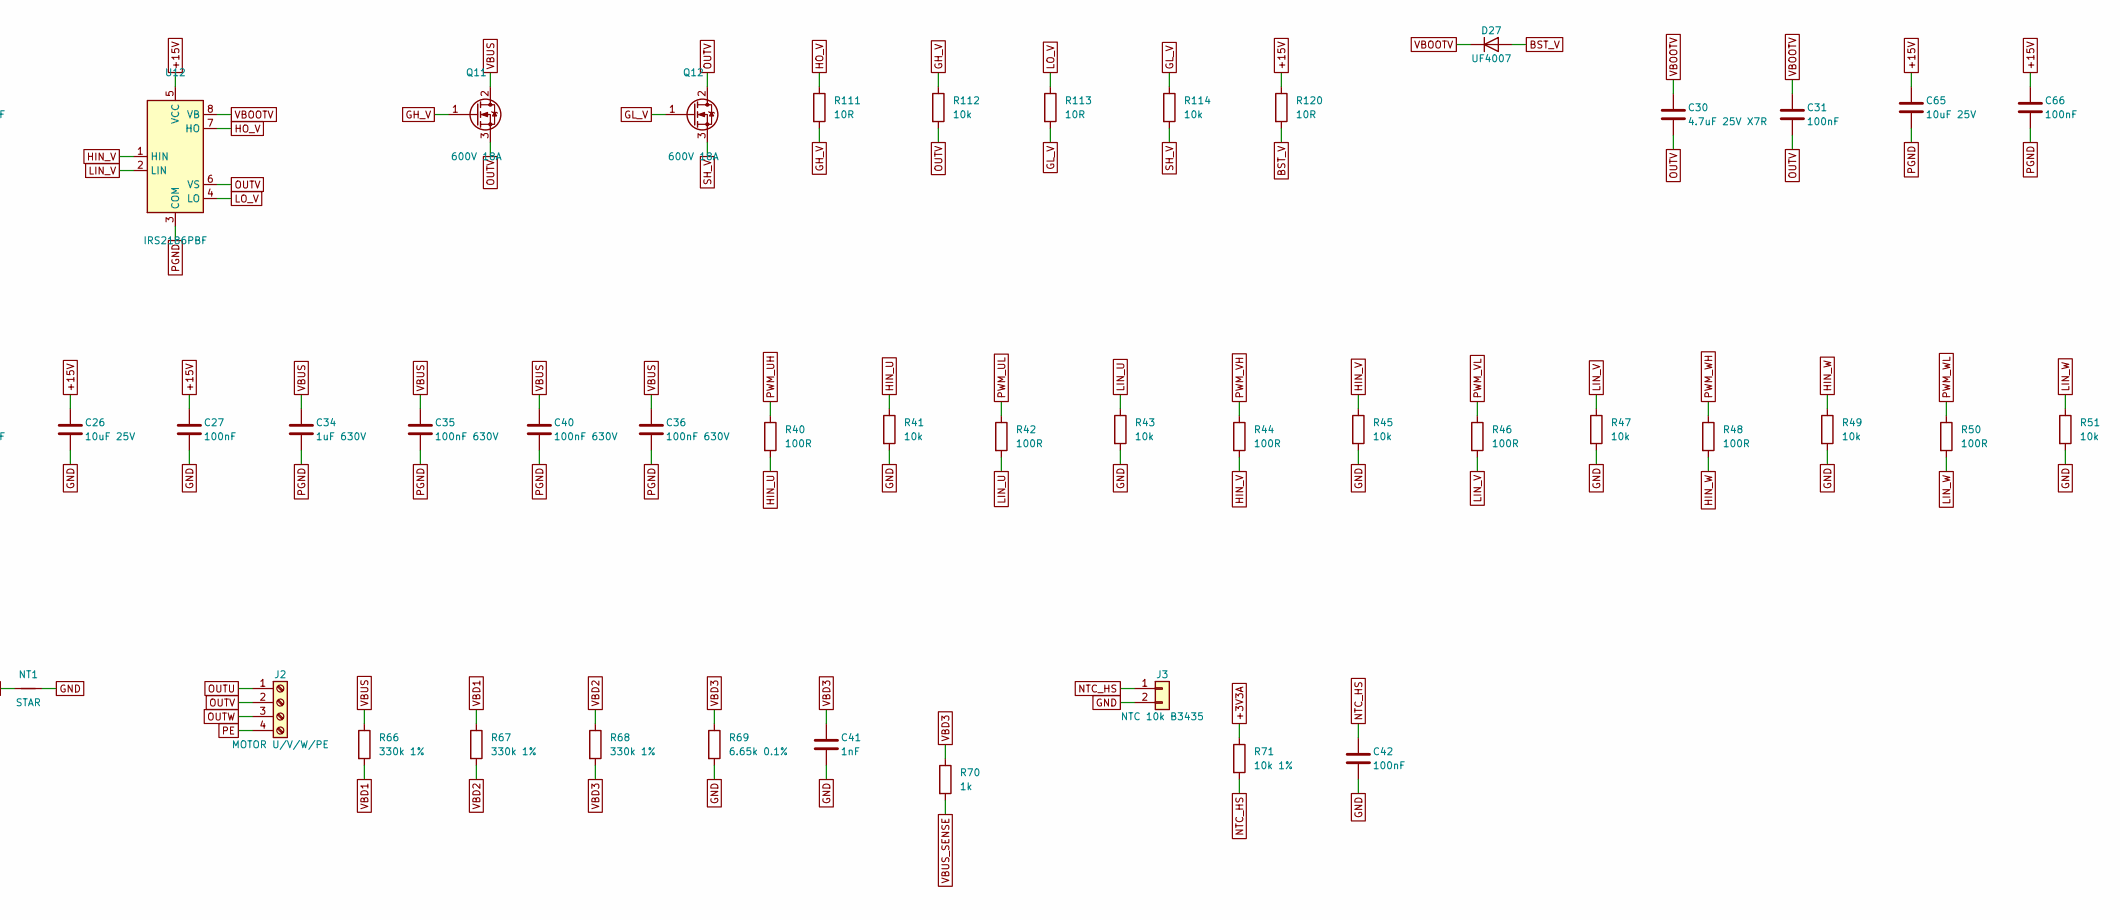
[picture p42: schematic s4_4_inverter__discrete__3_x_irs2.kicad_sch, 4 Inverter (discrete: 3 x IRS2186 + 6 x TO-247 MOSFET), 3-s…, part in row 1, column 2]

Parts:
C26, C63, C65, C67: 10uF 25V; C_1206_3216Metric
C27, C29, C31, C33, C42, C64, C66, C68: 100nF; C_0603_1608Metric
C28, C30, C32: 4.7uF 25V X7R; C_1206_3216Metric
C34: 1uF 630V; C_Rect_L26.5mm_W8.5mm_P22.50mm_MKS4
C35, C36, C40: 100nF 630V; C_Rect_L18.0mm_W6.0mm_P15.00mm_FKS3_FKP3
C37, C38, C39: 470pF C0G; C_0603_1608Metric
C41: 1nF; C_0603_1608Metric
C69: 10nF; C_0603_1608Metric
D26, D27, D28: UF4007; D_DO-41_SOD81_P10.16mm_Horizontal; MPN UF4007 (1000 V, 75 ns)
J2: MOTOR U/V/W/PE; TerminalBlock_Phoenix_MKDS-1,5-4-5.08_1x04_P5.08mm_Horizont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
J3: NTC 10k B3435; PinHeader_1x02_P2.54mm_Vertical; MPN screw-lug NTC 10k B3435 on heatsink
J10: TSW 90C NC; PinHeader_1x02_P2.54mm_Vertical; MPN KSD301 90 C normally closed, on heatsink
NT1: STAR; NetTie-2_SMD_Pad0.5mm
Q9, Q10, Q11, Q12, Q13, Q14: 600V 18A; TO-247-3_Vertical; MPN ST STW24N60DM2 (fast body diode) / alt.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
R40, R42, R44, R46, R48, R50: 100R; R_0603_1608Metric
R41, R43, R45, R47, R49, R51, R52, R108, R110, R112, R114, R116, R118: 10k; R_0603_1608Metric
R53, R70: 1k; R_0603_1608Metric
R54, R55, R56: 25m 2W; R_2512_6332Metric
R57, R58, R59: 1k 0.1%; R_0603_1608Metric
R60, R61, R62: 10k 0.1%; R_0603_1608Metric
R66, R67, R68: 330k 1%; R_1206_3216Metric
R69: 6.65k 0.1%; R_0603_1608Metric
R71: 10k 1%; R_0603_1608Metric
R107, R109, R111, R113, R115, R117, R119, R120, R121: 10R; R_1206_3216Metric
U5, U12, U13: IRS2186PBF; DIP-8_W7.62mm_Socket; MPN Infineon IRS2186PBF (DIP-8 in socket)

Connections:
+3V3: R52.1; also elsewhere on the board
+3V3A: R60.2, R61.2, R62.2, R71.1; also elsewhere on the board
+15V: C26.1, C27.1, C63.1, C64.1, C65.1, C66.1, C67.1, C68.1, R119.1, R120.1, R121.1, U5.5 (VCC), U12.5 (VCC), U13.5 (VCC); also elsewhere on the board
BST_U: D26.2 (A), R119.2
BST_V: D27.2 (A), R120.2
BST_W: D28.2 (A), R121.2
GH_U: Q9.1 (G), R107.2, R108.1
GH_V: Q11.1 (G), R111.2, R112.1
GH_W: Q13.1 (G), R115.2, R116.1
GL_U: Q10.1 (G), R109.2, R110.1
GL_V: Q12.1 (G), R113.2, R114.1
GL_W: Q14.1 (G), R117.2, R118.1
GND: C26.2, C27.2, C37.2, C38.2, C39.2, C41.2, C42.2, C69.2, J3.2, J10.2, NT1.2, R41.2, R43.2, R45.2, R47.2, R49.2, R51.2, R69.2; also elsewhere on the board
HIN_U: R40.2, R41.1, U5.1 (HIN)
HIN_V: R44.2, R45.1, U12.1 (HIN)
HIN_W: R48.2, R49.1, U13.1 (HIN)
HO_U: R107.1, U5.7 (HO)
HO_V: R111.1, U12.7 (HO)
HO_W: R115.1, U13.7 (HO)
HS_TSW: C69.1, J10.1, R52.2, R53.1
ISENSE_U: C37.1, R57.2, R60.1; also elsewhere on the board
ISENSE_V: C38.1, R58.2, R61.1; also elsewhere on the board
ISENSE_W: C39.1, R59.2, R62.1; also elsewhere on the board
LIN_U: R42.2, R43.1, U5.2 (LIN)
LIN_V: R46.2, R47.1, U12.2 (LIN)
LIN_W: R50.2, R51.1, U13.2 (LIN)
LO_U: R109.1, U5.4 (LO)
LO_V: R113.1, U12.4 (LO)
LO_W: R117.1, U13.4 (LO)
MCU_BKIN: R53.2; also elsewhere on the board
NTC_HS: C42.1, J3.1, R71.2; also elsewhere on the board
OUTU: C28.2, C29.2, J2.1, Q9.3 (S), Q10.2 (D), R108.2, U5.6 (VS)
OUTV: C30.2, C31.2, J2.2, Q11.3 (S), Q12.2 (D), R112.2, U12.6 (VS)
OUTW: C32.2, C33.2, J2.3, Q13.3 (S), Q14.2 (D), R116.2, U13.6 (VS)
PE: J2.4; also elsewhere on the board
PGND: C34.2, C35.2, C36.2, C40.2, C63.2, C64.2, C65.2, C66.2, C67.2, C68.2, NT1.1, R54.2, R55.2, R56.2, U5.3 (COM), U12.3 (COM), U13.3 (COM); also elsewhere on the board
PWM_UH: R40.1; also elsewhere on the board
PWM_UL: R42.1; also elsewhere on the board
PWM_VH: R44.1; also elsewhere on the board
PWM_VL: R46.1; also elsewhere on the board
PWM_WH: R48.1; also elsewhere on the board
PWM_WL: R50.1; also elsewhere on the board
SH_U: Q10.3 (S), R54.1, R57.1, R110.2
SH_V: Q12.3 (S), R55.1, R58.1, R114.2
SH_W: Q14.3 (S), R56.1, R59.1, R118.2
VBD1: R66.2, R67.1
VBD2: R67.2, R68.1
VBD3: C41.1, R68.2, R69.1, R70.1
VBOOTU: C28.1, C29.1, D26.1 (K), U5.8 (VB)
VBOOTV: C30.1, C31.1, D27.1 (K), U12.8 (VB)
VBOOTW: C32.1, C33.1, D28.1 (K), U13.8 (VB)
VBUS: C34.1, C35.1, C36.1, C40.1, Q9.2 (D), Q11.2 (D), Q13.2 (D), R66.1; also elsewhere on the board
VBUS_SENSE: R70.2; also elsewhere on the board

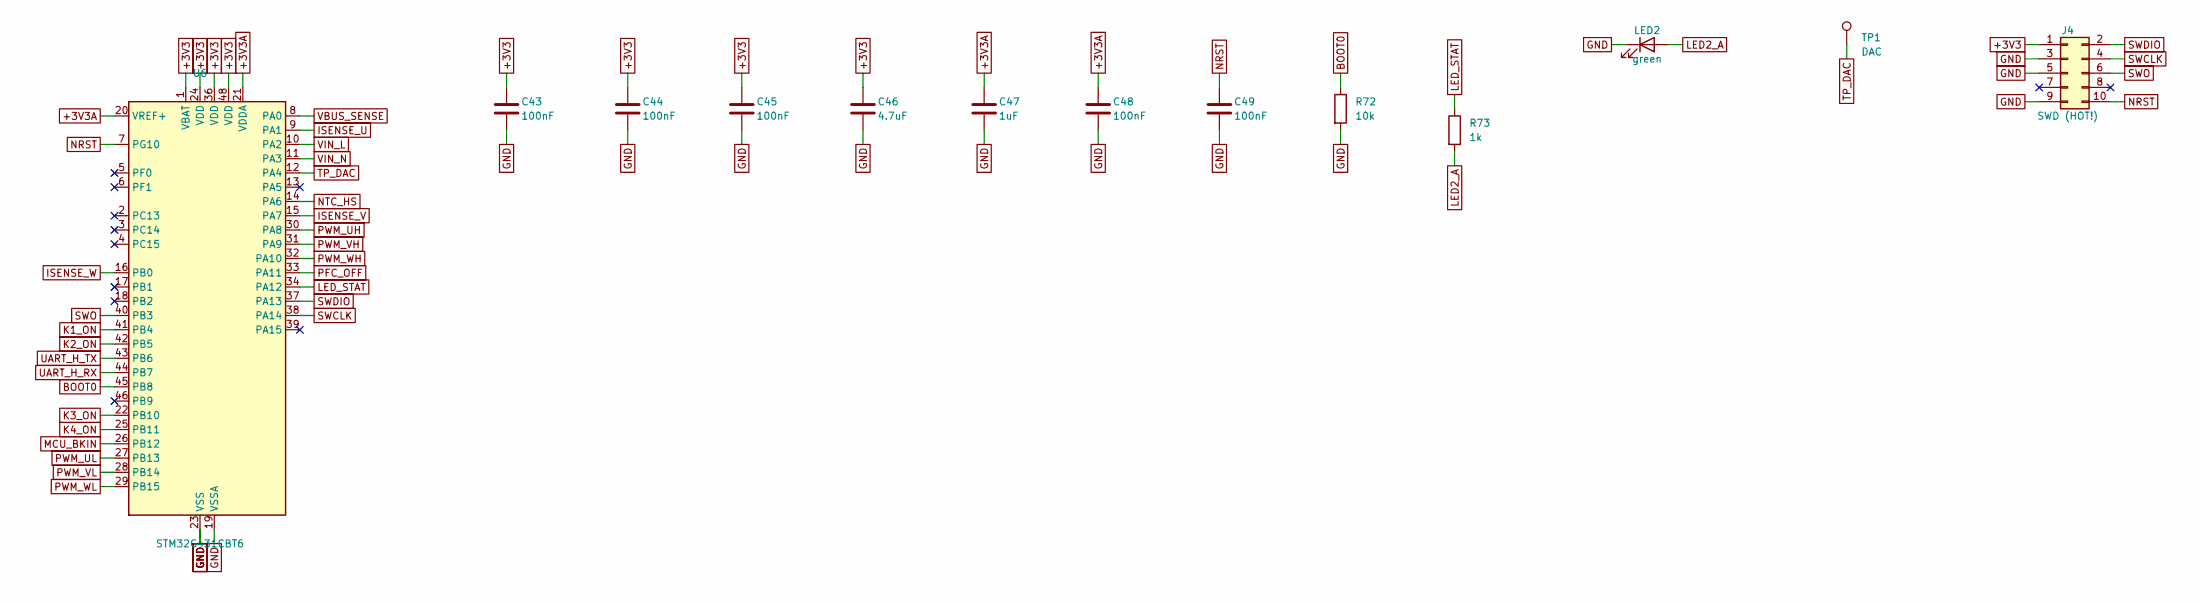
[picture p43: schematic s5_5_mcu_stm32g431cbt6__hot_side.kicad_sch, 5 MCU STM32G431CBT6 (hot side)]

Parts:
C43, C44, C45, C48, C49: 100nF; C_0603_1608Metric
C46: 4.7uF; C_0805_2012Metric
C47: 1uF; C_0603_1608Metric
J4: SWD (HOT!); PinHeader_2x05_P1.27mm_Vertical
LED2: green; LED_0805_2012Metric
R72: 10k; R_0603_1608Metric
R73: 1k; R_0603_1608Metric
TP1: DAC; TestPoint_Pad_D1.5mm
U6: STM32G431CBT6; LQFP-48_7x7mm_P0.5mm; MPN ST STM32G431CBT6

Connections:
+3V3: C43.1, C44.1, C45.1, C46.1, J4.1, U6.1 (VBAT), U6.24 (VDD), U6.36 (VDD), U6.48 (VDD); also elsewhere on the board
+3V3A: C47.1, C48.1, U6.20 (VREF+), U6.21 (VDDA); also elsewhere on the board
BOOT0: R72.1, U6.45 (PB8)
GND: C43.2, C44.2, C45.2, C46.2, C47.2, C48.2, C49.2, J4.3, J4.5, J4.9, LED2.1 (K), R72.2, U6.19 (VSSA), U6.23 (VSS), U6.35 (VSS), U6.47 (VSS); also elsewhere on the board
ISENSE_U: U6.9 (PA1); also elsewhere on the board
ISENSE_V: U6.15 (PA7); also elsewhere on the board
ISENSE_W: U6.16 (PB0); also elsewhere on the board
K1_ON: U6.41 (PB4); also elsewhere on the board
K2_ON: U6.42 (PB5); also elsewhere on the board
K3_ON: U6.22 (PB10); also elsewhere on the board
K4_ON: U6.25 (PB11); also elsewhere on the board
LED2_A: LED2.2 (A), R73.2
LED_STAT: R73.1, U6.34 (PA12)
MCU_BKIN: U6.26 (PB12); also elsewhere on the board
NRST: C49.1, J4.10, U6.7 (PG10)
NTC_HS: U6.14 (PA6); also elsewhere on the board
PFC_OFF: U6.33 (PA11); also elsewhere on the board
PWM_UH: U6.30 (PA8); also elsewhere on the board
PWM_UL: U6.27 (PB13); also elsewhere on the board
PWM_VH: U6.31 (PA9); also elsewhere on the board
PWM_VL: U6.28 (PB14); also elsewhere on the board
PWM_WH: U6.32 (PA10); also elsewhere on the board
PWM_WL: U6.29 (PB15); also elsewhere on the board
SWCLK: J4.4, U6.38 (PA14)
SWDIO: J4.2, U6.37 (PA13)
SWO: J4.6, U6.40 (PB3)
TP_DAC: TP1.1, U6.12 (PA4)
UART_H_RX: U6.44 (PB7); also elsewhere on the board
UART_H_TX: U6.43 (PB6); also elsewhere on the board
VBUS_SENSE: U6.8 (PA0); also elsewhere on the board
VIN_L: U6.10 (PA2); also elsewhere on the board
VIN_N: U6.11 (PA3); also elsewhere on the board

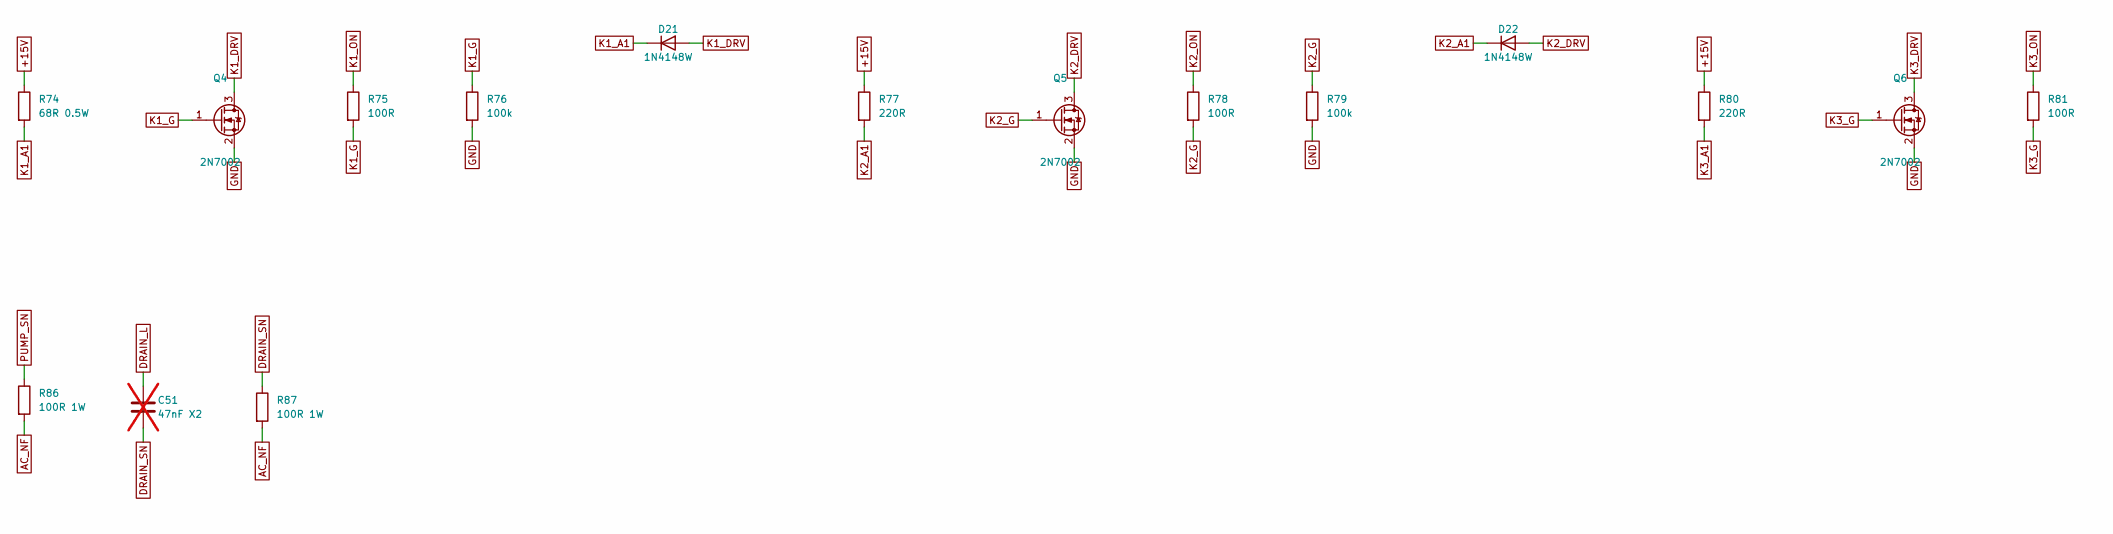
[picture p44: schematic s6_6_relay_drivers__pump_and_drai.kicad_sch, 6 Relay drivers, pump and drain outputs (220 VAC), part in row 1, column 1]

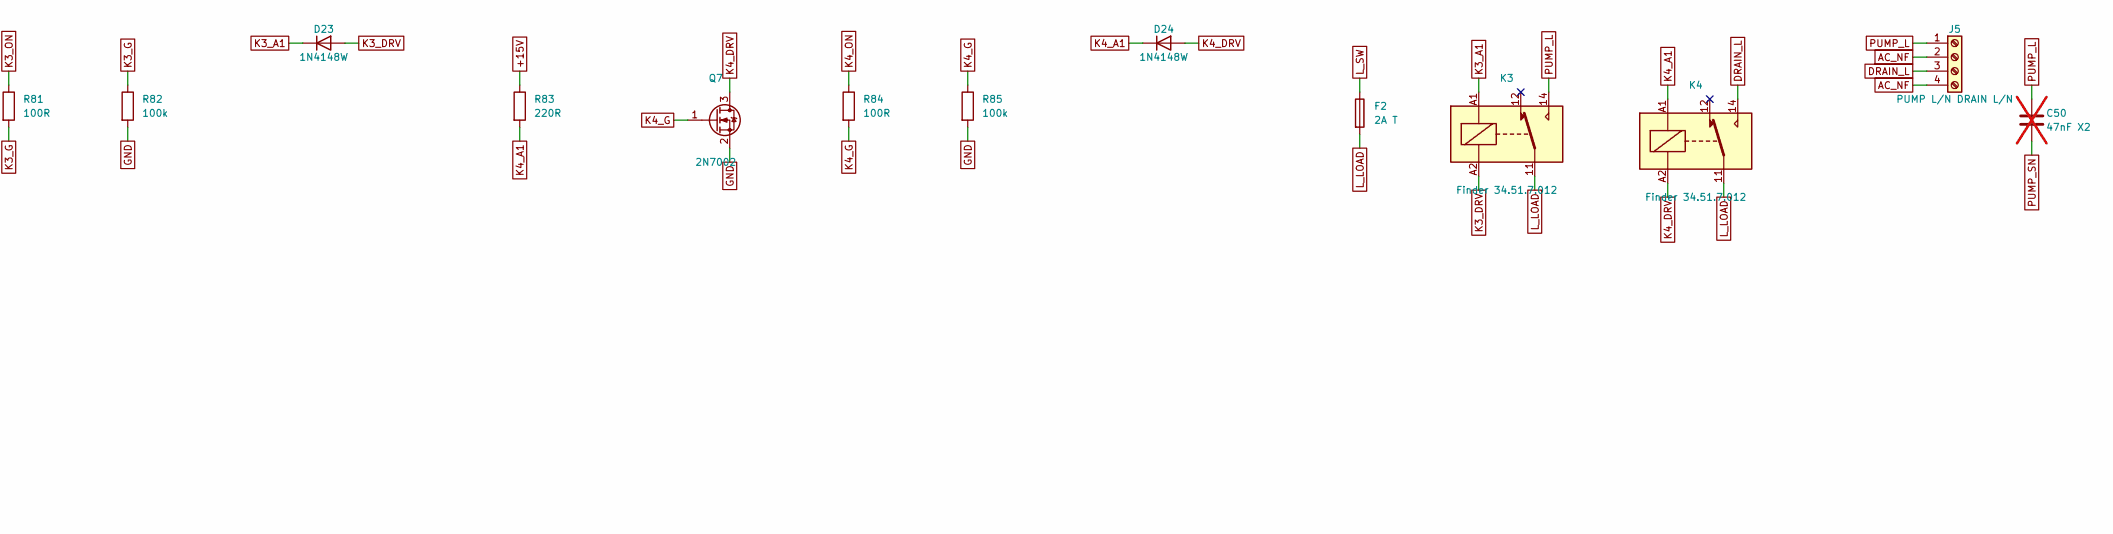
[picture p45: schematic s6_6_relay_drivers__pump_and_drai.kicad_sch, 6 Relay drivers, pump and drain outputs (220 VAC), part in row 1, column 2]

Parts:
C50, C51: 47nF X2; C_Rect_L18.0mm_W6.0mm_P15.00mm_FKS3_FKP3; not fitted
D21, D22, D23, D24: 1N4148W; D_SOD-123; MPN 1N4148W
F2: 2A T; Fuseholder_Cylinder-5x20mm_Bulgin_FX0457_Horizontal_Closed; MPN 5x20 2 A time-lag
J5: PUMP L/N DRAIN L/N; TerminalBlock_Phoenix_MKDS-1,5-4-5.08_1x04_P5.08mm_Horizont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
K3, K4: Finder 34.51.7.012; Relay_SPDT_Finder_34.51_Vertical; MPN Finder 34.51.7.012.0010
Q4, Q5, Q6, Q7: 2N7002; SOT-23; MPN 2N7002
R74: 68R 0.5W; R_1206_3216Metric
R75, R78, R81, R84: 100R; R_0603_1608Metric
R76, R79, R82, R85: 100k; R_0603_1608Metric
R77, R80, R83: 220R; R_0603_1608Metric
R86, R87: 100R 1W; R_2512_6332Metric

Connections:
+15V: R74.1, R77.1, R80.1, R83.1; also elsewhere on the board
AC_NF: J5.2, J5.4, R86.2, R87.2; also elsewhere on the board
DRAIN_L: C51.1, J5.3, K4.14
DRAIN_SN: C51.2, R87.1
GND: Q4.2 (S), Q5.2 (S), Q6.2 (S), Q7.2 (S), R76.2, R79.2, R82.2, R85.2; also elsewhere on the board
K1_A1: D21.1 (K), R74.2; also elsewhere on the board
K1_DRV: D21.2 (A), Q4.3 (D); also elsewhere on the board
K1_G: Q4.1 (G), R75.2, R76.1
K1_ON: R75.1; also elsewhere on the board
K2_A1: D22.1 (K), R77.2; also elsewhere on the board
K2_DRV: D22.2 (A), Q5.3 (D); also elsewhere on the board
K2_G: Q5.1 (G), R78.2, R79.1
K2_ON: R78.1; also elsewhere on the board
K3_A1: D23.1 (K), K3.A1, R80.2
K3_DRV: D23.2 (A), K3.A2, Q6.3 (D)
K3_G: Q6.1 (G), R81.2, R82.1
K3_ON: R81.1; also elsewhere on the board
K4_A1: D24.1 (K), K4.A1, R83.2
K4_DRV: D24.2 (A), K4.A2, Q7.3 (D)
K4_G: Q7.1 (G), R84.2, R85.1
K4_ON: R84.1; also elsewhere on the board
L_LOAD: F2.2, K3.11, K4.11
L_SW: F2.1; also elsewhere on the board
PUMP_L: C50.1, J5.1, K3.14
PUMP_SN: C50.2, R86.1
