faragamco-eng/Multiact/hardware/v2/out/kicad/bldc_cooler_v2.kicad_pcb

## KiCad design hardware/v2/out/kicad/bldc_cooler_v2.kicad_pcb (continued)

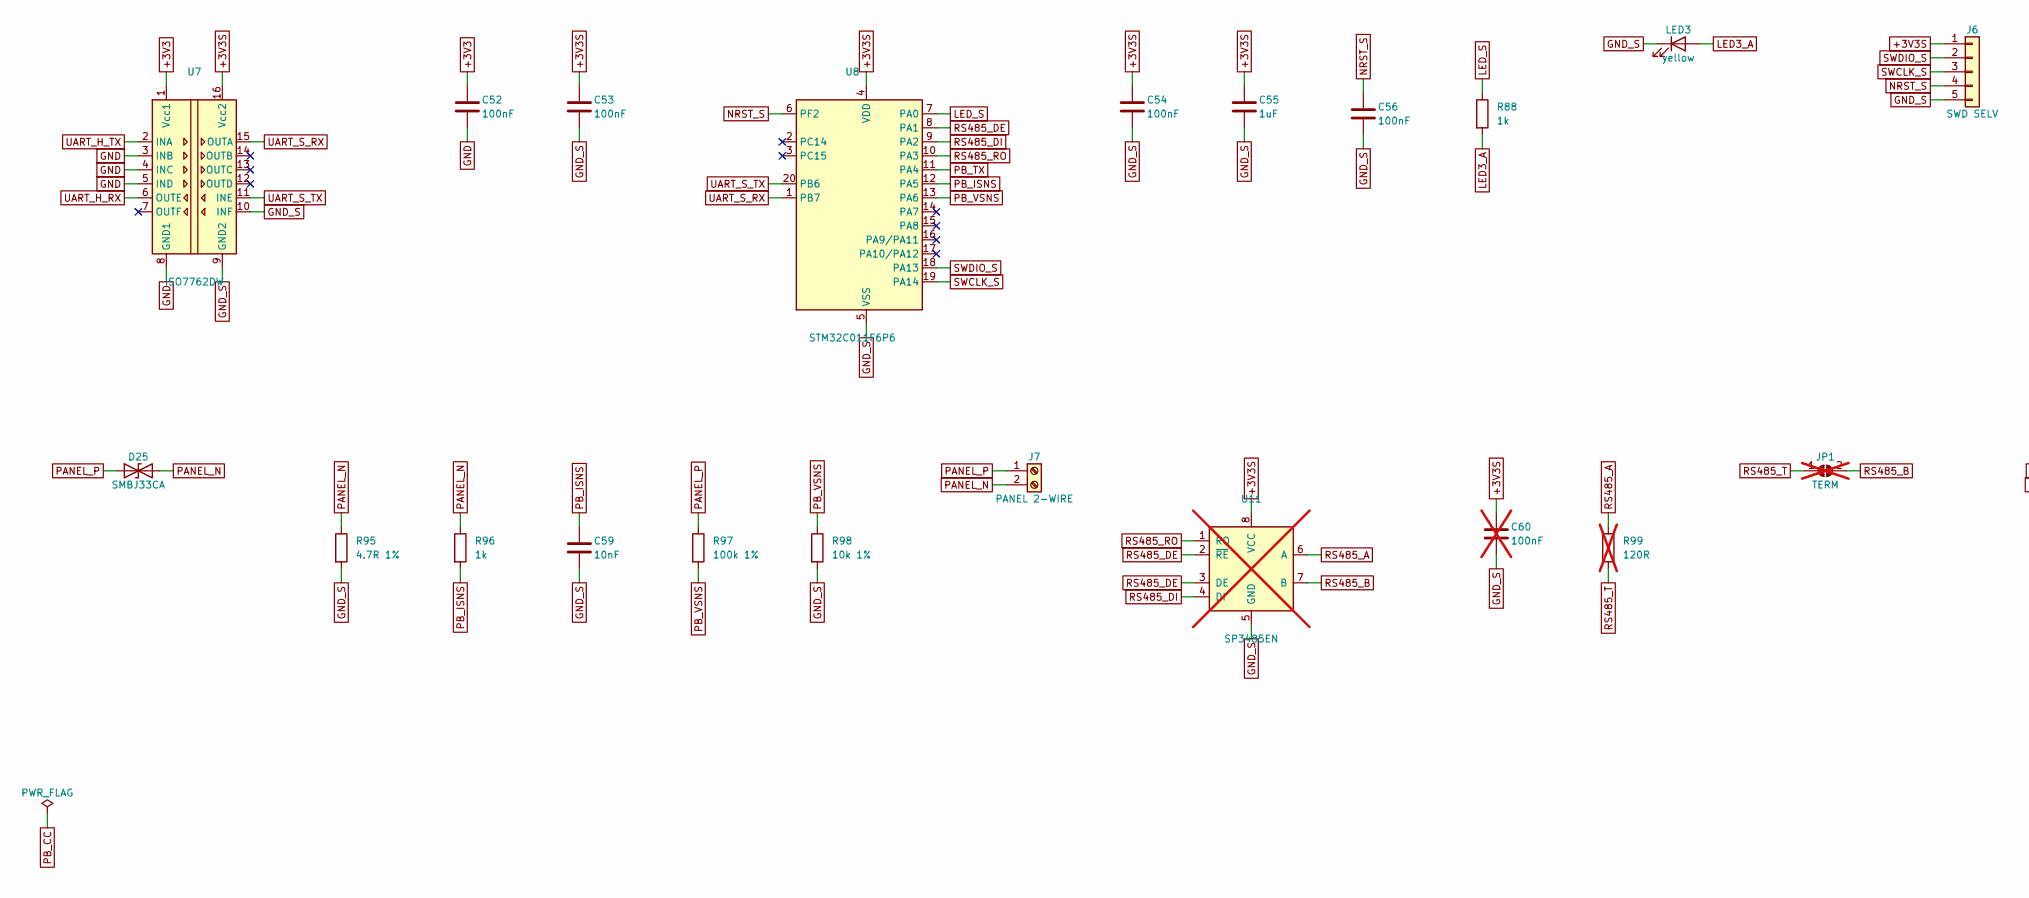
[picture p46: schematic s7_7_isolated_side__isolator__phy.kicad_sch, 7 Isolated side: isolator, PHY MCU, 2-wire panel bus, RS-48…, part in row 1, column 1]

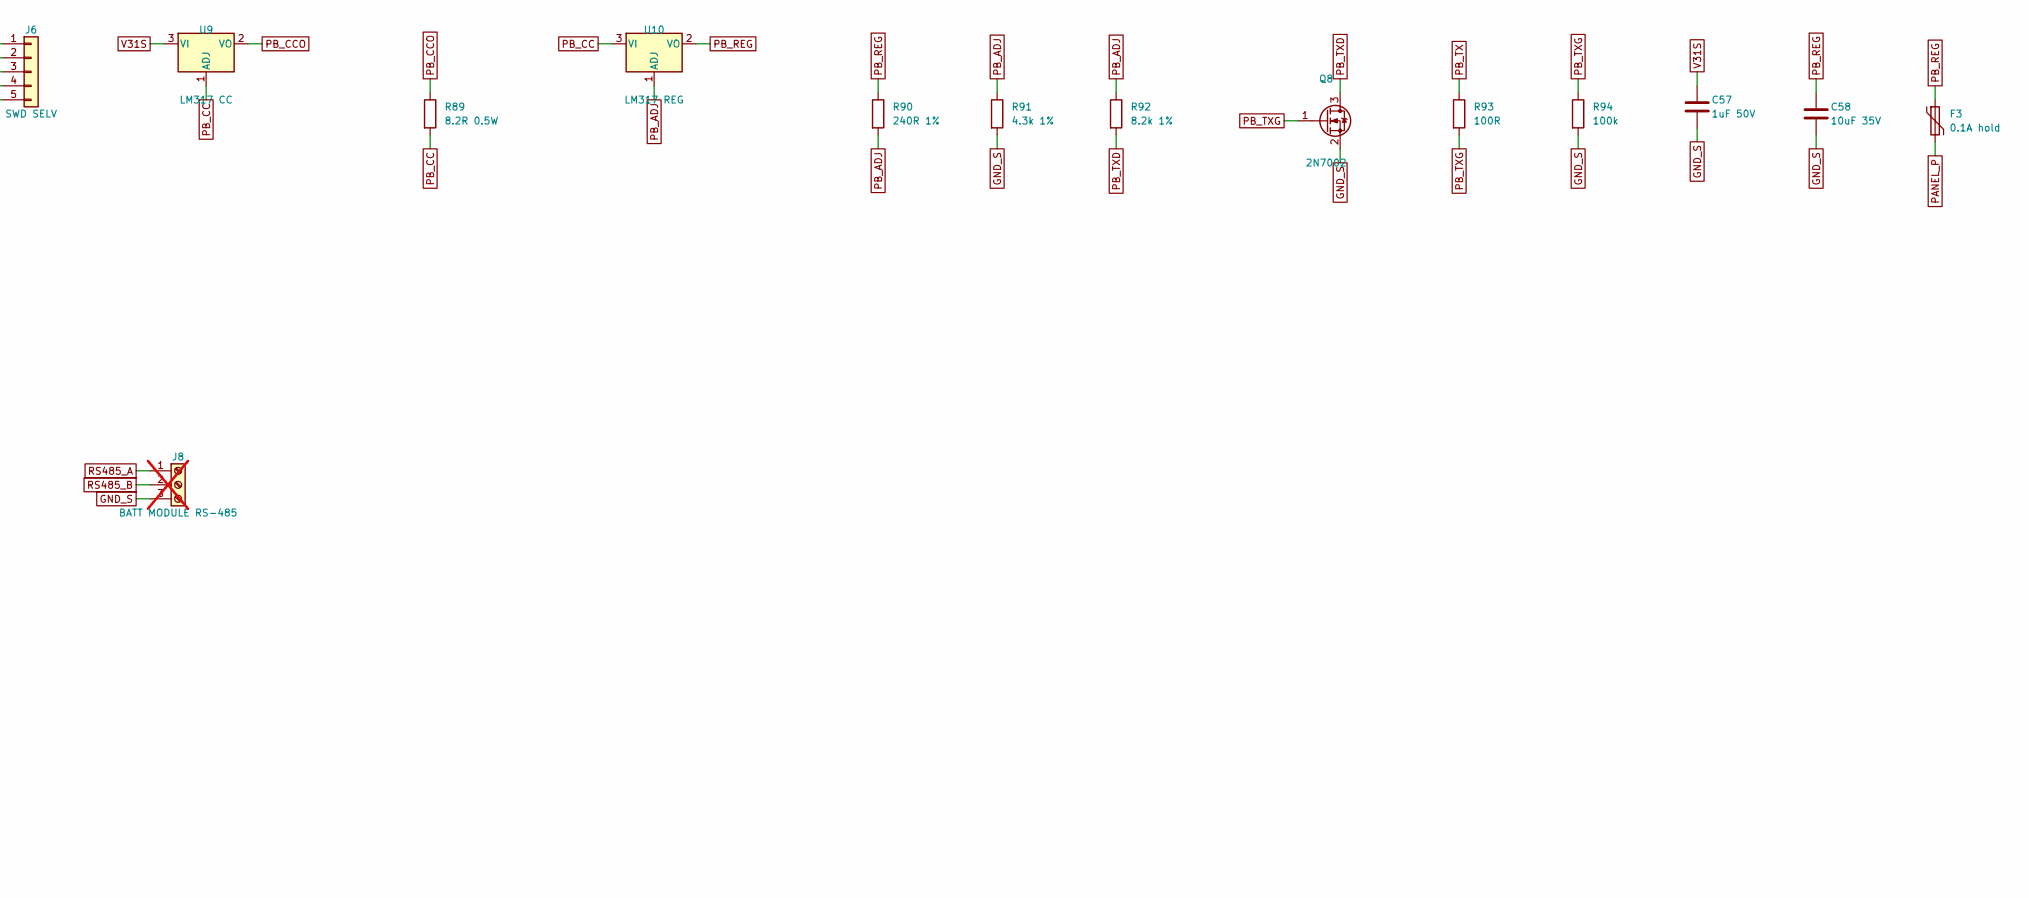
[picture p47: schematic s7_7_isolated_side__isolator__phy.kicad_sch, 7 Isolated side: isolator, PHY MCU, 2-wire panel bus, RS-48…, part in row 1, column 2]

Parts:
C52, C53, C54, C56: 100nF; C_0603_1608Metric
C55: 1uF; C_0603_1608Metric
C57: 1uF 50V; C_1206_3216Metric
C58: 10uF 35V; C_1206_3216Metric
C59: 10nF; C_0603_1608Metric
C60: 100nF; C_0603_1608Metric; not fitted
D25: SMBJ33CA; D_SMB; MPN SMBJ33CA
F3: 0.1A hold; Fuse_1812_4532Metric; MPN Bourns MF-MSMF010
J6: SWD SELV; PinHeader_1x05_P2.54mm_Vertical
J7: PANEL 2-WIRE; TerminalBlock_Phoenix_MKDS-1,5-2-5.08_1x02_P5.08mm_Horizont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
J8: BATT MODULE RS-485; TerminalBlock_Phoenix_MKDS-1,5-3-5.08_1x03_P5.08mm_Horizont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; not fitted
JP1: TERM; SolderJumper-2_P1.3mm_Open_Pad1.0x1.5mm; not fitted
LED3: yellow; LED_0805_2012Metric
Q8: 2N7002; SOT-23; MPN 2N7002
R88, R96: 1k; R_0603_1608Metric
R89: 8.2R 0.5W; R_1206_3216Metric
R90: 240R 1%; R_0603_1608Metric
R91: 4.3k 1%; R_0603_1608Metric
R92: 8.2k 1%; R_0603_1608Metric
R93: 100R; R_0603_1608Metric
R94: 100k; R_0603_1608Metric
R95: 4.7R 1%; R_1206_3216Metric
R97: 100k 1%; R_0603_1608Metric
R98: 10k 1%; R_0603_1608Metric
R99: 120R; R_0603_1608Metric; not fitted
U7: ISO7762DW; SOIC-16W_7.5x10.3mm_P1.27mm; MPN TI ISO7762DWR (reinforced 5 kVrms, SOIC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
U8: STM32C011F6P6; TSSOP-20_4.4x6.5mm_P0.65mm; MPN ST STM32C011F6P6
U9: LM317 CC; TO-220-3_Vertical; MPN LM317T (small heatsink)
U10: LM317 REG; TO-220-3_Vertical; MPN LM317T
U11: SP3485EN; SOIC-8_3.9x4.9mm_P1.27mm; MPN MaxLinear SP3485EN (3.3 V half duplex); not fitted

Connections:
+3V3: C52.1, U7.1 (Vcc1); also elsewhere on the board
+3V3S: C53.1, C54.1, C55.1, C60.1, J6.1, U7.16 (Vcc2), U8.4 (VDD), U11.8 (VCC); also elsewhere on the board
GND: C52.2, U7.3 (INB), U7.4 (INC), U7.5 (IND), U7.8 (GND1); also elsewhere on the board
GND_S: C53.2, C54.2, C55.2, C56.2, C57.2, C58.2, C59.2, C60.2, J6.5, J8.3, LED3.1 (K), Q8.2 (S), R91.2, R94.2, R95.2, R98.2, U7.9 (GND2), U7.10 (INF), U8.5 (VSS), U11.5 (GND); also elsewhere on the board
LED3_A: LED3.2 (A), R88.2
LED_S: R88.1, U8.7 (PA0)
NRST_S: C56.1, J6.4, U8.6 (PF2)
PANEL_N: D25.2 (A2), J7.2, R95.1, R96.1
PANEL_P: D25.1 (A1), F3.2, J7.1, R97.1; also elsewhere on the board
PB_ADJ: R90.2, R91.1, R92.1, U10.1 (ADJ)
PB_CC: R89.2, U9.1 (ADJ), U10.3 (VI)
PB_CCO: R89.1, U9.2 (VO)
PB_ISNS: C59.1, R96.2, U8.12 (PA5)
PB_REG: C58.1, F3.1, R90.1, U10.2 (VO)
PB_TX: R93.1, U8.11 (PA4)
PB_TXD: Q8.3 (D), R92.2
PB_TXG: Q8.1 (G), R93.2, R94.1
PB_VSNS: R97.2, R98.1, U8.13 (PA6)
RS485_A: J8.1, R99.1, U11.6 (A)
RS485_B: J8.2, JP1.2 (B), U11.7 (B)
RS485_DE: U8.8 (PA1), U11.2 (~RE), U11.3 (DE)
RS485_DI: U8.9 (PA2), U11.4 (DI)
RS485_RO: U8.10 (PA3), U11.1 (RO)
RS485_T: JP1.1 (A), R99.2
SWCLK_S: J6.3, U8.19 (PA14)
SWDIO_S: J6.2, U8.18 (PA13)
UART_H_RX: U7.6 (OUTE); also elsewhere on the board
UART_H_TX: U7.2 (INA); also elsewhere on the board
UART_S_RX: U7.15 (OUTA), U8.1 (PB7)
UART_S_TX: U7.11 (INE), U8.20 (PB6)
V31S: C57.1, U9.3 (VI); also elsewhere on the board

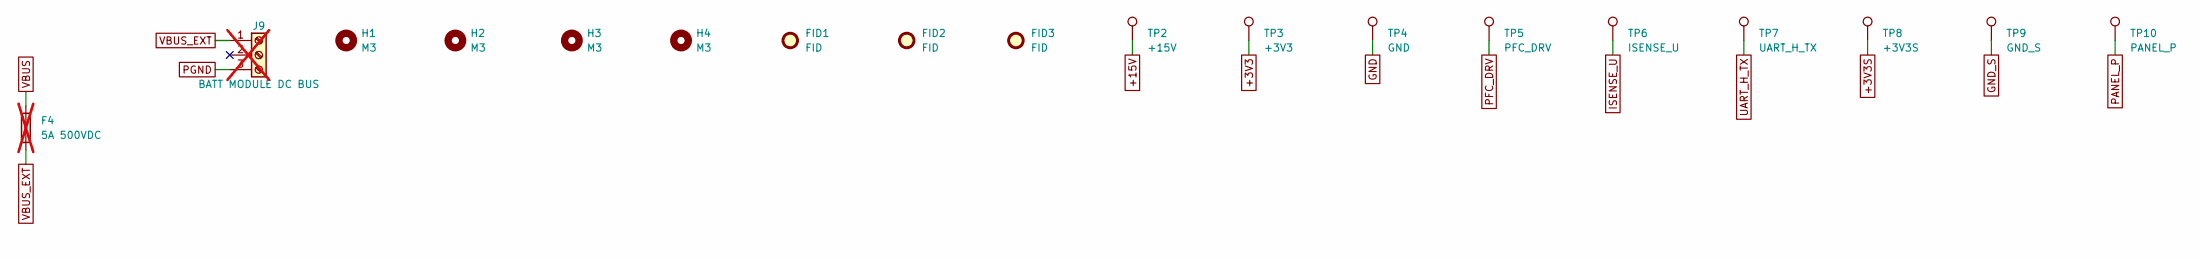
[picture p48: schematic s8_8_option_battery_module__dnp_i.kicad_sch, 8 OPTION battery module (DNP in the mains-only version), me…]

Parts:
F4: 5A 500VDC; Fuseholder_Cylinder-5x20mm_Bulgin_FX0457_Horizontal_Closed; MPN 5x20 ceramic, DC rated >= 500 V (e.g. L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; not fitted
FID1, FID2, FID3: FID; Fiducial_1mm_Mask2mm
H1, H2, H3, H4: M3; MountingHole_3.2mm_M3
J9: BATT MODULE DC BUS; TerminalBlock_Phoenix_MKDS-1,5-3-5.08_1x03_P5.08mm_Horizont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; not fitted
TP2: +15V; TestPoint_Pad_D1.5mm
TP3: +3V3; TestPoint_Pad_D1.5mm
TP4: GND; TestPoint_Pad_D1.5mm
TP5: PFC_DRV; TestPoint_Pad_D1.5mm
TP6: ISENSE_U; TestPoint_Pad_D1.5mm
TP7: UART_H_TX; TestPoint_Pad_D1.5mm
TP8: +3V3S; TestPoint_Pad_D1.5mm
TP9: GND_S; TestPoint_Pad_D1.5mm
TP10: PANEL_P; TestPoint_Pad_D1.5mm

Connections:
+3V3: TP3.1; also elsewhere on the board
+3V3S: TP8.1; also elsewhere on the board
+15V: TP2.1; also elsewhere on the board
GND: TP4.1; also elsewhere on the board
GND_S: TP9.1; also elsewhere on the board
ISENSE_U: TP6.1; also elsewhere on the board
PANEL_P: TP10.1; also elsewhere on the board
PFC_DRV: TP5.1; also elsewhere on the board
PGND: J9.3; also elsewhere on the board
UART_H_TX: TP7.1; also elsewhere on the board
VBUS: F4.1; also elsewhere on the board
VBUS_EXT: F4.2, J9.1

Board: 2 copper layers, 289 parts (0 on the bottom side), 172 nets, no tracks yet.
