faragamco-eng/Multiact/(commit log)

2026-11-05 BLDC 310V sensorless six-step: control core and closed-loop motor simulator
    Portable control core (firmware/core/sixstep.c): H_PWM-L_ON six-step with
    ON/OFF-center BEMF sampling, demag-aware ZC arming, ZC interpolation,
    current-dependent advance, current-controlled two-stage align and ramp
    with ZC re-synchronisation, speed PI, OV/UV/OC/OT/stall protection.
    Host simulator (firmware/sim/motor_sim.c) runs the unchanged core against
    a 0.25 us switching model of the IPM bridge and a trapezoidal BLDC.
    Claude-Session: https://claude.ai/code/session_01HJFy3sq8sJFP9hXcSUHQaM
    [app_config.h, motor_sim.c, sixstep.c, sixstep.h]
2026-11-05 Firmware: STM32G431 register-level BSP, application, build system
    - bsp: TIM1 six-step with COM preload, ADC1/ADC2 injected triggers at
    ON/OFF center (OC6/TRGO2, CH4), OPAMP2 PGA x4, COMP2 + DAC3 cycle-by-cycle
    limit via OCREF_CLR, TIM1 break from IPM fault, TIM2 1 MHz commutation
    timer, USART1 CLI, IWDG
    - app: ISR glue, inrush relay pre-charge, button/pot, telemetry
    - Makefile: target build, 'make test' (5 simulator scenarios),
    'make sweep' (start-up robustness), 'make plots'
    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
2026-11-05 Hardware design package and documentation (Persian)
    - hardware/netlist.md: sheet-by-sheet text schematic (MCU pins from ST
    open pin data), hardware/bom.csv, hardware/calc/bldc_calc.py + results
    - docs: hardware design, firmware design with simulation results and
    tuning guide, staged bring-up and safety checklist; simulation plots
    - README with quick start and honest status/limitations
    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
    [bom.csv]
2026-11-06 Cooler application: v2 architecture, panel-bus Modbus protocol
    - docs/04: analysis of the cooler motors (nameplates, 36S/40P counted
    from the stator photo), pole-count recommendation, PFC + sensorless FOC
    rationale, auto-identification plan, alarm table, mains-fluctuation
    and locked-rotor protection, isolated 2-wire panel bus, Wi-Fi panel
    - docs/05 + firmware/comm: Modbus RTU slave and cooler register map
    with range checking and comm timeout; host tests (make test-comm)
    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
2026-11-06 Sensorless FOC core with automatic motor identification (cooler motors)
    - foc/foc.c: dq current control with decoupling and voltage-circle limit,
    SVPWM, active-flux nonlinear observer + PLL, I/f start with filtered
    handover, flying start (zero-current catch), speed loop with ramp,
    voltage-limit governor and regeneration limiting, locked-rotor /
    blocked-start / open-motor / OV / UV / OC protection, 3-shunt
    reconstruction with current prediction near full modulation
    - identification: alignment with active damping and settle detection,
    R and inverter dead-time from V(I), Ld/Lq by open-loop HF injection,
    flux by leaky integration then closed-loop refinement, inertia by a
    regenera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
    [foc.c, foc.h, foc_sim.c, plot_foc.py]
2026-11-06 Battery/solar backup: power management in FOC, outage tests, protocol v2
    - foc: explicit input-power limit and autonomous DC-bus droop (below
    340 V) so a power-limited battery module can never collapse the bus
    - foc_sim: mains outage/return with a 48 V battery module regulating the
    bus at 370 V (priority by set-points, no messages); tests: outage at
    full speed with and without app reaction, start on battery only;
    shows the module must take over within 5 ms
    - comm: Modbus protocol v2 battery registers, E10/E11, runtime estimate
    - docs/07: battery module architecture (bidirectional DAB, LiFePO4 16S,
    MPPT solar input, DC pump), runtime tables, converter sizing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
2026-11-06 Hardware v2 schematic: PFC, 3-shunt FOC inverter, 440 VAC-proof aux supply, relays, isolated panel bus
    - hardware/v2/schematic.py: 241 parts / 184 nets across 8 sheets (AC input
    with relay disconnect and PTC pre-charge, NCP1653 CCM PFC, VIPer26 flyback
    behind a 1500 V pre-regulator, STGIPS20K60 with three shunts, STM32G431,
    pump/drain 220 VAC relays, ISO7721 + STM32C011 panel bus PHY and RS-485,
    battery-module DC bus connector)
    - check_and_build.py validates every symbol/pin name, footprint pad and MCU
    alternate function against the official KiCad libraries and ST pin data
    (0 errors; mutation-tested), and generates netlist.md, bom.csv and a
    KiCad-importable netlist
    - calc_v2.py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
    [bom.csv]
2026-11-06 Hardware v2: KiCad 7 project (schematic + placed board) for 220 VAC, Altium import path
    - schematic.py: reinforced ISO7762DW (wide body) instead of narrow ISO7721D,
    SP3485 half-duplex RS-485, battery-module parts marked OPTION/DNP,
    mounting holes, fiducials, test points; project-local library (custom
    flyback symbol, GDT and CM-choke footprints)
    - gen_kicad.py: hierarchical schematic (8 sheets) built from the official
    KiCad 7.0.11 symbols with exact pin geometry; 250x160 mm board with
    zone placement, L-shaped creepage slot under T1/U7, heatsink row,
    HV net class (53 nets) and package-specific DRC rules
    - verified with KiCad itself: schematic re-exported netlist = source
    (0 diffe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
    [bldc_cooler_v2.kicad_pcb, bldc_cooler_v2.kicad_sch, bom.csv, s1_1_ac_input__protection__relays.kicad_sch, s2_2_rectifier_and_pfc__ccm__ncp1.kicad_sch, s3_3_auxiliary_supply__viper26_fl.kicad_sch, s4_4_inverter__stgips20k60_ipm.kicad_sch, s5_5_mcu_stm32g431cbt6__hot_side.kicad_sch]
2026-11-06 Hardware v2: discrete repairable inverter (3x IRS2186 + 6x TO-247) and 3-series 1200uF/200V bus
    - Replace the STGIPS20K60 IPM with socketed IRS2186 drivers and six
    STW24N60DM2 MOSFETs on the heatsink row (bootstrap UF4007, 10R gates,
    10k G-S, per-leg film caps); inputs now active high with pull-downs
    - Heatsink NC thermal switch to TIM1_BKIN; short-circuit via OPAMP/COMP
    - DC bus: 3 x Nichicon 1200uF/200V in series with 68k 1W balancing and
    mid-point sense on PA5 (imbalance alarm)
    - calc_v2: inverter loss comparison (IRF840 vs STW24N60DM2 vs IGBT)
    - Board 250x180 mm; all checks green (0 errors, 0 netlist diffs, DRC 0)
    Claude-Sess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
    [bldc_cooler_v2.kicad_pcb, bldc_cooler_v2.kicad_sch, bom.csv, s2_2_rectifier_and_pfc__ccm__ncp1.kicad_sch, s3_4_inverter__discrete__3_x_irs2.kicad_sch, s4_4_inverter__discrete__3_x_irs2.kicad_sch, s4_5_mcu_stm32g431cbt6__hot_side.kicad_sch, s5_5_mcu_stm32g431cbt6__hot_side.kicad_sch]
2026-11-06 Drive firmware v2 (step 1): application layer, BSP, bootloader, Modbus update
    - app/drive.c: power-up sequence (precharge K2+PTC -> K1, PFC only on demand),
    440 VAC over-voltage relay release (3 ms in test), outage handling with
    state save and automatic restart, alarms E1-E11 with retry schedules
    (E3 3x10 s, E4 10/30/60 s) and latching, series-capacitor imbalance trip,
    input-current / low-mains / temperature derating, motor I2t model,
    identification + motor library match, counters and 16-entry event log
    - app/mains.c: per-cycle rms/frequency, fast peak OV, outage detection
    - app/params.c: two-page wear-levelled flash records, power-fail safe
    - app/fwu.c + boot/: firmware update ove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
    [bldc_cooler_v2.kicad_pcb, bom.csv, s1_1_ac_input__protection__relays.kicad_sch]
2026-11-06 PHY bridge firmware (STM32C011) for the 2-wire panel bus
    - phy/phy_core.c: software UART at 8x oversampling on the return-current
    modulation with adaptive idle-current baseline and re-acquire after
    current steps, voltage-modulation transmitter, RX blanking during TX,
    CRC-checked frame bridge to the hot-side MCU, local diagnostics (addr 247)
    - phy/phy_main.c: TIM14 19.2 kHz sampling, ADC, USART1 with receiver
    timeout, LED status, IWDG; 6.4 KB
    - test/test_phy.c: panel <-> PHY <-> real Modbus slave with noise,
    +-2.5 % clock error, idle-current swings and steps: all transactions ok
    - CMSIS STM32C0 headers added to fetch_cmsis.sh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
    [phy_core.c, phy_core.h, phy_main.c, test_phy.c]
2026-11-06 Panel firmware core, phone/cloud protocol, docs for firmware v2
    - firmware/panel/core: Modbus master, cooler sequencer (pre-wet, pad
    dry-out, fan-only, pump-only), off timer, weekly schedule, alarm events,
    UI view model for 7-segment+keys or touch, JSON API (BLE / local
    WebSocket / MQTT), warranty report, drive firmware streaming over the bus
    - test_panel: 37 checks against the real drive-side Modbus slave, register
    map, update receiver and bootloader decision (30 KB update in 2.7 min)
    - firmware/panel/esp32: ESP-IDF 5.x integration skeleton (provisioning,
    mDNS, WebSocket, MQTT/TLS, panel OTA with rollback, Ed25519-checked drive
    OTA, warranty upload) - not compiled here, no ESP-I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
    [partitions.csv]
2026-11-06 New bus capacitors (2x 470uF/450V) and control panel hardware (basic version)
    Drive v2:
    - DC bus: 2 x 470 uF / 450 V 105 C snap-in in parallel replaces the
    3-series 1200 uF/200 V stack (no balancing resistors, no mid-point
    sense); bleeder 3x100k; PTC energy requirement updated (65 J)
    - firmware: series-capacitor balance check now optional (cap_tol = 0),
    PA5 no longer sampled
    - generators made design-independent: hardware/v2/layout.py holds the
    board-specific settings; check_and_build.py / gen_kicad.py take --design
    Panel (hardware/panel):
    - ESP32-S3-WROOM-1, 4-digit 7-segment display + 6 LEDs (5-phase
    multiplex), 5 keys, buzzer, USB-C for programming, SHT40 option (DNP)
    - bus inte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
    [bldc_cooler_v2.kicad_pcb, bom.csv, cooler_panel.kicad_pcb, cooler_panel.kicad_sch, s1_1_ac_input__protection__relays.kicad_sch, s1_1_bus_interface_and_power.kicad_sch, s2_2_esp32_s3_module_and_usb.kicad_sch, s2_2_rectifier_and_pfc__ccm__ncp1.kicad_sch]
2026-11-06 Panel: connectivity-driven placement and a two-layer router tool (work in progress)
    - gen_kicad.py: optional anchor placer (parts go next to the pads they
    connect to, 1 mm routing gaps, 2-pin parts try both orientations);
    fix: pad angles parsed as symbols were duplicated on rotation
    - tools/autoroute.py: grid A* router on F.Cu/B.Cu with exact clearance
    fields from KiCad pad polygons, vias, hole-to-hole and keep-out rules,
    net-class widths with narrower fallback, GND pours
    - panel board 120 x 86 mm, power net class 0.5 mm; all checks green
    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
    [cooler_panel.kicad_pcb]
2026-11-06 Panel: ESP32-S3 pin map by direction (display right, keys below, bus left) to untangle routing
    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
    [bom.csv, cooler_panel.kicad_pcb, s2_2_esp32_s3_module_and_usb.kicad_sch]
2026-11-06 Panel build: route automatically; fix spoke-count DRC rule syntax
    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
    [layout.py]
2026-11-06 autoroute: restore the generated project file after SaveBoard (keeps net classes and board rules)
    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
2026-11-06 gen_kicad: footprint zones (antenna keep-out) placed in board coordinates
    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
2026-11-06 Panel: sensor decoupling cap beside its VDD/GND pins; build shows router failures
    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
    [layout.py]
2026-11-06 Panel PCB routed: 2 layers, 0 DRC errors, 0 unconnected, antenna area copper-free
    - 958 track segments (2.6 m), 193 vias, power 0.5 mm / signals 0.25 mm,
    GND pours on both layers, ESP32 antenna keep-out respected
    - fabrication outputs: Gerbers + Excellon drill (zip), pick-and-place,
    routed top/bottom PDFs; build.sh regenerates, routes and verifies
    - README: routing summary, images of both copper layers
    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
    [cooler_panel-B_Cu.gbl, cooler_panel-B_Mask.gbs, cooler_panel-B_Paste.gbp, cooler_panel-B_Silkscreen.gbo, cooler_panel-Edge_Cuts.gm1, cooler_panel-F_Cu.gtl, cooler_panel-F_Mask.gts, cooler_panel-F_Paste.gtp]
